brdmaker/stmbl/docs/README.md

# stmbl docs

The user manual (AsciiDoc) is in `src/`: getting started, wiring and
pinout, supply, motor and feedback setup, tuning, commands, servoterm.
`linuxcnc/` holds the LinuxCNC side: the example configuration (`config/`),
`sserialterm` and `stmblcan` ([linuxcnc/README.md](../linuxcnc/README.md)).

Smart-serial features (branches `sserial_console`, `sserial_bootloader`):

| doc | what |
|---|---|
| [sserial_console.md](sserial_console.md) | the drive's console over smart-serial: setup with `sserialterm`, the frame and link protocol, limits, troubleshooting |
| [capture_scope.md](capture_scope.md) | `scope0`: capture in the drive, download over any console; pins, triggers, modes, dump format |
| [sserial_bootloader.md](sserial_bootloader.md) | firmware updates: in-band over the console (`fwup`, `servoterm-cli --update`) and recovery with `setsserial flash`; flash layout, the single-bank stall |

Setup (branch `setup-wizard`):

| doc | what |
|---|---|
| [setup_wizard.md](setup_wizard.md) | `servoterm-cli --wizard`: sets up a drive and its motor step by step from the nameplate, measures the rest, wiring help, version check; the library for a GUI; tested on 35 simulated motors; FANUC serial absolute (multi-turn) included |

brdstepper (branch `brdstepper`):

| doc | what |
|---|---|
| brdstepper_hw.md | moved to `brdmaker/brdmot` (`docs/`), with the board designs (`hardware/`); the firmware target stays here (`brdstepper/`) |

CAN (branch `can-support`):

| doc | what |
|---|---|
| [can_support.md](can_support.md) | what CAN support would mean for stmbl and brdstepper: hardware, bus timing (`tools/canbus_budget.py`), LinuxCNC's side, protocol options, work plan |

Absolute encoders:

| doc | what |
|---|---|
| [absolute_encoders.md](absolute_encoders.md) | the position from boot with a multi-turn absolute encoder: `mturn` loads the encoder's turn count into `linrev`, checks it; states, config, LinuxCNC settings, tests; the GUI plan |

Supply:

| doc | what |
|---|---|
| [psu.md](psu.md) | moved to `brdmaker/brdmot` (`psu/`): the pack power supply for single-phase 230 V |

FANUC motors on hand:

| doc | what |
|---|---|
| [fanuci.md](fanuci.md) | `fanuci`: experimental probe for FANUC 1-pair (αi / βi) serial pulsecoders on FB0, how to find the protocol on the bench and turn it into a driver |
| [fanuc_tw.md](fanuc_tw.md) | `fanuc_tw`: the feedback driver for FANUC 2-wire pulsecoders (βiA128): wiring, the frame, pins, debugging the unknown bits |
| [yaskawa_abs.md](yaskawa_abs.md) | `yaskawa_abs`: the feedback driver for Yaskawa Σ-II serial absolute encoders (SGMAH-xxA1): wiring, the frame, pins, bench numbers |
| [fanuc/](fanuc/README.md) | moved to the private repository `brdmaker/brdmot`: the FANUC motors on hand, their encoders, the `encf` bench test, FANUC manuals as text |

Tools: `servoterm-cli/README.md`, `linuxcnc/sserialterm/README.md`.
Simulator and tests: `host/README.md` (`make -C host check`).
Findings and open issues: `DEBUGNOTES.md`.

Moved to the private repository `brdmaker/brdmot` (with their history):
the web GUI (`webui/`, millweb), the hardware designs (`hardware/`: stman,
vibsensor, brdstepper, teststand, kigen), the application LinuxCNC parts
(`linuxcnc/` arm6hmi, armcollide, armgrip, armguard, armkins, armtool, vis3d,
lathe, dynwiz, powerquota, pcomp), their simulated machine configs
(`hwtest/arcmate-sim`, `hwtest/portal-sim`) and docs (ctxtwin, hmi, hsm400u,
stman.md, vibsensor.md, brdstepper_hw.md). brdmot uses this repository as a
submodule (`stmbl/`). What stays here: the drive (firmware, its components,
the host simulator, servoterm-cli and the setup wizard, the LinuxCNC drive
link: stmblcan, sserialterm, stmbl_sim).
