brdmaker/stmbl/docs/fanuc/README.md

# FANUC motors (moved)

The notes on the FANUC servo motors on hand (βiS 12/2000, βiS 4/4000,
α2/3000), their αA64 / βiA128 encoders, the bench test plan for `encf`, and
the FANUC manuals transcribed to text are in the private repository
`brdmaker/brdmot`.
