brdmaker/stmbl/docs/psu.md

# stmbl pack power supply

Moved to the private repository `brdmaker/brdmot`, under `psu/`: the design
state (decided vs open), the power-path and relay-chain diagrams, and the
pwmdc SPICE runs.
