brdmaker/stmbl/hardware/stman/doc/stman-placement-bottom.png

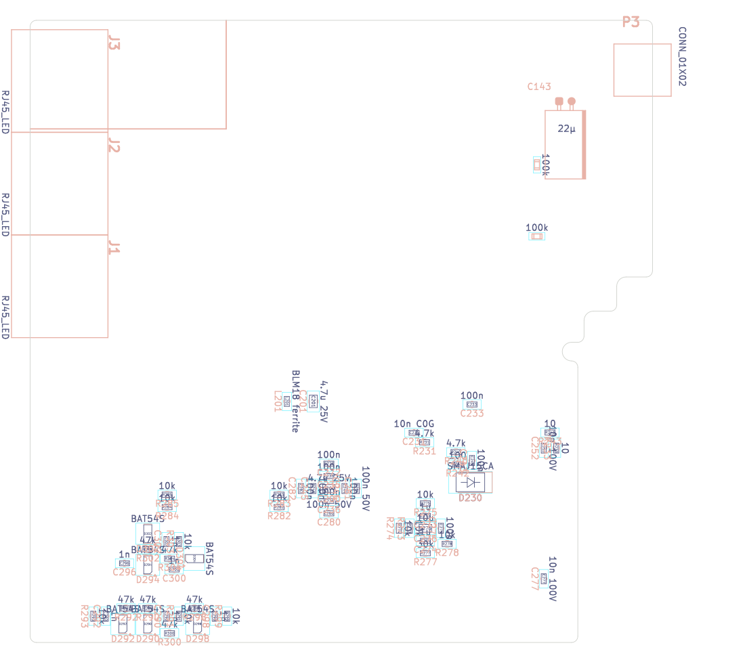
hardware/stman/doc/stman-placement-bottom.png
