brdmaker/stmbl/hardware/vibsensor/enclosure/render/bottom.png

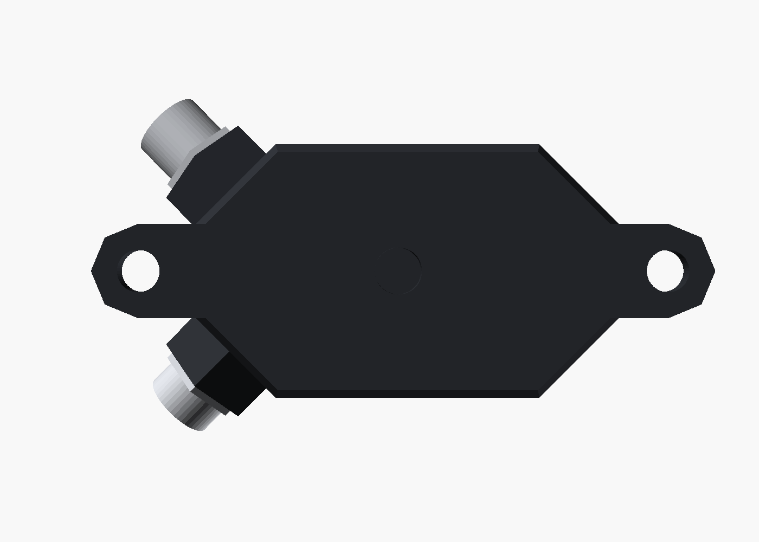
hardware/vibsensor/enclosure/render/bottom.png
