brdmaker/stmbl/hardware/vibsensor/enclosure/render/front.png

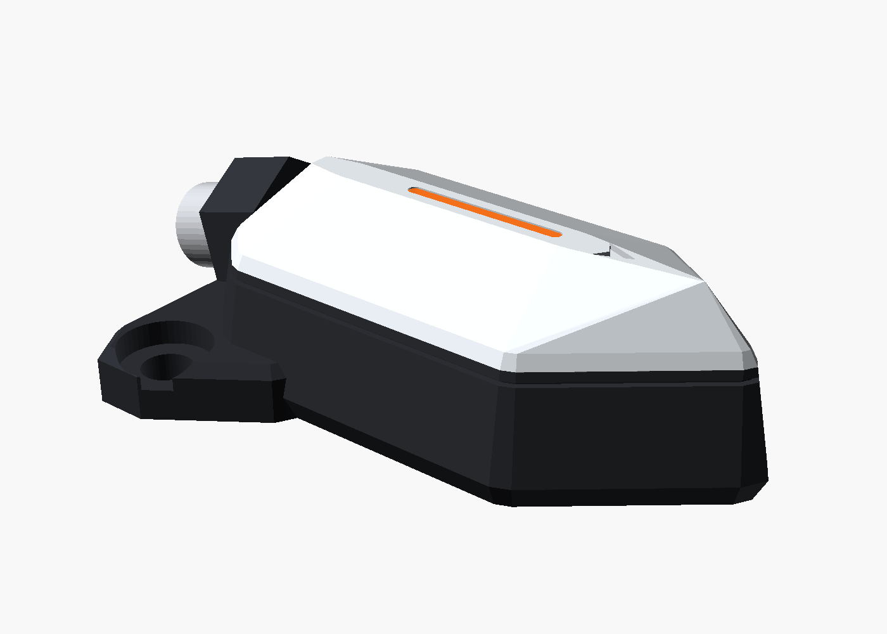
hardware/vibsensor/enclosure/render/front.png
