brdmaker/stmbl/hardware/vibsensor/enclosure/render/rear.png

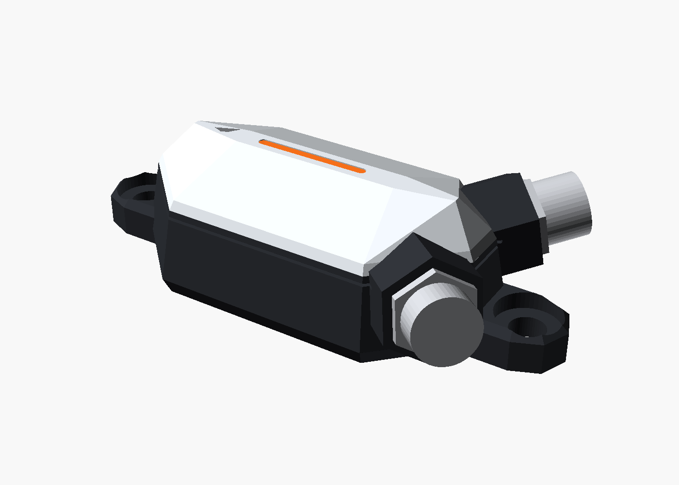
hardware/vibsensor/enclosure/render/rear.png
