brdmaker/stmbl/hardware/vibsensor/enclosure/render/terminated.png

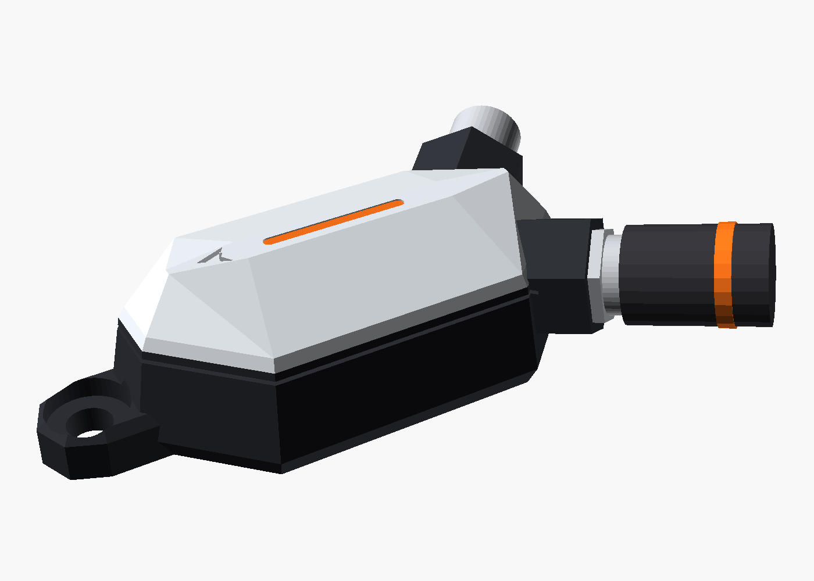
hardware/vibsensor/enclosure/render/terminated.png
