brdmaker/stmbl/hardware/vibsensor/enclosure/render/top.png

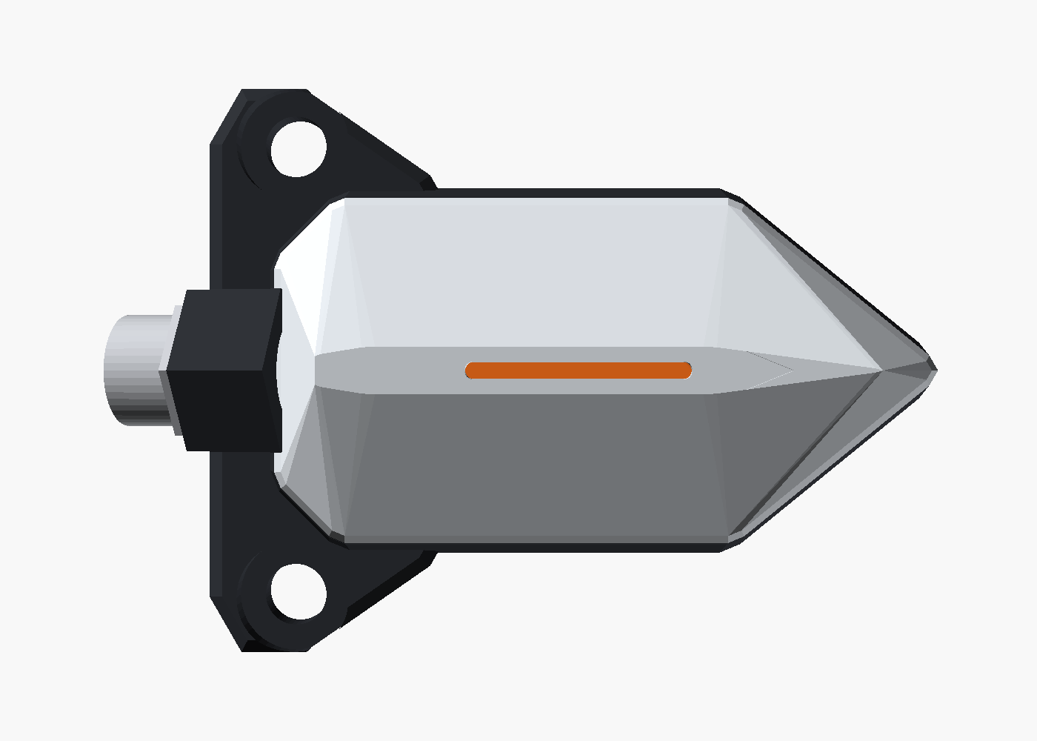
hardware/vibsensor/enclosure/render/top.png
