brdmaker/stmbl/linuxcnc/vis3d/shots/arm6_changer.png

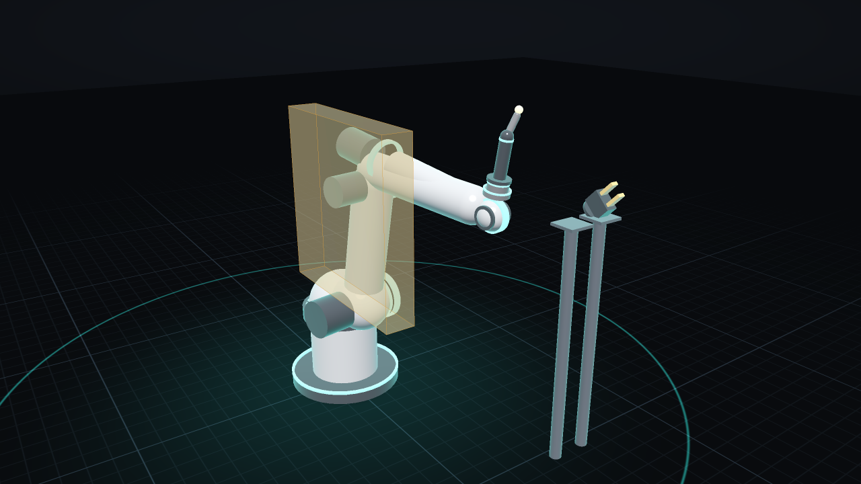
linuxcnc/vis3d/shots/arm6_changer.png
