brdmaker/stmbl/hardware/teststand/stl/pinion.stl

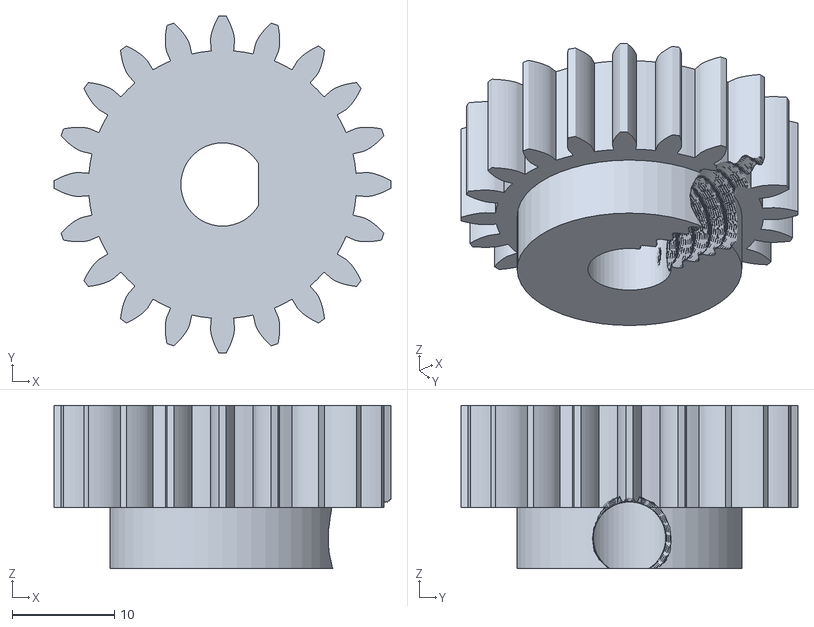
[picture p21: CAD file, 2026-11-06]
hardware/teststand/stl/pinion.stl
33.0 x 33.0 x 16.0
