brdmaker/stmbl/hardware/vibsensor/enclosure/stl/shard-cover.stl

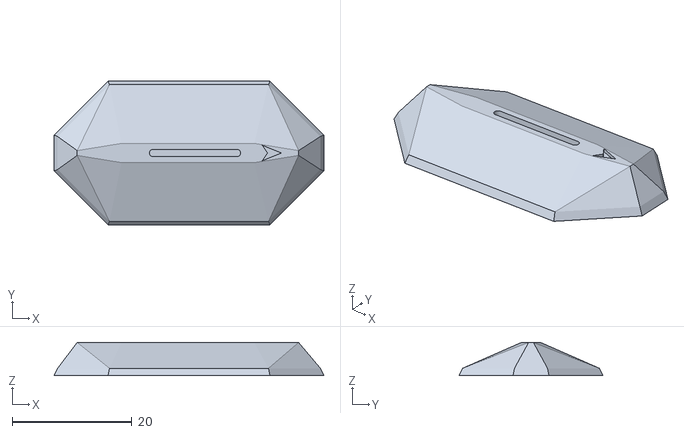
[picture p22: CAD file, 2026-10-26]
hardware/vibsensor/enclosure/stl/shard-cover.stl
45.0 x 24.0 x 5.51
