brdmaker/stmbl/hardware/teststand/stl/gib_z.stl

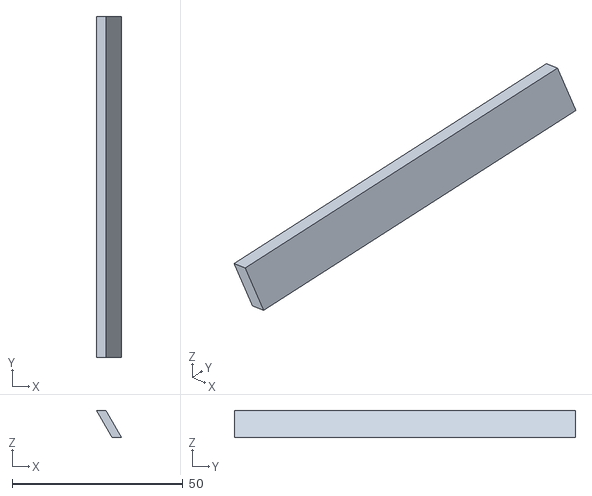
[picture p23: CAD file, 2026-11-06]
hardware/teststand/stl/gib_z.stl
7.42 x 100.0 x 8.00
