brdmaker/stmbl/hardware/vibsensor/enclosure/stl/shard-base.stl

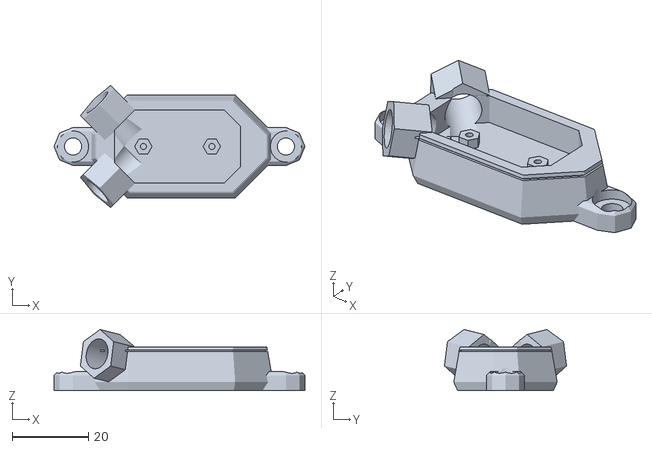
[picture p24: CAD file, 2026-10-26]
hardware/vibsensor/enclosure/stl/shard-base.stl
66.0 x 32.1 x 16.0
