brdmaker/stmbl/hardware/teststand/stl/paper_clip.stl

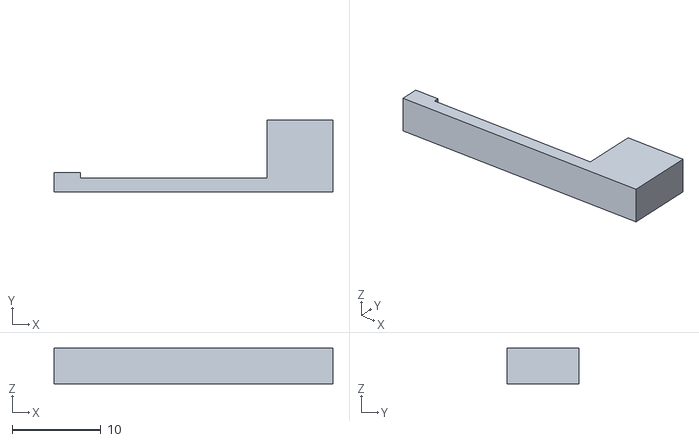
[picture p25: CAD file, 2026-11-06]
hardware/teststand/stl/paper_clip.stl
31.4 x 8.10 x 4.00
