brdmaker/stmbl/hardware/teststand/stl/z_slide.stl

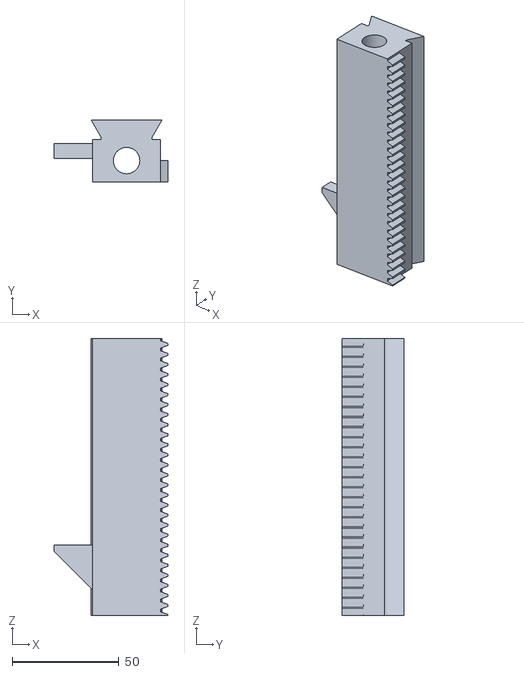
[picture p26: CAD file, 2026-11-06]
hardware/teststand/stl/z_slide.stl
53.4 x 29.0 x 130.0
