brdmaker/stmbl/hardware/teststand/stl/gib_y.stl

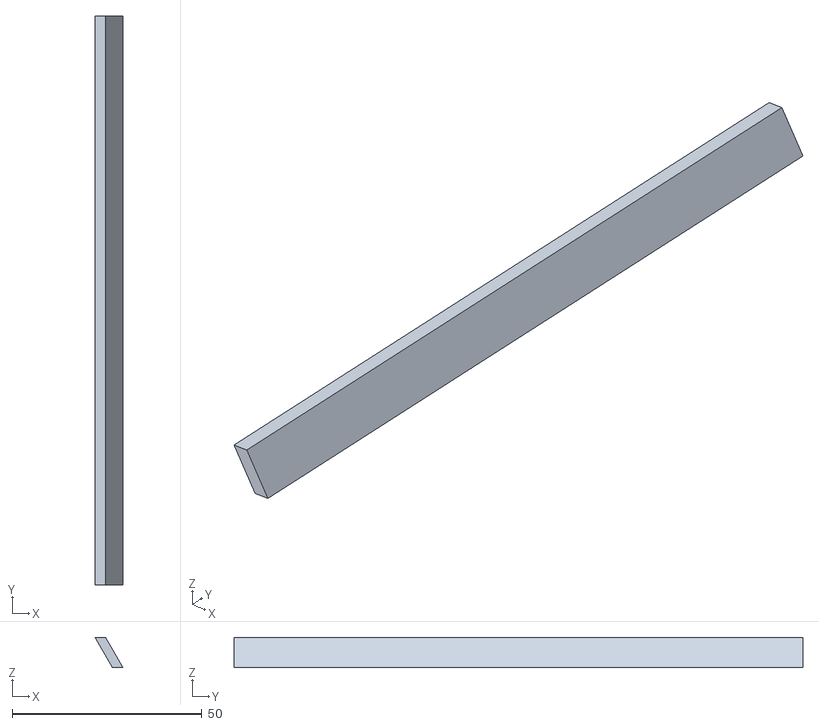
[picture p27: CAD file, 2026-11-06]
hardware/teststand/stl/gib_y.stl
7.42 x 150.0 x 8.00
