brdmaker/stmbl/hardware/teststand/stl/beam.stl

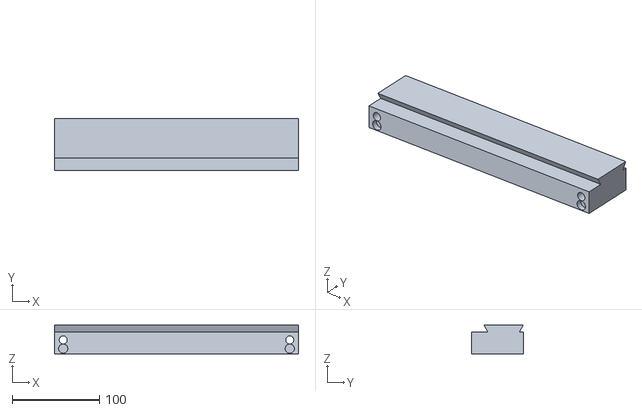
[picture p28: CAD file, 2026-11-06]
hardware/teststand/stl/beam.stl
280.0 x 60.0 x 33.0
