brdmaker/stmbl/hardware/teststand/stl/z_motor_bracket.stl

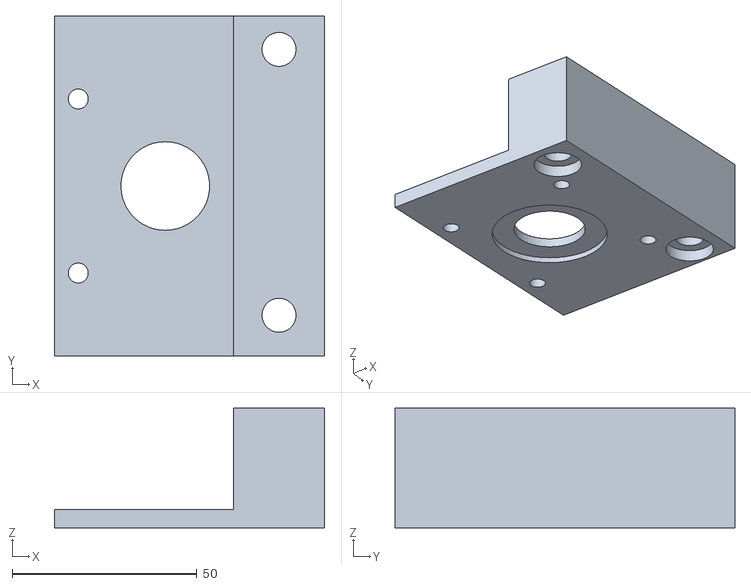
[picture p29: CAD file, 2026-11-06]
hardware/teststand/stl/z_motor_bracket.stl
73.1 x 92.0 x 32.5
