brdmaker/stmbl/hardware/teststand/stl/table.stl

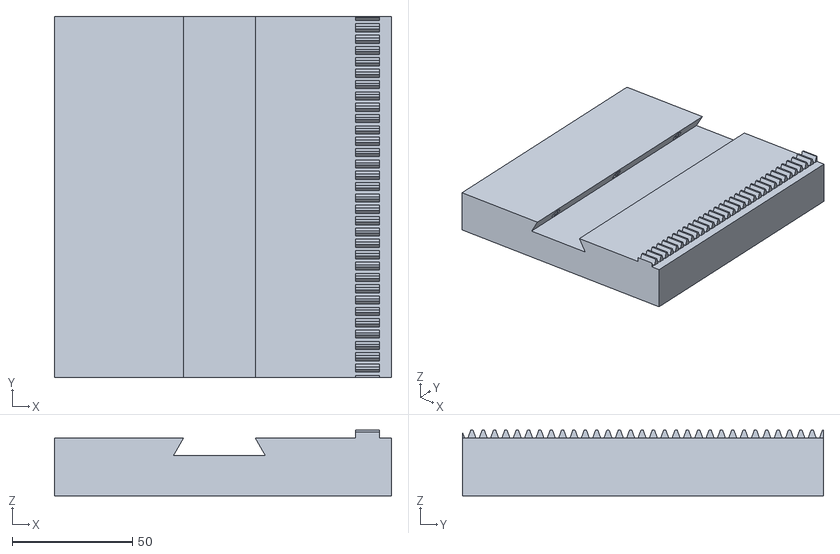
[picture p30: CAD file, 2026-11-06]
hardware/teststand/stl/table.stl
140.0 x 150.0 x 27.4
