brdmaker/stmbl/hardware/teststand/stl/switch_holder.stl

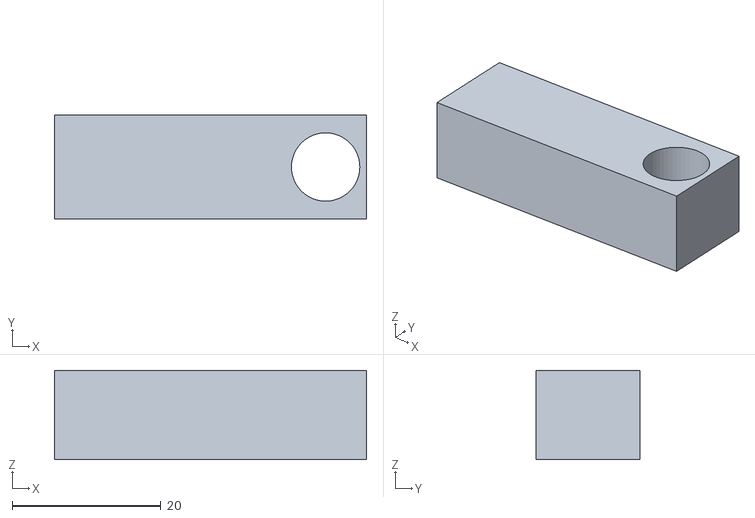
[picture p31: CAD file, 2026-11-06]
hardware/teststand/stl/switch_holder.stl
42.0 x 14.0 x 12.0
