brdmaker/stmbl/hardware/teststand/stl/snap_pin.stl

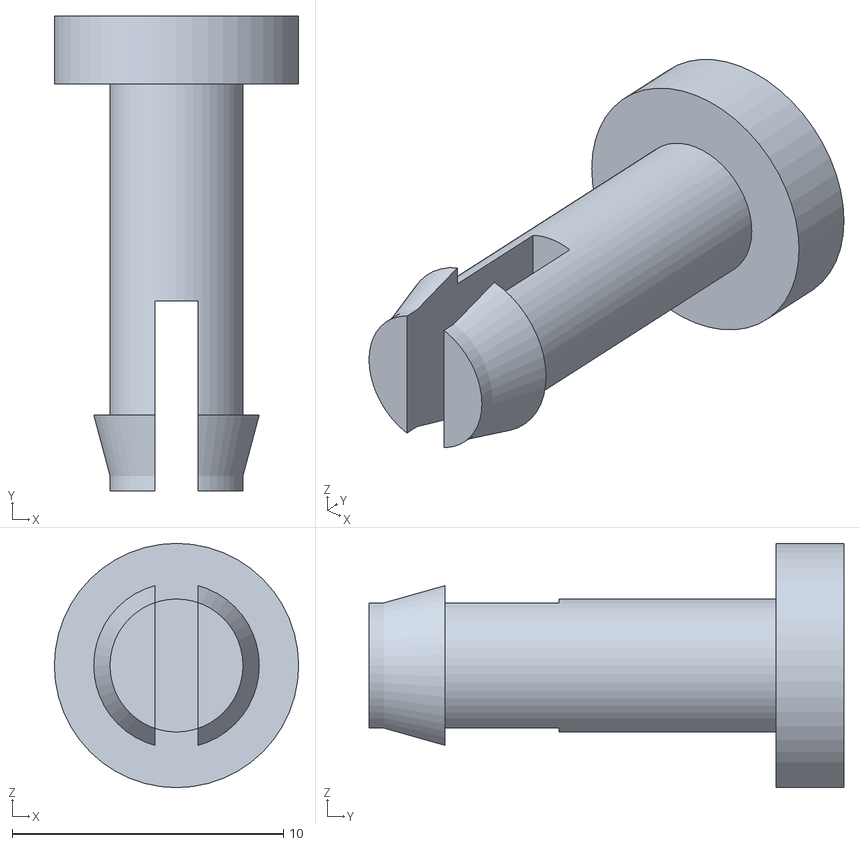
[picture p32: CAD file, 2026-11-06]
hardware/teststand/stl/snap_pin.stl
9.00 x 17.5 x 9.00
