brdmaker/stmbl/hardware/teststand/stl/x_motor_bracket.stl

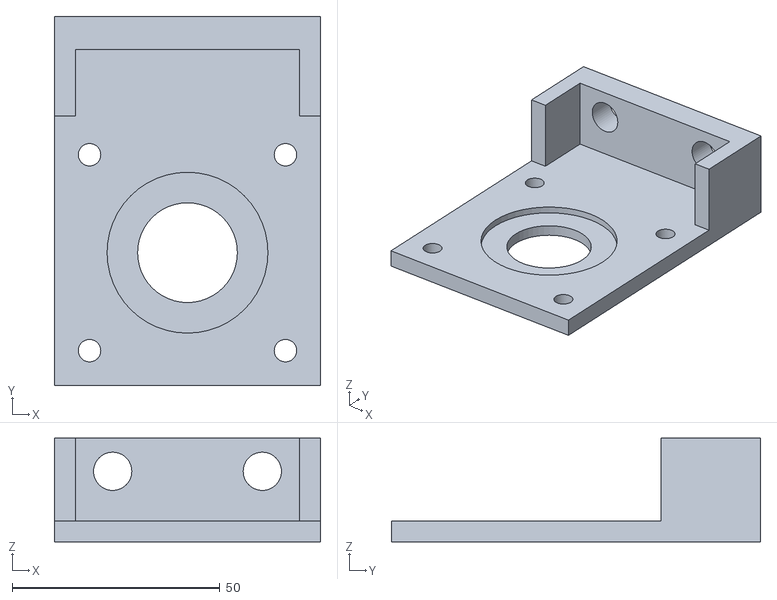
[picture p33: CAD file, 2026-11-06]
hardware/teststand/stl/x_motor_bracket.stl
64.0 x 88.9 x 25.0
