brdmaker/stmbl/hardware/teststand/stl/gib_x.stl

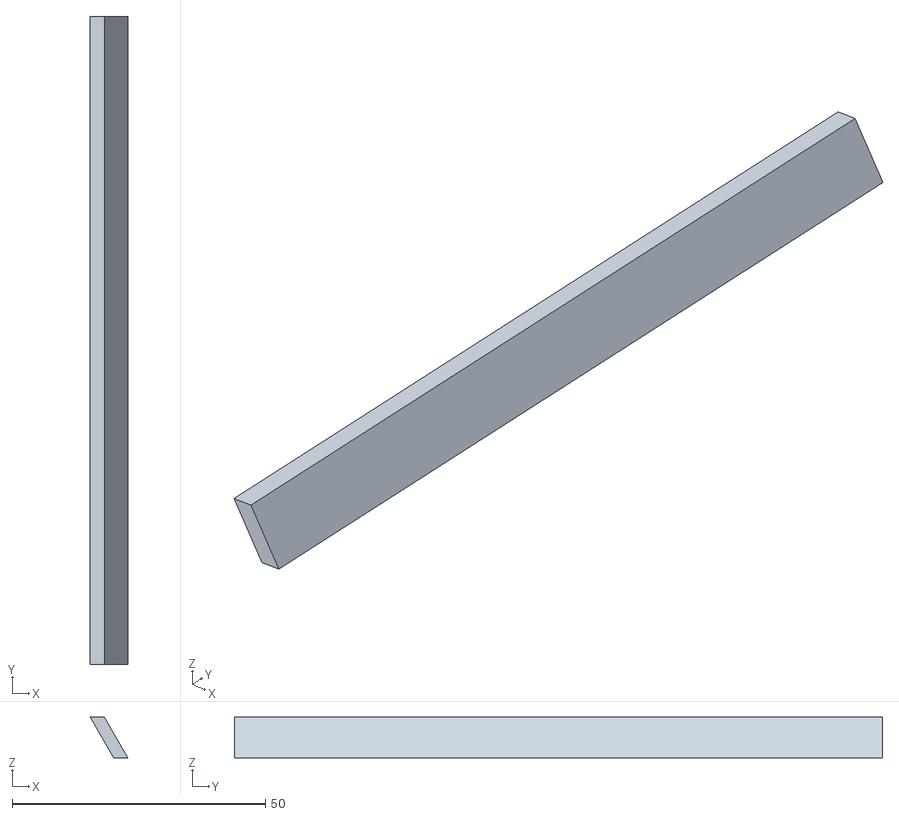
[picture p34: CAD file, 2026-11-06]
hardware/teststand/stl/gib_x.stl
7.42 x 128.0 x 8.00
