brdmaker/stmbl/hardware/teststand/stl/x_carriage.stl

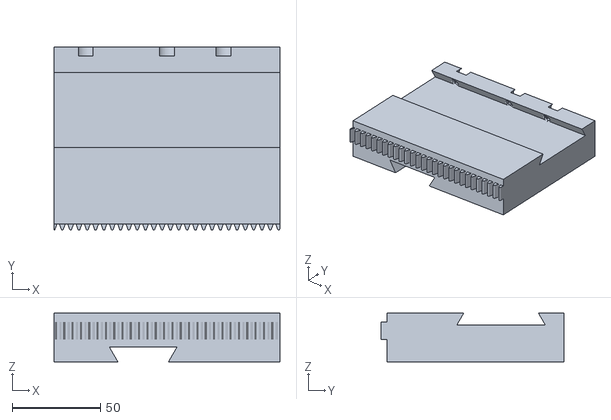
[picture p35: CAD file, 2026-11-06]
hardware/teststand/stl/x_carriage.stl
128.0 x 103.4 x 27.5
