brdmaker/stmbl/hardware/teststand/stl/base.stl

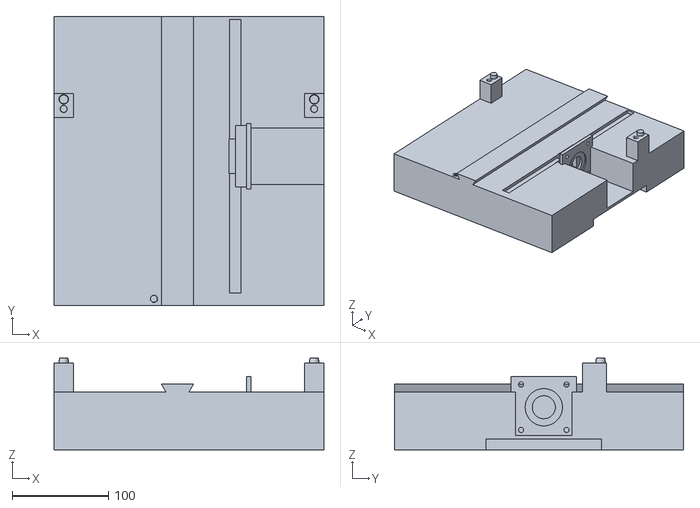
[picture p36: CAD file, 2026-11-06]
hardware/teststand/stl/base.stl
280.0 x 300.0 x 95.0
