brdmaker/stmbl/hardware/teststand/stl/set_screw.stl

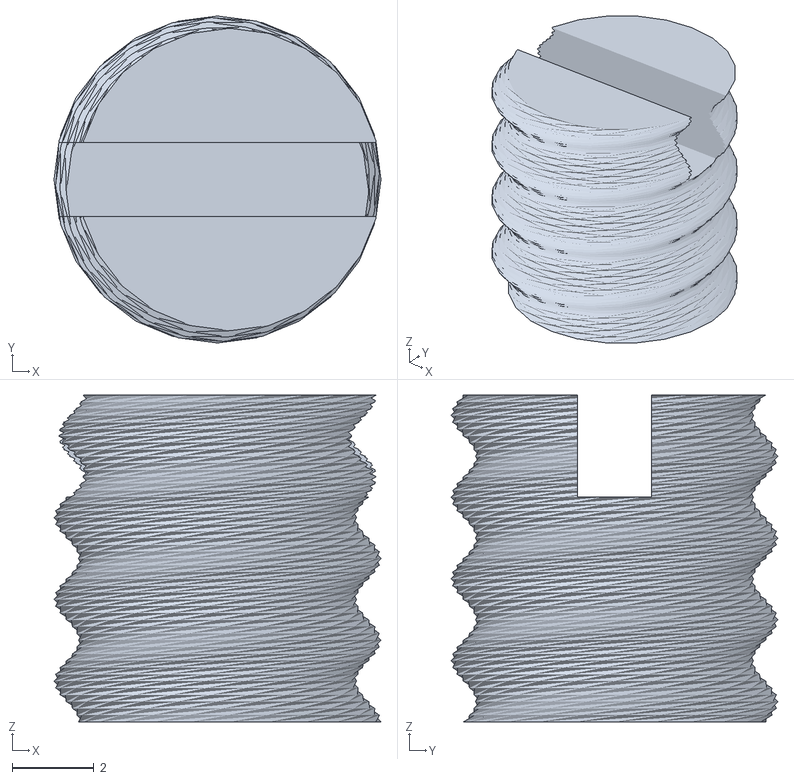
[picture p37: CAD file, 2026-11-06]
hardware/teststand/stl/set_screw.stl
8.00 x 8.00 x 8.00
