brdmaker/stmbl/hardware/teststand/stl/thumb_screw.stl

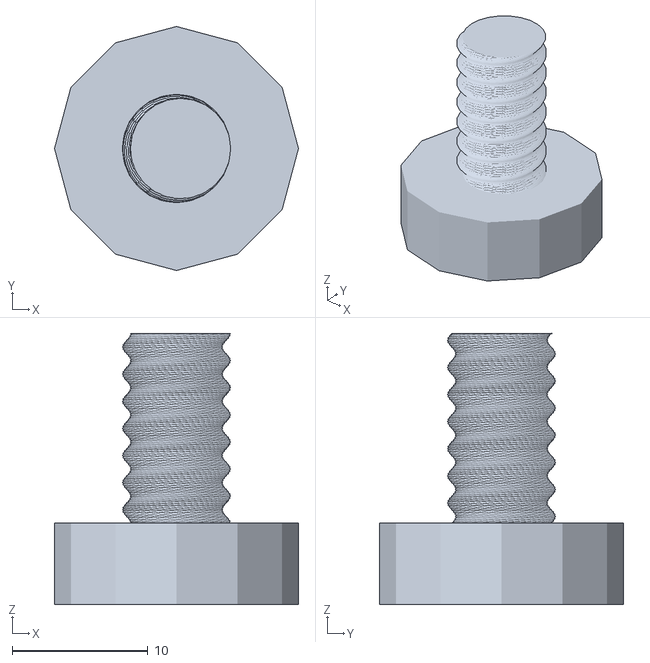
[picture p38: CAD file, 2026-11-06]
hardware/teststand/stl/thumb_screw.stl
18.0 x 18.0 x 20.0
