brdmaker/stmbl/(list of files, cad)

Other CAD files:
hardware/teststand/stl/bolt_25.stl
hardware/teststand/stl/bolt_45.stl
hardware/teststand/stl/gib_screw_14.stl
hardware/teststand/stl/gib_screw_25.stl
hardware/teststand/stl/gib_screw_50.stl
