brdmaker/stmbl/docs/ctxtwin/operating/05_operation.md

# Gildemeister CTX twin operating manual, 5. Operating the machine and the control (Bedienung von Maschine und Steuerung), pages 5-1 to 5-40

Source: `20a2fd3d-5_Bedienung_von_Maschine_und_Steuerung.pdf`, 40 pages (scanned), manual pages 5-1 to 5-40. "Betriebsanleitung CTX twin, Dok.-Nr.: daaab1d1, Februar 1995" (operating manual CTX twin, doc. no. daaab1d1, February 1995). Page 5-9 additionally carries the revision note "REV: dab9501 (05.05.1995) zu daaab1d1 Februar 1995".
Original language: German.

Running page header on every page: "5. Bedienung von Maschine und Steuerung". Footer: "Betriebsanleitung CTX twin", "Dok.-Nr.: daaab1d1 Februar 1995", "Seite 5-xx".

---

## Contents (page 5-1)

| Section | German title | English | Page |
|---|---|---|---|
| 5.1 | Allgemeine Hinweise | General notes | 5-4 |
| 5.1.1 | Aggregategruppen | Unit groups | 5-4 |
| 5.1.2 | Betriebsartensplitting | Operating mode splitting | 5-4 |
| 5.2 | Bedienelemente und Tastatur | Operating elements and keyboard | 5-5 |
| 5.2.1 | Bedienelemente an der rechten Seite | Operating elements on the right-hand side | 5-5 |
| 5.2.2 | Bedienfeld | Control panel | 5-6 |
| 5.2.3 | Weitere Bedienelemente | Further operating elements | 5-20 |
| 5.3 | Menütechnik und Softkeytasten | Menu technique and softkeys | 5-21 |
| 5.3.1 | Bildschirm | Screen | 5-22 |
| 5.3.2 | Allgemeines | General | 5-22 |
| 5.3.3 | Fenster - Aufteilung des Bildschirms | Windows - division of the screen | 5-24 |
| 5.3.4 | Anzeigenbereich | Display area | 5-26 |
| 5.4 | Befehlseingaben | Command entries | 5-28 |
| 5.4.1 | Pull-down-Menüs | Pull-down menus | 5-28 |
| 5.4.2 | Dialogboxen | Dialog boxes | 5-29 |
| 5.5 | INFO-System | INFO system | 5-32 |
| 5.5.1 | Allgemeines | General | 5-32 |
| 5.5.2 | Funktionen und Tastaturbelegung im INFO-System | Functions and key assignment in the INFO system | 5-33 |
| 5.5.3 | Fehler - INFO-System | Errors - INFO system | 5-33 |
| 5.6 | Grafische Bediener-Unterstützung | Graphical operator support | 5-34 |
| 5.7 | Ein- und Ausschalten der Maschine | Switching the machine on and off | 5-35 |
| 5.7.1 | Maschine einschalten | Switching the machine on | 5-35 |
| 5.7.2 | Referenzpunkt anfahren | Approaching the reference point | 5-36 |
| 5.7.3 | Fehleranzeigen und Meldungen quittieren | Acknowledging error displays and messages | 5-37 |
| 5.7.4 | Arbeitsraum-Positionsschalter freifahren | Moving off the work-area position switches | 5-38 |
| 5.7.5 | Maschine ausschalten | Switching the machine off | 5-39 |
| 5.7.6 | Not-Aus-Abschaltung | Emergency-stop shutdown | 5-39 |

Page 5-2: (blank page) (header and footer only).

## Introduction (page 5-3)

If you are not yet very familiar with the machine, this chapter is especially important for you.

The operation of the machine and the control is explained here. This includes:

- work that must be carried out before switching on
- switching the machine on and off
- acknowledging errors and messages (How do I delete the error message from the screen?)
- the control panel and the keyboard (Which key do I find where?)
- the menu technique (How can I select programs and commands?)
- the softkeys (The number keys have different meanings depending on the choices on the screen.)
- the graphical operator support (How can I look at the contour I have entered?)

## 5.1 General notes (Allgemeine Hinweise) (page 5-4)

### 5.1.1 Unit groups (Aggregategruppen)

In accordance with the machine concept, the control contains 2 unit groups (`Aggregategruppen`), called **AG** below.

- each AG is autonomous on the operating and programming interface
- an AG can contain several spindles and also several slides
- each AG handles its own work area
- in one AG only one operating mode exists at a time
- different operating modes can exist at the same time in the two AGs, i.e. operating mode splitting (`Betriebsarten-Splitting`)
- when operating mode splitting is used fully, separation of the work areas by a partition wall (`Trennwand`) is required for safety reasons.

### 5.1.2 Operating mode splitting (Betriebsartensplitting)

Operating mode splitting can be switched on and off by a parameter switch:

- in the mode operating mode splitting ON (`EIN`) the effect of the keys cycle start / stop (`Zyklus-Start / -Stop`) and feed stop (`Vorschub-Stop`) depends on the position of the selector switch **AG**.
- in the mode operating mode splitting OFF (`AUS`) the keys cycle start / stop and feed stop act on both **AG** simultaneously.

## 5.2 Operating elements and keyboard (Bedienelemente und Tastatur) (page 5-5)

This section explains in short form where the individual operating elements on the machine are and what function they have (see figures on the following page).

### 5.2.1 Operating elements on the right-hand side (Bedienelemente an der rechten Seite)

Figure: right-hand end of the machine / electrical cabinet, with callouts 1-5: (5) sight glass at the top of the cabinet, (4) round gauge on the left part, (1) small counter, (2) round main switch and (3) motor protection switch on the cabinet door; ventilation grille and a sight glass lower left.

1. **`Betriebsstundenzähler`** (operating hours counter): shows how many hours in total the machine has been in operation (important for regular maintenance work).
2. **`Hauptschalter`** (main switch): switches the machine on and off.
3. **`Motor-Schutzschalter für Späneförderer`** (motor protection switch for the chip conveyor): this switch trips automatically when the chip conveyor is overloaded, e.g. by a chip jam. The cause of tripping must then be removed and the switch switched on again.
4. **`Manometer`** (pressure gauge): shows the system pressure of the hydraulic system.
5. **`Füllstand Kühlmittel`** (coolant level): this sight glass shows the fill level of the coolant tank for the spindle motors.

### 5.2.2 Control panel (Bedienfeld) (pages 5-6 to 5-19)

Figure (page 5-6, drawing no. 1008472.4 [uncertain]): Grundig control panel ("GRUNDIG" logo) in three parts: monitor housing with screen (1) and two key switches (2), (3) to its right; a middle key strip with emergency-stop button (10) at left, keys (4), (5), (6), (22), the protective-hood keys (9a)-(9d) and a single key (21) at the right; the lower keyboard with handwheel (8) (scale marked "- ←|→ +"), selector key switch (11), PLC key block (12), enabling key (7), cycle keys (13), jog direction keys (14), spindle block (15), keys (16), (17), (18), cursor block (19), number pad (20), and two mushroom pushbuttons (9e) on the left and right side faces of the keyboard.

Callouts: (1) monitor, (2) key switch bar machining, (3) key switch setup mode, (4) fault lamp, (5) machine (drives) on, (6) machine (drives) off, (7) enabling (`Zustimmen`), (8) handwheel, (9a)-(9d) protective hood keys, (9e) mushroom pushbuttons, (10) emergency stop, (11) selector switch AG, (12) PLC keys, (13) cycle stop/feed stop/cycle start, (14) jog direction keys, (15) spindle key block, (16) [not described separately in text; key group near (15)/(17), see (15a)/(15b)] [uncertain], (17) operating modes/error status/info, (18) Esc/>>/Del/Alt/Ins, (19) cursor keys, (20) number pad, (21) turret jog / option keys, (22) option keys [uncertain]. Note: the figure labels (22) twice in the middle strip.

**(1) `Monitor`** (page 5-7)

**(3) `Schlüsselschalter - Stangenbearbeitung`** (key switch - bar machining) [printed as "(3)"; per the figure this is probably key switch (2)] [uncertain]

| Symbol | Meaning |
|---|---|
| `O` | The machine works independently of the automatic bar guide / bar feed (`Stangenführung / Stangenvorschub`). |
| `I` | The machine works with the automatic bar guide / bar feed. |

**(3) `Schlüsselschalter - Einrichtebetrieb`** (key switch - setup mode)

Position **AG 1** or **AG 2** (symbol: filled dot on a base line): these switch positions are prerequisites for the functions in setup mode. Depending on operating mode splitting, they are effective for the selected unit **AG 1 or AG 2** respectively, and **only** with the protective hood (`Schutzhaube`) open.

The key operation must take place in the following sequence:

- operating mode `MASCHINE / HANDSTEUERN` (machine / manual control)
- open the protective hood
- key switch to position "`Einrichtebetrieb`" (setup mode)

Position (symbol: spiral/automatic symbol): this position is a prerequisite for:

- `MASCHINE / AUTOMATIK` (machine / automatic)
- and `MASCHINE / HANDSTEUERN` with the protective hood closed

**(4) `Störlampe`** (fault lamp): this red fault lamp signals:

- steady light for an error (`Fehler`)
- flashing light for a warning (`Warnung`)

**(5) `Maschine (Antriebe) Ein`** (machine (drives) on) (page 5-8): with this illuminated key you switch the drives on. The lamp in the key signals that the machine is switched on. Symbol: motor with `I`.

**(6) `Maschine (Antriebe) Aus`** (machine (drives) off): with this key you switch the drives off with the protective hood open. Symbol: motor with `0`.

**(7) `Zustimmen`** (enabling / consent key; symbol: circle with dot): starting hazardous movements in manual mode is only possible when the enabling key (`Zustimmtaste`) is pressed with one hand and the function key with the other hand. When one of the keys is released, the movement is stopped. With the protective hood open you can operate the following components:

- spindle rotation (15) up to max. 50 rpm (`Upm`)
- slide feed in the selected axis (14) at max. 1 m/min
- swivel (index) the tool carrier (21)
- move the chip conveyor in the selected direction (22)

Further optional functions are possible, see the description of the keys.

**The keys must be operated in the following way:**

- **1. press the enabling key and hold it**
- **2. press the desired function key**

The enabling key only functions when the machine is in setup mode in operating mode `MASCHINE/HANDSTEUERN`, the protective hood is open and the key switch is in the following position: (setup-mode symbol, filled dot on a base line).

**(8) `Handrad`** (handwheel): depending on the selected menu, the handwheel can be used for several functions:

- feed override / speed override (`Vorschubüberlagerung / Drehzahlüberlagerung` = Override),
- moving the axes in 0.1 / 0.01 or 0.001 mm steps,
- setting tool offsets (`Werkzeug-Korrekturen`).

**(9 a,c) `Schutzhaube(n) entriegeln (öffnen)`** (unlock (open) protective hood(s)) (page 5-9; symbol: two keys with arrows pointing apart)

Pressing this key / these keys unlocks the protective hood(s). Left key for work area 1, right key for work area 2.
In non-split operation it is sufficient to press one of the two keys to unlock both protective hoods.
The blue lamp(s) in the key(s) signal(s) that unlocking of the protective hood(s) is enabled, provided that all movements are stopped.

If you have the **option automatic protective hood** (`Option Automatische Schutzhaube`), the protective hood(s) open automatically when this key / these keys are pressed, unless the function was programmed with cycle end.

If you have the **option handling** (`Option Handhabung`), the respective protective hood can only be opened when the loading hatch (`Ladeluke`) of the other unit group is also closed or all movements there have been stopped. (Marked with "!" in the margin.)

Note: If you ever have to unlock the protective hood by hand (only possible with the machine switched off!), use the manual hood release, see 5.2.3, "Further operating elements" on page 5-20.

**(9 b,d) `Schutzhaube(n) schließen`** (close protective hood(s)) (symbol: two keys with arrows pointing together)

The green lamp(s) in the key(s) signal(s) that the protective hood(s) is (are) properly closed and locked.

If you have the **option automatic protective hood**, use these keys to preselect the work area to be closed. The left key closes work area 1. The right key closes work area 2.

By pressing the two mushroom pushbuttons (`Pilztaster`) (9 e) mounted on the sides of the control panel you close the desired protective hood(s) and automatically start the cycle, if this is preset by a parameter.

It is important that the mushroom pushbuttons are pressed simultaneously and held until the door(s) is (are) closed.

**(10) `Not-Aus-Taste`** (emergency-stop button) (page 5-10): with the emergency-stop button you stop the machine immediately from any operating state in case of danger.

**(11) `Wahlschalter`** (selector switch): with this selector switch **unit 1 and/or 2** (`Aggregat 1 und/oder 2`) is selected. The effectiveness of the keys depends on the parameter value "`Betriebsartensplitting`", see also 9-5:

- operating mode splitting ON
  - the key commands act only on the selected unit group
  - indicator lamps are driven per unit
- operating mode splitting OFF
  - the key commands act on both unit groups simultaneously
  - indicator lamps are driven for all units

**(12) `SPS-Tasten`** (PLC keys)

| Key (German) | English | Function |
|---|---|---|
| `Spänetransport Ein` | chip transport on | switches the chip transport on (symbol: conveyor with `I`) |
| `Spänetransport Aus` | chip transport off | switches the chip transport off (symbol: conveyor with `O`) |
| `Kühlschmiermittelpumpe Ein` | coolant pump on | switches the coolant (cooling lubricant) pump on; effectiveness depends on the position of selector switch (11) (symbol: tap with `I`) |
| `Kühlschmiermittelpumpe Aus` | coolant pump off | switches the coolant pump off; effectiveness depends on the position of selector switch (11) (symbol: tap with `O`) |
| `Funktion 1` (`F1`) | function 1 | freely assignable (`Frei belegbar`) (page 5-11) |
| `Funktion 2` (`F2`) | function 2 | freely assignable |

Page 5-11 contains only F1 and F2; the rest of the page is empty.

Note (page 5-12): The effectiveness of the key functions described below, up to and including turret jog (`Revolver tippen`) (21), depends on the set parameter "`Betriebsartensplitting`" and on the position of selector switch (11), i.e. they are assigned to unit 1 or 2 whenever a choice makes sense, see also 5.1.2, "Operating mode splitting" on page 5-4.

**(13a) `Zyklus Stop`** (cycle stop): for stopping in the operating modes

- `MASCHINE / AUTOMATIK` and
- `MASCHINE / HANDSTEUERN`

Feed and spindle movements are stopped in this order.

**(13b) `Vorschub Stop`** (feed stop): for stopping in the operating modes `MASCHINE / AUTOMATIK` and `MASCHINE / HANDSTEUERN`.
The work spindle keeps running.
Feed movements are stopped immediately except during thread cutting; M, S and T functions already started are processed to the end.
A program interrupted in this way can be continued with "`Zyklus Start`" (13c).

**(13c) `Zyklus Start`** (cycle start): for starting in the operating modes `MASCHINE / AUTOMATIK` and `MASCHINE / HANDSTEUERN`.
Prerequisite is a closed protective hood; with the **option automatic protective hood** closing and locking is initiated.

**(14) `Handrichtungstasten`** (manual direction keys) (page 5-13): these keys select the axes for manually controlled feed movements. Layout: up arrow, left arrow, rapid key (zig-zag symbol) in the centre, right arrow, down arrow, plus two blank keys.

| Key | Function |
|---|---|
| arrow up | move the slide in direction X+ |
| arrow down | move the slide in direction X- |
| arrow right | move the slide in direction Z+ |
| arrow left | move the slide in direction Z- |
| `Eilgang` (rapid traverse, zig-zag symbol) | moves the slide in rapid traverse with the protective hood closed. For the slides to move at the maximum speed set in the parameter, the key must be pressed simultaneously with one or two manual direction keys. |

**(15) `Tastenblock Spindeln`** (spindle key block): spindle CCW arrow, `O` (stop), spindle CW arrow; below these two "spindle jog" keys.

- Spindle start (arrow to the left): starts the spindle rotation in the arrow direction (per DIN = viewed from the drive side) at a speed set in the parameter. The symbol on the key shows the direction of rotation from the operator's point of view. Effective in operating mode
  - `MASCHINE/AUTOMATIK` - with the protective hood closed
  - `MASCHINE/HANDSTEUERN` - with the protective hood open in setup mode with enabling key and at max. 50 rpm
- `Spindel Stop` (spindle stop) (page 5-14): stops the spindle.
- Spindle start (arrow to the right): starts the spindle rotation in the arrow direction (per DIN = viewed from the drive side) at a speed set as a parameter. The symbol on the key shows the direction of rotation from the operator's point of view. Effective in operating mode
  - `MASCHINE/AUTOMATIK` - with the protective hood closed
  - `MASCHINE/HANDSTEUERN` - with the protective hood open in setup mode with enabling key and at max. 50 rpm
- `Spindel Tippen` (spindle jog), two keys ("bzw." = or): for selecting the spindle direction of rotation. As long as you hold these keys pressed, the spindle turns at max. 50 rpm.
  - Prerequisite: the protective hood is open, and the enabling key is pressed.

**(15a) `Schlitten Umschalten`** (switch slides): for changing between the slides on multi-slide machines.

**(15b) `Spindel Umschalten`** (switch spindles): for changing between the spindles on multi-spindle machines.

**(17a) `Betriebsarten`** (operating modes): directly selects the operating-mode menu from any menu level.

**(17b) `Fehlerstatus`** (error status): calls up the error messages, see 5.7.3, "Acknowledging error displays and messages" on page 5-37.

**(17c) `Info`** (`i` key): calls up the online help, see 5.5, "INFO system" on page 5-32.

**(18a) `Zurück`** (back) (page 5-15), key `Esc`: closes a window in the menu level.

**(18b) `Weiter`** (next), key `>>`: switches on to a follow-on menu. (An existing follow-on menu on the same level is indicated on screen by `>>`; the end of the menu level by `<<`.)

**(18c) `Löschen`** (delete), key `Del`: deletes entries that are not yet stored and error messages in the error line.

**(18d) `Ändern`** (change), key `Alt`. (No further description.)

**(18e) `Einfügen`** (insert), key `Ins`. (No further description.)

**(19) `Cursor`**: these keys control the cursor movements. Keys: page-up (arrow in box, up), `▲`, page-down (arrow in box, down), `◄`, `▼`, `►`.

**(20) `Zehnertastatur`** (numeric keypad): for entering digits. Softkey functions are selected with the keys 1 to 9 depending on the screen display, see 5.3, "Menu technique and softkeys" on page 5-21. Keys: `7 8 9 / 4 5 6 / 1 2 3 / - 0 .` and a wide blank key below.

**`Bestätigen`** (confirm; wide black key): for entering / confirming commands.

**(21) `Werkzeugträger Tippen`** (tool carrier jog) (page 5-16): with this key you can swivel (index) the tool carrier at reduced speed with the protective hood open.
**The procedure must take place in the following sequence:**

- select setup mode (key switch symbol: filled dot on a base line)
- press and hold the `ZUSTIMMTASTE` (enabling key)
- enter and confirm the new T value
- immediately afterwards press and hold the key "`WERKZEUGTRÄGER TIPPEN`"

The tool carrier swivels into the new position and locks. The two keys can be released.

**(21) `Optionen`** (options): with the following keys you operate options that are not included in the standard version of this lathe. The position of the keys within the key field can vary depending on the machine equipment.

- **`Späneförderer zurück`** (chip conveyor reverse): as long as you hold this key pressed, the conveyor belt of the chip conveyor runs backwards. This is used to free the conveyor belt in case of a chip jam.
  - Prerequisite: the protective hood is open; setup mode is selected; the enabling key is pressed.
- **`Späneförderer vor`** (chip conveyor forward): as long as you hold this key pressed, the conveyor belt of the chip conveyor runs forward.
  - Prerequisite: the protective hood is open; setup mode is selected; the enabling key is pressed.
  - (With the hood closed you can switch the chip conveyor on only with M commands.)
- **`Automatische Schutzhaube`** (automatic protective hood): see protective hood (9 a, b, c, d).
- **`Stangenvorschub Tippen`** (bar feed jog) (page 5-17): as long as you hold this key pressed, the bar is fed automatically.
  - Prerequisite: the protective hood is closed.
- **`Ölnebelabscheider EIN /AUS`** (oil mist separator ON/OFF; two keys, fan symbol with `I` / `O`): with this key you switch the oil mist separator on or off.
- **`Anzeige des zweiten Druckes`** (display of the second pressure; lamp marked `P 2`): this lamp indicates that the second clamping pressure is selected. Switching on and off is done with the M functions M 35 (on) and M 34 (off).
- **`Schnittstellenanwahl`** (interface selection; symbols `I` and `II`): pressing this key changes between interface I and II.
- **`Kühlwasserreinigungsanlage`** (coolant cleaning system): with this key you select or deselect the coolant cleaning system.
- **`Überlastkupplung`** (overload clutch): this indicator signals that the overload clutches of the linear axes X or Z have responded.
- **`Doppelspannzylinder (Zyl. I) zurück`** (double clamping cylinder (cyl. I) back; key marked `Zyl. I`): as long as you hold this key pressed, double clamping cylinder I moves back.
- **`Doppelspannzylinder (Zyl. I) vor`** (double clamping cylinder (cyl. I) forward): as long as you hold this key pressed, double clamping cylinder I moves forward.
- **`Doppelspannzylinder (Zyl. II) zurück`** (double clamping cylinder (cyl. II) back; key `Zyl. II`): as long as you hold this key pressed, double clamping cylinder II moves back.
- **`Doppelspannzylinder (Zyl. II) vor`** (double clamping cylinder (cyl. II) forward) (page 5-18): as long as you hold this key pressed, double clamping cylinder II moves forward.
- **`Fertigteiltransportband EIN`** (finished-part conveyor belt ON): switches the finished-part conveyor belt on.
- **`Fertigteiltransportband AUS`** (finished-part conveyor belt OFF): switches the finished-part conveyor belt off.
- **`Schwenkarm Abholeinrichtung einschwenken`** (swing in the swivel arm of the unloading device): as long as you hold this key pressed, the swivel arm of the unloading (pick-off) device moves forward.
  - Prerequisite: the protective hood is open; setup mode is selected; the enabling key is pressed.
- **`Schwenkarm Abholeinrichtung ausschwenken`** (swing out the swivel arm of the unloading device): as long as you hold this key pressed, the swivel arm of the unloading device moves back.
  - Prerequisite: the protective hood is open; setup mode is selected; the enabling key is pressed.
- **`Abholeinrichtung - Werkstückgreifer zu`** (unloading device - workpiece gripper closed): as long as you hold this key pressed, the workpiece gripper grips (closes).
  - Prerequisite: the protective hood is open; setup mode is selected; the enabling key is pressed.
- **`Abholeinrichtung - Werkstückgreifer auf`** (unloading device - workpiece gripper open): as long as you hold this key pressed, the workpiece gripper opens.
  - Prerequisite: the protective hood is open; setup mode is selected; the enabling key is pressed.
- **`Abholeinrichtung - Werkstückauffang schließen`** (unloading device - close workpiece catcher) (page 5-19): as long as you hold this key pressed, the cover hood of the workpiece catcher closes automatically.
  - Prerequisite: the protective hood is open; setup mode is selected; the enabling key is pressed.
- **`Abholeinrichtung - Werkstückauffang öffnen`** (unloading device - open workpiece catcher): as long as you hold this key pressed, the cover hood of the workpiece catcher opens automatically.
  - Prerequisite: the protective hood is open; setup mode is selected; the enabling key is pressed.

The rest of page 5-19 is empty.

### 5.2.3 Further operating elements (Weitere Bedienelemente) (page 5-20)

**(1) `Manuelle Schutzhaubenentriegelung`** (manual protective hood release): through this opening you can unlock the protective hood by hand with a screwdriver or similar when the machine has no power supply.

**(2) `Schnittstelle für Datenübertragung`** (interface for data transfer): external data carriers, e.g. a personal computer or printer, can be connected to this serial interface. For operating an external data memory, a socket outlet with 230 V / 150 W / 1 A is additionally fitted.

**(3) `Fußtaster für Spannfutterbetätigung`** (foot switches for chuck actuation): used for clamping (right pedal) and unclamping (left pedal) the chuck. The left foot switch is assigned to AG 1, the right one to AG 2.
The right pedal is always "`Futter spannen`" (clamp chuck), the left pedal always "`Futter lösen`" (release chuck), regardless of whether the clamping mode is external or internal clamping.

[Note: the figure shows two foot switches (3), one in front of each work area; each apparently has two pedals, right = clamp, left = release.]

**(4) `Spanndruckeinstellung`** (clamping pressure setting): the clamping pressure is set via a handwheel. The pressure-reducing valve is activated by means of a key. The left handwheel is assigned to the clamping device of AG 1, the right one to AG 2.

Figure: overall view of the machine with detail circles: (1) hole for the manual hood release at the top of the hood; (2) interface sockets and 230 V socket outlet on the control cabinet; (3) two foot switches in front of the machine base; (4) clamping-pressure handwheels at the left end and at the right of the panel area. Chip conveyor at the right end.

## 5.3 Menu technique and softkeys (Menütechnik und Softkeytasten) (page 5-21)

You are guided by the control during operation. The screen shows you menus from which you can select.

To select you use the softkeys.
The word softkey is a combination of software and key (program and key). The keys are so called because they do not have a fixed, hard function.

Their function depends on the menu on the screen.

On the Gildemeister **Eltropilot** control the number keys 1 to 9 serve as softkeys.

You enter the digit of the number keypad that stands at the desired menu position.

For example, you select the operating mode `MASCHINE` by pressing number key 7.

Where you have to press a softkey, this operating manual uses the expression ***wählen*** (select); such keys or functions are marked by capital letters, e.g.

`Betriebsart MASCHINE wählen` (select operating mode MACHINE)

or

`Menüpunkt REFERENZ AUTOMATISCH wählen` (select menu item REFERENCE AUTOMATIC).

### 5.3.1 Screen (Bildschirm) (page 5-22)

(Heading only; content follows in 5.3.2.)

### 5.3.2 General (Allgemeines)

After the control has been switched on, the initialization screen shows when the control is ready for operation. After pressing the operating mode key you reach the level of the individual operating modes and the operating processes you can work with:

Figure (screenshot, dated "23.Sep.93 8:02:02" [uncertain]): menu bar with the softkeys `Maschine`, `DINplus`, `Parameter`, `Simulation`, `Service`, `TURNplus`; empty work area; at the bottom the display area with X `-0.000`, Z `-0.000`, C, T `0`, slide `1`, spindle `H`, feed `0.0mm/min`, speed `0 U/min`, override bars `49%` [uncertain] / `100%`, and load bars X, Z and spindle at `0%`.

You can choose from the following operating modes:

- `MASCHINE` (machine) with the sub-operating modes `HANDSTEUERN` (manual control) and `AUTOMATIK` (automatic)
- `DINPLUS`
- `PARAMETER`
- `SIMULATION`
- `SERVICE`
- `TURNPLUS`

If you select the operating mode `MASCHINE` immediately after switching on the machine, the control is automatically in the operating mode `HANDSTEUERN`.
If you select the operating mode `MASCHINE` during machining, the control changes between the sub-operating modes `AUTOMATIK` or `HANDSTEUERN`.

**`Statuszeile und Menüleiste`** (status line and menu bar) (page 5-23)

Figure: top of the screen with labels: `Statuszeile` (status line), `Hauptbetriebsart` (main operating mode, e.g. `Editor`), `Nebenbetriebsart` (secondary operating mode, e.g. `Bearbeitung`), `Fehlerstatus (rot/grün)` (error status, red/green, at the right end), `Menüleiste` (menu bar) with `Softkeys` such as `G-Menü`, `M-Menü`, ..., `Anzeige` [uncertain], `Datum`, `Zeit`.

The following are always visible at the top edge of the screen:

- status line:
  - selected operating mode
  - generic term of the active operating level of the menu
  - date and time
- menu bar
  - representations of the nine-fields (`Neunerfelder`) that show the selectable menu items. You can select the respective menu item with the keys highlighted in red.

### 5.3.3 Windows - division of the screen (Fenster - Aufteilung des Bildschirms) (page 5-24)

**`Arbeitsbereich`** (work area)

Figure (screenshot "15.Sep.93 11:50:33" [uncertain]): `DINplus` screen. Labels: `Menüanwahl mittels Softkey-Tasten` (menu selection via softkeys), `Betriebsart` (operating mode), `Statusanzeige` (status display), `aktuelles Datum` (current date), `aktuelle Uhrzeit` (current time), `Bearbeitungsfenster` (editing window) showing a DIN program, and `Dialogbox` (dialog box) `Werkzeugdateneingabe [1-2]` (tool data entry) with fields `UT`, `X (xe)`, `Z (ze)`, `Q (fc)`, `H`, `V` [uncertain] and buttons `OK` / `Abbruch` (cancel). Menu bar: `Prog`, `Vorsp`, `Geo`, `Bea`, ..., `Block`, `Satz`, `Konfig`, `Grafik`. Display area X `327.239`, Z `379.000`, T `1`, feed `1000.0mm/min`, `100%`.

Program text visible in the screenshot (as legible):

```
N 11 G13 X70 Z? R27.5 I10 K-130 B0      [uncertain]
N 12 G1 Z-160
N 13 G1 X80
N 14 G1 Z-170
BEARBEITUNG
N 15 G96 G95 S180 F0.35 T2 M4 M7
N 16 G0 X85 Z2
N 17 G810 NS4 NE13 P3.5 I1 K0.1
N 18 G14 Q0
N 19 G96 G95 F0.1 S240 T6
N 20 G890 NS6 NE13 H3
N 23 G1 X-0 Z10
N 21 G14
N 22 M99
ENDE
```

Depending on the selected operating mode, a screen window is available for the work area which occupies the whole screen or part of it.

Via the softkeys you can activate the corresponding commands; those shown "grey" (`grau`) cannot be selected.

In the operating modes (page 5-25)

- `MASCHINE`,
- `DINPLUS`,
- `PARAMETER` and
- `SERVICE`

the screen is divided into different windows, as shown below:

Figure: `DINplus` screen with labels `Menüanwahl mittels Softkey-Tasten`, `Hauptbetriebsart` (main operating mode), `Unterbetriebsart` (sub-operating mode), `aktuelles Datum`, `aktuelle Uhrzeit`; `Fenster zur grafischen Darstellung des programmierten Teiles` (window for the graphical display of the programmed part); `Arbeitsbereich mit Dialogbox und Bedienbild` (work area with dialog box and operating picture). The dialog box shows cycle fields: `Anfang: Satznr` `NS` 5, `Ende: Satznr` `NE` 14, `max. Zustellung` `P` 4.5 mm, `Aufmaß X` `I` 1 mm, `Aufmaß Z` `K` 0.3 mm, `Eint.verhalten` `E` 0 [values uncertain]; help picture labelled `H=0; Q=1; V=3`.

So here the screen is divided into:

- work area, in which e.g. programming can be done,
- display area with information on the current machine status.

### 5.3.4 Display area (Anzeigenbereich) (page 5-26)

Figure: display area with labels:

| Label (German) | English |
|---|---|
| `X-Position` | X position (e.g. `327.239`) |
| `Z-Position` | Z position (e.g. `379.000`) |
| `aktives Werkzeug` | active tool (`T 1`) |
| `aktive D-Korrektur` | active D offset |
| `aktive D-Korrekturwerte` | active D offset values (`0.000` / `0.000`) |
| `Auslastungsanzeige Antrieb in X-Richtung` | load display, drive in X direction (bar, %) |
| `Auslastungsanzeige Antrieb in Z-Richtung` | load display, drive in Z direction |
| `Auslastungsanzeige Spindelantrieb` | load display, spindle drive |
| `angewählter Schlitten` | selected slide (`1`) |
| `Zyklusstatus` | cycle status |
| `Vorschubüberlagerung als Balkenanzeige` | feed override as bar display |
| `Vorschub-Istwert, Vorschubart` | actual feed value, feed type (e.g. `1000.0mm/min`) |
| `Vorschubwert in %` | feed value in % (`100%`) |
| `angewählte Spindel` | selected spindle (`H`) |
| `Spindelstatus` | spindle status |
| `Spindelüberlagerung als Balkenanzeige in %` | spindle override as bar display in % |
| `Drehzahl-Istwert` | actual speed value (`0 U/min`) |

Depending on the configuration, the following information can be displayed (page 5-27):

- X and Z actual values of the selected slide; traversing by handwheel in X or Z direction with display of the handwheel resolution
- slide and slide identifier, as well as actual feed value, override, set value
- spindle and spindle identifier
  - actual speed value
  - override
  - set value
- enables of the spindle (main spindle, spindle 1, spindle 2, C axis: white digits = not enabled by the PLC (`SPS`), black digits = enabled by the PLC),
  - feed
  - data
- tool and offset values of the selected tool
- status display
  - cycle on / off
  - spindle start / stop / direction of rotation

## 5.4 Command entries (Befehlseingaben) (page 5-28)

### 5.4.1 Pull-down menus (Pull-down-Menüs)

If there are one or more menu levels below the menu bar, the control opens a pull-down menu after the softkey is pressed.

Figure (screenshot "15.Sep.93 8:52:27" [uncertain], status line `EPL611 Hauptansicht » GP-Bearb`, title `Stechverfahren wählen` (select grooving method)): labels `Menüleiste` (menu bar) and `Pull-down-Menü`. Menu bar: `Schruppen` (roughing), `Stechen` (grooving), `Bohren` (drilling), `Schlichten` (finishing), `Gewinde` (thread), `SB` [uncertain]. Pull-down under `Stechen`: `Konturstechen radial` (contour grooving radial), `Konturstechen axial`, `Konturstechen automatisch`, `Einstechen radial` (recessing radial), `Einstechen axial`, `Einstechen automatisch`, `Abstechen` (parting off).

The corresponding functions are called up via:

- softkey

or

- the «`AUF`» (up) or «`AB`» (down) cursor and «`BESTÄTIGEN`» (confirm).

The current cursor position in the pull-down menu is highlighted "yellow" (`gelb`). The texts and the nine-block of fields that cannot be activated are shaded "grey".

When you press the softkeys:

- a dialog box (see below) is displayed,
- a further pull-down menu is opened, in which further sub-functions can be called up,
- an action is triggered directly.

### 5.4.2 Dialog boxes (Dialogboxen) (page 5-29)

Figure (screenshot "21.Sep.93 17:15:14" [uncertain], status line `WST00291 Hauptansicht » Fertigteil`, title `Eingabe in Pfeilrichtung` (entry in arrow direction)): menu bar of direction softkeys (arrows in eight directions, `>>`). Dialog box `Endpunkt der Strecke` (end point of the line) with fields `X`, `Z` (mm), `Länge/Winkel der Strecke` (length/angle of the line) `W(A)` = `180` °, `L` (mm), toggle field `nicht tangential` (not tangential). Labels: `Dialogbox`; `über «>>»-Taste aufrufbare Dialogboxen, Toggle-Funktionen, alphanumerische Tastatur` (dialog boxes, toggle functions, alphanumeric keyboard callable via the «>>» key); `aktuell aktiviertes Eingabefeld` (currently activated entry field).

The control opens single- or multi-page dialog boxes when you have to enter something.

**`Eingaben in Dialogbox`** (entries in a dialog box) (page 5-30)

Moving in the dialog box by:

- pressing the cursor «`AUF`» / «`AB`» keys,
- «`BESTÄTIGEN`»; the cursor then jumps to the next entry field,
- «`Seite AUF`» / «`Seite AB`» (page up / page down), paging up / down in the dialog box; when paging, the entries are buffered.

After the last (lowest) entry field has been filled, the cursor jumps to the field OK. You can then confirm with the «`BESTÄTIGEN`» or the «`INS`» key.

Note: Confirming several times through empty fields or fields already filled in by the control is not necessary; in this case press the `EINFÜGEN` (insert) key, which confirms all entries and returns immediately to the previously active operating mode.

Cancelling without consequences is possible at any time by:

- jumping on to the «`ABBRUCH`» (cancel) key and then acknowledging with «`BESTÄTIGEN`», or
- pressing the «`ESC`» key.

I.e. the dialog box is closed in the state in which it was called up, without any change.

Normally the control expects numerical entries via the 9-key number block. During entry the data are checked for correct format, value range and completeness. Entry fields that cannot be changed are shown "grey".

In certain cases you can also use the alphanumeric keyboard, which you can activate with the `>>` key. With it you can enter plain text, e.g. for the tool description.

**`Listbox`** (list box) (page 5-31)

Figure (screenshot "15.Dez.92 8:41:07" [uncertain]): operating mode `Parameter`, status `Werkzeug - Editor` (tool editor); menu bar `ID-Liste` (ID list), `Typ-Liste` (type list), `WKZ-Neueingabe` (new tool entry), `Revolver-Liste` (turret list), `WKZ-Diagnose` (tool diagnosis). List box `Auswahl der Werkzeuge` (selection of tools), header `Maske: *  gef. WKZ 104  gesp. WKZ 104  max. Anzahl WKZ 128` (mask; tools found 104, tools stored 104, max. number of tools 128); columns `Identnummer`, `Typ`, `WKZ-Bezeichnung`, `Lage`, `pnv` [uncertain], `rs/db/df`, `ew/bw/fw`, `SchnStf` (cutting material). Labels: `über «>>»-Taste aufrufbare Listbox` (list box callable via the «>>» key), `aktuell aufrufbare Position der Listbox` (currently callable position of the list box).

List contents as legible:

| Identnummer | Typ | WKZ-Bezeichnung | Lage | rs | ew | SchnStf |
|---|---|---|---|---|---|---|
| 111-35-080.1 | 111 | Schruppwerkzeug (roughing tool) | Außen (external) | 0.80 | 90.00 | GC 425 |
| 111-55-080.1 | 111 | Schruppwerkzeug | Außen | 0.80 | 75.00 | GC 425 |
| 111-55-080.2 | 111 | Schruppwerkzeug | Außen | 0.80 | 93.00 | GC 425 |
| 111-60-080.1 | 111 | Schruppwerkzeug | Außen | 0.80 | 93.00 | GC 425 |
| 111-80-080.1 | 111 | Schruppwerkzeug | Außen | 0.80 | 95.00 | GC 425 |
| 111-80-120.1 | 111 | Schruppwerkzeug | Außen | 1.20 | 95.00 | GC 425 |
| 111-90-080.1 | 111 | Schruppwerkzeug | Außen | 0.80 | 75.00 | GC 425 |
| 112-12-050.1 | 112 | Schruppwerkzeug | Innen (internal) | 0.50 | 92.00 | GC 415 |
| 112-16-080.1 | 112 | Schruppwerkzeug | Innen | 0.80 | 95.00 | GC 415 |
| 112-16-080.2 | 112 | Schruppwerkzeug | Innen | 0.80 | 92.00 | GC 415 |
| 112-20-080.1 | 112 | Schruppwerkzeug | Innen | 0.80 | 92.00 | GC 415 |
| 112-25-080.1 | 112 | Schruppwerkzeug | Innen | 0.80 | 95.00 | GC 425 |

(Row order and some values [uncertain]; the screenshot is small.)

The control also provides list boxes. List boxes contain elements (e.g. tools) from which you can select one or more.
A list element is selected with the cursor keys and the «`Seite AUF`» / «`Seite AB`» keys.
With the «`INS`» key you can change the name of a list item.
With the «`BESTÄTIGEN`» key you can save changes to a list item under the same name.

## 5.5 INFO system (INFO-System) (page 5-32)

### 5.5.1 General (Allgemeines)

The INFO system is an intelligent manual on the screen. With the INFO system the user has a powerful supporting tool which makes working with **ELTROPILOT** particularly efficient and shortens the familiarization phase considerably.

The INFO system gives the user help appropriate to the current operating situation. It can comprise both text and picture material. From one help text you can jump to further help texts to get more detailed information there.

### 5.5.2 Functions and key assignment in the INFO system (Funktionen und Tastaturbelegung im INFO-System) (page 5-33)

Press the INFO key when you need information.

The INFO system provides help pictures and help texts for the current cursor position.

The information is presented in the INFO window; the topic and the extent of the requested topic are given (e.g. `Seite 1 von 12`, page 1 of 12).

The INFO system has the following commands and functions:

| Key | Function |
|---|---|
| «`SEITE AUF`» / «`SEITE AB`» | page through the screen pages |
| (red text) | topics for which further information exists are highlighted in the text in red |
| cursor «`AB`» / «`AUF`» / «`RECHTS`» / «`LINKS`» | select a topic; the term is then shaded grey |
| «`BESTÄTIGEN`» | call up the selected topic |
| «`-`» | return to the previously called topic |
| «`ESC`» | close the INFO window and leave the INFO system |

### 5.5.3 Errors - INFO system (Fehler - INFO-System)

Via the error status key (`Fehlerstatus`, symbol: broken vertical bar) the display of the accumulated errors with the corresponding error messages can be called up. The information can comprise several screen pages. The following functions are available:

| Key | Function |
|---|---|
| «`SEITE AUF`» / «`SEITE AB`» | page up / down |
| cursor «`AUF`» / «`AB`» | select an error message |
| «`INFO`» | call up the `FEHLER-INFO-System` (error INFO system) with information on the error, the cause of the error and its elimination |
| «`LÖSCHEN`» | delete the selected error message |
| «`>>`» | view the PLC status display (`SPS-Statusanzeige`). (Pressing the key again returns to the error display.) |
| «`ESC`» | close the window and leave this function |

## 5.6 Graphical operator support (Grafische Bediener-Unterstützung) (page 5-34)

The control offers a graphical editing aid and a graphical simulation of the machining process.

- graphical editing aid (`grafische Editierhilfe`): help picture for every command, immediate display of the contour
- graphical simulation (`grafische Simulation`): the screen shows the execution of the program as a graphical simulation.

This allows you to check the program before execution. The movement simulation takes place in real time.

## 5.7 Switching the machine on and off (Ein- und Ausschalten der Maschine) (page 5-35)

Check the oil levels beforehand and top up if necessary, see 8.2, "Fill levels, check" (`Füllstände, Kontrolle`) on page 8-3.

### 5.7.1 Switching the machine on (Maschine einschalten)

The following steps are needed to switch on the machine (√ = result):

- If necessary unlock the emergency-stop button by turning it clockwise (to the right).
- Set the main switch on the control cabinet to position 1.
- √ The operating hours counter now runs and the machine lighting is switched on.
- Press the key «`Maschine (Antriebe) Ein`» (machine (drives) on) on the control panel.
- √ After approx. 1 minute the message "`Betriebsartentaste drücken`" (press operating mode key) appears.
- Open the protective hood.
- Close the protective hood.
- √ This tests the protective hood function and only now are all functions enabled.
- Press the key (operating modes key, 17a).
- √ The current date at the top right of the screen is shaded red. This means that there is an error that must be eliminated.
- Press the «`FEHLERSTATUS`» (error status) key.
- √ The following error message usually appears: "`Fehleranzeige: Werkzeugträger nicht in Position verriegelt.`" (error display: tool carrier not locked in position.)
- Press the «`ESC`» key to close the error window.
- Select the operating mode `MASCHINE`.
- Select the menu item `T`.
- Select the menu item `T-DIREKT` (T direct).
- Select one of the tools from 1-12 and confirm.
- Press the «`DEL`» key to delete the error message.
- √ The tool carrier is locked. You are in the operating mode `MASCHINE`.

### 5.7.2 Approaching the reference point (Referenzpunkt anfahren) (page 5-36)

After every switch-on of the machine you must approach the reference point. This activates the measuring system of the machine.

For reference-point travel all auxiliary units must be in their home position or working position, e.g. the chuck must be fully open or clamped and the tool turret (`Werkzeugrevolver`) locked. The protective hood and all electrically monitored auxiliary doors (`Nebentüren`) must be closed.

The control can approach the reference point in both directions.

Therefore you must first move the slide to a suitable starting position. Proceed as follows:

- Press the key (operating modes key, 17a).
- √ The screen shows the operating modes.
- Select the operating mode `MASCHINE`.
- √ The screen shows the menu `MASCHINE`.
- Select the menu item `REFERENZ AUTOMATISCH` (reference automatic).
- √ You see a dialog box `STATUS REFERENZPUNKTFAHREN` (status of reference-point travel).
- Confirm.
- √ The screen shows the dialog box `AUTOMATISCHES REFERENZPUNKTFAHREN` (automatic reference-point travel). You can select for which slides you want to approach the reference points (if several slides are present).
- Press the key «`Zyklus Start`» (cycle start).
- √ The slide approaches the reference point. On the screen you see in the X and Z display the respective distance between the tool tip and the machine zero point.
- Move the slides with the manual control keys to the start point of your automatic program, or to a position in which you can set up the machine without obstruction.

### 5.7.3 Acknowledging error displays and messages (Fehleranzeigen und Meldungen quittieren) (page 5-37)

If the screen shows errors or messages, you may have to acknowledge them before you can continue working (red shading of the date).

- Press the «`FEHLERSTATUS`» key.
- √ The errors are displayed.
- Eliminate the cause of the error if necessary. A list of common errors can be found in the chapter error messages (`Fehlermeldungen`).
- Press the error key again.
- Delete the error message with the key `Del`.
- Close the error window with the «`Esc`» key.

Note: If the cause of an error cannot be eliminated, you cannot delete the entry in the error list. Instead you get a dialog box "`Fehler darf nicht gelöscht werden`" (error must not be deleted), which you can close again by pressing the «confirm» key (wide black key). Try again to eliminate the cause of the error.

### 5.7.4 Moving off the work-area position switches (Arbeitsraum-Positionsschalter freifahren) (page 5-38)

The work-area position switches are an electrical safety device. They prevent the slides from running into the mechanical end positions of the machine.

They come into action when the software monitoring is erroneously not active (e.g. if the operator has not approached the reference point or the parameter "`Arbeitsraum`" (work area) was changed improperly).

If the slide runs onto one of these position switches, the machine is switched off automatically. Slides and spindle stop.

The screen shows an error message such as:

"`Hardware-Positionsschalter +X betätigt - NC: nicht betriebsbereit`" (hardware position switch +X actuated - NC: not ready for operation)

- Delete the error message with the key `Del`.
- Press the key (operating modes key, 17a).
- Select the operating mode `MASCHINE/HANDSTEUERN`.
- √ The message "`Freifahrschlüssel betätigen - X-Achse in Plus (Minus) Richtung freifahren`" (operate the release key - move X axis clear in plus (minus) direction) appears.
- Open the protective hood and turn the key switch to position setup mode (`Einrichtebetrieb`, symbol: filled dot on a base line).
- Press the key (enabling key `Zustimmen`, 7) and a «`HANDRICHTUNGS`» (manual direction) key.
- √ The slide moves clear.
- Switch setup mode off again and close the protective hood.
- √ The machine is ready for operation again.

### 5.7.5 Switching the machine off (Maschine ausschalten) (page 5-39)

Warning (warning symbol): Only switch off the machine when the spindles and axes are stationary. Otherwise machine damage can result.

Warning (warning symbol): Secure the workpiece before switching off the clamping energy. After the clamping energy is switched off, the hydraulics have no pressure. There is then a danger that the workpiece comes loose from the clamping devices (chuck, tailstock, steady rests (`Futter, Reitstock, Lünetten`)).

When you switch off the machine, proceed as follows:

- Set the main switch on the control cabinet to position 0.
- √ The operating hours counter stops. The screen is dark.

### 5.7.6 Emergency-stop shutdown (Not-Aus-Abschaltung)

Warning (warning symbol): Only use the emergency-stop button when there is imminent danger or for safety during maintenance and repair work on and in the machine.

You can stop the machine immediately from any operating state. To do this, press the red emergency-stop button.

This immediately brakes and stops the feed or rapid traverse and the spindle. All movable units are electrically disconnected from the mains. No moving machine function is possible any more.

To put the machine back into operation, you must unlock the emergency-stop button by turning it clockwise. Then proceed as described under switching the machine on, see 5.7.1, "Switching the machine on" on page 5-35.

The main switch does not have to be operated, and no reference travel of the axes is necessary.

Page 5-40: (blank page) (header and footer only).

## For the retrofit

- Control: Gildemeister **Eltropilot** CNC (Grundig-built panel, "GRUNDIG" logo on the monitor housing) with operating modes `MASCHINE` (`HANDSTEUERN`/`AUTOMATIK`), `DINPLUS`, `PARAMETER`, `SIMULATION`, `SERVICE`, `TURNPLUS`; DIN programs with G/M/S/T words (e.g. G96/G95, G810/G890 cycles, M99) (pp. 5-6, 5-21, 5-22, 5-24). One shared panel for both sides.
- Two independent unit groups AG 1 / AG 2, each with its own work area, spindles and slides, one operating mode per AG; "operating mode splitting" parameter decides whether cycle start/stop and feed stop act on the AG chosen by selector switch (11) or on both. Full splitting requires a partition wall between the work areas (pp. 5-4, 5-10, 5-12). For LinuxCNC: two controllers plus a shared panel-routing layer implementing this selector/splitting logic.
- Axes per side: X and Z slide (X+ = up arrow, Z+ = right arrow), C axis displayed; enables for main spindle, spindle 1, spindle 2, C axis shown from PLC (pp. 5-13, 5-22, 5-27). Handwheel: override or jog in 0.1/0.01/0.001 mm steps, tool offset setting (p. 5-8). Rapid key needs to be pressed with a direction key, hood closed (p. 5-13).
- Setup mode (key switch + hood open + `MASCHINE/HANDSTEUERN`) with two-hand enabling key: spindle max. 50 rpm, slide feed max. 1 m/min, turret indexing at reduced speed, chip conveyor jog; release of either key stops motion (pp. 5-7, 5-8, 5-13, 5-14, 5-16).
- Spindle keys: CW/CCW/stop at parameter speed, spindle jog max. 50 rpm with hood open + enabling key; direction per DIN viewed from the drive side (pp. 5-13, 5-14).
- Feed stop: feed stops immediately except during thread cutting, started M/S/T functions complete; cycle stop stops feed then spindle; cycle start needs hood closed (auto hood option closes/locks it) (p. 5-12).
- Turret: tool carrier must be locked after power-on (error "`Werkzeugträger nicht in Position verriegelt`"), cleared by `T-DIREKT` with a tool 1-12 (so 12 positions per turret) (p. 5-35). Turret jog in setup mode: enabling key + enter T + hold jog key (p. 5-16).
- Protective hoods: one per work area, unlock keys (blue lamp = unlock enabled, all motion stopped), close keys (green lamp = closed and locked); options automatic hood and two-hand mushroom buttons (9e) that close and optionally auto-start cycle; with handling option a hood opens only if the other AG's loading hatch is closed or its motion stopped (interlock between sides); manual hood release when unpowered (pp. 5-9, 5-20). Hood open/close test after power-on is required before functions are enabled (p. 5-35).
- Chucks: one foot switch per AG (left foot switch AG 1, right AG 2), each with right pedal = clamp, left pedal = release regardless of OD/ID clamping (p. 5-20). Clamping pressure via handwheel and pressure-reducing valve per AG; second clamping pressure M35 on / M34 off with lamp `P 2` (pp. 5-17, 5-20). Double clamping cylinders I/II jog keys (pp. 5-17, 5-18).
- Reference: needed after every power-on, chuck fully open or clamped, turret locked, hood and monitored side doors closed; can home in both directions (p. 5-36). Hardware work-area limit switches (e.g. +X) cut power; recover with release key in setup mode (p. 5-38). E-stop brakes feed and spindle and disconnects all movable units; no re-homing needed after E-stop reset (p. 5-39).
- Switch-off: hydraulics lose pressure with clamping energy off; workpiece can drop out of chuck/tailstock/steady (p. 5-39). Hydraulic system pressure gauge, coolant tank for spindle motors, chip conveyor motor protection switch on the cabinet (p. 5-5).
- Option I/O per side: chip conveyor fwd/rev/on/off, coolant pump on/off (per selector), oil mist separator, coolant cleaning system, bar feed jog and bar machining key switch, overload clutch indicator for X/Z, finished-part conveyor, unloading device (swivel arm in/out, gripper open/close, workpiece catcher open/close), F1/F2 freely assignable, interface I/II selection (pp. 5-10, 5-11, 5-16 to 5-19). Part transfer between sides is not described in this chapter beyond the unloading device keys.
- Serial data interface plus 230 V / 150 W / 1 A socket (p. 5-20).
