brdmaker/stmbl/docs/ctxtwin/operating_en/02_technical_data.md

# Gildemeister CTX twin operating instructions (English edition), 2. Technical data, pages 2-1 to 2-8

Source: `64fa9d89-CTX_twin_Operating_instructions_2.pdf`, 8 pages (scanned), manual pages 2-1 to 2-8. "Operating instructions, CTX twin, Dok. No.: daaab1g1, February 1995".
Original language: English.

Running page header: "2. Technical data". Page 2-2 is blank (header/footer only).

---

## Page 2-1: Chapter contents

**2. Technical data**

| No. | Title | Page |
|---|---|---|
| 2.1 | Technical data | 2-3 |
| 2.2 | Performance diagram, main drive 202 Nm | 2-4 |
| 2.3 | Performance diagram driven tools | 2-5 |
| 2.4 | Working space page 1 | 2-6 |
| 2.5 | Working space page 2 | 2-7 |
| 2.6 | Feed drives | 2-8 |

## Page 2-2

(blank page)

## 2.1 Technical data

(Page 2-3)

| Item | Unit | Value |
|---|---|---|
| **Operating range** | | |
| Circulating diameter above cover | mm | 305 |
| Max. turning dia. | mm | 230 |
| Chuck dia. | mm | 200 |
| Chuck part length | mm | 200 |
| Max. spacing between spindles | mm | 1361 |
| Slide cross path (X1/X2) | mm | 232 |
| Slide longitudinal path (Z1) | mm | 380 |
| Spindle motor longitudinal stroke (Z2) | mm | 1165 |
| **Turning spindle 1 (left) and 2 (right)** | | |
| Spindle nose dia. (flat flange) | mm | 170 h5 |
| Spindle hole dia. | mm | 65 |
| Bar dia. | mm | 51 |
| Spindle dia. in front bearing | mm | 110 |
| **Integrated AC spindle motor 1 (left) and 2 (right)** | | |
| Drive performance 100% duty cycle | kW | 18 |
| Max. torque 100% duty cycle | Nm | 202 |
| Speed range | rpm | 25-4000 |
| Kink rotational speed | rpm | 850 |
| C axis | | Option |
| C axis rotational speed | rpm | 100 |
| C axis torque | Nm | 202 |
| **Feed drive AC** | | |
| X feed force 100% duty cycle | N | 4000 |
| Z feed force 100% duty cycle | N | 8000 |
| X high speed | m/mn | 16 |
| Z high speed | m/mn | 24 |
| **Tool holder** | | |
| Universal tool holder, autom. indexing with directional logics | | |
| Number of tool stations | | 2 x 12 |
| Tool mounting cylinder shaft (DIN 69880) | mm | 40 |
| Tool holder switching time per station (30° indexing) | sec. | 0.2 |
| Maximum indexing cycles | h | 720 |
| **Tool holder with driven tools, optional** | | |
| Number of tool stations | | 2 x 12 |
| of which max. driven tools | | 2 x 12 |
| max. chucking dia. tool | mm | 16 |
| Drive capacity 36% duty cycle | kW | 5.3 |
| Max. torque 36% duty cycle | r.p.m (as printed; Nm meant) | 24 |
| Max. driven tool rotational speed | r.p.m. | 3000 |
| **Machine dimensions** | | |
| Dimensions (LxWxH) with chip conveyor | mm | 5200x2700x1900 |
| Weight without chip conveyor | kg | 9500 |
| **Noise emission values (constant sound pressure level)** | | |
| Workplace based constant noise level: (DIN 45635 part 1-04.84 (ISO 3740-1980), measured as a cutting procedure as per DIN 45635 part 1601-07.78 | dB(A) | 77 |

Notes on the printed values: "Maximum indexing cycles ... h ... 720" is printed with unit "h" (presumably 720 indexing cycles per hour). The feed force unit is "N" here but "daN" in table 2.6 for the same numbers (4000 / 8000).

## 2.2 Performance diagram main drive 202 Nm

(Page 2-4)

Motor data (S1):
- P<sub>N</sub> = 18.0 kW
- M<sub>N</sub> = 202 Nm
- n<sub>N</sub> = 850 rpm

n = 25 - 4000 rpm (next to a small sketch of the motor with shaft at both ends).

Figure: log-log diagram, power P [kW] (left axis, 0.112 ... 28.0, marked "18,0") and torque Md [Nm] (right axis, 3.55 ... 900, marked "202") over speed n [min⁻¹] (16 ... 5000, with "850 - 800" [uncertain] marked at the corner). Legend: P = solid black line, Md = double (hollow) line. Power rises linearly from about 25 min⁻¹ to 18.0 kW at 850 min⁻¹ and stays constant to 4000; torque is constant at 202 Nm from 25 to 850 min⁻¹ and then falls (constant power) to about 45 Nm at 4000 min⁻¹.

## 2.3 Performance diagram Driven tools

(Page 2-5)

Figure: torque Md [Nm] (left axis 0-35) and power P [kW] (right axis 0-7) over n (1/min) 0-3000. Two operating curves:
- `S6 - 36% ED`: torque starts at 24 Nm and falls linearly to about 17 Nm at 3000 1/min; power rises to 5.3 kW at 3000 1/min.
- `S1 - 100% ED`: torque starts at 14.5 Nm and falls to about 8 Nm at 3000 1/min; power rises to 2.5 kW at 3000 1/min.

Legend: `----- P ( S1 )`, `____ Md ( S1 )`, `----- P ( S6 )`, `____ Md ( S6 )`.

## 2.4 Working space page 1

(Page 2-6)

Figure: end view along the spindle axis of one working space; inclined (45°) cross slide carrying the 12-station disk turret with a driven tool, chuck with turning diameter, centre height measured perpendicular to the slide guideways. Labels: `SW 380` (turret width across), `FK - Ø = 720` (circle swept by the tool holder), `TK - Ø = 620` (tool circle), `D`, `F`, `U`, `h`, `HX`.

| D max. turn. dia. | F Chuck dia. | U max. Rotation dia. | h Centre height | HX Stroke in X |
|---|---|---|---|---|
| 230 | 200 | 310 | 470 | 232 |

(U max. is 310 here; 2.1 gives "circulating diameter above cover" 305.)

## 2.5 Working space page 2

(Page 2-7)

Figure: plan view of both working spaces, spindle 1 (left, machine zero point M1) and spindle 2 (right, machine zero point M2) facing each other, each with its tool holder (tool holder reference points T1, T2; tool reference points N1, N2) above the spindle axis; separation wall drawn as a vertical dash-dot line between the sides. In the right side a workpiece transferred into spindle 2 is shown dashed. Dimensions: `HZ1`, `HX1`, `A1`, `L`, `LW`, `ØD`, `B`, `F` on the left; `A2`, `HZA`, `HX2`, `L`, `LW`, `ØD` on the right; `HZ2` and `LS` across both.

Legend: `M` Machine zero point; `T` Tool holder reference point; `N` Tool reference point.

| A1 | A2 | B | D | F | HX1 Stroke X1 | HX2 Stroke X2 |
|---|---|---|---|---|---|---|
| 123.5 | 503.5 | 22 | 230 | 520 | 232 | 232 |

| HZ1 Stroke Z1 | HZ2 Headstock stroke | HZA Stroke Z2 | L | LS max. spacing | LW |
|---|---|---|---|---|---|
| 380 | 1165 | 380 | 200 | 1361 | 130 |

(F on this page is the distance from the spindle axis to the tool holder, 520, not the chuck diameter of page 2-6.)

## 2.6 Feed drives

(Page 2-8)

Figure: sketch of motor (`Md, n`), coupling, ball screw and slide (`s, Fv, Ve, m`).

| | Symbol | Unit | X axis | Z axis |
|---|---|---|---|---|
| Motor manufacturer / Motor type | | | Indramat MAC 93 A | Indramat MAC 93 B |
| Max. motor speed | n | rpm | 2000 | 3000 |
| Torque 100 % duty cycle | Md | Nm | 9.2 | 14.5 |
| Torque ... % duty cycle | Md | Nm | 26 | 38.3 |
| Rapid traversing speed | V<sub>e</sub> | m/min | 16 | 24 |
| Feed speed | V<sub>V</sub> | m/min | ... | ... |
| Feed force | F<sub>V</sub> | daN | 4000 | 8000 |
| Slide position | | | 45° | |
| Gear transmission | i | | 1 : 1 | 1 : 1 |
| Recirculating ball screw | dxh | mm | 32 x 10 | 40 x 10 |

("..." printed as such: duty cycle percentage and feed speed not filled in.)

---

## For the retrofit

- Axes per side: X1/X2 (cross slide, 45° inclined, stroke 232 mm), Z1 (tool slide longitudinal, 380 mm) on the left side; on the right side the spindle motor/headstock moves (Z2 "spindle motor longitudinal stroke" 1165 mm, "headstock stroke" HZ2 1165) and the table also gives HZA "Stroke Z2" 380 (p. 2-3, 2-7). The moving right headstock is what makes part transfer between the spindles possible; max. spindle spacing 1361 mm.
- Machine zero points M1, M2 at the spindle noses; A1 = 123.5, A2 = 503.5, F = 520 (spindle axis to tool holder), B = 22, LW = 130 (p. 2-7).
- Feed motors: Indramat MAC 93 A (X, 2000 rpm, 9.2 Nm S1, 26 Nm peak) and MAC 93 B (Z, 3000 rpm, 14.5 Nm S1, 38.3 Nm peak); direct 1:1 to ball screws 32 x 10 (X) and 40 x 10 (Z); rapid 16 m/min X, 24 m/min Z; feed force 4000 / 8000 (N or daN, inconsistent) (p. 2-3, 2-8). 10 mm pitch at 1:1 means rapid = motor max speed x 10 mm (X 2000 rpm = 20 m/min ceiling, Z 3000 rpm = 30 m/min).
- Spindles: two integrated AC spindle motors, 18 kW / 202 Nm S1, 25-4000 rpm, base (kink) speed 850 rpm; spindle nose 170 h5 flat flange, bore 65 mm, bar 51 mm (p. 2-3, 2-4).
- C axis (option): 100 rpm, 202 Nm, done by the main spindle motor (p. 2-3).
- Turret: 12 stations per side (2 x 12), VDI 40 (DIN 69880) shanks, 30° per station, 0.2 s per station, "autom. indexing with directional logics" (shortest path); optional driven tools on all 12 stations, max. 3000 rpm, 5.3 kW / 24 Nm at S6 36 %, 2.5 kW / 14.5 Nm at S1, collet max. 16 mm (p. 2-3, 2-5). Tool circle 620 mm, swing circle 720 mm (p. 2-6).
- Chuck 200 mm, max. turning dia. 230 mm, chuck part length 200 mm (p. 2-3).
- Machine 5200 x 2700 x 1900 mm, 9500 kg; noise 77 dB(A) (p. 2-3).
