brdmaker/stmbl/docs/ctxtwin/operating_en/10_index.md

# Gildemeister CTX twin operating instructions (English edition), Index, pages X-1 to X-3

Source: `afc6ac3b-CTX_twin_Operating_instructions_10_index.pdf`, 4 pages (scanned), manual pages X-1 to X-3 plus one blank back page. "Operating instructions, CTX twin, Dok. No.: daaab1g1, February 1995".
Original language: English.

Running page header: "Index". Entries transcribed as printed (two columns per page, read column by column). Indented sub-entries are shown as "Main entry, sub-entry". Page numbers as printed (some refer to front-matter pages iii-x not included in this scan set).

---

## Page X-1

### A

| Entry | Pages |
|---|---|
| Acknowledging fault messages | 5-33, 5-35, 5-37, 5-38 |
| Agreement key | 3-10, 5-8 |
| Automatic | |
| Automatic, Protection hood | 3-7, 5-9 |
| Automatic, Working space separation wall | 3-6, 3-11 |
| Axis feed | 5-13 |

### B

| Entry | Pages |
|---|---|
| Bar feeder oil level | 8-4 |
| Bar feeding | 3-6, 5-16, 6-45, 8-4 |
| Bar guidance | 3-6 |
| Bar loading magazine | 6-47 |
| Bar machining | 6-39, 5-7 |
| Bar machining, with bar loading magazine | 6-46 |
| Bar machining, with bar feeding | 6-46 |
| Bar machining, only with lathe | 6-39 |

### C

| Entry | Pages |
|---|---|
| C axis | 3-6, 6-28 |
| C axis, Zero point displacement | 6-31 |
| C axis, Tool calculation | 6-30 |
| Ceramic | 3-9 |
| Changing entries | 5-15 |
| Changing workpiece | 4-4, 7-9 |
| Checking chucking pressure | 6-19 |
| Chip conveyor | 3-5, 3-6, 3-13 |
| Chip conveyor, Motor protection switch | 5-5 |
| Chip conveyor, Forward/backward | 5-16 |
| Chip transport | 5-10 |
| Chuck | 6-9 |
| Chuck actuation | 5-20 |
| Chuck type | 6-17 |
| Chucking cylinder | 6-9, 6-17 |
| Chucking device | 3-5, 6-9 |
| Chucking means | |
| Chucking means, Removal | 6-12 |
| Chucking means, Fitting | 6-13 |
| Chucking mode | 6-17 |
| Chucking pressure | 6-11 |
| Chucking pressure setting | 5-20 |
| Chucking stroke | 6-11 |
| Chucking stroke, Setting | 6-14 |
| Collection bath | 3-7 |
| Compound slide | 3-5 |
| Conformity declaration | x |
| Confirmation key | 5-15 |
| Control lamps | 3-7, 6-48 |
| Coolant | |
| Coolant, Container | 3-7 |
| Coolant, Through the turning spindle | 3-7 |
| Coolant, Spindle motor | 3-17, 8-4 |
| Coolant, Spray gun | 3-7 |
| Coolant lubricant | 3-15, 3-17, 8-3 |
| Cooling unit | 3-5 |
| Current rotational speed | 5-27 |
| Cycle start | 5-12 |
| Cycle stop | 5-12 |

### D

| Entry | Pages |
|---|---|
| Data storage unit, external | 3-6 |
| Data transmission | 5-20 |
| Drive off | 5-8 |
| Drive on | 5-8 |
| Driven tools starting | 6-29 |

### E

| Entry | Pages |
|---|---|
| Emergency stop | vi, 3-10, 5-9, 5-39 |
| Emission | 3-13 |
| Equipment | 3-7 |
| Erase, fault message | 5-33, 5-35, 5-37, 5-38 |
| Erasing entries | 5-15 |
| Expert program | |
| Expert program, Types | 7-13 |
| External data carrier | 5-20 |
| External data storage unit | 3-6 |
| External event | 9-159 |

### F

| Entry | Pages |
|---|---|
| F1, F2 | 5-10 |
| Fault messages | 9-32 |
| Fault status report | 5-17 |
| Fault window | 5-35, 5-37 |
| Feed actual value | 5-27 |
| Feed drive | 2-8 |
| Feed motor X axis | 3-5 |
| Feed motor Z axis | 3-5 |
| Feed override | 5-27 |
| Foot switch | 3-5, 5-20 |
| Fresh oil lubrication | 8-3 |
| Further key | 5-15 |

### G

| Entry | Pages |
|---|---|
| Graphic operator support | 5-34 |
| Graphic simulation | 5-34 |
| Guarantee | x |

### H

| Entry | Pages |
|---|---|
| Handwheel | 5-8 |
| Hollow clamping unit | 3-7 |
| Hydraulic | 3-12 |
| Hydraulic, Unit | 3-5 |
| Hydraulic, Oil | 3-15, 8-3 |

### I

| Entry | Pages |
|---|---|
| Individual block | 7-6 |
| Intended use of the machine | iii, 3-8 |
| Interface | 5-20 |

## Page X-2

### K

| Entry | Pages |
|---|---|
| Key switch | 3-10 |
| Key switch, Bar machining | 5-7 |
| Key switch, Setting operation | 5-36 |
| Key switch - setting operation | 5-37 |
| Keyboard | 5-15 |

### L

| Entry | Pages |
|---|---|
| Levelling the machine | 3-8, 3-9 |
| Limit values | 3-9 |
| Lubricant | 3-16 |
| Lubricating oil | 3-15 |
| Lubrication unit | 3-5 |

### M

| Entry | Pages |
|---|---|
| M commands | 9-21 |
| Machine | |
| Machine, Stopping | 4-4 |
| Machine, Starting | 4-3 |
| Machine, Switching off | 5-35, 5-39 |
| Machine, Switching on | 5-35 |
| Machine bed | 3-5 |
| Main switch | iv, 5-5 |
| Maintenance | ix |
| Maintenance, Working space | 8-3 |
| Maintenance, Levels | 8-3 |
| Maintenance plan | 8-5, 8-6 |
| Malfunctions | |
| Malfunctions, Malfunction button | 5-17 |
| Malfunctions, Malfunction lamp | 5-7 |
| Material | 3-8 |
| Measuring device | 6-37 |
| Menu bar | 5-23 |
| Menu plane | 5-14, 5-15, 5-22, 5-23, 5-28 |
| Menu selection | 5-22 |
| Misuse | 3-9 |
| Monitor | 5-7 |
| Move to reference point | 5-30 |
| Moving free, position switch | 5-38 |

### N

| Entry | Pages |
|---|---|
| Noise protection | 3-13 |
| Number keys | 5-17 |

### O

| Entry | Pages |
|---|---|
| Oil level | |
| Oil level, Bar feed | 8-4 |
| Oil level, Bar guidance | 8-4 |
| Oil, lubricant and coolants | 3-15 |
| Oil, lubricant and coolants | v |
| Oil mist separator | 3-6 |
| Operating element | 3-5, 5-5 |
| Operating mode | |
| Operating mode, Splitting | 5-4 |
| Operating modes | 5-22 |
| Operating malfunctions | 5-7 |
| Operating surface | 5-20 |
| Operation | vi |
| Options | |
| Options, Pick-off device | 5-18, 6-32 |
| Options, Setting | 6-39 |
| Options, Workpiece ejection | 6-34 |
| Overload clutch | 3-6, 6-49 |
| Override | 5-8 |

### P

| Entry | Pages |
|---|---|
| Parallel machining | 6-27 |
| Parameter | |
| Parameter, Range | 9-6 |
| Parameter, Setting | 9-3 |
| Parameter, List | 9-6 |
| Parameter, Protection class / protection criteria | 9-6 |
| Performance diagrams | |
| Performance diagrams, Driven tools | 3-5 |
| Performance diagrams, Main drive 202 Nm | 2-4 |
| Pick-off device | 5-8, 6-32 |
| Pick-off device, Setting | 6-33 |
| PLC keys | 5-10 |
| Pressure gauge | 5-5 |
| Pressure vessel regulations | iv |
| Program example | |
| Program example, Bar loading magazine | 6-4 |
| Program example, Reading in | 7-10 |
| Program example, Selection | 7-3 |
| Program example, Transmission/back-up on external data carriers | 7-11 |
| Protection hood | |
| Protection hood, Automatic | 3-7 |
| Protection hood, Releasing | 5-9 |
| Protection hood, Manual releasing | 5-20 |
| Protection hood, Locking | 5-9 |

### R

| Entry | Pages |
|---|---|
| Rapid traverse | 5-13 |
| Release | 5-27 |
| Repairs | ix |
| Rotational speed control | 3-12 |
| Rotational speed limit | v |
| Rotational speed limit setting | 6-18 |
| Rotational speed override | 5-27 |

### S

| Entry | Pages |
|---|---|
| Safety devices | 3-10 |
| Safety regulations and precautionary measures | iii |
| Safety window | iv |
| Screen display | 5-22, 5-23, 5-24, 5-26 |
| Screen divisions | 5,22, 5-23, 5-24, 5-26 (as printed) |
| Selector switch AG | 5-10 |
| Setting | 6-7 |
| Setting protection zone | 6-25 |
| Slides | |
| Slides, Moving | 5-13 |
| Slides, Switch over | 5-14 |

## Page X-3

| Entry | Pages |
|---|---|
| Spindle | |
| Spindle, Display | 5-27 |
| Spindle, Inching | 5-14 |
| Spindle, Reduction tube | 3-5 |
| Spindle, Stop | 5-12, 5-13 |
| Spindle, Switch over | 5-14 |
| Spindle, Turning | 5-13, 5-14 |
| Spindle motor | 3-5 |
| Spindle motor, Coolant | 8-4 |
| Spindle reducing tube | 3-6 |
| Splitting | 3-11 |
| Start up, reference point | 5-36 |
| Status line | 5-23 |
| Stop feed | 5-12 |
| Supply cabinet | 3-5 |
| Switch cabinet | 3-5 |
| Switching on the machine | 5-35 |
| Switching off the machine | 5-35, 5-39 |
| Switching the machine off | vi |
| Switching the machine on | 5-32 |
| Symbol and information explanation | iv |

### T

| Entry | Pages |
|---|---|
| Tool compensation value | 5-27 |
| Tool holder | 3-5, 5-16 |
| Tool holder, Equipping | 6-20 |
| Tool measuring device | 3-7, 6-37 |
| Tool measuring device, Setting parameters | 6-37 |
| Tool starting, driven | 6-29 |
| Two pressure | |
| Two pressure, Coolant device | 3-7 |
| Two pressure, Chucking device | 3-7 |
| Two pressure chucking device | 6-36 |

### U

| Entry | Pages |
|---|---|
| Unit 1 + 2 | 5-10 |

### W

| Entry | Pages |
|---|---|
| Working space | 2-6, 2-7 |
| Working safety instructions | iv |
| Working space dividing wall, automatic | 3-6, 3-11 |
| Workpiece | |
| Workpiece, Automatic machining | 7-8 |
| Workpiece, Machining in individual blocks | 7-6 |
| Workpiece clamping | 3-12 |
| Workpiece ejector | 6-34 |

### Z

| Entry | Pages |
|---|---|
| Zero point displacement | 6-21 |

## PDF page 4

(blank page)

---

## For the retrofit

The index gives only page pointers; it shows where the I/O-relevant functions are described (pages not in this PDF set unless noted):

- Panel/PLC signals to reproduce: `Agreement key` (3-10, 5-8), `Drive on` / `Drive off` (5-8), `Handwheel` (5-8), `Override` (5-8), `F1, F2` and `PLC keys` (5-10), `Selector switch AG` and `Unit 1 + 2` (5-10), `Cycle start` / `Cycle stop` / `Stop feed` (5-12), spindle stop/turning/inching/switch over (5-12 to 5-14), slides switch over (5-14), chip conveyor forward/backward (5-16), malfunction lamp / button (5-7, 5-17), `Key switch` for setting operation and bar machining (3-10, 5-7, 5-36, 5-37), main switch (iv, 5-5), emergency stop (3-10, 5-9, 5-39).
- Doors: protection hood locking/releasing (5-9), manual releasing (5-20), automatic hood (3-7); automatic working space dividing/separation wall (3-6, 3-11), "Splitting" (3-11), "Operating mode, Splitting" (5-4).
- Chuck: foot switch (3-5, 5-20), chuck actuation and chucking pressure setting (5-20), chucking stroke/pressure/mode/chuck type (6-11 to 6-17), two-pressure chucking device (6-36), hollow clamping unit (3-7).
- Process/machine items: C axis (3-6, 6-28), driven tools starting (6-29), pick-off device (5-8, 6-32), workpiece ejector (6-34), tool measuring device (6-37), overload clutch (3-6, 6-49), bar feeding/bar loading magazine (6-39 to 6-47), coolant through the turning spindle and two-pressure coolant (3-7), spindle motor coolant (3-17, 8-4), oil mist separator (3-6), "Moving free, position switch" (5-38).
- PLC data: M commands (9-21), fault messages (9-32), external event (9-159), parameter list (9-6).
