brdmaker/stmbl/docs/ctxtwin/manual/04a_assembly_p01-20.md

# Gildemeister CTX twin, 4. Assembly groups, PDF pages 1-20 (manual pages 4-1 to 4-28)

Source: `4_Assembly_groups_with_assembly_group_description_20201028_0001.pdf` (62 scanned pages; this file covers PDF pages 1-20), "Mechanical technical documentation, CTX twin, Doc. No.: daaam0g1, February 1995", chapter 4 "Assembly groups with assembly group description".
Original language: English.

Note on page coverage: the scan jumps from manual page 4-8 (PDF page 8) to 4-17 (PDF page 9). Manual pages 4-9 to 4-16 (section 4.3 "Headstock with integrated spindle motor") are **not in PDF pages 1-20**; they may be missing from the scan or appear later in the PDF [uncertain]. PDF-page to manual-page map:

| PDF page | Manual page | Content |
|---|---|---|
| 1 | 4-1 | Contents of chapter 4 |
| 2 | 4-2 | (blank page) |
| 3 | 4-3 | Note |
| 4 | 4-4 | 4.1 Assembly groups of the CTX twin (drawing) |
| 5 | 4-5 | Assembly groups (legend) |
| 6 | 4-6 | 4.2 Machine bed (drawing 0957974) |
| 7 | 4-7 | Parts list: Bed with roller guides, pos. 1-20 |
| 8 | 4-8 | Parts list: Bed with roller guides, pos. 21 |
| 9 | 4-17 | 4.4 Compound slide with tool holder (drawing 0957879 pg. 1) |
| 10 | 4-18 | (blank page) |
| 11 | 4-19 | Compound slide with turret (drawing 0957879 pg. 2) |
| 12 | 4-20 | (blank page) |
| 13-16 | 4-21 to 4-24 | Parts list: LH Compound slide rest with roller guides |
| 17 | 4-25 | 4.5 Longitudinal feed drive 1 (drawing 0959011) |
| 18 | 4-26 | (blank page) |
| 19-20 | 4-27 to 4-28 | Parts list: Feed drive 1, longitudinal |

All page headers read "4. Assembly groups with assembly group description"; all footers read "Mechanical technical documentation / CTX twin / Doc. No.: daaam0g1 / February 1995 / Page 4-n".

---

## Page 4-1: 4. Assembly groups with assembly group description

| Section | Title | Page |
|---|---|---|
| 4.1 | CTX twin module groups | 4-4 |
| 4.2 | Machine bed | 4-6 |
| 4.3 | Headstock with integrated spindle motor | 4-9 |
| 4.4 | Compound slide rest with tool holder | 4-17 |
| 4.5 | Feed drive 1 longitudinal | 4-25 |
| 4.6 | Feed drive 2 longitudinal | 4-29 |
| 4.7 | Radial facing slide 2 | 4-35 |
| 4.8 | Hydraulic plan pressure supply | 4-43 |
| 4.9 | Pressure supply unit list | 4-45 |
| 4.10 | Tool holder hydraulic plan with driven tools | 4-47 |
| 4.11 | Tool holder 1 + 2 equipment list with driven tools | 4-49 |
| 4.12 | Lubrication plan | 4-51 |
| 4.13 | Lubrication plan with individual parts list | 4-53 |
| 4.14 | Lubrication point review | 4-54 |
| 4.15 | Open centre chucking unit | 4-55 |
| 4.15.1 | Chucking device hydraulic plan | 4-59 |
| 4.15.2 | Left and right hand chucking device | 4-61 |
| 4.15.3 | Integrated spindle motor cooling | 4-63 |

## Page 4-2

(blank page)

## Page 4-3: Note

**Note:**

The machine is represented in the following chapters 4 to 6 in the form of drawings and part lists. This is intended to support repairs and maintenance work. The parts lists assist in determining defective parts with the help of the position number.

Prior to undertaking repair work observe the instructions contained in chapter 2 and, if necessary, involve the Gildemeister service.

## 4.1 Assembly groups of the CTX twin (page 4-4)

Figure (two isometric views):

- Upper view: the bare machine without guarding. A long slant-type machine bed (1) carries two headstocks / integrated spindle motors (2), one at the left end and one at the right end, spindles facing each other toward the middle. Each spindle nose carries a chucking device (9). Two compound slides sit on the rear slant between the spindles, each with a disc turret / tool holder (10) facing the work area. Left side: X1 feed motor (3) on top of compound slide X1/Z1 (7), Z1 feed motor (5) at the side. Right side: X2 feed motor (4) on slide X2 (8). The Z2 axis feed motor and slide (6) are at the far right end of the bed, behind/under the right headstock (the right headstock itself appears to travel in Z2 [uncertain from drawing; see legend item 6 and item 10 of the 4-7 parts list "roller guide, longitudinal for spindle motor base"]).
- Lower view: the complete guarded machine with sliding front doors, operating panel and monitor (13) on the front right, supply cabinet (12) behind/right, chip conveyor (14) leaving the right end, and two foot switches (11) on the floor in front.

Callouts printed: 1, 2 (x2), 3, 4, 5, 6, 7, 8, 9 (x2), 10 (x2), 11 (x2), 12, 13, 14.

## Assembly groups (page 4-5)

The machine bed comprises of the following assembly groups (refer to drawing on previous page):

1. **Machine bed**
2. **Integrated spindle motor, left and right**
3. **X1 axis feed motor**
4. **X2 axis feed motor**
5. **Z1 axis feed motor**
6. **Z2 axis feed motor and slide**
7. **Compound slide X1/Z1**
8. **Slide X2**
9. **Left and right hand chucking device**
   The chucking device comprises of:
   - hydraulically actuated chucking cylinder
   - Connection / tension tube
   - Chuck / collets
10. **Tool holder:**
    The tool holder serves to accept tools.
    In the machine version with driven tools the tool is driven via a servo motor mounted on the tool holder.
11. **Foot switch for left and right clamping**
12. **Supply cabinet containing the following components:**
    - Switch cabinet
    - Hydraulic unit
    - Lubrication unit
    - Cooling unit for integrated spindle motors
13. **Operating elements and monitor**
14. **Chip conveyor (optional)**

## 4.2 Machine bed (page 4-6)

Drawing ident. Nr. 0957974 (also printed vertically at lower left: "0957974").

Figure (drawing printed rotated 90°): cross-section through the machine bed showing the slant-bed casting (1) with the longitudinal roller guides for the compound slide rest (6) on the slant, the longitudinal roller guide for the spindle motor base (10), the clamping V-ledges (8) held by flat-head screws (9) and screws (7) (detail circle), screws (5) and (3)/(4) (Z stop and buffer stop) on the slant, the plate (11) with square-headed pressure screw (2) at the top/rear, and the foundation details: heavy-duty anchor (12) with spherical disc (13) and conical socket (14) set into the concrete floor (detail circle), levelling via hex cap screw M24 (15) with washer (16), headless set screw (19) and nut (20) (detail circle), screw (17) with washer (18) (detail circle), and tapered pin (21) at a mounting block.

Callouts printed: 1, 2, 3, 4, 5, 6, 7, 8, 9, 10, 11, 12, 13, 14, 15, 16, 17, 18, 19, 20, 21. Two handwritten marks on the drawing near pos. 5/10 and 3/4 read approximately "BZ" and "Z" [uncertain].

### Bed with roller guides, 117--01.02/001, Ident No. 0957439 (pages 4-7, 4-8)

| Pos. | Designation | Part No. / DIN No. | Ident No. |
|---|---|---|---|
| 1 | Bed | 117--01.01/001 | 0957440 |
| 2 | Square-headed pressure screw M24/1.5X60 | WN 9-01-03 | 0004535 |
| 3 | Stopp Z | 117--13-0005/000 | 0953062 |
| 4 | Buffer stop | 156--07-0011/000 | 0920620 |
| 5 | Hexagon socket screw M12X50 | DIN 912 | 0118487 |
| 6 | Roller guide, longitudinal for compound slide rest | 117--21-0010/000 | 0948982 |
| 7 | Hexagon socket screw M12X45 - 12.9 | DIN 912 | 0326877 |
| 8 | V-ledge for roller guide | 117--21-0021/001 | 0953044 |
| 9 | Hexagon socket screw with flat head M6X20 | DIN 7984 | 0002198 |
| 10 | Roller guide, longitudinal for spindle motor base (row marked with a handwritten "X" in the margin) | 117--11-0030/000 | 0948983 |
| 11 | Plate | 127--33-0001/000 | 0933618 |
| 12 | Heavy duty anchor type: AB 25/65, Messrs. LIEBIG | | 0933646 |
| 13 | Spherical disk C17 | DIN 6319 | 0001717 |
| 14 | Conical socket D19 | DIN 6319 | 0001721 |
| 15 | Hexagon cap screw M24X70 | DIN 933 | 0001319 |
| 16 | Washer 25 | DIN 125 | 0000413 |
| 17 | Hexagon cap screw M16X40 | DIN 933 | 0001293 |
| 18 | Washer 17 | DIN 125 | 0000419 |
| 19 | Headless set screw M10X60 | DIN 913 | 0001112 |
| 20 | Hexagonal nut M10 | DIN 934 | 0001345 |
| 21 | Tapered pin with internal screw thread 10X30 | DIN 7978 | 0002114 |

(The parts lists in this chapter have no quantity column.)

## 4.3 Headstock with integrated spindle motor (pages 4-9 to 4-16)

Not contained in PDF pages 1-20 (see coverage note above).

## 4.4 Compound slide with tool holder (page 4-17)

Drawing ident. Nr. 0957879 Pg. 1

Figure: top view of the left compound slide rest (X1/Z1). The X-axis servo motor sits on top (upper centre), mounted via flange/bearing block (65) to the cross ball screw (50); the slide body with the roller-guide carriages is below it, the turret mounting at the left and the longitudinal rails / cable chain at the right. Callouts: 5/6/8, 10/9/7, 15, 60, 51, 67/70, 65, 66/68, 17/19, 18, 50, 53, 1, 3, 2, 44/43.

## Page 4-18

(blank page)

## Compound slide with turret (page 4-19)

Drawing ident. Nr. 0957879 Pg. 2 (printed vertically at lower left: "0957879.2")

Figure: section through the compound slide along the cross (X) axis, inclined, showing the AC servomotor (71) at the top end, coupling (58), flange (76), bush (75), bearing block, the cross ball screw running down through the radial facing slide (35) to the disc turret (90) with turret disc (95) at the lower end; the cable chain (48) loops above the slide. A detail (upper right) shows the ball screw bearing end: shaft seal ring (54), shaft nut (55), parallel roller bearing (56), seal ring (57), screw (52). Symbols printed near callout 36: a turret/tool symbol and "DM" [uncertain: probably "driven tools"/Drehmoment marking].

Callouts printed: 71, 48, 75, 58, 76, 69, 26, 45, 48, 46/47, 55, 57, 52, 54, 56, 78/77, 16, 21/20, 38/37, 106, 108/107, 105, 91, 95, 90, 92, 100, 36, 35, 41, 28/29, 27, 25, 40.

## Page 4-20

(blank page)

### LH Compound slide rest with roller guides, 117--21.01/000, Ident No. 0953107 (pages 4-21 to 4-24)

(Page 4-24 header is misprinted "LH Compount slide rest with roller guides".)

| Pos. | Designation | Part No. / DIN No. | Ident No. |
|---|---|---|---|
| 1 | Buffer stop | 156--07-0011/000 | 0920620 |
| 2 | X stop | 117--13-0060/000 | 0953209 |
| 3 | Hexagon socket screw M12X40 12.9 | DIN 912 | 0926715 |
| 5 | Bracket for proximity detectors X interrogation | 117--13-0015/000 | 0953207 |
| 6 | Washer 6.4 | DIN 125 | 0000405 |
| 7 | Hexagon socket screw M4X40 | DIN 912 | 0000927 |
| 8 | Hexagon socket screw M6X16 | DIN 912 | 0000942 |
| 9 | Clip order no. 039.999989, BES 12.0-BS-1, Messrs. BALLUFF | | 0251661 |
| 10 | Proximity detector BES516-325-S4-Y with plug connection | | 0251370 |
| 15 | Switch plate | 117--13-0018/000 | 0953208 |
| 16 | Hexagon socket screw M6X16 | DIN 912 | 0000942 |
| 17 | Hexagon socket screw M8X30 12.9 | DIN 912 | 0215502 |
| 18 | Dowel pin 4X18 | DIN 1481 | 0001587 |
| 19 | Washer 25-8.5 | WN 9-21-01 | 0121670 |
| 20 | C-rail, CF.92.42. 2000, length: 2000 mm, Messrs. IGUS | | 0954268 |
| 21 | Fillister head screw with hexagon socket M5X8 | | 0917695 |
| 25 | Carriage | 117--21-0001/000 | 0947164 |
| 26 | Hexagon socket screw M6X16 | DIN 912 | 0000942 |
| 27 | Hexagon socket screw M12X40 12.9 | DIN 912 | 0926715 |
| 28 | Headless set screw M 8X6 | DIN 913 | 0230729 |
| 29 | Headless set screw M8X8 | DIN 913 | 0001089 |
| 35 | Radial facing slide | 117--21-0002/000 | 0947160 |
| 36 | Hexagon socket screw dog point M10X45 | DIN 912 | 0280505 |
| 37 | Headless set screw M 8X6 | DIN 913 | 0230729 |
| 38 | Headless set screw M8X8 | DIN 913 | 0001089 |
| 40 | Roller guide, cross | 117--21-0011/000 | 0948981 |
| 41 | Hexagon socket screw M8X40 12.9 | DIN 912 | 0926496 |
| 43 | V-ledge for roller guide | 117--21-0021/001 | 0953044 |
| 44 | Hexagon socket screw M6X20 | DIN 912 | 0000943 |
| 45 | Holder for cable chain, longitudinal | 117--21-0035/000 | 0953070 |
| 46 | Hexagon socket screw M6X16 | DIN 912 | 0000942 |
| 47 | Hexagonal nut M6 | DIN 934 | 0001340 |
| 48 | Cable chain type 0650K; LS=845; BK=120; KR = 115, Messrs. KABELSCHLEPP | | 0953252 |
| 50 | Threaded ball spindle, cross 32X10, right | 117-07-0001/001 | 0953262 |
| 51 | Swivel screw connection 504 161 | | 1398101 |
| 52 | Hexagon socket screw M6X16 | DIN 912 | 0936490 |
| 53 | Hexagon socket screw M8X30 12.9 | DIN 912 | 0215502 |
| 54 | Radial shaft seal ring A 42X55X8 | DIN 3760 | 0903847 |
| 55 | Shaft nut KMT4 M20X1 Messrs. SKF | | 0953442 |
| 56 | Parallel roller bearing 2068 TN | | 0900288 |
| 57 | Seal ring 2068 Messrs. INA | | 0909657 |
| 58 | Coupling ROTEX - GS 24/28 98 SHA - GS 6.0 - DM 18X30 6.0 - DM 4 X 30, Messrs. KTR | | 0957621 |
| 60 | Buffer stop | 156--07-0011/000 | 0920620 |
| 65 | Bearing block | 117--07-0022/001 | 0953258 |
| 66 | Washer 13 | DIN 125 | 0000408 |
| 67 | Hexagon socket screw M10X35 | DIN 912 | 0000982 |
| 68 | Hexagon socket screw M12X100 | DIN 912 | 0001010 |
| 69 | Tapered pin with internal screw thread 10X50 | DIN 7978 | 0002119 |
| 70 | Washer 25-10.5 | WN 9-21-01 | 0119508 |
| 71 | AC servomotor MDD 093 A-N-020-N2L-110PA1, Messrs. INDRAMAT | | 0949449 |
| 75 | Bush | 117--07-0031/000 | 0953263 |
| 76 | Flange | 117--07-0035/000 | 0957624 |
| 77 | Hexagon socket screw M8X25 12.9 | DIN 912 | 0117697 |
| 78 | Straight pin 10M6X30 | DIN 7 | 0000109 |
| 90 | Turret for 12 fixed tools, assembly group 05..481.520, Messrs. SAUTER | 117--25-0002/006 | 0957423 |
| 90 | LH turret for 12 driven tools, assembly group 05.450.020 ID-NO. 081812, Messrs. SAUTER | | 0959093 |
| 91 | Hexagon socket screw M12X60 12.9 | DIN 912 | 0933348 |
| 92 | Hexagon cap screw M12X60 12.9 | DIN 931 | 0948688 |
| 95 | LH turret disk for 12 fixed tools, ID NO. 081272, Messrs. SAUTER | | 0957456 |
| 95 | LH turret disk for 12 driven tools, ID NO. 078763, Messrs. SAUTER | | 0947533 |
| 100 | Intermediate plate for SAUTER disk turret assembly group 020 fixed and driven tools | 117--25-0008/000 | 0948689 |
| 105 | Alignment plate | 117--25-0040/000 | 0948690 |
| 106 | Hexagon socket screw M8X25 | DIN 912 | 0000960 |
| 107 | Hexagon socket screw M8X30 | DIN 912 | 0000961 |
| 108 | Washer 8.4 | DIN 125 | 0000418 |

## 4.5 Longitudinal feed drive 1 (page 4-25)

Drawing ident. Nr. 0959011 (printed vertically at lower left: "0959011")

Figure: two views of the Z1 feed drive.
- Upper view: end view of the servo motor flange on the slant bed, showing pin (14), screws/washer (27/28) and a detail circle of the proximity detector mounting: bracket (25), proximity detector (26), clip (32), screw (33).
- Lower view: longitudinal section. From top: pillow block bearing (19) with screws (18) on intermediate plate (16)/(17) at the far end of the ball screw (1); ball screw nut flange area with screw (3) and detail circle (34, 30, 31: straight pin, flat-head screw, washer for the switch plate); buffer stop (9); Z1 axis bearing housing (10) with parallel roller bearing (5), seal set (6), shaft seal (4), screws (2), shaft nut (7), washer (23)/(13); coupling (8) inside flange (20) with bush (24), screws (21), straight pin (22), washer/screws (11/12); AC servomotor (15) at the bottom. Switch plate (29) runs alongside.

Callouts printed: 28/27, 14, 26, 32, 33, 25, 18, 19, 17, 16, 1, 3, 34, 30, 31, 9, 10, 22, 20, 12/11, 29, 6, 2, 5, 4, 23/13, 7, 8, 15, 24, 21.

## Page 4-26

(blank page)

### Feed drive 1, longitudinal, 117--07.02/001, Ident No. 0953444 (pages 4-27, 4-28)

| Pos. | Designation | Part No. / DIN No. | Ident No. |
|---|---|---|---|
| 1 | Ball screw spindle, longitudinal Z1 40X10 | 117-07-0010/001 | 0953261 |
| 2 | Hexagon socket screw M6X25 10.9 | DIN 912 | 0911386 |
| 3 | Hexagon socket screw M8X30 12.9 | DIN 912 | 0215502 |
| 4 | Radial shaft seal ring A 36X50X7 | DIN 3760 | 0926958 |
| 5 | Parallel roller bearing 2575 LTN, Messrs. INA | | 0926955 |
| 6 | Sealing set 2575, Messrs. INA | | 0909658 |
| 7 | Shaft nut KMT 5 M25X1.5, Messrs. SKF | | 0953443 |
| 8 | Coupling ROTEX - GS 24/28 98 SHA - GS 6.0 - DM 22X30 6.0 - DM 24X30, Messrs. KTR | | 0957622 |
| 9 | Buffer stop | 156--07-0011/000 | 0920620 |
| 10 | Z1 axis bearing | 117--07-0014/001 | 0953254 |
| 11 | Washer 10.5 | DIN 125 | 0000407 |
| 12 | Hexagon socket screw M10X30 | DIN 912 | 0000981 |
| 13 | Hexagon socket screw M12X40 | DIN 912 | 0001000 |
| 14 | Tapered pin with internal screw thread 10X50 | DIN 7978 | 0002119 |
| 15 | AC servomotor MDD 093 B-N-030-N2L-110PA0, Messrs. INDRAMAT | | 0949450 |
| 16 | Intermediate plate | 128--07-0015/000 | 0936690 |
| 17 | Hexagon socket screw M10X20 | DIN 912 | 0000979 |
| 18 | Hexagon socket screw M10X35 | DIN 912 | 0000982 |
| 19 | Pillow block bearing PSHE 30, Messrs. INA | | 0936745 |
| 20 | Flange | 117--07-0030/000 | 0957573 |
| 21 | Hexagon socket screw M8X25 12.9 | DIN 912 | 0117697 |
| 22 | Straight pin 10M6X30 | DIN 7 | 0000109 |
| 23 | Washer | 701910.1101-0600 | 0729571 |
| 24 | Bush | 117--07-0031/000 | 0953263 |
| 25 | Bracket | 117--13-0014/000 | 0957430 |
| 26 | Proximity detector BES516-325-S4-Y with plug connection | | 0251370 |
| 27 | Hexagon socket screw M6X16 | DIN 912 | 0000942 |
| 28 | Washer 6.4 | DIN 125 | 0000405 |
| 29 | Switch plate for compound slide rest Z1 | 117--13-0019/001 | 0957513 |
| 30 | Hexagon socket screw with flat head M8X35 | DIN 7984 | 0002217 |
| 31 | Washer 25-8.5 | WN 9-21-01 | 0121670 |
| 32 | Clip order no. 039.999989, BES 12.0-BS-1, Messrs. BALLUFF | | 0251661 |
| 33 | Hexagon socket screw M4X40 | DIN 912 | 0000927 |
| 34 | Straight pin 4M6X20 | DIN 7 | 0000060 |

---

## For the retrofit

Only what pages 4-1 to 4-28 (as present in PDF pages 1-20) say:

- **Axes and naming** (4-5): four linear axes, X1/Z1 on the left compound slide (item 7 "Compound slide X1/Z1"), X2 on "Slide X2" (item 8), Z2 as "Z2 axis feed motor and slide" (item 6). The figure on 4-4 puts the Z2 motor at the far right end of the bed; the bed carries a "roller guide, longitudinal for spindle motor base" (4-7 pos. 10), which suggests the right headstock moves on Z2 and the X2 slide has no Z of its own [uncertain: inferred from the drawing and legend, not stated in text]. If so, part transfer between the sides is done by moving the right spindle (Z2) toward the left spindle, so the two "independent" controllers must share Z2 position/handshake during transfer.
- **Two spindles** (4-5 item 2): "Integrated spindle motor, left and right"; each has a cooling circuit fed from the cooling unit in the supply cabinet (4-5 item 12). Motor data is in 4.3 (pages 4-9 to 4-16), which is not in PDF pages 1-20.
- **X1 (cross) drive** (4-21 to 4-23): ball screw "cross 32X10, right" (32 mm dia, 10 mm pitch, right-hand) (pos. 50); motor INDRAMAT AC servomotor MDD 093 A-N-020-N2L-110PA1 (pos. 71), via KTR ROTEX GS 24/28 98 SHA coupling, bores 18 x 30 / 4 x 30 [uncertain bore reading] (pos. 58). Roller guides for cross and longitudinal motion.
- **Z1 (longitudinal) drive** (4-27): ball screw "longitudinal Z1 40X10" (40 mm dia, 10 mm pitch) (pos. 1); motor INDRAMAT MDD 093 B-N-030-N2L-110PA0 (pos. 15), KTR ROTEX GS 24/28 coupling 22 x 30 / 24 x 30 (pos. 8); fixed bearing INA 2575 LTN at motor end, INA PSHE 30 pillow block at the far end.
- **Motors/encoders**: both are Indramat MDD 093 AC servomotors (ordinarily resolver-feedback motors for Indramat DDS/DKS drives; the pages do not describe the feedback, so check the motor plate before choosing stmbl feedback). The "A-N-020" vs "B-N-030" codes differ (rated speed 2000 vs 3000 min^-1 by Indramat convention [uncertain, not in manual]). No separate linear scales appear in these lists.
- **Limit/reference switches**: Balluff BES516-325-S4-Y inductive proximity switches with plug, on "bracket for proximity detectors X interrogation" (4-21 pos. 5, 10) reading a switch plate (pos. 15), and for Z1 (4-28 pos. 25, 26) reading "switch plate for compound slide rest Z1" (pos. 29). Mechanical stops: X stop (4-21 pos. 2), Stopp Z (4-7 pos. 3), buffer stops (4-7 pos. 4, 4-21 pos. 1, 60, 4-27 pos. 9).
- **Tool holder** (4-5 item 10, 4-23/4-24 pos. 90, 95): SAUTER 12-position disc turret, either "Turret for 12 fixed tools, assembly group 05..481.520" or "LH turret for 12 driven tools, assembly group 05.450.020 ID-NO. 081812". With driven tools, the tool is driven by a servo motor mounted on the tool holder (4-5). Indexing/clamping details are not on these pages (see 4.10/4.11 hydraulic plan and equipment list, pages 4-47/4-49).
- **Chucking** (4-5 items 9, 11): hydraulically actuated chucking cylinders with draw tube and chuck/collets left and right; foot switches for left and right clamping are inputs the control must handle (valves and pressure switches are in 4.15, not in these pages).
- **Supply cabinet** (4-5 item 12): switch cabinet, hydraulic unit, lubrication unit, spindle-motor cooling unit; plus optional chip conveyor (item 14). Details in 4.8-4.15 (later pages).
- **Cable chain** for X1/Z1: Kabelschlepp 0650K, LS=845, BK=120, KR=115, on IGUS C-rail 2000 mm (4-21 pos. 20, 4-22 pos. 48): relevant if motor/encoder cables are replaced.
