brdmaker/stmbl/docs/ctxtwin/manual/04b_assembly_p21-40.md

# Gildemeister CTX twin, 4. Assembly groups, PDF pages 21-40 (manual pages 4-29 to 4-48)

Source: `4_Assembly_groups_with_assembly_group_description_20201028_0001.pdf`, PDF pages 21-40 (scanned), "Mechanical technical documentation, CTX twin, Doc. No.: daaam0g1, February 1995", chapter 4 "Assembly groups with assembly group description".
Original language: English.

These pages contain the end of 4.6 (feed drive 2 longitudinal, Z2: drawing and parts list), 4.7 radial facing slide 2 (X2 cross slide with Sauter disk turret: two drawings and parts list), 4.8 pressure supply hydraulic plan, 4.9 pressure supply equipment list and 4.10 tool holder hydraulic plan with driven tools. Blank pages: 4-30, 4-34, 4-36, 4-38, 4-44, 4-46, 4-48.

Running page header on every page: "4. Assembly groups with assembly group description". Footer: "Mechanical technical documentation, CTX twin, Doc. No.: daaam0g1, February 1995, Page 4-xx".

---

## 4.6 Longitudinal feed drive 2

(Page 4-29. The contents list calls this section "Feed drive 2 longitudinal"; the page heading reads "4.6 Longitudinal feed drive 2".)

**Drawing ident. Nr. 0957982** (number also printed vertically at lower left of the drawing: "0957982").

Figure: two views of the Z2 feed drive.
- Upper view (longitudinal section along the ball screw, drawn vertically): AC servomotor (15) at the top, flange (20) with bush (24), coupling (8) inside the flange, axis bearing housing (10) with the drive-end bearing (detail circle: parallel roller bearing (5), sealing set (6), radial shaft seal ring (4), screws (2)), shaft nut (7), ball screw spindle (1) running down through the ball nut in the moveable spindle motor base (26), bearing at the far end: pillow block bearing (19) on intermediate plate (16) with screws (17), (18). Buffer stop (9) and buffer bar (RH stop) (25) at the motor end; switch plate for Z interrogation (45) on bracket (42) with screws (43), washers (44). Tapered pin (14) not in this view. Other callouts: (3) screw at the ball nut, (11)/(12) washer + screws M10 on motor flange, (13)/(23) screw M12 + washer, (21) screws M8 (flange), (22) straight pin.
- Lower view (cross section through the bed / headstock base, inclined): ball screw/motor seen end-on (square motor flange with four screws, tapered pin (14), screws/washers (40)/(41)); proximity detector assembly in detail circle at upper left: bracket (38), proximity detector (39), clip (46), screw (47); cable chain (36) running in C-rail (37); cable chain holder detail at lower left: (31) washer, (33) screw, (35) nut; detail at lower right: (34) screw, (32) washer, (30) holder for cable chain; detail at right: (27) screw M12X40, (28)/(29) headless set screws.

Callout numbers on the drawing: 1, 2, 3, 4, 5, 6, 7, 8, 9, 10, 11, 12, 13, 14, 15, 16, 17, 18, 19, 20, 21, 22, 23, 24, 25, 26, 27, 28, 29, 30, 31, 32, 33, 34, 35, 36, 37, 38, 39, 40, 41, 42, 43, 44, 45, 46, 47. No dimensions are printed on the drawing.

Page 4-30: (blank page)

### Parts list: Feed drive, longitudinal Z2 — 117--07.04/001 — Ident 0953445

(Pages 4-31 to 4-33. Supplier names printed as "Messrs. ..." are given in the Notes column.)

| Pos. | Designation | Part No. / DIN No. | Ident No. | Notes |
|---|---|---|---|---|
| 1 | Ball screw spindle, longitudinal Z2 40X10 | 117--07-0020/001 | 0953260 | |
| 2 | Hexagon socket screw M6X25 10.9 | DIN 912 | 0911386 | |
| 3 | Hexagon socket screw M8X30 12.9 | DIN 912 | 0215502 | |
| 4 | Radial shaft seal ring A 36X50X7 | DIN 3760 | 0926958 | |
| 5 | Parallel roller bearing 2575 LTN | | 0926955 | Messrs. INA |
| 6 | Sealing set 2575 | | 0909658 | Messrs. INA |
| 7 | Shaft nut KMT 5 M25X1.5 | | 0953443 | Messrs. SKF |
| 8 | Coupling ROTEX - GS 24/28 98 SHA - GS 6.0 - DM 22X30 6.0 - DM 24X30 | | 0957622 | Messrs. KTR |
| 9 | Buffer stop | 156--07-0011/000 | 0920620 | |
| 10 | Axis bearing Z2 | 117--07-0021/001 | 0953256 | |
| 11 | Washer 10.5 | DIN 125 | 0000407 | |
| 12 | Hexagon socket screw M10X30 | DIN 912 | 0000981 | |
| 13 | Hexagon socket screw M12X40 | DIN 912 | 0001000 | |
| 14 | Tapered pin with internal screw thread 10X50 | DIN 7978 | 0002119 | |
| 15 | AC servomotor MDD 093 B-N-030-N2L-110PA0 | | 0949450 | Messrs. INDRAMAT |
| 16 | Intermediate plate | 128--07-0015/000 | 0936690 | |
| 17 | Hexagon socket screw M10X20 | DIN 912 | 0000979 | |
| 18 | Hexagon socket screw M10X40 | DIN 912 | 0000983 | |
| 19 | Pillow block bearing PSHE 30 | | 0936745 | Messrs. INA |
| 20 | Flange | 117--07-0030/000 | 0957573 | |
| 21 | Hexagon socket screw M8X25 12.9 | DIN 912 | 0117697 | |
| 22 | Straight pin 10M6X30 | DIN 7 | 0000109 | |
| 23 | Washer | 701910.1101-0600 | 0729571 | |
| 24 | Bush | 117--07-0031/000 | 0953263 | |
| 25 | Buffer bar (RH stop) | 117--13-0026/000 | 0953250 | |
| 26 | Spindle motor base, moveable | 117--11-0004/001 | 0955143 | |
| 27 | Hexagon socket screw M12X40 12.9 | DIN 912 | 0926715 | |
| 28 | Headless set screw M8X6 | DIN 913 | 0230729 | |
| 29 | Headless set screw M8X8 | DIN 913 | 0001089 | |
| 30 | Holder for cable chain | 117--11-0060/000 | 0953177 | |
| 31 | Washer 6.4 | DIN 125 | 0000405 | |
| 32 | Washer 8.4 | DIN 125 | 0000418 | |
| 33 | Hexagon socket screw M6X16 | DIN 912 | 0000942 | |
| 34 | Hexagon socket screw M8X20 | DIN 912 | 0000959 | |
| 35 | Hexagonal nut M6 | DIN 934 | 0001340 | |
| 36 | Cable chain type 0650K; LK = 2015 (2205); BK = 210; KR = 300 | | 0953175 | Messrs. KABELSCHLEPP |
| 37 | C-rail, CF.92.42. 2000, length: 2000 mm | | 0954268 | Messrs. IGUS |
| 38 | Bracket | 117--13-0015/001 | 0953509 | |
| 39 | Proximity detector BES516-325-S4-Y with plug connection | | 0251370 | |
| 40 | Hexagon socket screw M8X25 | DIN 912 | 0000960 | |
| 41 | Washer 8.4 | DIN 125 | 0000418 | |
| 42 | Bracket | 117--13-0017/000 | 0953505 | |
| 43 | Hexagon socket screw M8X20 | DIN 912 | 0000959 | |
| 44 | Washer 25-8.5 | WN 9-21-01 | 0121670 | |
| 45 | Switch plate f. Z interrogation 2 | 117--13-0018/001 | 0953511 | |
| 46 | Clip order no. 039.999989 BES 12.0-BS-1 | | 0251661 | Messrs. BALLUFF |
| 47 | Hexagon socket screw M4X40 | DIN 912 | 0000927 | |

Page 4-34: (blank page)

---

## 4.7 Radial facing slide 2

**Drawing ident. Nr. 0957961 Page 1** (page 4-35; "09579611" printed vertically at lower left).

Figure: top view of the radial facing slide (X2 cross slide) on its base, ball screw and servomotor at the bottom of the view, roller guides of the cross slide, the cable chain (with C-rail) to the left. Callouts:
- top: (3)(5)(7), (2), (4)(6), (1), (31), (30), (48)(49) — buffer stop (1), washers/screws/nut of the C-rail fixing (3, 4, 5, 6, 7), X stop (30) with screws (31), V-ledge (48) with screws (49);
- left: (8) C-rail; (50) ball screw spindle; (23) dowel pin; (22)(24) washers; (10)(11)(13), (12)(14)(15) bracket for X proximity detectors with screws, clip and proximity detector; (20) switch plate; (60) buffer stop; (51) swivel screw connection;
- right/bottom: (53) screw; (70)(67) washer/screw at motor flange; (65) bearing block; (68)(66) screws/washers of bearing block.
No dimensions are printed on the drawing.

Page 4-36: (blank page)

### Radial facing slide 2 — Drawing ident. Nr. 0957961 Pg. 2

(Page 4-37; "09579612" printed vertically at lower left.)

Figure: section through the inclined cross slide with the disk turret (shown at upper right, turret disk with tool stations and a turret drive housing) mounted on the radial facing slide; servomotor (71) and the cable chain (43) in the lower left; detail above left of the drive-end bearing of the ball screw: (56) axial parallel roller bearing, (54) radial shaft seal ring, (55) shaft nut, (57) seal ring, (52) screws. Symbol near the turret labelled "DM" (driven tools [uncertain]). Callouts: 95, 90, 92, 100, 36, 35, 37/38, 91, 105, 108/107, 106, 69, 8, 21, 78/77, 42, 46, 45, 40, 41, 43, 71, 75, 76, 58. An arrow at the right edge points out of the drawing [meaning not stated]. No dimensions are printed.

Page 4-38: (blank page)

### Parts list: Radial facing slide 2 — 117--21.10/000 — Ident 0953136

(Pages 4-39 to 4-42. Position numbers not listed are missing in the original, e.g. 2, 9, 16-19, 22, 25-29.)

| Pos. | Designation | Part No. / DIN No. | Ident No. | Notes |
|---|---|---|---|---|
| 1 | Buffer stop | 156--07-0011/000 | 0920620 | |
| 3 | Washer 6.4 | DIN 125 | 0000405 | |
| 4 | Washer 8.4 | DIN 125 | 0000406 | (ident printed 0000406; Z2 list uses 0000418 for Washer 8.4) |
| 5 | Hexagon socket screw M6X30 | DIN 912 | 0000945 | |
| 6 | Hexagon socket screw M8X20 | DIN 912 | 0000959 | |
| 7 | Hexagonal nut M6 | DIN 934 | 0001340 | |
| 8 | C-rail, CF.92.42.2000, length: 2000 mm | | 0954268 | Messrs. IGUS |
| 10 | Bracket for proximity detectors X interrogation | 117--13-0015/000 | 0953207 | |
| 11 | Washer 6.4 | DIN 125 | 0000405 | |
| 12 | Hexagon socket screw M4X40 | DIN 912 | 0000927 | |
| 13 | Hexagon socket screw M6X16 | DIN 912 | 0000942 | |
| 14 | Clip for order no. 039.999989 BES 12.0-BS-1 | | 0251661 | Messrs. BALLUFF |
| 15 | Proximity detector BES516-325-S4-Y with plug connection | | 0251370 | |
| 20 | Switch plate | 117--13-0018/000 | 0953208 | |
| 21 | Hexagon socket screw M6X16 | DIN 912 | 0000942 | |
| 23 | Dowel pin 4X18 | DIN 1481 | 0001587 | |
| 24 | Washer 25-8.5 | WN 9-21-01 | 0121670 | |
| 30 | X stop | 117--13-0060/000 | 0953209 | |
| 31 | Hexagon socket screw M12X40 12.9 | DIN 912 | 0926715 | |
| 35 | Radial facing slide | 117--21-0002/000 | 0947160 | |
| 36 | Hexagon socket screw dog point M10X45 | DIN 912 | 0280505 | |
| 37 | Headless set screw M8X6 | DIN 913 | 0230729 | |
| 38 | Headless set screw M8X8 | DIN 913 | 0001089 | |
| 40 | Base for radial facing slide 2 | 117--21-0004/000 | 0947614 | |
| 41 | Hexagon socket screw M6X16 | DIN 912 | 0000942 | |
| 42 | Hexagon socket screw M12X100 | DIN 912 | 0959458 | |
| 43 | Cable chain type 0650K; LS = 845; BK = 120; KR = 115 | | 0953252 | Messrs. KABELSCHLEPP |
| 45 | Roller guide, cross | 117--21-0011/000 | 0948981 | |
| 46 | Hexagon socket screw M8X40 12.9 | DIN 912 | 0926496 | |
| 48 | V-ledge for roller guide | 117--21-0021/001 | 0953044 | |
| 49 | Hexagon socket screw M6X20 | DIN 912 | 0000943 | |
| 50 | Ball screw spindle, cross 32X10, right | 117--07-0001/001 | 0953262 | |
| 51 | Swivel screw connection 504 161 | | 1398101 | |
| 52 | Hexagon socket screw M6X16 | DIN 912 | 0936490 | |
| 53 | Hexagon socket screw M8X30 12.9 | DIN 912 | 0215502 | |
| 54 | Radial shaft seal ring A 42X55X8 | DIN 3760 | 0903847 | |
| 55 | Shaft nut KMT4 M20X1 | | 0953442 | Messrs. SKF |
| 56 | Axial parallel roller bearing ZARF 2068 TN | | 0474058 | |
| 57 | Seal ring 2068 | | 0909657 | Messrs. INA |
| 58 | Coupling ROTEX - GS 24/28 98 SHA - GS 6.0 - DM 18X30 6.0 - DM 4 X 30 | | 0957621 | Messrs. KTR |
| 60 | Buffer stop | 156--07-0011/000 | 0920620 | |
| 65 | Bearing block | 117--07-0022/001 | 0953258 | |
| 66 | Washer 10.5 | DIN 125 | 0000407 | |
| 67 | Hexagon socket screw dog M10X35 | DIN 912 | 0000984 | |
| 68 | Hexagon socket screw M12X100 | DIN 912 | 0001010 | |
| 69 | Tapered pin with internal screw thread 10X50 | DIN 7978 | 0002119 | |
| 70 | Washer 25-10.5 | WN 9-21-01 | 0119508 | |
| 71 | AC servomotor MDD 093 A-N-020-N2L-110PA1 | | 0949449 | Messrs. INDRAMAT |
| 75 | Bush | 117--07-0031/000 | 0953263 | |
| 76 | Flange | 117--07-0035/000 | 0957624 | |
| 77 | Hexagon socket screw M8X25 12.9 | DIN 912 | 0117697 | |
| 78 | Straight pin 10M6X30 | DIN 7 | 0000109 | |
| 90 | RH turret for 12 fixed tools, assembly group 05.481.520 | 117--25-0002/005 | 0957389 | Messrs. SAUTER |
| 90 | RH turret for 12 driven tools, assembly group 05.450.020 ID-NO. 081972 | | 0959094 | Messrs. SAUTER |
| 91 | Hexagon socket screw M12X60 12.9 | DIN 912 | 0933348 | |
| 92 | Hexagon cap screw M12X60 12.9 | DIN 931 | 0948688 | |
| 95 | RH turret disk for 12 driven tools, ID NO. 078758 | | 0957455 | Messrs. SAUTER |
| 95 | RH turret disk for 12 fixed tools, ID NO. 081275 | | 0957457 | Messrs. SAUTER |
| 100 | Intermediate plate for SAUTER disk turret assembly group 020 fixed and driven tools | 117--25-0008/000 | 0948689 | |
| 105 | Alignment plate | 117--25-0040/000 | 0948690 | |
| 106 | Hexagon socket screw M8X25 | DIN 912 | 0000960 | |
| 107 | Hexagon socket screw M8X30 | DIN 912 | 0000961 | |
| 108 | Washer 8.4 | DIN 125 | 0000406 | |

(Pos. 90 and 95 each appear twice: alternative variants for fixed or driven tools.)

---

## 4.8 Pressure supply hydraulic plan

(Page 4-43.)

Title block: Function "Pressure supply"; Drawing No. 117--18-0001/000; Pg. 1; Ident. No. 0957236.

Figure: hydraulic schematic of the central pressure supply unit. Components (boxed position numbers, see 4.9):
- [1.0] tank, V = 100 l; [1.1] filling and venting filter (drawn at the tank).
- [2] pump unit: [2.0] adjustable vane pump (variable-displacement symbol) driven via coupling [2.1] by motor [2.2] (label "M 0901" [uncertain; printed like "H 0901" / "M 0901"]); [2.21] pump carrier; [2.3] pressure hose NW 13 from pump to filter.
- [3] line filter G 1/2 with [3.1] cartridge, "10 µm", "β10 ≥ 75", with clogging indicator switch labelled "F 09061" [uncertain digits]; [4] non-return valve after the filter; [8] hose NW 10 to the main pressure line.
- [5] pressure gauge (in dashed box, marked *) "only for machines without selector switch").
- [45.1] measuring hose NW 4 to [6.1] pressure switch, labelled "F 09051" [uncertain digits], setting range "p=5-60 bar".
- [60] accumulator: V0 = 2 l, p0 = 55 bar.
- [61] pressure limiting valve between the pressure line d and the return line e.
- [12] return-line filter with switch labelled "F xxxx" (as printed).
- [11] filling/breather element on the tank (drawn as filter symbol with vent) [uncertain].
- [30] leak oil hose to port L.
- Outlet ports: P1, T1, P2, T2, P3, T3 and L (leak oil); tank return lines T1, T2, L marked at the tank.

Pump data box:

| Item | Value |
|---|---|
| Q | 19 l/min **) |
| p | 70 bar |
| n | 1450 1/min |
| P | 2.2 kW S1 |
| Voltage | 230/400 V 50 Hz |

Pipe lines (letters used on the line segments of the drawing):

| Line | Size |
|---|---|
| a | 6x1 |
| b | 8x1 |
| c | 10x1 |
| d | 12x1 |
| e | 15x1.5 |
| f | 18x1.5 |

Footnotes: *) only for machines without selector switch. **) Theoretical supply rate.

Page 4-44: (blank page)

## 4.9 Pressure supply equipment list

(Page 4-45.)

| Pos. | Designation | Order number | Supplier | Ident. No. |
|---|---|---|---|---|
| 1.0 | Oil container V = 100 l | AB40-33/0100AN12ST/M | Rexroth | 0940044 |
| 1.1 | Filling and venting filter | ELF3-40-1/No.011023 | Rexroth | 0924335 |
| 1.2* | Level switch | | | |
| 2.0 | Vane pump adjustable | 1PV2V7-1X / 10RE01MC0-14A1 | Rexroth | 0953527 |
| 2.1 | Coupling comprising of: - Motor hub KB 28 - Internal sprocket 28 dia. - Pump hub KB 20 | AB33-20/KB 28-20/28 | Bowex | 0940036 |
| 2.2 | Motor | B3/B5-100L-2.2-1500 - 230/400-50 IP54 | neutral | 0925096 |
| 2.21 | Pump carrier | AB33-32/A250/0-V7/16 | Rexroth | 0953529 |
| 2.3 | High pressure hose | 3TE NW 13x750 DKOL/DKOL | Techno-Chemie | 0951214 |
| 3.0 | Line filter | LF BN/HC 110G 10C1.0/S0135 | Hydac | 0939619 |
| 3.1 | Spare cartridge | 0110 D 010 BN/HC | Hydac | 0939620 |
| 4.0 | Non-return valve | RHV 12-PLR-ED | Ermeto | 0932561 |
| 5.0 | Pressure gauge type 63/100 | AB31-10 No. 009234/6 | Rexroth | 1003969 |
| 6.1 | Pressure switch | HEG 8 0A 1X/100 K14 | Rexroth | 0959536 |
| 8.0 | High pressure hose NW10 | 3TE NW 10x350 DKOL/DKOL | Techno-Chemie | 0932726 |
| 30.0 | Leak oil hose | 30x5; PVC transparent | | 0102702 |
| 45.1 | Measuring hose | S100-CQ-CQ-0030 | Hydrotechnik | 0929503 |
| 60.0 | Accumulator | SB0 100-2.00E1/112A - 100AB | Rexroth | 0953532 |
| 61.0 | Pressure limiting valve | DBDS 6 G1X/80B | Rexroth | 0953533 |

\* Optional

(Handwritten tick marks next to 3.1 on the scan.)

Page 4-46: (blank page)

## 4.10 Tool holder hydraulic plan with driven tools

(Page 4-47.)

Title block: Function "Tool holder 1 + 2"; Drawing No. 117--18-0020/001; Pg. 1; Ident. No. 0959194.

Figure: two identical circuits, one per tool holder (turret), each with a double-acting cylinder (turret lock/release), two hoses per side and a valve stack on a common manifold [10] (supply line P, tank line T, ports A G 3/8 B per station).
- Tool holder 1 (left), "release/lock": cylinder direction arrows labelled WS 17-2 (release, left) and WS 17-1 (lock, right). Hoses [81.1] and [80.1] on one side, [81.2] and [80.1] (printed twice; second probably 80.2 [uncertain]) on the other.
- Tool holder 2 (right), "lock/release": arrows labelled WS 17-1 (lock, left) and WS 17-2 (release, right). Hoses [82.1] and [82.2].
- Each station: [13.0] pressure reducing valve set to "p= 50 bar" (P to the directional valve), [17.0] directional valve with solenoids "a" and "b" (double-solenoid, ports A, B, P, T), solenoids labelled below as WS 17-1 (left, a) and WS 17-2 (right, b).
- [10] manifold / connection plate (dash-dot outline across both stations).

Page 4-48: (blank page)

---

## For the retrofit

- **Z2 axis (longitudinal, side 2)**: ball screw 40X10 (40 mm dia., 10 mm pitch per designation "40X10") (p. 4-31, pos. 1), driven via KTR ROTEX GS 24 coupling (bores 22 / 24 mm) by an Indramat AC servomotor MDD 093 B-N-030-N2L-110PA0 (pos. 15). The Z2 axis moves the "spindle motor base, moveable" (pos. 26), i.e. on side 2 the headstock travels in Z (relevant for part transfer between the sides) (p. 4-32).
- **X2 axis (radial facing slide 2)**: ball screw "cross 32X10, right" (32 mm, 10 mm pitch, right-hand) (p. 4-40, pos. 50); Indramat MDD 093 A-N-020-N2L-110PA1 (pos. 71, p. 4-41); KTR ROTEX GS 24 coupling (pos. 58); roller guides on a V-ledge (pos. 45, 48).
- Motor/coupling ratio is direct (coupling, no belt shown) for both axes: 10 mm per motor revolution [inferred from the parts lists; no gear listed]. MDD motor type codes (feedback type is encoded by Indramat, not stated in these pages); no separate linear scales appear in either parts list.
- **Reference / limit sensing**: Balluff proximity detectors BES516-325-S4-Y with plug connection on switch plates: "Z interrogation 2" (Z2, p. 4-32/4-33, pos. 39, 45) and "X interrogation" (X2, p. 4-39, pos. 10, 15, 20). Mechanical end stops: buffer stops 156--07-0011/000 and RH buffer bar (Z2), X stop (X2).
- **Turret (tool holder 2)**: Sauter disk turret, RH, 12 stations; variants for 12 fixed tools (assembly group 05.481.520) or 12 driven tools (05.450.020, ID 081972) (p. 4-41). Turret indexing drive/sensors are not described on these pages.
- **Turret lock/release hydraulics** (p. 4-47): per tool holder one double-solenoid directional valve 17.0 with solenoids WS 17-1 (lock) and WS 17-2 (release), behind a 50 bar pressure reducing valve 13.0; both holders use the same solenoid names (one valve stack each). The control must switch lock/release around each index.
- **Hydraulic pressure supply** (p. 4-43/4-45): Rexroth 100 l unit, adjustable vane pump 1PV2V7, 2.2 kW 1450 rpm motor 230/400 V 50 Hz (motor label "M 0901" [uncertain]), 70 bar, 19 l/min theoretical; accumulator 2 l, precharge 55 bar; pressure limiting valve 61 DBDS 6 G1X/80B. Control inputs: pressure switch 6.1 Rexroth HEG 8 (range 5-60 bar, label "F 09051" [uncertain]), line filter clogging switch "F 09061" [uncertain], return filter switch "F xxxx", optional level switch 1.2. Outlets P1/T1, P2/T2, P3/T3 (likely one per consumer group, not stated).
- **Cable chains**: Z2 chain 0650K, LK = 2015 (2205), BK 210, KR 300 (p. 4-32); X2 chain 0650K, LS = 845, BK 120, KR 115 (p. 4-40) — length limits for new motor/encoder cables.
- Lubrication and part transfer are not covered on these pages (lubrication is in 4.12-4.14).
