brdmaker/stmbl/hwtest/hsm400u-sim/results.md

# hwtest/hsm400u-sim results

**hsm400u, servo 1 ms (1000 Hz)**

| program | status | geom max / p99 [um] | servo max / rms [um] | ferror [um] | rotary [arcsec] | I max [A] |
|---|---|---|---|---|---|---|
| rtcp | done | 11.7 / 4.2 | 11.7 / 2.73 | 31.8 | 26.7 | 5.80 |
| wline | done | 11.6 / 2.8 | 13.5 / 2.16 | 30.0 | 21.3 | 7.39 |
| circle | done | 12.6 / 4.9 | 15.9 / 2.09 | 21.9 | 14.6 | 5.65 |

**hsm400u, servo 0.5 ms (2000 Hz)**

| program | status | geom max / p99 [um] | servo max / rms [um] | ferror [um] | rotary [arcsec] | I max [A] |
|---|---|---|---|---|---|---|
| rtcp | done | 7.9 / 4.0 | 7.9 / 2.71 | 31.4 | 35.0 | 5.47 |
| wline | done | 7.7 / 3.0 | 9.1 / 2.14 | 27.2 | 36.1 | 7.08 |
| circle | done | 8.3 / 4.9 | 11.2 / 2.00 | 20.2 | 36.3 | 5.41 |

**hsm400u_blend, servo 1 ms (1000 Hz)**

| program | status | geom max / p99 [um] | servo max / rms [um] | ferror [um] | rotary [arcsec] | I max [A] |
|---|---|---|---|---|---|---|
| rtcp | done | 10.8 / 4.5 | 10.8 / 2.55 | 35.5 | 26.7 | 5.66 |
| wline | done | 10.6 / 2.0 | 12.6 / 1.27 | 32.6 | 21.5 | 7.38 |
| circle | done | 11.6 / 3.8 | 15.3 / 1.30 | 25.7 | 15.0 | 5.65 |

**hsm400u_blend, servo 0.5 ms (2000 Hz)**

| program | status | geom max / p99 [um] | servo max / rms [um] | ferror [um] | rotary [arcsec] | I max [A] |
|---|---|---|---|---|---|---|
| rtcp | done | 7.1 / 4.5 | 7.1 / 2.54 | 33.2 | 36.9 | 5.35 |
| wline | done | 6.5 / 2.1 | 8.1 / 1.24 | 28.5 | 36.8 | 7.02 |
| circle | done | 7.5 / 3.8 | 10.8 / 1.15 | 21.9 | 36.8 | 5.38 |
