brdmaker/stmbl/hardware/teststand/img/back.png

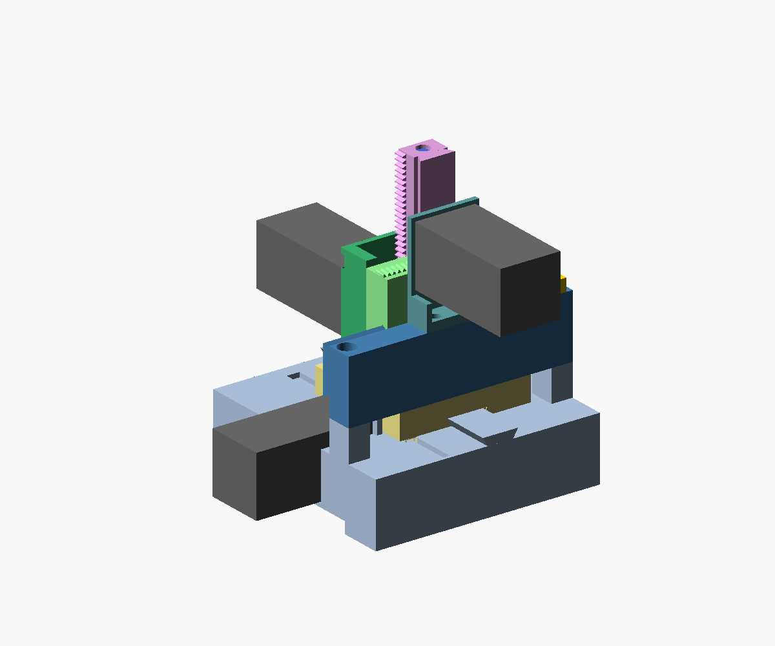
hardware/teststand/img/back.png
