brdmaker/stmbl/hardware/teststand/img/corner.png

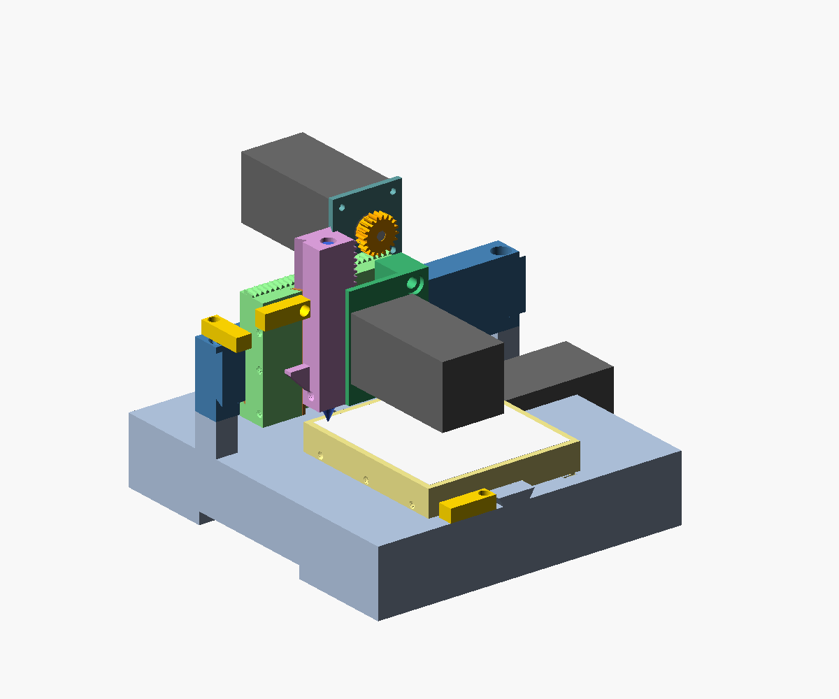
hardware/teststand/img/corner.png
