brdmaker/stmbl/hardware/teststand/img/front.png

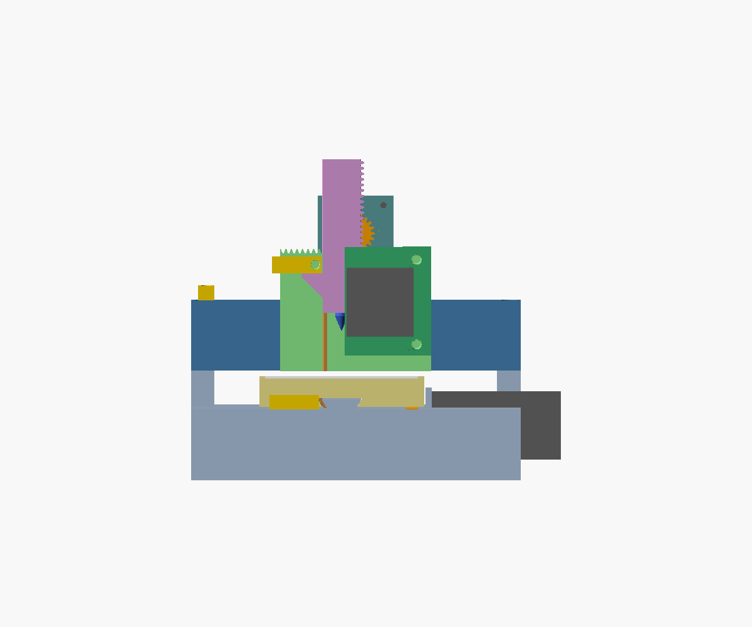
hardware/teststand/img/front.png
