brdmaker/stmbl/hardware/teststand/img/side.png

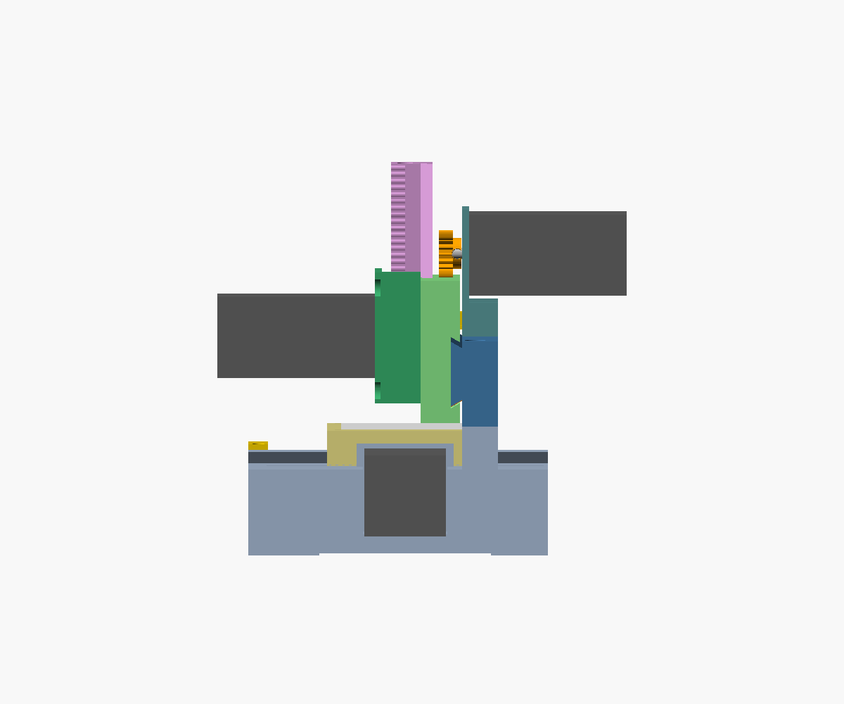
hardware/teststand/img/side.png
