brdmaker/stmbl/hardware/vibsensor/doc/vibsensor-schematic.pdf

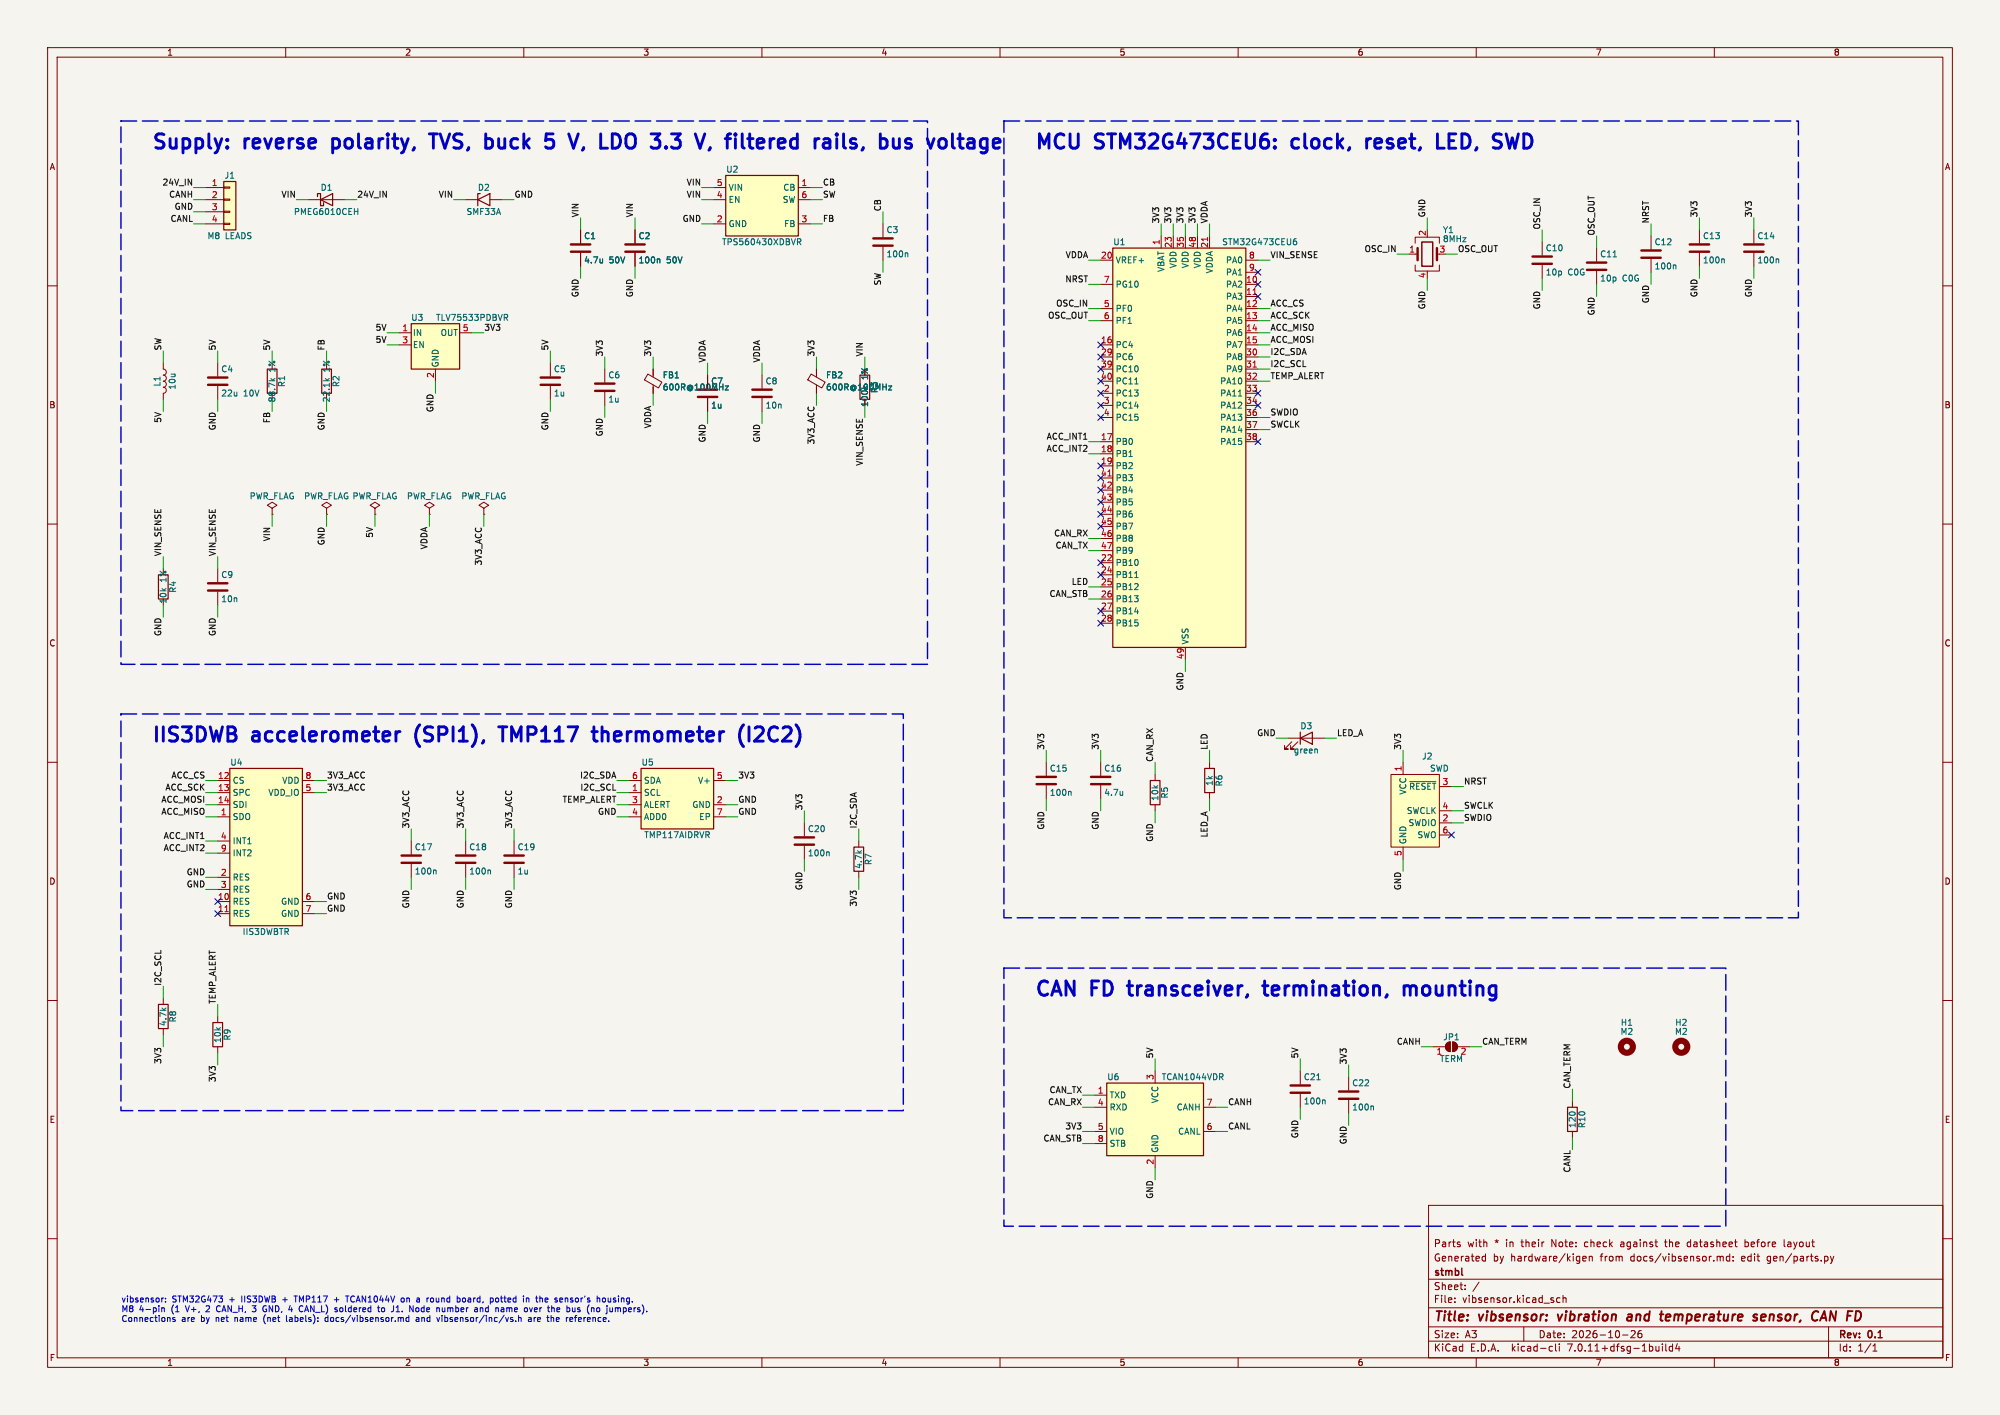
[picture p44: page 1]

Supply: reverse polarity, TVS, buck 5 V, LDO 3.3 V, filtered rails, bus voltage

1 PA2 10 PA3 11 PA4 12 PA5 13 PA6 14 PA7 15 PC4 16 PB0 17 PB1 18 PB2 19 PC13 2 VREF+ 20 VDDA 21 PB10 22 VDD 23 PB11 24 PB12 25 PB13 26 PB14 27 PB15 28 PC6 29 PC14 3 PA8 30 PA9 31 PA10 32 PA11 33 PA12 34 VDD 35 PA13 36 PA14 37 PA15 38 PC10 39 PC15 4 PC11 40 PB3 41 PB4 42 PB5 43 PB6 44 PB7 45 PB8 46 PB9 47 VDD 48 VSS 49 PF0 5 PF1 6 PG10 7 PA0 8 PA1 9 U1 STM32G473CEU6 C6

INT2 9 U4
SDO 1 RES 10 RES 11 CS 12 SPC 13 SDI 14 RES 2 RES 3

1 SWDIO 2 ~{RESET}3 SWCLK 4 GND

3 RXD 4 VIO 5 CANL 6 CANH 7 STB 8 U6 TCAN1044VDR
