brdmaker/stmbl/hardware/vibsensor/vibsensor.kicad_pcb

## KiCad design hardware/vibsensor/vibsensor.kicad_pcb (2026-10-26)

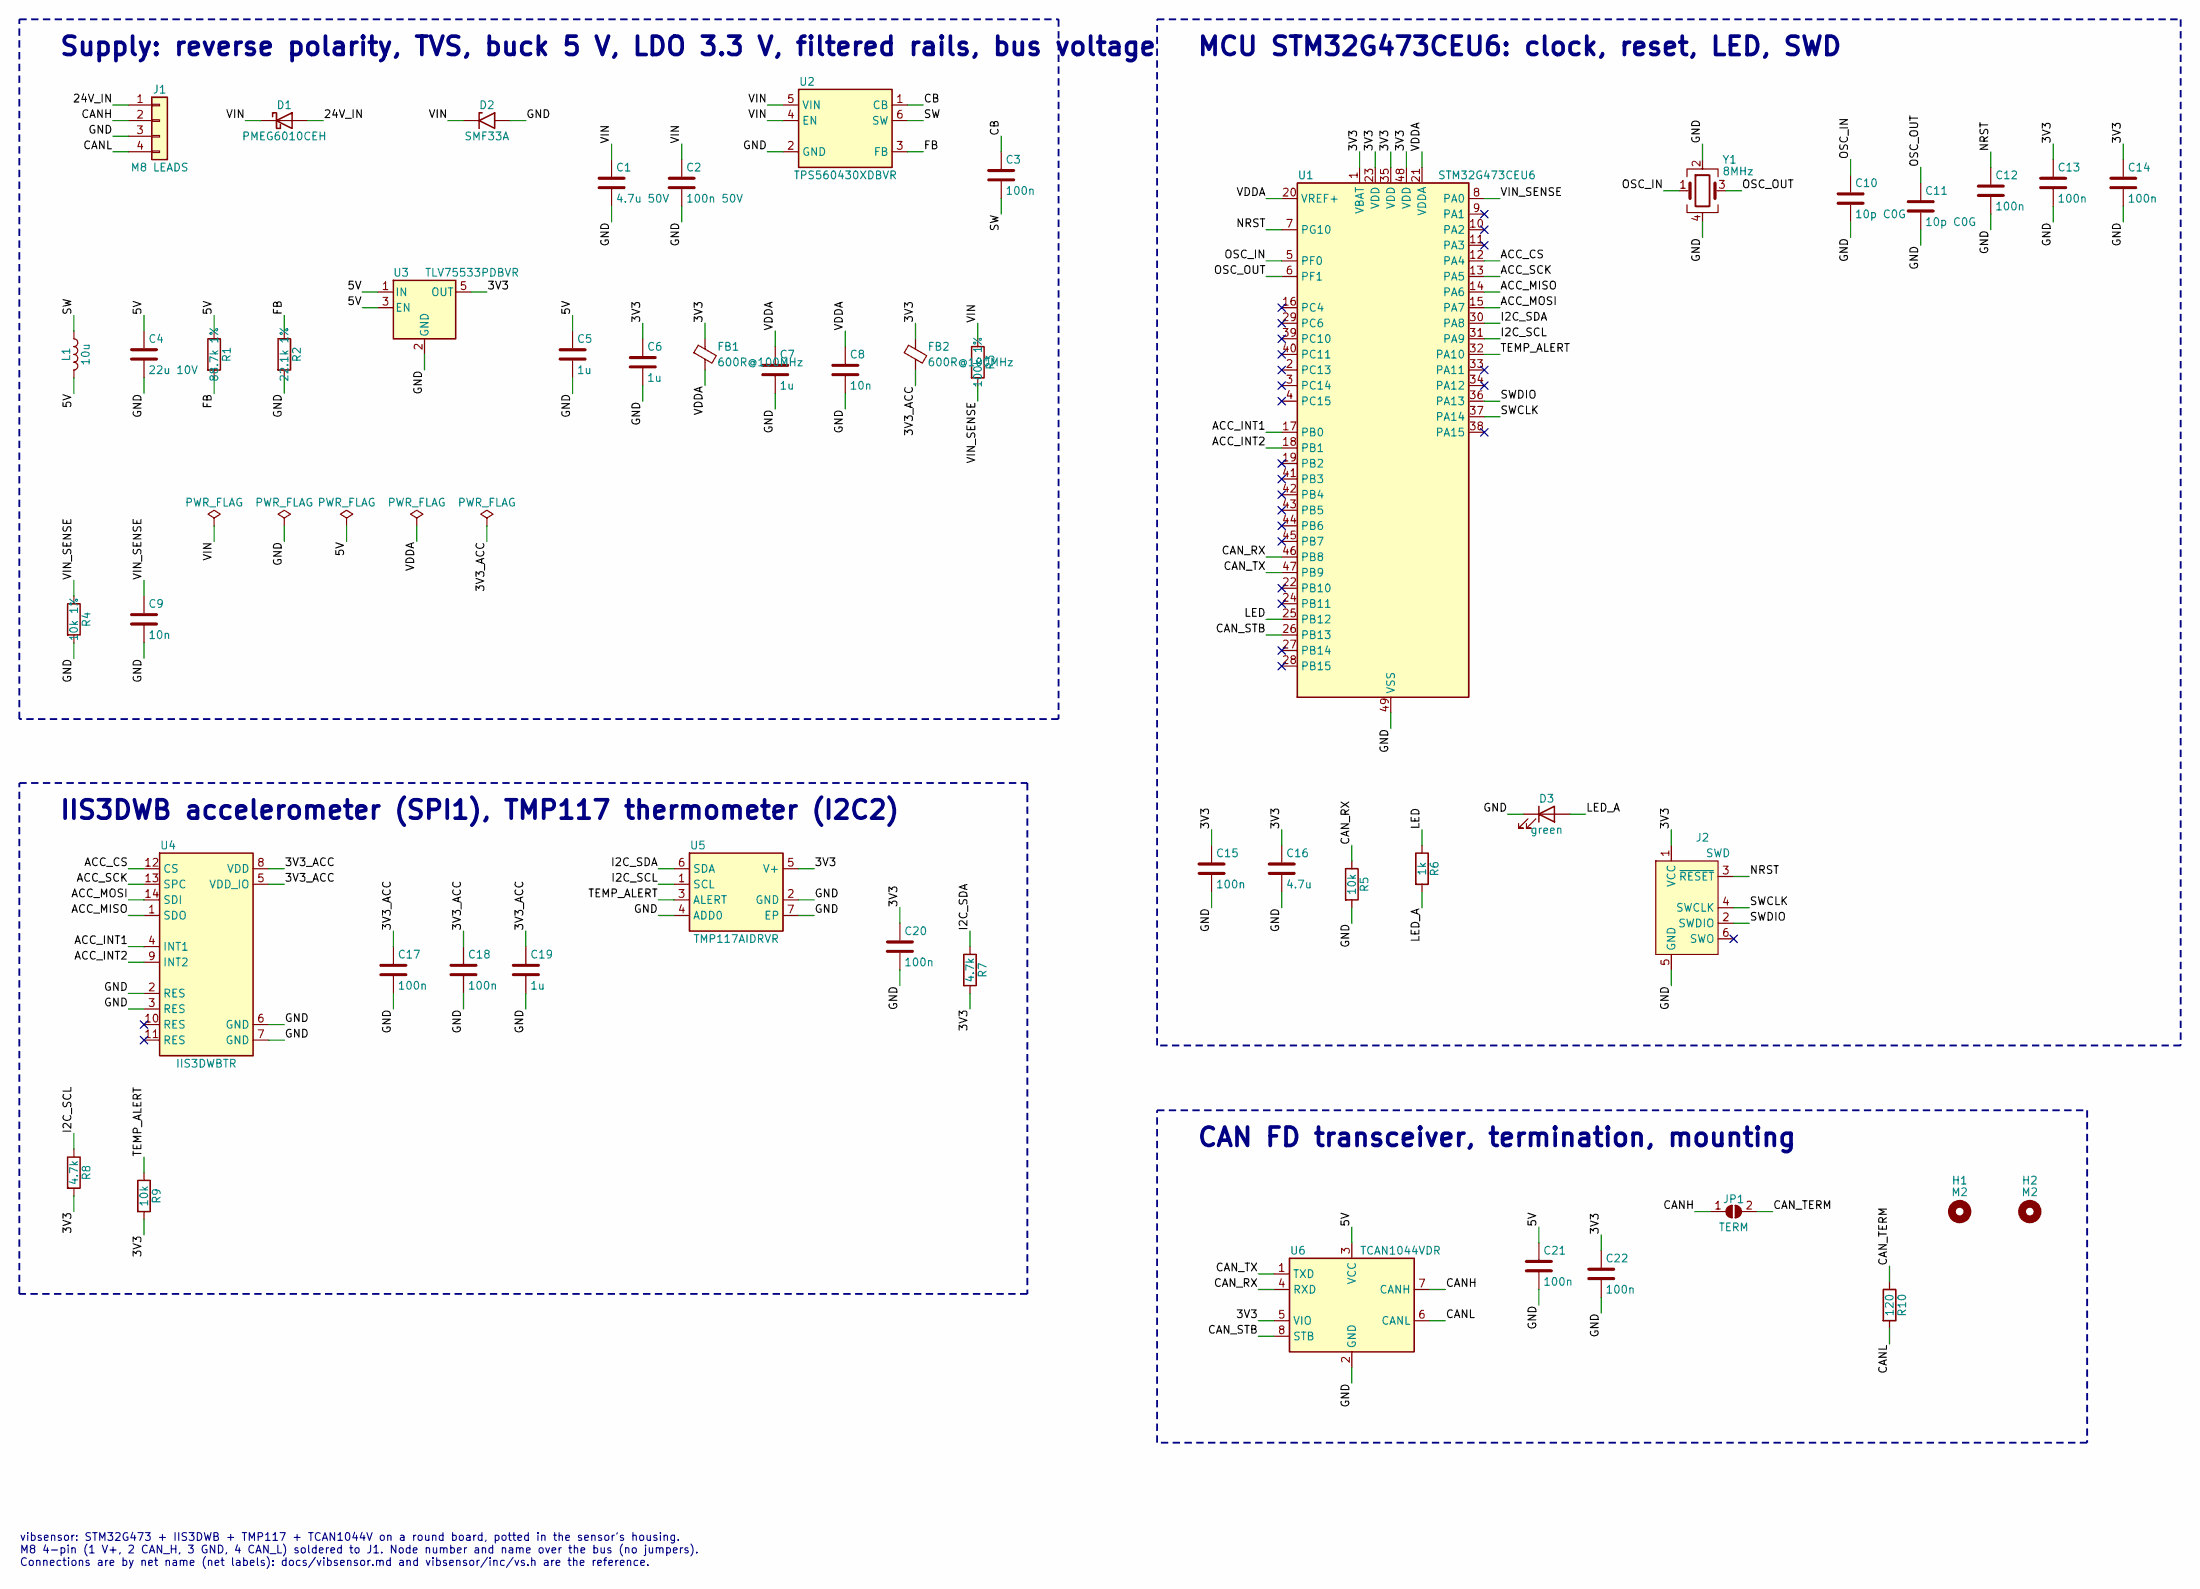
[picture p45: schematic vibsensor.kicad_sch, vibsensor: vibration and temperature sensor, CAN FD]

Parts:
C1: 4.7u 50V; C_1206_3216Metric
C2: 100n 50V; C_0402_1005Metric
C3, C12, C13, C14, C15, C17, C18, C20, C21, C22: 100n; C_0402_1005Metric
C4: 22u 10V; C_0805_2012Metric
C5, C6, C7, C19: 1u; C_0402_1005Metric
C8, C9: 10n; C_0402_1005Metric
C10, C11: 10p C0G; C_0402_1005Metric
C16: 4.7u; C_0603_1608Metric
D1: PMEG6010CEH; D_SOD-123F
D2: SMF33A; D_SMF
D3: green; LED_0603_1608Metric
FB1, FB2: 600R@100MHz; L_0402_1005Metric
H1, H2: M2; MountingHole_2.2mm_M2
J1: M8 LEADS; PinHeader_1x04_P2.00mm_Vertical
J2: SWD; Tag-Connect_TC2030-IDC-NL_2x03_P1.27mm_Vertical
JP1: TERM; SolderJumper-2_P1.3mm_Open_RoundedPad1.0x1.5mm
L1: 10u; L_Taiyo-Yuden_NR-30xx
R1: 88.7k 1%; R_0402_1005Metric
R2: 22.1k 1%; R_0402_1005Metric
R3: 100k 1%; R_0402_1005Metric
R4: 10k 1%; R_0402_1005Metric
R5, R9: 10k; R_0402_1005Metric
R6: 1k; R_0402_1005Metric
R7, R8: 4.7k; R_0402_1005Metric
R10: 120; R_0402_1005Metric
U1: STM32G473CEU6; QFN-48-1EP_7x7mm_P0.5mm_EP5.6x5.6mm
U2: TPS560430XDBVR; SOT-23-6
U3: TLV75533PDBVR; SOT-23-5
U4: IIS3DWBTR; LGA-14_3x2.5mm_P0.5mm_LayoutBorder3x4y
U5: TMP117AIDRVR; WSON-6-1EP_2x2mm_P0.65mm_EP1x1.6mm
U6: TCAN1044VDR; SOIC-8_3.9x4.9mm_P1.27mm
Y1: 8MHz; Crystal_SMD_2016-4Pin_2.0x1.6mm

Connections:
3V3: C6.1, C13.1, C14.1, C15.1, C16.1, C20.1, C22.1, FB1.1, FB2.1, J2.1 (VCC), R7.2, R8.2, R9.2, U1.1 (VBAT), U1.23 (VDD), U1.35 (VDD), U1.48 (VDD), U3.5 (OUT), U5.5 (V+), U6.5 (VIO)
3V3_ACC: C17.1, C18.1, C19.1, FB2.2, U4.5 (VDD_IO), U4.8 (VDD)
5V: C4.1, C5.1, C21.1, L1.2, R1.1, U3.1 (IN), U3.3 (EN), U6.3 (VCC)
24V_IN: D1.2 (A), J1.1; also elsewhere on the board
ACC_CS: U1.12 (PA4), U4.12 (CS)
ACC_INT1: U1.17 (PB0), U4.4 (INT1)
ACC_INT2: U1.18 (PB1), U4.9 (INT2)
ACC_MISO: U1.14 (PA6), U4.1 (SDO)
ACC_MOSI: U1.15 (PA7), U4.14 (SDI)
ACC_SCK: U1.13 (PA5), U4.13 (SPC)
CANH: J1.2, JP1.1 (A), U6.7 (CANH); also elsewhere on the board
CANL: J1.4, R10.2, U6.6 (CANL); also elsewhere on the board
CAN_RX: R5.1, U1.46 (PB8), U6.4 (RXD)
CAN_STB: U1.26 (PB13), U6.8 (STB)
CAN_TX: U1.47 (PB9), U6.1 (TXD)
CB: C3.1, U2.1 (CB)
FB: R1.2, R2.1, U2.3 (FB)
GND: C1.2, C2.2, C4.2, C5.2, C6.2, C7.2, C8.2, C9.2, C10.2, C11.2, C12.2, C13.2, C14.2, C15.2, C16.2, C17.2, C18.2, C19.2, C20.2, C21.2, C22.2, D2.2 (A2), D3.1 (K), J1.3, J2.5 (GND), R2.2, R4.2, R5.2, U1.49 (VSS), U2.2 (GND), U3.2 (GND), U4.2 (RES), U4.3 (RES), U4.6 (GND), U4.7 (GND), U5.2 (GND), U5.4 (ADD0), U5.7 (EP), U6.2 (GND), Y1.2, Y1.4; also elsewhere on the board
I2C_SCL: R8.1, U1.31 (PA9), U5.1 (SCL)
I2C_SDA: R7.1, U1.30 (PA8), U5.6 (SDA)
LED: R6.1, U1.25 (PB12)
LED_A: D3.2 (A), R6.2
NRST: C12.1, J2.3 (~RESET), U1.7 (PG10)
unnamed: JP1.2 (B), R10.1
OSC_IN: C10.1, U1.5 (PF0), Y1.1
OSC_OUT: C11.1, U1.6 (PF1), Y1.3
SW: C3.2, L1.1, U2.6 (SW)
SWCLK: J2.4 (SWCLK), U1.37 (PA14)
SWDIO: J2.2 (SWDIO), U1.36 (PA13)
TEMP_ALERT: R9.1, U1.32 (PA10), U5.3 (ALERT)
VDDA: C7.1, C8.1, FB1.2, U1.20 (VREF+), U1.21 (VDDA)
VIN: C1.1, C2.1, D1.1 (K), D2.1 (A1), R3.1, U2.4 (EN), U2.5 (VIN)
VIN_SENSE: C9.1, R3.2, R4.1, U1.8 (PA0)

Notes on the sheet:
Supply: reverse polarity, TVS, buck 5 V, LDO 3.3 V, filtered rails, bus voltage
MCU STM32G473CEU6: clock, reset, LED, SWD
IIS3DWB accelerometer (SPI1), TMP117 thermometer (I2C2)
CAN FD transceiver, termination, mounting
vibsensor: STM32G473 + IIS3DWB + TMP117 + TCAN1044V on a round board, potted in the sensor's housing. M8 4-pin (1 V+, 2 CAN_H, 3 GND, 4 CAN_L) soldered to J1. Node number and name over the bus (no jumpers). Connections are by net name (net labels): docs/vibsensor.md and vibsensor/inc/vs.h are the r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

Board: 4 copper layers, 49 parts (19 on the bottom side), 32 nets, no tracks yet.

Other parts of the board:
J3: M8 OUT; PinHeader_1x04_P2.00mm_Vertical

Their connections:
24V_IN: J3.1; also elsewhere on the board
CANH: J3.2; also elsewhere on the board
CANL: J3.4; also elsewhere on the board
GND: J3.3; also elsewhere on the board
