brdmaker/stmbl/hardware/brdstepper/brdstepper.kicad_pcb

## KiCad design hardware/brdstepper/brdstepper.kicad_pcb (2026-10-26)

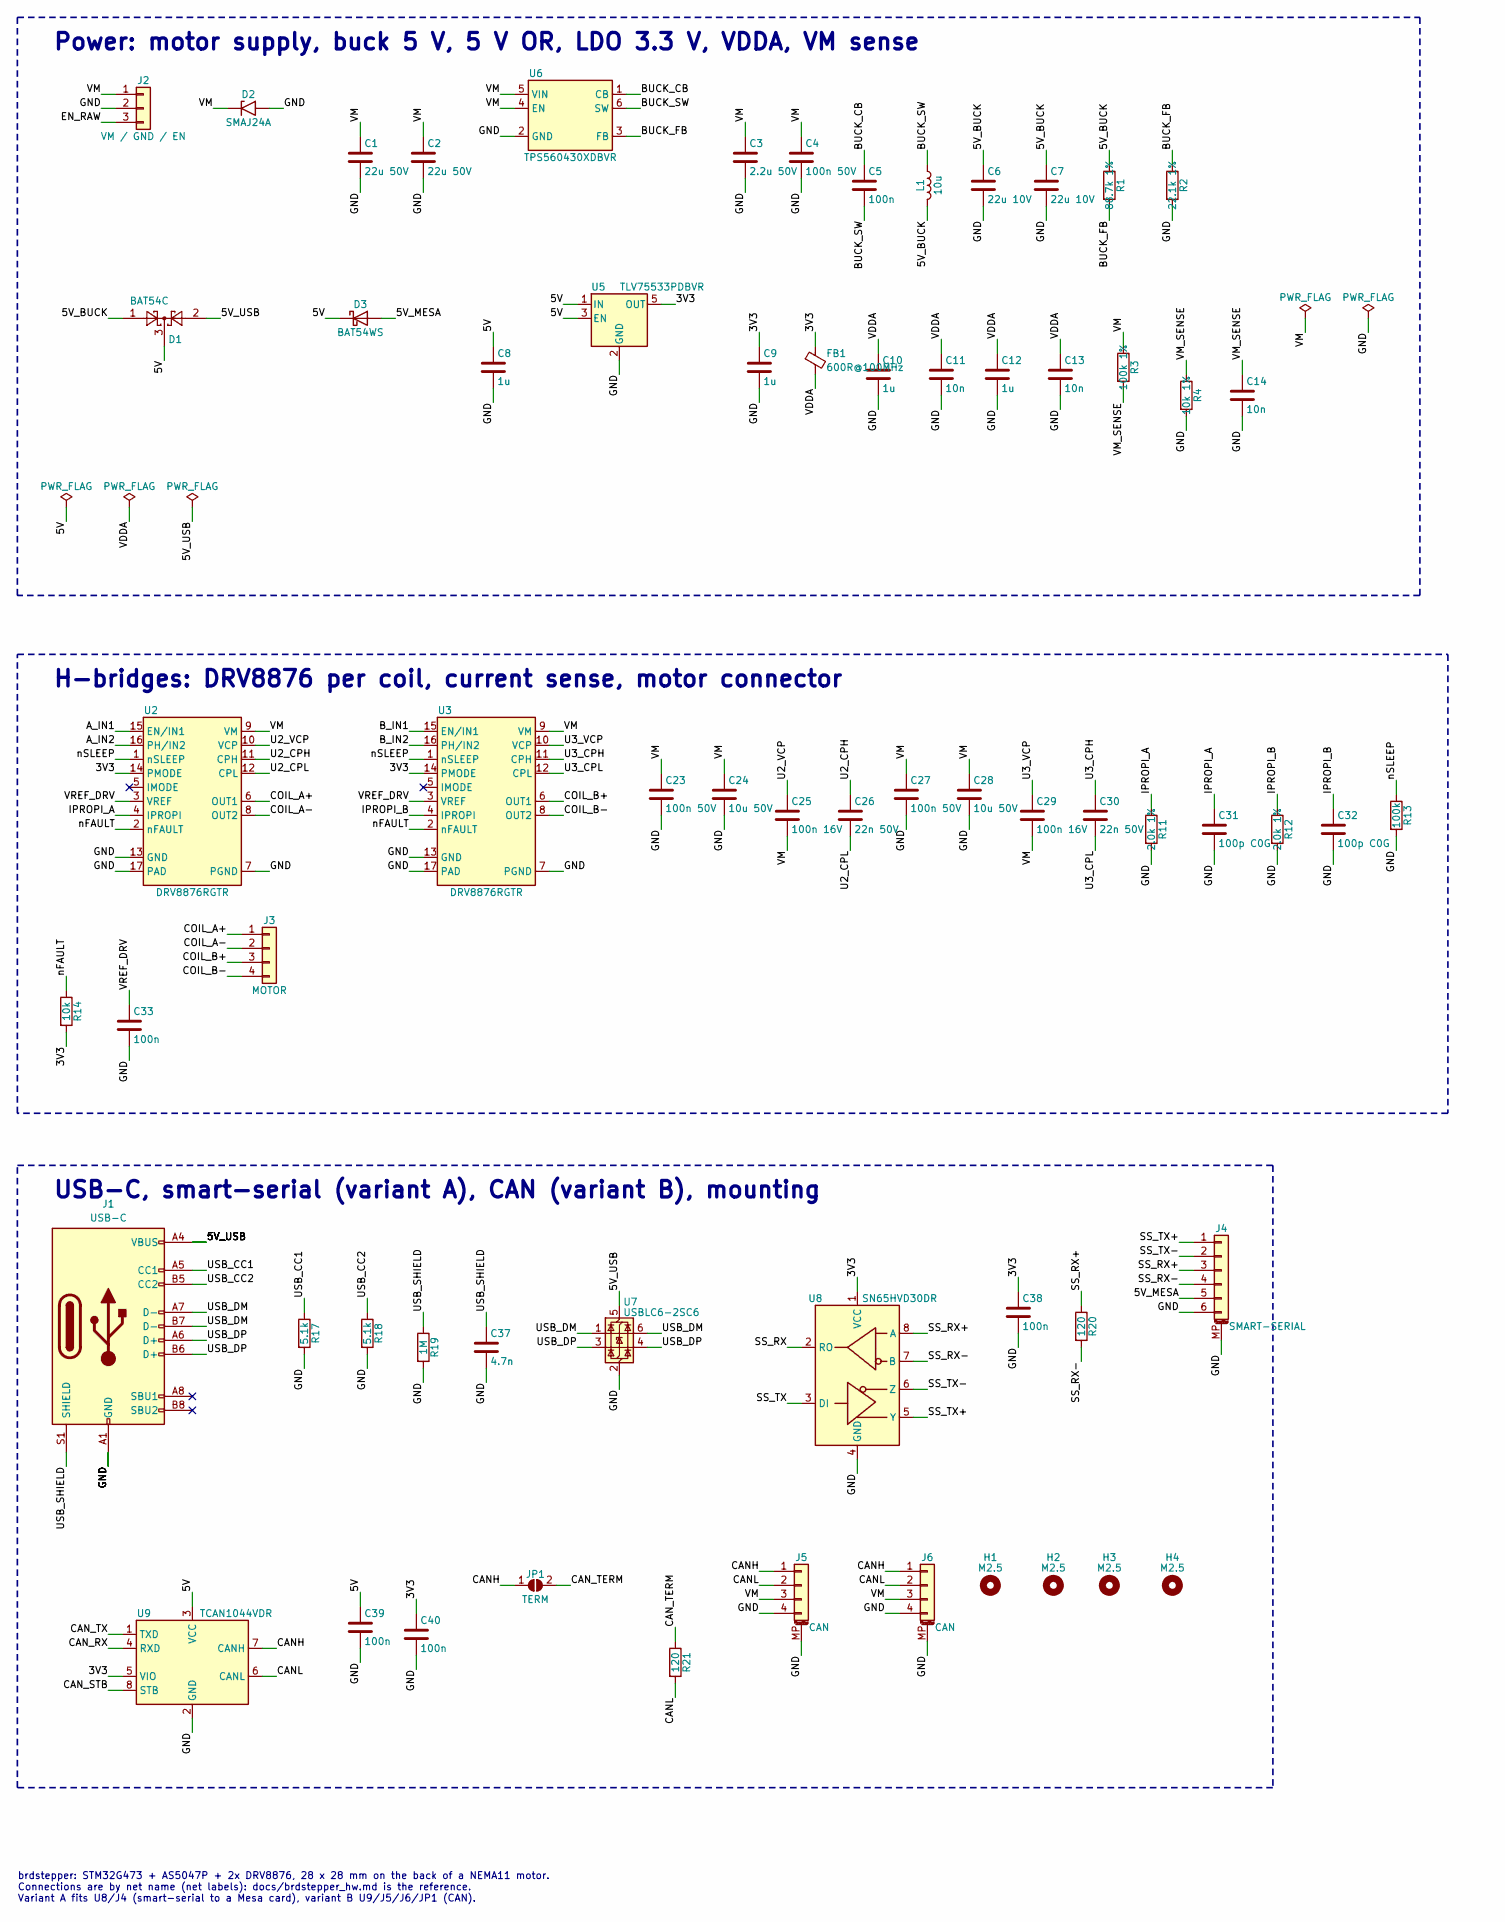
[picture p46: schematic brdstepper.kicad_sch, brdstepper: closed-loop NEMA11 stepper drive, part in row 1, column 1]

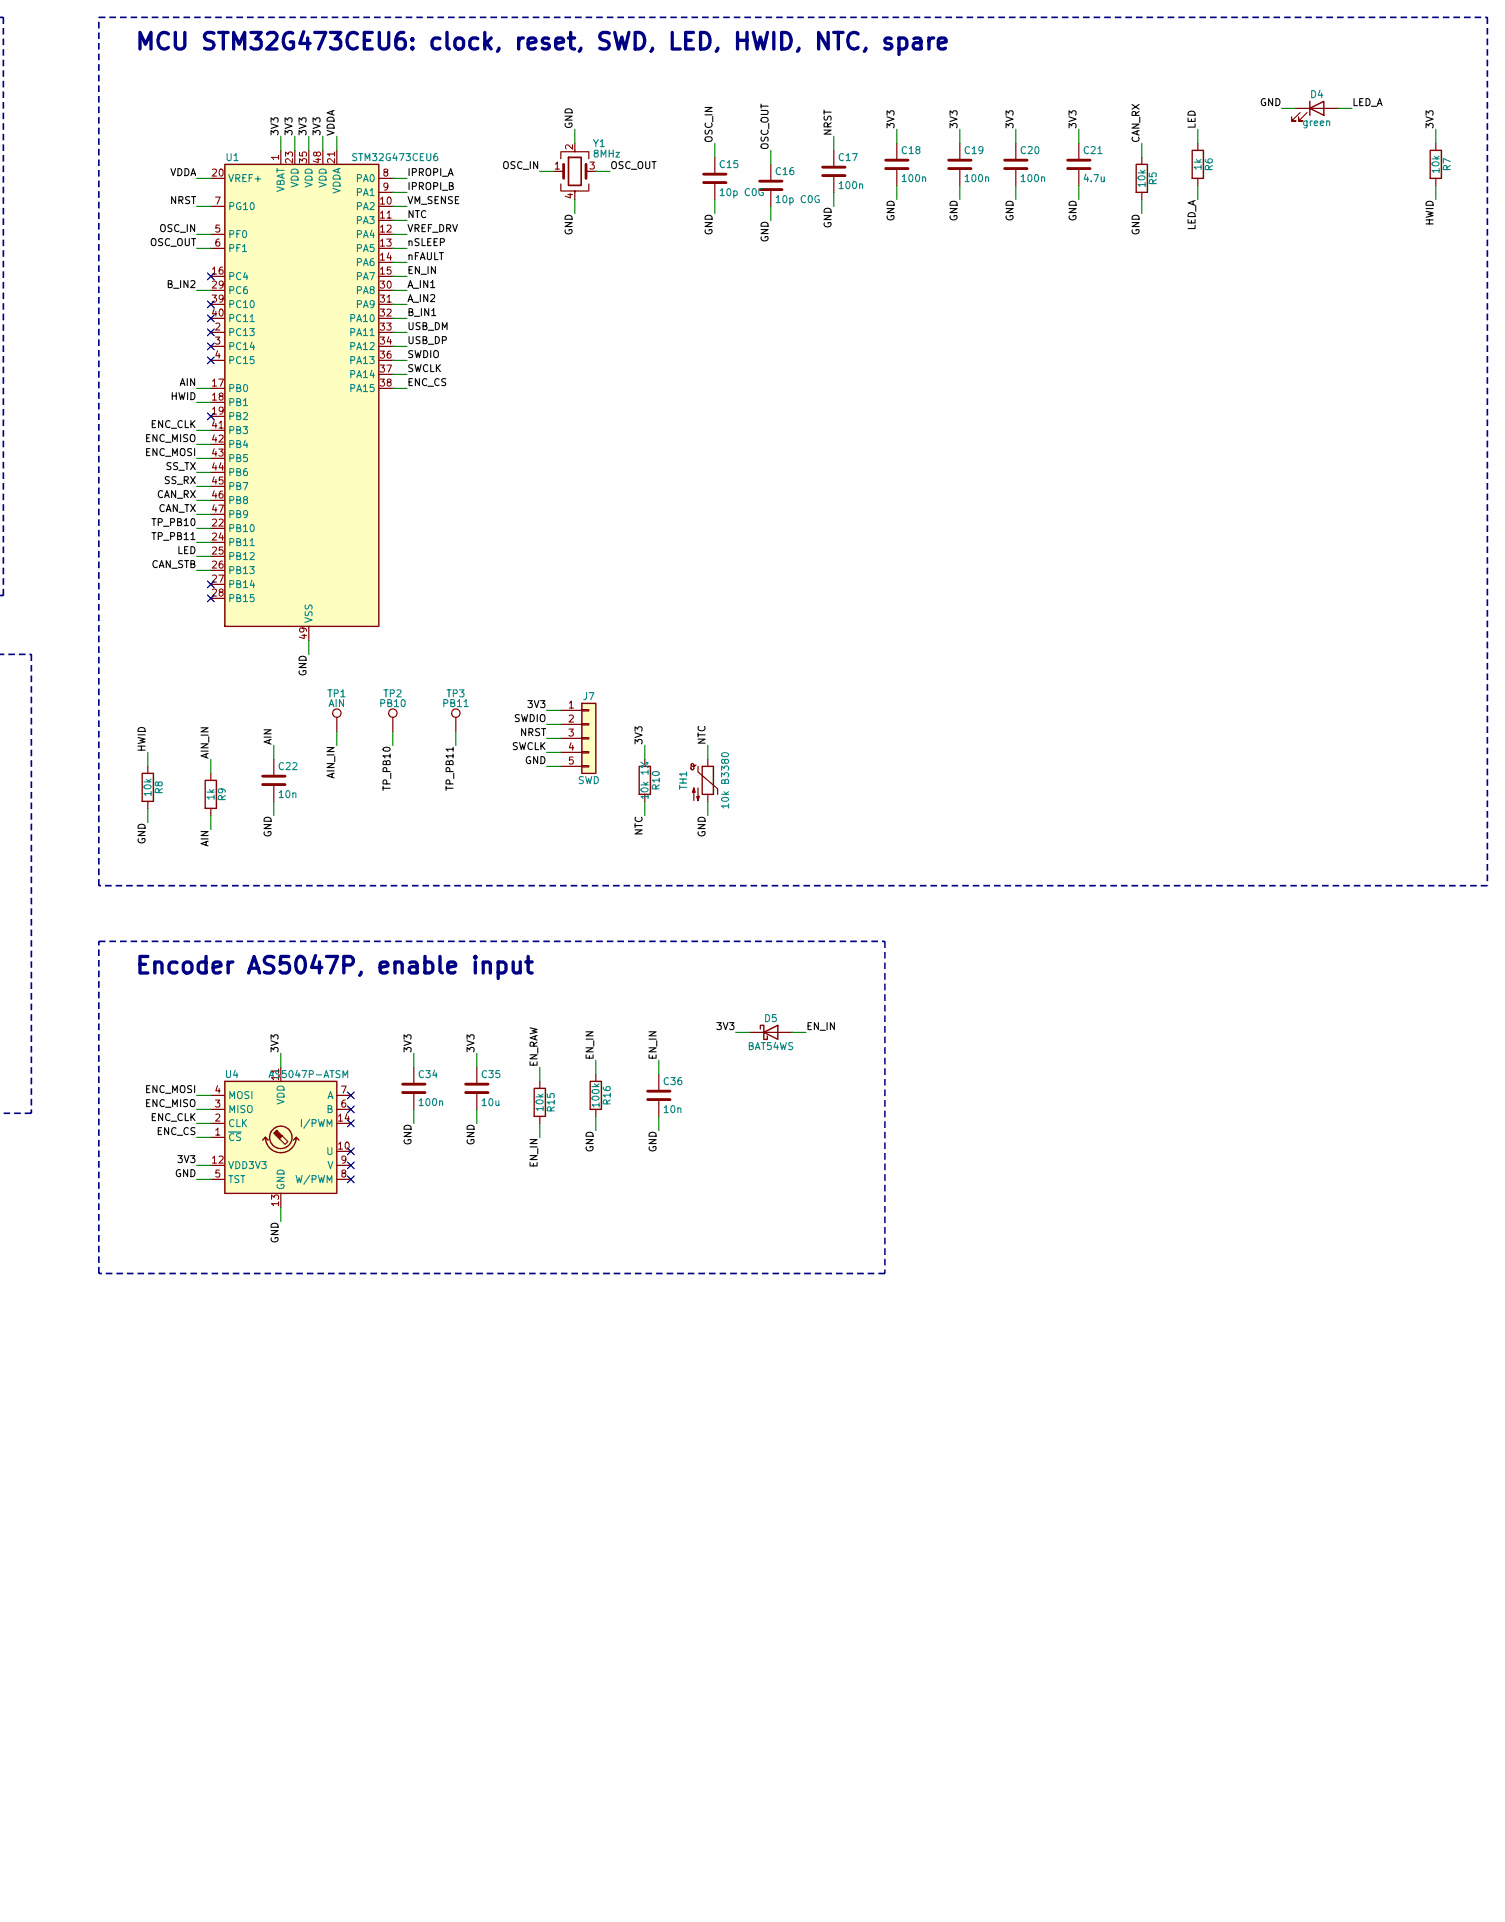
[picture p47: schematic brdstepper.kicad_sch, brdstepper: closed-loop NEMA11 stepper drive, part in row 1, column 2]

Parts:
C1, C2: 22u 50V; C_1210_3225Metric
C3: 2.2u 50V; C_1206_3216Metric
C4, C23, C27: 100n 50V; C_0402_1005Metric
C5, C17, C18, C19, C20, C33, C34, C38, C39, C40: 100n; C_0402_1005Metric
C6, C7: 22u 10V; C_0805_2012Metric
C8, C9, C10, C12: 1u; C_0402_1005Metric
C11, C13, C14, C22, C36: 10n; C_0402_1005Metric
C15, C16: 10p C0G; C_0402_1005Metric
C21: 4.7u; C_0603_1608Metric
C24, C28: 10u 50V; C_1206_3216Metric
C25, C29: 100n 16V; C_0402_1005Metric
C26, C30: 22n 50V; C_0402_1005Metric
C31, C32: 100p C0G; C_0402_1005Metric
C35: 10u; C_0603_1608Metric
C37: 4.7n; C_0402_1005Metric
D1: BAT54C; SOT-23
D2: SMAJ24A; D_SMA
D3, D5: BAT54WS; D_SOD-323
D4: green; LED_0603_1608Metric
FB1: 600R@100MHz; L_0603_1608Metric
H1, H2, H3, H4: M2.5; MountingHole_2.7mm_M2.5
J1: USB-C; USB_C_Receptacle_GCT_USB4105-xx-A_16P_TopMnt_Horizontal
J2: VM / GND / EN; JST_XH_B3B-XH-A_1x03_P2.50mm_Vertical
J3: MOTOR; PinHeader_1x04_P2.00mm_Vertical
J4: SMART-SERIAL; JST_GH_SM06B-GHS-TB_1x06-1MP_P1.25mm_Horizontal
J5, J6: CAN; JST_GH_SM04B-GHS-TB_1x04-1MP_P1.25mm_Horizontal
J7: SWD; PinHeader_1x05_P1.27mm_Vertical_SMD_Pin1Left
JP1: TERM; SolderJumper-2_P1.3mm_Open_RoundedPad1.0x1.5mm
L1: 10u; L_Taiyo-Yuden_NR-40xx
R1: 88.7k 1%; R_0402_1005Metric
R2: 22.1k 1%; R_0402_1005Metric
R3: 100k 1%; R_0402_1005Metric
R4, R10: 10k 1%; R_0402_1005Metric
R5, R7, R8, R14, R15: 10k; R_0402_1005Metric
R6, R9: 1k; R_0402_1005Metric
R11, R12: 2.0k 1%; R_0402_1005Metric
R13, R16: 100k; R_0402_1005Metric
R17, R18: 5.1k; R_0402_1005Metric
R19: 1M; R_0402_1005Metric
R20, R21: 120; R_0402_1005Metric
TH1: 10k B3380; R_0603_1608Metric
TP1: AIN; TestPoint_Pad_D1.0mm
TP2: PB10; TestPoint_Pad_D1.0mm
TP3: PB11; TestPoint_Pad_D1.0mm
U1: STM32G473CEU6; QFN-48-1EP_7x7mm_P0.5mm_EP5.6x5.6mm
U2, U3: DRV8876RGTR; VQFN-16-1EP_3x3mm_P0.5mm_EP1.68x1.68mm_ThermalVias
U4: AS5047P-ATSM; TSSOP-14_4.4x5mm_P0.65mm
U5: TLV75533PDBVR; SOT-23-5
U6: TPS560430XDBVR; SOT-23-6
U7: USBLC6-2SC6; SOT-23-6
U8: SN65HVD30DR; SOIC-8_3.9x4.9mm_P1.27mm
U9: TCAN1044VDR; SOIC-8_3.9x4.9mm_P1.27mm
Y1: 8MHz; Crystal_SMD_2016-4Pin_2.0x1.6mm

Connections:
3V3: C9.1, C18.1, C19.1, C20.1, C21.1, C34.1, C35.1, C38.1, C40.1, D5.1 (K), FB1.1, J7.1, R7.1, R10.1, R14.2, U1.1 (VBAT), U1.23 (VDD), U1.35 (VDD), U1.48 (VDD), U2.14 (PMODE), U3.14 (PMODE), U4.11 (VDD), U4.12 (VDD3V3), U5.5 (OUT), U8.1 (VCC), U9.5 (VIO)
5V: C8.1, C39.1, D1.3, D3.1 (K), U5.1 (IN), U5.3 (EN), U9.3 (VCC)
5V_BUCK: C6.1, C7.1, D1.1, L1.2, R1.1
5V_MESA: D3.2 (A), J4.5
5V_USB: D1.2, J1.A4 (VBUS), J1.A9 (VBUS), J1.B4 (VBUS), J1.B9 (VBUS), U7.5 (VBUS)
AIN: C22.1, R9.2, U1.17 (PB0)
AIN_IN: R9.1, TP1.1
A_IN1: U1.30 (PA8), U2.15 (EN/IN1)
A_IN2: U1.31 (PA9), U2.16 (PH/IN2)
BUCK_CB: C5.1, U6.1 (CB)
BUCK_FB: R1.2, R2.1, U6.3 (FB)
BUCK_SW: C5.2, L1.1, U6.6 (SW)
B_IN1: U1.32 (PA10), U3.15 (EN/IN1)
B_IN2: U1.29 (PC6), U3.16 (PH/IN2)
CANH: J5.1, J6.1, JP1.1 (A), U9.7 (CANH)
CANL: J5.2, J6.2, R21.2, U9.6 (CANL)
CAN_RX: R5.1, U1.46 (PB8), U9.4 (RXD)
CAN_STB: U1.26 (PB13), U9.8 (STB)
CAN_TERM: JP1.2 (B), R21.1
CAN_TX: U1.47 (PB9), U9.1 (TXD)
COIL_A+: J3.1, U2.6 (OUT1)
COIL_A-: J3.2, U2.8 (OUT2)
COIL_B+: J3.3, U3.6 (OUT1)
COIL_B-: J3.4, U3.8 (OUT2)
ENC_CLK: U1.41 (PB3), U4.2 (CLK)
ENC_CS: U1.38 (PA15), U4.1 (~CS)
ENC_MISO: U1.42 (PB4), U4.3 (MISO)
ENC_MOSI: U1.43 (PB5), U4.4 (MOSI)
EN_IN: C36.1, D5.2 (A), R15.2, R16.1, U1.15 (PA7)
EN_RAW: J2.3, R15.1
GND: C1.2, C2.2, C3.2, C4.2, C6.2, C7.2, C8.2, C9.2, C10.2, C11.2, C12.2, C13.2, C14.2, C15.2, C16.2, C17.2, C18.2, C19.2, C20.2, C21.2, C22.2, C23.2, C24.2, C27.2, C28.2, C31.2, C32.2, C33.2, C34.2, C35.2, C36.2, C37.2, C38.2, C39.2, C40.2, D2.2 (A2), D4.1 (K), J1.A1 (GND), J1.A12 (GND), J1.B1 (GND), J1.B12 (GND), J2.2, J4.6, J4.MP (MountPin), J5.4, J5.MP (MountPin), J6.4, J6.MP (MountPin), J7.5, R2.2, R4.2, R5.2, R8.2, R11.2, R12.2, R13.2, R16.2, R17.2, R18.2, R19.2, TH1.2, U1.49 (VSS), U2.7 (PGND), U2.13 (GND), U2.17 (PAD), U3.7 (PGND), U3.13 (GND), U3.17 (PAD), U4.5 (TST), U4.13 (GND), U5.2 (GND), U6.2 (GND), U7.2 (GND), U8.4 (GND), U9.2 (GND), Y1.2, Y1.4
HWID: R7.2, R8.1, U1.18 (PB1)
IPROPI_A: C31.1, R11.1, U1.8 (PA0), U2.4 (IPROPI)
IPROPI_B: C32.1, R12.1, U1.9 (PA1), U3.4 (IPROPI)
LED: R6.1, U1.25 (PB12)
LED_A: D4.2 (A), R6.2
NRST: C17.1, J7.3, U1.7 (PG10)
NTC: R10.2, TH1.1, U1.11 (PA3)
OSC_IN: C15.1, U1.5 (PF0), Y1.1
OSC_OUT: C16.1, U1.6 (PF1), Y1.3
SS_RX: U1.45 (PB7), U8.2 (RO)
SS_RX+: J4.3, R20.1, U8.8 (A)
SS_RX-: J4.4, R20.2, U8.7 (B)
SS_TX: U1.44 (PB6), U8.3 (DI)
SS_TX+: J4.1, U8.5 (Y)
SS_TX-: J4.2, U8.6 (Z)
SWCLK: J7.4, U1.37 (PA14)
SWDIO: J7.2, U1.36 (PA13)
TP_PB10: TP2.1, U1.22 (PB10)
TP_PB11: TP3.1, U1.24 (PB11)
U2_CPH: C26.1, U2.11 (CPH)
U2_CPL: C26.2, U2.12 (CPL)
U2_VCP: C25.1, U2.10 (VCP)
U3_CPH: C30.1, U3.11 (CPH)
U3_CPL: C30.2, U3.12 (CPL)
U3_VCP: C29.1, U3.10 (VCP)
USB_CC1: J1.A5 (CC1), R17.1
USB_CC2: J1.B5 (CC2), R18.1
USB_DM: J1.A7 (D-), J1.B7 (D-), U1.33 (PA11), U7.1 (I/O1), U7.6 (I/O1)
USB_DP: J1.A6 (D+), J1.B6 (D+), U1.34 (PA12), U7.3 (I/O2), U7.4 (I/O2)
USB_SHIELD: C37.1, J1.S1 (SHIELD), R19.1
VDDA: C10.1, C11.1, C12.1, C13.1, FB1.2, U1.20 (VREF+), U1.21 (VDDA)
VM: C1.1, C2.1, C3.1, C4.1, C23.1, C24.1, C25.2, C27.1, C28.1, C29.2, D2.1 (A1), J2.1, J5.3, J6.3, R3.1, U2.9 (VM), U3.9 (VM), U6.4 (EN), U6.5 (VIN)
VM_SENSE: C14.1, R3.2, R4.1, U1.10 (PA2)
VREF_DRV: C33.1, U1.12 (PA4), U2.3 (VREF), U3.3 (VREF)
nFAULT: R14.1, U1.14 (PA6), U2.2 (nFAULT), U3.2 (nFAULT)
nSLEEP: R13.1, U1.13 (PA5), U2.1 (nSLEEP), U3.1 (nSLEEP)

Notes on the sheet:
Power: motor supply, buck 5 V, 5 V OR, LDO 3.3 V, VDDA, VM sense
MCU STM32G473CEU6: clock, reset, SWD, LED, HWID, NTC, spare
H-bridges: DRV8876 per coil, current sense, motor connector
Encoder AS5047P, enable input
USB-C, smart-serial (variant A), CAN (variant B), mounting
brdstepper: STM32G473 + AS5047P + 2x DRV8876, 28 x 28 mm on the back of a NEMA11 motor. Connections are by net name (net labels): docs/brdstepper_hw.md is the reference. Variant A fits U8/J4 (smart-serial to a Mesa card), variant B U9/J5/J6/JP1 (CAN).

Board: 4 copper layers, 94 parts (50 on the bottom side), 67 nets, no tracks yet.
