brdmaker/stmbl/hardware/stman/stman.kicad_pcb

## KiCad design hardware/stman/stman.kicad_pcb (2026-11-02)

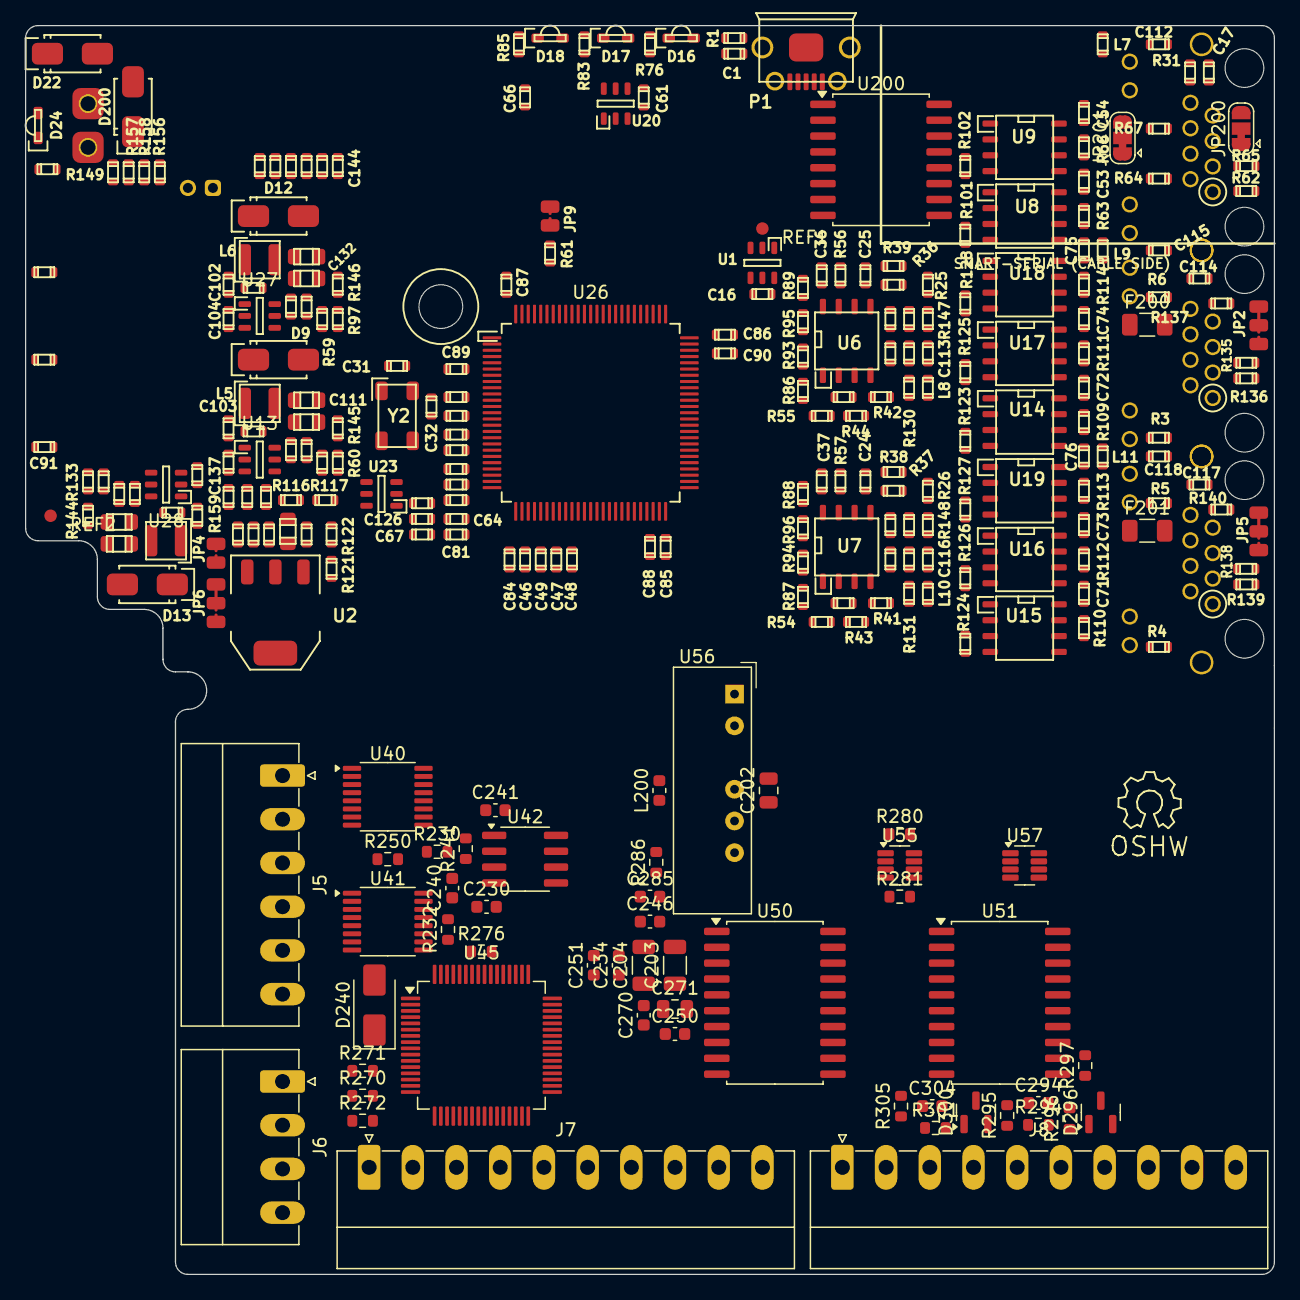
[picture p48: board stman.kicad_pcb from above]

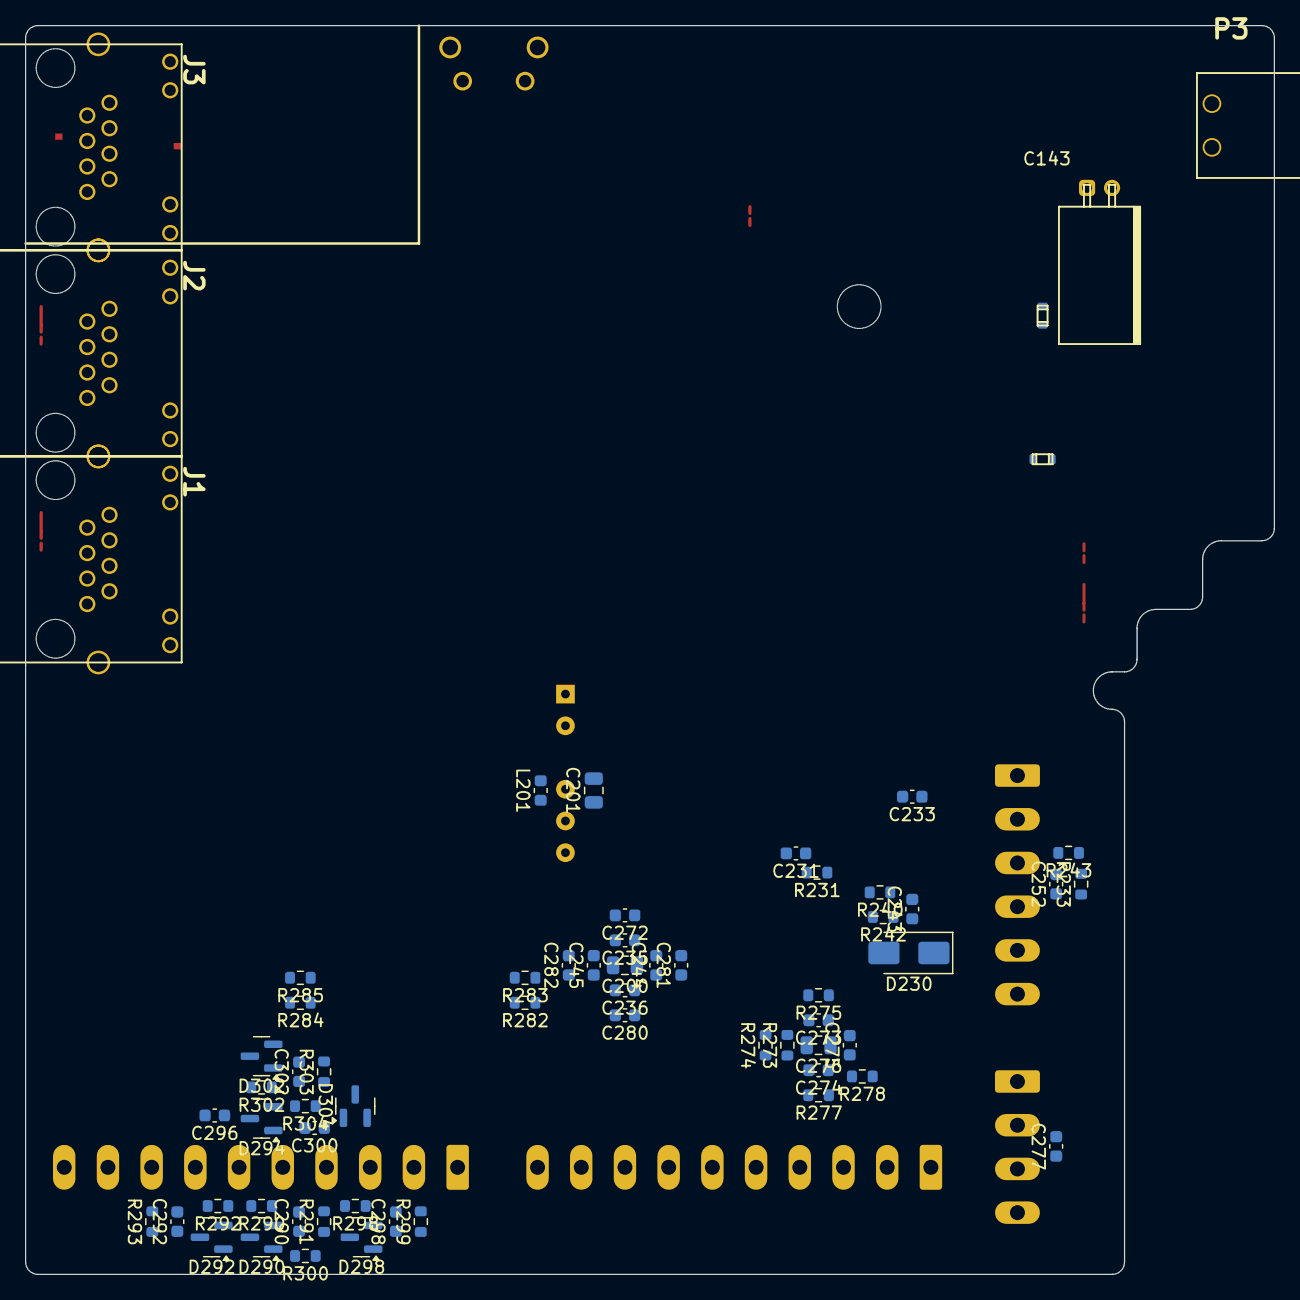
[picture p49: board stman.kicad_pcb from below]

Board: 4 copper layers, 100.0 x 100.0 mm, 341 parts (64 on the bottom side), 213 nets, no tracks yet.

Parts:
C1, C12, C13, C16, C17, C29, C36, C37, C53, C54, C61, C66, C67, C71, C72, C73, C74, C75, C76, C77, C80, C84, C85, C86, C87, C89, C91, C94, C95, C96, C99, C103, C104, C105, C106, C107, C108, C112, C113, C114, C115, C116, C117, C118, C119, C120, C121, C122, C125, C126: 100n; C_0603
C8, C18, C62, C65, C88, C90, C101, C102, C133, C134, C135, C136, C137, C139, C140, C142, C144: 2.2µ; C_0603
C24, C25, C26, C27, C31, C32: 18p; C_0603
C46, C47, C48, C49, C64, C81: 1n; C_0603
C109, C110, C111, C123, C124, C131, C132: 10µ; C_0805
C143: 22µ; C_Radial_D6.5_L11_P2.5
C200, C201, C202: 4.7u 25V; C_0805_2012Metric
C203, C204: 10u 25V; C_1206_3216Metric
C230, C240: 22n C0G; C_0603_1608Metric
C231, C241: 10n C0G; C_0603_1608Metric
C233, C234, C235, C236, C243, C244, C245, C246, C250, C251, C270, C272, C275, C282, C285: 100n; C_0603_1608Metric
C252, C277: 10n 100V; C_0603_1608Metric
C271, C276: 10u; C_0805_2012Metric
C273, C274: 1u; C_0603_1608Metric
C280, C281: 100n 50V; C_0603_1608Metric
C290, C292, C294, C296, C298, C300, C302, C304: 1n; C_0603_1608Metric
D9, D12, D13, D200: SS34A; SMA_Standard
D16: red; LED-0805-SIDE
D17: yellow; LED-0805-SIDE
D18, D24: green; LED-0805-SIDE
D22: SMAJ24A TVS 24V; SMA_Standard
D230, D240: SMAJ15CA; D_SMA
D290, D292, D294, D296, D298, D300, D302, D304: BAT54S; SOT-23
F200, F201: 0.5A hold; Fuse_1206_3216Metric
J1, J2, J3: RJ45_LED
J5: AO; PhoenixContact_MC_1,5_6-G-3.5_1x06_P3.50mm_Horizontal
J6: AI; PhoenixContact_MC_1,5_4-G-3.5_1x04_P3.50mm_Horizontal
J7: OUT; PhoenixContact_MC_1,5_10-G-3.5_1x10_P3.50mm_Horizontal
J8: IN; PhoenixContact_MC_1,5_10-G-3.5_1x10_P3.50mm_Horizontal
JP2, JP5, JP6: JUMPER3_NC; SOLDER_JUMPER_3_NC
JP4, JP9: Jumper_NO_Small; SOLDER_JUMPER
JP200: SS_P45 | SS_P78; SolderJumper-3_P1.3mm_Bridged12_RoundedPad1.0x1.5mm
JP201: SS_P78 | SS_P45; SolderJumper-3_P1.3mm_Bridged12_RoundedPad1.0x1.5mm
L3, L7, L8, L9, L10, L11: 220r 700mA; R_0603
L5, L12: 4.7µH 1.5A; SMD_INDUCTOR_32x25
L6: 10µH 1A; SMD_INDUCTOR_32x25
L200, L201: BLM18 ferrite; L_0603_1608Metric
LOGO1: OPEN_HARDWARE_1; Symbol_OSHW-Logo_SilkScreen
P1: USB_OTG; USB_Micro-B
P3: CONN_01X02; RM3.5_1x2
R1, R23, R24, R25, R26, R31, R109, R110, R111, R112, R113, R114, R130, R131: 120; R_0603
R3, R4, R5, R6, R76, R83, R85, R93, R94, R95, R96: 470; R_0603
R35: 6.98k; R_0603
R36, R37, R38, R39, R41, R42, R43, R44, R62, R64, R65, R67, R116, R135, R137, R138, R140, R155, R156, R157, R158: 10k; R_0603
R47, R48, R49, R50, R54, R55, R56, R57: 15k; R_0603
R59: 2.87k; R_0603
R60, R97, R133: 51k; R_0603
R61, R63, R66, R101, R102, R117, R121, R122, R123, R124, R125, R126, R127, R128, R136, R139, R145, R153: 1k; R_0603
R86, R87, R88, R89, R147, R148, R154, R159, R160: 22; R_0603
R132: 7.15k; R_0603
R144, R146, R149: 3.9k; R_0603
R212, R213: 100k; R_0603
R230, R231, R240, R241: 4.7k; R_0603_1608Metric
R232, R242: 100; R_0603_1608Metric
R233, R243: 10; R_0603_1608Metric
R250, R273, R274, R275, R276, R278, R280, R281, R282, R283, R284, R285, R286, R291, R293, R295, R297, R299, R301, R303, R305: 10k; R_0603_1608Metric
R270, R271, R272: 2.2k; R_0603_1608Metric
R277: 30k; R_0603_1608Metric
R290, R292, R294, R296, R298, R300, R302, R304: 47k; R_0603_1608Metric
REF1, REF2: Fiducial_1mm_Dia_2.54mm_Outer_CopperTop; Fiducial_1mm_Outer_CopperTop
U1, U20, U23: USBLC6-4SC6; SOT-23-6
U2: zldo1117; SOT-223
U6, U7: LM358; SOIC-8-N
U8, U9, U14, U15, U16, U17, U18, U19: SN65176B; SOIC-8-N
U13, U27, U28: LMR51420YDDCR; SOT-23-6
U26: STM32F405VG; LQFP-100_14x14mm_Pitch0.5mm
U32: non_plated; non_plated_3mm
U40, U41: AD5761RBRUZ; TSSOP-16_4.4x5mm_P0.65mm
U42: OPA2197IDR; SOIC-8_3.9x4.9mm_P1.27mm
U45: AD7606BSTZ; LQFP-64_10x10mm_P0.5mm
U50, U51: ITS724G; SOIC-20W_7.5x12.8mm_P1.27mm
U55: 74LVC2G08; SOT-23-8
U56: NMA1215SC; Converter_DCDC_Murata_NMAxxxxSC_THT
U57: MAX6369KA+T; SOT-23-8
U200: ISO7331FC; SOIC-16W_7.5x10.3mm_P1.27mm
Y2: 8M; Crystal_SMD_0503_4Pads

Connections:
+3V3: C16.2, C18.1, C67.1, C77.2, C80.2, C84.2, C85.2, C86.2, C87.2, C89.2, C99.1, C131.1, C236.1, C246.1, C272.1, C282.1, C285.1, D290.2, D292.2, D294.2, D296.2, D298.2, D300.2, D302.2, D304.2, JP6.3, JP9.1, L3.2, R250.1, R282.1, R283.1, R284.1, R285.1, R286.1, U1.5, U2.2, U23.5, U26.6, U26.11, U26.19, U26.28, U26.50, U26.75, U26.100, U40.7, U40.8, U41.7, U41.8, U45.6, U45.7, U45.8, U45.23, U45.34, U55.8, U57.4, U57.8, U200.1, U200.7
+5F: C115.2, C118.2, C122.1, C123.1, C124.1, C134.1, JP2.1, JP4.1, JP5.1, L9.1, L11.1, L12.2, R137.2, R140.2, R144.1
+5V: C8.1, C61.1, C66.1, C96.1, C107.1, C109.1, C111.1, C135.1, C270.1, C271.1, JP4.2, JP6.1, L5.2, R145.1, U2.3, U20.5, U45.1, U45.37, U45.38, U45.48
+5VA: C113.2, C116.2, JP6.2, L8.1, L10.1, R121.1
+12V: C108.1, C110.1, C132.1, C136.1, C200.1, JP2.3, JP5.3, L6.2, R146.1, U56.1
+15VA: C203.1, C234.1, C244.1, C250.1, L200.2, R273.1, U40.9, U41.9, U42.8
+24V: C91.1, C94.1, C95.1, C102.1, C103.1, C104.1, C120.1, C133.1, C137.1, C143.1, C280.1, C281.1, D22.1, D24.2, D200.1, J8.9, J8.10, R116.1, R154.1, R155.1, R156.1, R157.1, R158.1, R159.1, R160.1, R212.1, R213.1, R277.1, U13.3, U27.3, U28.3, U50.1, U50.10, U50.11, U50.12, U50.15, U50.16, U50.19, U50.20, U51.1, U51.10, U51.11, U51.12, U51.15, U51.16, U51.19, U51.20
-15VA: C204.1, C235.1, C245.1, C251.1, L201.2, R275.1, U40.10, U41.10, U42.4
/CMD/SS_P45: J3.4, J3.5, JP200.1, JP201.3
/CMD/SS_P78: J3.7, J3.8, JP200.3, JP201.1
/CMD/SS_RXD: U8.1, U8.4, U200.12
/CMD/SS_RXDE: R101.1, U8.2, U8.3
/CMD/SS_TXD: U9.4, U200.14
/CMD/SS_TXDE: R102.1, U9.2, U9.3, U200.13
/FB0/A12: C47.1, R86.1, R93.1, U26.31
/FB0/A35: C48.1, R89.1, R95.1, U26.32
/FB0/A78: C125.1, R135.2, R136.1, U23.1, U26.17
/FB0/D12: U14.1, U14.4, U26.59, U26.64, U26.79
/FB0/D36: U17.1, U17.4, U26.60, U26.65, U26.78
/FB0/D45: U18.1, U18.4, U26.61, U26.63, U26.80
/FB0/E12: R123.1, U14.2, U14.3, U26.58
/FB0/E36: R125.1, U17.2, U17.3, U26.57
/FB0/E45: R128.1, U18.2, U18.3, U26.62
/FB0/L1: J2.12, U26.55
/FB0/L2: J2.10, U26.56
/FB1/A12: C46.1, R87.1, R94.1, U26.29
/FB1/A35: C49.1, R88.1, R96.1, U26.30
/FB1/A78: C126.1, R138.2, R139.1, U23.6, U26.18
/FB1/D12: U15.1, U15.4, U26.40, U26.48, U26.53
/FB1/D36: U16.1, U16.4, U26.42, U26.51, U26.52
/FB1/D45: U19.1, U19.4, U26.44, U26.47, U26.54
/FB1/E12: R124.1, U15.2, U15.3, U26.41
/FB1/E36: R126.1, U16.2, U16.3, U26.43
/FB1/E45: R127.1, U19.2, U19.3, U26.45
/FB1/L1: J1.12, U26.38
/FB1/L2: J1.10, U26.39
/IO/IO_GREEN: D18.2, U26.86
/IO/IO_RED: D16.2, U26.84
/IO/IO_YELLOW: D17.2, U26.85
/ain/AI0VM: J6.3, R272.1
/ain/AI0VM_IN: R272.2, U45.53
/ain/AI1: J6.1, R270.1
/ain/AI1_IN: R270.2, U45.49
/ain/AI2: J6.2, R271.1
/ain/AI2_IN: R271.2, U45.51
/ain/MON_24: R277.2, R278.1, U45.63
/ain/MON_N15: R275.2, R276.1, U45.61
/ain/MON_P15: R273.2, R274.1, U45.59
/ain/SHLD_AI: C277.1, J6.4
/dac/+15V_RAW: C201.1, L200.1, U56.6
/dac/-15V_RAW: C202.1, L201.1, U56.4
/dac/AO1_F: C230.2, R232.1, U42.1, U42.2
/dac/AO1_N: J5.2, R233.2
/dac/AO2_F: C240.2, R242.1, U42.6, U42.7
/dac/AO2_N: J5.5, R243.2
/dac/DAC1_OUT: R230.1, U40.11
/dac/DAC1_REF: C233.1, U40.13
/dac/DAC2_OUT: R240.1, U41.11
/dac/DAC2_REF: C243.1, U41.13
/dac/LP1_A: C230.1, R230.2, R231.1
/dac/LP1_B: C231.1, R231.2, U42.3
/dac/LP2_A: C240.1, R240.2, R241.1
/dac/LP2_B: C241.1, R241.2, U42.5
/dac/SHLD_AO: C252.1, J5.3, J5.6
/drvio/IN1: J8.1, R290.1
/drvio/IN2: J8.2, R292.1
/drvio/IN3: J8.3, R294.1
/drvio/IN4: J8.4, R296.1
/drvio/IN5: J8.5, R298.1
/drvio/IN6: J8.6, R300.1
/drvio/IN7: J8.7, R302.1
/drvio/IN8: J8.8, R304.1
/drvio/OUT1: J7.1, U50.18
/drvio/OUT1_IN: U50.3, U55.7
/drvio/OUT2: J7.2, U50.17
/drvio/OUT2_IN: U50.5, U55.3
/drvio/OUT3: J7.3, U50.14
/drvio/OUT4: J7.4, U50.13
/drvio/OUT5: J7.5, U51.18
/drvio/OUT6: J7.6, U51.17
/drvio/OUT7: J7.7, U51.14
/drvio/OUT8: J7.8, U51.13
/f4/A_5V: C81.1, R121.2, R122.1, U26.24
/f4/A_24V: C64.1, R116.2, R117.1, U26.36
/f4/EN_5V: U26.7, U28.5
/f4/NRST: C29.2, U26.14
/f4/SWCLK: U20.4, U26.76
/f4/SWDIO: U20.1, U26.72
/supply/EN_U13: R212.2, U13.5
/supply/EN_U27: R213.2, U27.5
ADC_BUSY: U26.67, U45.14
ADC_CONVST: U26.95, U45.9, U45.10
ADC_CS: U26.37, U45.13
ADC_REF: C275.1, U45.42
ADC_REFCAP: C276.1, U45.44, U45.45
ADC_REGCAP1: C273.1, U45.36
ADC_REGCAP2: C274.1, U45.39
ADC_RESET: U26.68, U45.11
AO1_P: D230.1, J5.1, R232.2, U45.55
AO2_P: D240.1, J5.4, R242.2, U45.57
DAC1_SYNC: U26.92, U40.1
DAC2_SYNC: U26.96, U41.1
DAC_ALERT: R250.2, U26.77, U40.16, U41.16
DAC_RESET: U26.88, U40.6, U41.6
GND: C1.2, C8.2, C12.2, C13.2, C16.1, C18.2, C29.1, C31.2, C32.2, C36.1, C37.1, C46.2, C47.2, C48.2, C49.2, C61.2, C62.2, C64.2, C65.1, C66.2, C67.2, C71.2, C72.2, C73.2, C74.2, C75.2, C76.2, C77.1, C80.1, C81.2, C84.1, C85.1, C86.1, C87.1, C88.2, C89.1, C90.2, C91.2, C94.2, C95.2, C96.2, C99.2, C101.2, C102.2, C103.2, C104.2, C107.2, C108.2, C109.2, C110.2, C111.2, C113.1, C114.2, C115.1, C116.1, C117.2, C118.1, C119.1, C120.2, C122.2, C123.2, C124.2, C125.2, C126.2, C131.2, C132.2, C133.2, C134.2, C135.2, C136.2, C137.2, C139.2, C140.2, C142.2, C143.2, C144.2, C200.2, C201.2, C202.2, C203.2, C204.2, C231.2, C233.2, C234.2, C235.2, C236.2, C241.2, C243.2, C244.2, C245.2, C246.2, C250.2, C251.2, C252.2, C270.2, C271.2, C272.2, C273.2, C274.2, C275.2, C276.2, C277.2, C280.2, C281.2, C282.2, C285.2, C290.2, C292.2, C294.2, C296.2, C298.2, C300.2, C302.2, C304.2, D9.2, D12.2, D13.2, D22.2, D230.2, D240.2, D290.1, D292.1, D294.1, D296.1, D298.1, D300.1, D302.1, D304.1, J1.8, J2.8, J7.9, J7.10, P1.5, P3.2, R1.2, R3.2, R4.2, R5.2, R6.2, R25.2, R26.2, R35.2, R59.2, R61.1, R76.2, R83.2, R85.2, R93.2, R94.2, R95.2, R96.2, R117.2, R122.2, R123.2, R124.2, R125.2, R126.2, R127.2, R128.2, R132.2, R136.2, R139.2, R149.2, R155.2, R156.2, R157.2, R158.2, R233.1, R243.1, R274.2, R276.2, R278.2, R280.2, R281.2, R291.2, R293.2, R295.2, R297.2, R299.2, R301.2, R303.2, R305.2, U1.2, U2.1, U6.4, U7.4, U13.1, U14.5, U15.5, U16.5, U17.5, U18.5, U19.5, U20.2, U23.2, U26.10, U26.20, U26.27, U26.74, U26.99, U27.1, U28.1, U40.4, U40.12, U40.14, U41.4, U41.12, U41.14, U45.2, U45.3, U45.4, U45.5, U45.16, U45.17, U45.18, U45.19, U45.20, U45.21, U45.22, U45.26, U45.27, U45.28, U45.29, U45.30, U45.31, U45.32, U45.33, U45.35, U45.40, U45.41, U45.43, U45.46, U45.47, U45.50, U45.52, U45.54, U45.56, U45.58, U45.60, U45.62, U45.64, U50.2, U50.6, U51.2, U51.6, U55.4, U56.2, U56.5, U57.2, U57.5, U57.6, U200.2, U200.8
GNDD: J1.13, J2.13
IN1_MCU: C290.1, D290.3, R290.2, R291.1, U26.33
IN2_MCU: C292.1, D292.3, R292.2, R293.1, U26.34
IN3_MCU: C294.1, D294.3, R294.2, R295.1, U26.35
IN4_MCU: C296.1, D296.3, R296.2, R297.1, U26.46
IN5_MCU: C298.1, D298.3, R298.2, R299.1, U26.66
IN6_MCU: C300.1, D300.3, R300.2, R301.1, U26.83
IN7_MCU: C302.1, D302.3, R302.2, R303.1, U23.4, U26.15
IN8_MCU: C304.1, D304.3, R304.2, R305.1, U23.3, U26.16
unnamed: C12.1, R23.2, R48.1, R49.1, R148.1
unnamed: C13.1, R24.2, R47.1, R50.1, R147.1
unnamed: C32.1, R153.2, Y2.2
unnamed: C62.1, C101.1, R159.2
unnamed: C114.1, F200.2, JP2.2, R135.1, R137.1
unnamed: C117.1, F201.2, JP5.2, R138.1, R140.1
unnamed: C139.1, C140.1, C142.1, C144.1, R154.2, R160.2
unnamed: C105.2, D9.1, L5.1, U13.2
unnamed: C106.2, D12.1, L6.1, U27.2
unnamed: C121.2, D13.1, L12.1, U28.2
unnamed: D16.1, R76.1
unnamed: D17.1, R83.1
unnamed: D18.1, R85.1
unnamed: D24.1, R149.1
unnamed: D200.2, P3.1
unnamed: F200.1, J2.7
unnamed: F201.1, J1.7
unnamed: J1.9, R5.1
unnamed: J1.11, R4.1
unnamed: J2.9, R6.1
unnamed: J2.11, R3.1
unnamed: P1.3, U1.3, U26.71
unnamed: P1.2, U1.1, U26.70
unnamed: C1.1, P1.6, R1.1
unnamed: R54.1, R87.2, U7.1
unnamed: R55.1, R86.2, U6.1
unnamed: R56.1, R89.2, U6.7
unnamed: R57.1, R88.2, U7.7
unnamed: R24.1, R130.2
unnamed: R23.1, R131.2
unnamed: R133.1, R144.2
unnamed: R60.1, R145.2
unnamed: R97.1, R146.2
unnamed: R25.1, R147.2
unnamed: R26.1, R148.2
unnamed: C27.1, R42.1, R47.2, U6.3
unnamed: C27.2, R44.1, R55.2, U6.2
unnamed: C25.1, R36.1, R50.2, U6.5
unnamed: C25.2, R39.1, R56.2, U6.6
unnamed: C36.2, L8.2, R130.1, U6.8
unnamed: C26.1, R41.1, R48.2, U7.3
unnamed: C26.2, R43.1, R54.2, U7.2
unnamed: C24.1, R37.1, R49.2, U7.5
unnamed: C24.2, R38.1, R57.2, U7.6
unnamed: C37.2, L10.2, R131.1, U7.8
unnamed: J3.1, R62.2, R63.1, U8.6
unnamed: J3.2, R63.2, R64.1, U8.7
unnamed: C53.1, C54.1, L7.1, R62.1, R65.1, U8.8, U9.8
unnamed: J3.3, R65.2, R66.1, U9.6
unnamed: J3.6, R66.2, R67.1, U9.7
unnamed: C105.1, U13.6
unnamed: R35.1, R60.2, U13.4
unnamed: J2.1, R42.2, R109.1, U14.6
unnamed: J2.2, R44.2, R109.2, U14.7
unnamed: C72.1, C74.1, C75.1, L9.2, U14.8, U17.8, U18.8
unnamed: J1.1, R41.2, R110.1, U15.6
unnamed: J1.2, R43.2, R110.2, U15.7
unnamed: C71.1, C73.1, C76.1, L11.2, U15.8, U16.8, U19.8
unnamed: J1.3, R37.2, R112.1, U16.6
unnamed: J1.6, R38.2, R112.2, U16.7
unnamed: J2.3, R36.2, R111.1, U17.6
unnamed: J2.6, R39.2, R111.2, U17.7
unnamed: J2.5, R114.1, U18.6
unnamed: J2.4, R114.2, U18.7
unnamed: J1.5, R113.1, U19.6
unnamed: J1.4, R113.2, U19.7
unnamed: JP9.2, R61.2, U26.94
unnamed: C31.1, U26.12, Y2.1
unnamed: R153.1, U26.13
unnamed: C88.1, U26.49
unnamed: C90.1, U26.73
unnamed: C65.2, C119.2, L3.1, U26.21, U26.22
unnamed: C106.1, U27.6
unnamed: R59.1, R97.2, U27.4
unnamed: C121.1, U28.6
unnamed: R132.1, R133.2, U28.4
OUT1_MCU: R280.1, U26.2, U55.1
OUT2_MCU: R281.1, U26.3, U55.5
OUT3_MCU: U26.4, U50.7
OUT4_MCU: U26.5, U50.9
OUT5_MCU: U26.98, U51.3
OUT6_MCU: U26.97, U51.5
OUT7_MCU: U26.25, U51.7
OUT8_MCU: U26.26, U51.9
SPI_MISO: U26.90, U40.15, U41.15, U45.24
SPI_MOSI: U26.91, U40.3, U41.3
SPI_SCK: U26.89, U40.2, U41.2, U45.12
SS_5V: C112.1, JP200.2, L7.2, U200.10, U200.16
SS_GND: C17.2, C53.2, C54.2, C112.2, JP201.2, R31.2, R64.2, R67.2, R101.2, R102.2, U8.5, U9.5, U200.9, U200.15
SS_RX: U26.69, U200.5
SS_SHIELD: C17.1, J3.13, R31.1
SS_TX: U26.23, U200.3
SS_TXE: U26.93, U200.4
ST_A12: R282.2, U26.81, U50.4
ST_A34: R283.2, U26.82, U50.8
ST_B12: R284.2, U26.8, U51.4
ST_B34: R285.2, U26.9, U51.8
WD_OK: R286.2, U26.1, U40.5, U41.5, U55.2, U55.6, U57.7
WD_WDI: U26.87, U57.1
