brdmaker/stmbl/stm32f303/src/main.c

/*
* This file is part of the stmbl project.
*
* Copyright (C) 2013-2017 Rene Hopf <renehopf@mac.com>
* Copyright (C) 2013-2017 Nico Stute <crinq@crinq.de>
*
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
* You should have received a copy of the GNU General Public License
* along with this program.  If not, see <http://www.gnu.org/licenses/>.
*/

#include "main.h"
#include "stm32f3xx_hal.h"
#include "adc.h"
#include "dac.h"
#include "opamp.h"
#include "tim.h"

#include <math.h>
#include "defines.h"
#include "hal.h"
#include "angle.h"

#include "version.h"
#include "common.h"
#include "commands.h"
#include "f3hw.h"

#include "usbd_cdc_if.h"
#ifdef USB_TERM
#include "usb_device.h"
#endif

volatile uint64_t systime = 0;

void SysTick_Handler(void) {
  /* USER CODE BEGIN SysTick_IRQn 0 */
  systime++;
  /* USER CODE END SysTick_IRQn 0 */
  HAL_IncTick();
  HAL_SYSTICK_IRQHandler();
}

uint32_t systick_freq;
CRC_HandleTypeDef hcrc;

uint32_t hal_get_systick_value() {
  return (SysTick->VAL);
}

uint32_t hal_get_systick_reload() {
  return (SysTick->LOAD);
}

uint32_t hal_get_systick_freq() {
  return (systick_freq);
}

void SystemClock_Config(void);
void Error_Handler(void);

void TIM8_UP_IRQHandler() {
  GPIOA->BSRR |= GPIO_PIN_9;
  __HAL_TIM_CLEAR_IT(&htim8, TIM_IT_UPDATE);
  hal_run_rt();
  if(__HAL_TIM_GET_FLAG(&htim8, TIM_IT_UPDATE) == SET) {
    hal_stop();
    hal.hal_state = RT_TOO_LONG;
  }
  GPIOA->BSRR |= GPIO_PIN_9 << 16;
}

void about(char *ptr) {
  printf("######## software info ########\n");
  printf(
      "%s v%i.%i.%i %s\n",
      version_info.product_name,
      version_info.major,
      version_info.minor,
      version_info.patch,
      version_info.git_version);
  printf("Branch %s\n", version_info.git_branch);
  printf("Compiled %s %s ", version_info.build_date, version_info.build_time);
  printf("by %s on %s\n", version_info.build_user, version_info.build_host);
  printf("GCC        %s\n", __VERSION__);
  printf("newlib     %s\n", _NEWLIB_VERSION);
#ifdef __CM4_CMSIS_VERSION
  printf("CMSIS      %i.%i\n", __CM4_CMSIS_VERSION_MAIN, __CM4_CMSIS_VERSION_SUB);
#endif
#ifdef __STM32F4XX_STDPERIPH_VERSION
  printf("StdPeriph  %i.%i.%i\n", __STM32F4XX_STDPERIPH_VERSION_MAIN, __STM32F4XX_STDPERIPH_VERSION_SUB1, __STM32F4XX_STDPERIPH_VERSION_SUB2);
#endif
#ifdef __STM32F3xx_HAL_VERSION
  printf("HAL lib... TODO: print version\n");
#endif
}

COMMAND("about", about, "show system infos");

void bootloader(char *ptr) {
#ifdef USB_DISCONNECT_PIN
  HAL_GPIO_WritePin(USB_DISCONNECT_PORT, USB_DISCONNECT_PIN, GPIO_PIN_SET);
  HAL_Delay(100);
#endif
  RTC->BKP0R = 0xDEADBEEF;
  NVIC_SystemReset();
}

COMMAND("bootloader", bootloader, "enter bootloader");

void reset(char *ptr) {
  HAL_NVIC_SystemReset();
}
COMMAND("reset", reset, "reset STMBL");

int main(void) {
  // Relocate interrupt vectors
  extern void *g_pfnVectors;
  SCB->VTOR = (uint32_t)&g_pfnVectors;

  /* Reset of all peripherals, Initializes the Flash interface and the Systick. */
  HAL_Init();

  /* Configure the system clock */
  SystemClock_Config();
  systick_freq = HAL_RCC_GetHCLKFreq();
  /* Initialize all configured peripherals */
  __HAL_RCC_GPIOA_CLK_ENABLE();
  __HAL_RCC_GPIOB_CLK_ENABLE();
  __HAL_RCC_GPIOC_CLK_ENABLE();
  __HAL_RCC_GPIOF_CLK_ENABLE();

  GPIO_InitTypeDef GPIO_InitStruct;

#ifdef USB_DISCONNECT_PIN
  GPIO_InitStruct.Pin   = USB_DISCONNECT_PIN;
  GPIO_InitStruct.Mode  = GPIO_MODE_OUTPUT_PP;
  GPIO_InitStruct.Pull  = GPIO_NOPULL;
  GPIO_InitStruct.Speed = GPIO_SPEED_FREQ_LOW;
  HAL_GPIO_Init(USB_DISCONNECT_PORT, &GPIO_InitStruct);
  HAL_GPIO_WritePin(USB_DISCONNECT_PORT, USB_DISCONNECT_PIN, GPIO_PIN_RESET);
#endif

  MX_TIM8_Init();
  MX_ADC1_Init();
  MX_ADC2_Init();
  MX_ADC3_Init();
  MX_ADC4_Init();
  MX_DAC_Init();
  //COMP1 in+ pa1(ADC1_IN2)  in- pa4(dac1_ch1)
  COMP1->CSR = COMP_CSR_COMPxINSEL_2 | COMP1_CSR_COMP1OUTSEL_2 | COMP_CSR_COMPxEN;
  //COMP2 in+ pa7(ADC2_IN4)  in- pa4(dac1_ch1) COMP_CSR_COMPxNONINSEL
  COMP2->CSR = COMP_CSR_COMPxINSEL_2 | COMP2_CSR_COMP2OUTSEL_0 | COMP2_CSR_COMP2OUTSEL_1 | COMP_CSR_COMPxEN;
  //COMP4 in+ pb0(ADC3_IN12) in- pa4(dac1_ch1)
  COMP4->CSR = COMP_CSR_COMPxINSEL_2 | COMP4_CSR_COMP4OUTSEL_0 | COMP4_CSR_COMP4OUTSEL_1 | COMP_CSR_COMPxEN;
  MX_OPAMP1_Init();
  MX_OPAMP2_Init();
  MX_OPAMP3_Init();
  // MX_USART1_UART_Init();

#ifdef USB_TERM
  MX_USB_DEVICE_Init();
#endif

#ifdef USB_CONNECT_PIN
  GPIO_InitStruct.Pin   = USB_CONNECT_PIN;
  GPIO_InitStruct.Mode  = GPIO_MODE_OUTPUT_PP;
  GPIO_InitStruct.Pull  = GPIO_NOPULL;
  GPIO_InitStruct.Speed = GPIO_SPEED_FREQ_LOW;
  HAL_GPIO_Init(USB_CONNECT_PORT, &GPIO_InitStruct);
  HAL_GPIO_WritePin(USB_CONNECT_PORT, USB_CONNECT_PIN, GPIO_PIN_SET);
#endif

  __HAL_RCC_DMA1_CLK_ENABLE();
  __HAL_RCC_DMA2_CLK_ENABLE();
  __HAL_RCC_RTC_ENABLE();

  /* USER CODE BEGIN 2 */
  HAL_ADCEx_Calibration_Start(&hadc1, ADC_SINGLE_ENDED);
  HAL_ADCEx_Calibration_Start(&hadc2, ADC_SINGLE_ENDED);
  HAL_ADCEx_Calibration_Start(&hadc3, ADC_SINGLE_ENDED);
  HAL_ADCEx_Calibration_Start(&hadc4, ADC_SINGLE_ENDED);

  HAL_OPAMP_SelfCalibrate(&hopamp1);
  HAL_OPAMP_SelfCalibrate(&hopamp2);
  HAL_OPAMP_SelfCalibrate(&hopamp3);

  hcrc.Instance                     = CRC;
  hcrc.Init.DefaultPolynomialUse    = DEFAULT_POLYNOMIAL_ENABLE;
  hcrc.Init.DefaultInitValueUse     = DEFAULT_INIT_VALUE_ENABLE;
  hcrc.Init.InputDataInversionMode  = CRC_INPUTDATA_INVERSION_NONE;
  hcrc.Init.OutputDataInversionMode = CRC_OUTPUTDATA_INVERSION_DISABLE;
  hcrc.InputDataFormat              = CRC_INPUTDATA_FORMAT_WORDS;

  __HAL_RCC_CRC_CLK_ENABLE();

  if(HAL_CRC_Init(&hcrc) != HAL_OK) {
    Error_Handler();
  }

  //IO pins
  GPIO_InitStruct.Pin   = GPIO_PIN_9 | GPIO_PIN_10;
  GPIO_InitStruct.Mode  = GPIO_MODE_OUTPUT_PP;
  GPIO_InitStruct.Pull  = GPIO_NOPULL;
  GPIO_InitStruct.Speed = GPIO_SPEED_FREQ_LOW;
  HAL_GPIO_Init(GPIOA, &GPIO_InitStruct);

  if(HAL_OPAMP_Start(&hopamp1) != HAL_OK) {
    Error_Handler();
  }
  if(HAL_OPAMP_Start(&hopamp2) != HAL_OK) {
    Error_Handler();
  }
  if(HAL_OPAMP_Start(&hopamp3) != HAL_OK) {
    Error_Handler();
  }

  htim8.Instance->CCR1 = 0;
  htim8.Instance->CCR2 = 0;
  htim8.Instance->CCR3 = 0;

  HAL_ADC_Start(&hadc1);
  HAL_ADC_Start(&hadc2);
  HAL_ADC_Start(&hadc3);
  HAL_ADC_Start(&hadc4);
  HAL_DAC_Start(&hdac, DAC_CHANNEL_1);
  HAL_DAC_SetValue(&hdac, DAC_CHANNEL_1, DAC_ALIGN_12B_R, 0);
  if(HAL_TIM_Base_Start_IT(&htim8) != HAL_OK) {
    Error_Handler();
  }
#ifndef PWM_INVERT
  TIM8->RCR = 1;  //uptate event foo
#endif
  if(HAL_TIM_PWM_Start(&htim8, TIM_CHANNEL_1) != HAL_OK) {
    Error_Handler();
  }
  if(HAL_TIM_PWM_Start(&htim8, TIM_CHANNEL_2) != HAL_OK) {
    Error_Handler();
  }
  if(HAL_TIM_PWM_Start(&htim8, TIM_CHANNEL_3) != HAL_OK) {
    Error_Handler();
  }
  if(HAL_TIMEx_PWMN_Start(&htim8, TIM_CHANNEL_1) != HAL_OK) {
    Error_Handler();
  }
  if(HAL_TIMEx_PWMN_Start(&htim8, TIM_CHANNEL_2) != HAL_OK) {
    Error_Handler();
  }
  if(HAL_TIMEx_PWMN_Start(&htim8, TIM_CHANNEL_3) != HAL_OK) {
    Error_Handler();
  }

  hal_init(1.0 / 15000.0, 0.0);
  // hal load comps
  hal_parse("debug_level 1");
  hal_parse("load term");
  // load_comp(comp_by_name("sim"));
  hal_parse("load io");
  hal_parse("load ls");
  hal_parse("load dq");
  hal_parse("load idq");
  hal_parse("load svm");
  hal_parse("load hv");
  hal_parse("load curpid");

  hal_parse("ls0.rt_prio = 0.6");
  hal_parse("io0.rt_prio = 1.0");
  hal_parse("dq0.rt_prio = 2.0");
  hal_parse("curpid0.rt_prio = 3.0");
  hal_parse("idq0.rt_prio = 4.0");
  hal_parse("svm0.rt_prio = 5.0");
  hal_parse("hv0.rt_prio = 6.0");

  hal_parse("term0.send_step = 0.0");

  //link LS
  hal_parse("ls0.mot_temp = io0.mot_temp");
  hal_parse("ls0.dc_volt = io0.udc");
  hal_parse("ls0.hv_temp = io0.hv_temp");
  hal_parse("ls0.fault_in = io0.fault");
  hal_parse("io0.led = ls0.fault");
  hal_parse("curpid0.id_cmd = ls0.d_cmd");
  hal_parse("curpid0.iq_cmd = ls0.q_cmd");
  hal_parse("idq0.pos = ls0.pos");
  hal_parse("idq0.mode = ls0.phase_mode");
  hal_parse("dq0.pos = ls0.pos");
  hal_parse("dq0.mode = ls0.phase_mode");
  hal_parse("io0.hv_en = ls0.en");
  hal_parse("io0.dac = ls0.dac");

  //ADC TEST
  hal_parse("hv0.udc = io0.udc");
  hal_parse("dq0.u = io0.iu");
  hal_parse("dq0.v = io0.iv");
  hal_parse("dq0.w = io0.iw");

  hal_parse("svm0.u = idq0.u");
  hal_parse("svm0.v = idq0.v");
  hal_parse("svm0.w = idq0.w");
  hal_parse("hv0.u = svm0.su");
  hal_parse("hv0.v = svm0.sv");
  hal_parse("hv0.w = svm0.sw");
  hal_parse("svm0.udc = io0.udc");
  hal_parse("curpid0.id_fb = dq0.d");
  hal_parse("curpid0.iq_fb = dq0.q");
  hal_parse("ls0.id_fb = dq0.d");
  hal_parse("ls0.iq_fb = dq0.q");
  hal_parse("ls0.ud_fb = curpid0.ud");
  hal_parse("ls0.uq_fb = curpid0.uq");
  hal_parse("ls0.y = dq0.y");
  hal_parse("ls0.u_fb = io0.u");
  hal_parse("ls0.v_fb = io0.v");
  hal_parse("ls0.w_fb = io0.w");
  hal_parse("idq0.d = curpid0.ud");
  hal_parse("idq0.q = curpid0.uq");
  hal_parse("curpid0.r = ls0.r");
  hal_parse("curpid0.ld = ls0.l");
  hal_parse("curpid0.lq = ls0.l");
  hal_parse("curpid0.psi = ls0.psi");
  hal_parse("curpid0.cur_bw = ls0.cur_bw");
  hal_parse("curpid0.ff = ls0.cur_ff");
  hal_parse("curpid0.kind = ls0.cur_ind");
  hal_parse("curpid0.max_cur = ls0.max_cur");
  hal_parse("curpid0.pwm_volt = ls0.pwm_volt");
  hal_parse("curpid0.vel = ls0.vel");
  hal_parse("curpid0.en = ls0.en");
  hal_parse("curpid0.cmd_mode = ls0.cmd_mode");
  hal_parse("curpid0.brake = ls0.vbrake");
  hal_parse("hv0.arr = ls0.arr");
  hal_parse("io0.ignore_fault_pin = ls0.ignore_fault_pin");
  // hal_parse("load sensorless");
  // hal_parse("sensorless0.rt_prio = 7");
  // hal_parse("sensorless0.r = ls0.r");
  // hal_parse("sensorless0.l = ls0.l");
  // hal_parse("sensorless0.id = dq0.d");
  // hal_parse("sensorless0.iq = dq0.q");
  // hal_parse("sensorless0.ud = curpid0.ud");
  // hal_parse("sensorless0.uq = curpid0.uq");
  hal_parse("hv0.iu = io0.iu");
  hal_parse("hv0.iv = io0.iv");
  hal_parse("hv0.iw = io0.iw");
  
  hal_parse("debug_level 0");

  // hal parse config
  // hal_init_nrt();
  // error foo
  hal_start();

  while(1) {
    hal_run_nrt();
    cdc_poll();
    HAL_Delay(1);
  }
}

/** System Clock Configuration
*/
void SystemClock_Config(void) {
  RCC_OscInitTypeDef RCC_OscInitStruct;
  RCC_ClkInitTypeDef RCC_ClkInitStruct;
  RCC_PeriphCLKInitTypeDef PeriphClkInit;

  /**Initializes the CPU, AHB and APB busses clocks 
    */
  RCC_OscInitStruct.OscillatorType = RCC_OSCILLATORTYPE_HSE;
  RCC_OscInitStruct.HSEState       = RCC_HSE_ON;
  RCC_OscInitStruct.HSEPredivValue = RCC_HSE_PREDIV_DIV1;
  RCC_OscInitStruct.HSIState       = RCC_HSI_ON;
  RCC_OscInitStruct.LSIState       = RCC_LSI_ON;
  RCC_OscInitStruct.PLL.PLLState   = RCC_PLL_ON;
  RCC_OscInitStruct.PLL.PLLSource  = RCC_PLLSOURCE_HSE;
  RCC_OscInitStruct.PLL.PLLMUL     = RCC_PLL_MUL9;
  if(HAL_RCC_OscConfig(&RCC_OscInitStruct) != HAL_OK) {
    Error_Handler();
  }

  /**Initializes the CPU, AHB and APB busses clocks 
    */
  RCC_ClkInitStruct.ClockType      = RCC_CLOCKTYPE_HCLK | RCC_CLOCKTYPE_SYSCLK | RCC_CLOCKTYPE_PCLK1 | RCC_CLOCKTYPE_PCLK2;
  RCC_ClkInitStruct.SYSCLKSource   = RCC_SYSCLKSOURCE_PLLCLK;
  RCC_ClkInitStruct.AHBCLKDivider  = RCC_SYSCLK_DIV1;
  RCC_ClkInitStruct.APB1CLKDivider = RCC_HCLK_DIV2;
  RCC_ClkInitStruct.APB2CLKDivider = RCC_HCLK_DIV1;

  if(HAL_RCC_ClockConfig(&RCC_ClkInitStruct, FLASH_LATENCY_2) != HAL_OK) {
    Error_Handler();
  }

  //TODO: usb optional
  PeriphClkInit.PeriphClockSelection = RCC_PERIPHCLK_USB | RCC_PERIPHCLK_USART1 | RCC_PERIPHCLK_USART3 | RCC_PERIPHCLK_TIM8 | RCC_PERIPHCLK_ADC12 | RCC_PERIPHCLK_ADC34 | RCC_PERIPHCLK_RTC;
  PeriphClkInit.Usart1ClockSelection = RCC_USART1CLKSOURCE_PCLK2;
  PeriphClkInit.Usart3ClockSelection = RCC_USART3CLKSOURCE_SYSCLK;
  PeriphClkInit.Adc12ClockSelection  = RCC_ADC12PLLCLK_DIV1;
  PeriphClkInit.Adc34ClockSelection  = RCC_ADC34PLLCLK_DIV1;
  PeriphClkInit.USBClockSelection    = RCC_USBCLKSOURCE_PLL_DIV1_5;
  PeriphClkInit.Tim8ClockSelection   = RCC_TIM8CLK_PLLCLK;
  PeriphClkInit.RTCClockSelection    = RCC_RTCCLKSOURCE_LSI;
  if(HAL_RCCEx_PeriphCLKConfig(&PeriphClkInit) != HAL_OK) {
    Error_Handler();
  }

  /**Configure the Systick interrupt time 
    */
  HAL_SYSTICK_Config(HAL_RCC_GetHCLKFreq() / 1000);

  /**Configure the Systick 
    */
  HAL_SYSTICK_CLKSourceConfig(SYSTICK_CLKSOURCE_HCLK);

  /* SysTick_IRQn interrupt configuration */
  HAL_NVIC_SetPriority(SysTick_IRQn, 0, 0);
}

/**
  * @brief  This function is executed in case of error occurrence.
  * @param  None
  * @retval None
  */
void Error_Handler(void) {
  /* User can add his own implementation to report the HAL error return state */
  while(1) {
    HAL_GPIO_WritePin(GPIOA, GPIO_PIN_8, GPIO_PIN_SET);
  }
}

#ifdef USE_FULL_ASSERT

/**
   * @brief Reports the name of the source file and the source line number
   * where the assert_param error has occurred.
   * @param file: pointer to the source file name
   * @param line: assert_param error line source number
   * @retval None
   */
void assert_failed(uint8_t *file, uint32_t line) {
  /* USER CODE BEGIN 6 */
  /* User can add his own implementation to report the file name and line number,
    ex: printf("Wrong parameters value: file %s on line %d\r\n", file, line) */
  /* USER CODE END 6 */
}

#endif
