brdmaker/stmbl/webui/mill/server/millweb.py

"""millweb: the browser console's backend, between LinuxCNC and any number
of browsers (README.md, "The backend").

    millweb -ini machine.ini          as LinuxCNC's display program ([DISPLAY] DISPLAY = millweb)
    millweb --ini machine.ini         beside a LinuxCNC that is already running

Serves webui/mill (the console) over HTTP(S) and talks JSON over a
WebSocket on /ws:

  server -> browser   {"t": "hello" | "st" | "slow" | "ev" | "program" | "tools" | "offsets" |
                        "files" | "control" | "reply" | "file", ...}
  browser -> server   {"op": ..., "id": n, ...}   answered by {"t": "reply", "id": n, "ok": bool, "err": text}

One browser has control (a lease: "control" {take}); the others watch. Any
browser may press E-STOP. Continuous jogs need a "jog" message at least
every 300 ms or they stop.
"""
import argparse
import asyncio
import base64
import binascii
import concurrent.futures
import datetime
import json
import re
import os
import signal
import ssl
import sys
import time

HERE = os.path.dirname(os.path.abspath(__file__))
sys.path.insert(0, HERE)
import driveconf  # noqa: E402
import drives as drives_mod  # noqa: E402
import vibmon_link  # noqa: E402
import supervisor as supervisor_mod  # noqa: E402
import machine as machine_mod  # noqa: E402
import preview  # noqa: E402
import wsserver  # noqa: E402

WEBROOT = os.path.dirname(HERE)
JOG_DEADMAN = 0.3
NO_REPLY = object()  # a handler that sent its reply itself
VERSION = "0.1"


def now():
    return datetime.datetime.now().strftime("%H:%M:%S")


class Client:
    n = 0

    def __init__(self, ws):
        Client.n += 1
        self.id = "c%d" % Client.n
        self.ws = ws
        self.last = {}
        self.name = "%s:%s" % (ws.peer[0], ws.peer[1]) if ws.peer else self.id


class Hub:
    def __init__(self, mach, cfg, quit_event=None):
        self.m = mach
        self.cfg = cfg
        self.clients = {}
        self.control = None          # client id
        self.events = []             # (time, lvl, text)
        self.pool = concurrent.futures.ThreadPoolExecutor(max_workers=1, thread_name_prefix="millweb-cmd")
        self.ppool = concurrent.futures.ThreadPoolExecutor(max_workers=1, thread_name_prefix="millweb-preview")
        self.upool = concurrent.futures.ThreadPoolExecutor(max_workers=1, thread_name_prefix="millweb-urgent")
        self.state = {}
        self.slow_state = {}
        self.program = None          # the last preview sent (its JSON text)
        self.pv_cache = {}           # key -> (text, head): the last few previews
        self.pv_running = {}         # key -> future: one child process per preview
        self.pv_sem = asyncio.Semaphore(2)
        self.pv_segs = int(cfg.num("MILLWEB", "PREVIEW_SEGS", 100000))
        self.pv_timeout = cfg.num("MILLWEB", "PREVIEW_TIMEOUT", 120.0)
        self.pv_full_segs = int(cfg.num("MILLWEB", "PREVIEW_FULL_SEGS", 2000000))  # the full simulation's moves
        self.pv_full_timeout = cfg.num("MILLWEB", "PREVIEW_FULL_TIMEOUT", 600.0)
        self.resyncing = False
        self.hal_watch = {}          # client id -> HAL names it watches
        self.scopes = {}             # client id -> its sampler process
        self.sampler_cmd = [sys.executable, os.path.join(os.path.dirname(os.path.abspath(__file__)), "sampler.py")]
        self.line_index = {}         # path -> (mtime, size, byte offset of every 1000th line, lines)
        self.program_file = None
        self.jog_seen = {}           # axis -> time of the last continuous-jog message
        self.token = cfg.get("MILLWEB", "TOKEN")
        self.on_loss = (cfg.get("MILLWEB", "ON_CONTROL_LOSS", "continue") or "continue").lower()
        self.poll_hz = cfg.num("MILLWEB", "POLL_HZ", 30.0)
        self.quit = quit_event
        self.files_sig = None
        self.tools_sig = None
        # stmbl drives' consoles (drives.py): [MILLWEB] DRIVE_LINK
        self.drive_write = (cfg.get("MILLWEB", "DRIVE_WRITE", "no") or "no").lower() in ("yes", "1", "true")
        poll_ms = cfg.num("MILLWEB", "DRIVE_POLL_MS", 250)
        self.links = {n: drives_mod.DriveLink(n, path, pd, out=self.drive_out, event=self.event, poll_ms=poll_ms)
                      for n, path, pd in drives_mod.links_from(cfg.all("MILLWEB", "DRIVE_LINK"))}
        self.drive_watch = {}        # client id -> the drive whose console it shows
        # the drives' firmware (driveconf.py): what this console expects, whether a mismatch keeps the machine off
        self.fw_want = driveconf.expected_fw(cfg)
        self.fw_block = (cfg.get("MILLWEB", "DRIVE_FW_BLOCK", "yes") or "yes").lower() not in ("no", "0", "false")
        self.fw_said = {}            # drive -> the problems told in the event log
        self.drive_jobs = {}         # drive -> what its config job does
        # run by millweb-supervisor (supervisor.py): machine.json, restarts
        # the vibration sensors, through vibmon (vibmon_link.py): [MILLWEB] VIBMON
        vpath = cfg.get("MILLWEB", "VIBMON")
        self.vib = vibmon_link.VibLink(vpath, self.vib_msg, self.vib_state) if vpath else None
        self.vib_said = {}           # (node, kind) -> the level last told in the event log
        self.vib_state_on = (cfg.get("MILLWEB", "VIBMON_STATE", "yes") or "yes").lower() not in ("no", "0", "false")
        self.vib_last_machine, self.vib_last_sent = None, 0.0
        self.vib_teeth = (None, None)  # (tool, its teeth)
        mdir = cfg.get("MILLWEB", "MACHINE_DIR")
        self.conf = supervisor_mod.ConfigOps(mdir) if mdir else None
        self.drive_sig = None

    # ------------------------------------------------------------ events
    def event(self, lvl, text):
        e = (now(), lvl, text)
        self.events.append(e)
        del self.events[:-300]
        self.broadcast({"t": "ev", "time": e[0], "lvl": lvl, "text": text})

    def broadcast(self, msg, only=None):
        data = json.dumps(msg, separators=(",", ":"))
        for c in list(self.clients.values()):
            if only is None or c.id in only:
                asyncio.ensure_future(c.ws.send(data))

    # ------------------------------------------------------------ connection
    async def handle(self, ws, query):
        c = Client(ws)
        self.clients[c.id] = c
        info = self.m.info()
        info["version"] = VERSION
        info["token_required"] = bool(self.token)
        info["drive_links"] = list(self.links)
        info["drive_write"] = self.drive_write
        info["supervised"] = bool(self.conf)
        info["vibmon"] = bool(self.vib)
        if self.conf:
            info["supervisor"] = self.conf.status()
        await ws.send_json({"t": "hello", "you": c.id, "machine": info, "control": self.control,
                            "events": [{"time": t, "lvl": l, "text": x} for t, l, x in self.events[-80:]]})
        await ws.send_json({"t": "st", **self.state})
        if self.slow_state:
            await ws.send_json({"t": "slow", **self.slow_state})
        await ws.send_json(self.tools_msg())
        await ws.send_json(self.offsets_msg())
        await ws.send_json(self.files_msg())
        await ws.send_json(self.setup_msg())
        await ws.send_json({"t": "views", "views": self.m.views()})
        if self.links:
            await ws.send_json({"t": "drv", "drives": self.drive_status()})
        if self.vib:
            await ws.send_json({"t": "vib", "up": self.vib.up, "status": self.vib.status})
        if self.program:
            await ws.send(self.program)
        self.event("info", "Browser connected: %s" % c.name)
        try:
            while True:
                text = await ws.recv()
                if text is None:
                    break
                try:
                    msg = json.loads(text)
                except ValueError:
                    continue
                if isinstance(msg, dict):
                    asyncio.ensure_future(self.on_message(c, msg))
        finally:
            del self.clients[c.id]
            self.hal_watch.pop(c.id, None)
            self.drive_watch.pop(c.id, None)
            await self.scope_stop(c.id)
            if self.control == c.id:
                await self.lose_control(c)
            self.event("info", "Browser left: %s" % c.name)

    async def lose_control(self, c, released=False):
        self.control = None
        await self.urgent(self.m.cmd_jog_stop)
        self.jog_seen.clear()
        if released:
            self.event("info", "%s released control" % c.name)
        elif self.on_loss == "hold" and self.state.get("run") == "run":
            await self.run(self.m.cmd_cycle, "pause")
            self.event("warn", "The controlling browser went away: feed hold")
        else:
            self.event("warn", "The controlling browser went away; the machine carries on")
        self.broadcast({"t": "control", "holder": None})

    async def run(self, fn, *a, **kw):
        loop = asyncio.get_event_loop()
        return await loop.run_in_executor(self.pool, lambda: fn(*a, **kw))

    async def urgent(self, fn, *a, **kw):
        """E-STOP, stop, jog stop: not behind a command that is waiting."""
        loop = asyncio.get_event_loop()
        return await loop.run_in_executor(self.upool, lambda: fn(*a, **kw))

    # ------------------------------------------------------------ messages
    async def on_message(self, c, msg):
        op, mid = msg.get("op"), msg.get("id")

        async def reply(err=None, **extra):
            out = {"t": "reply", "id": mid, "op": op, "ok": err is None}
            if err is not None:
                out["err"] = err
            out.update(extra)
            await c.ws.send_json(out)

        try:
            if op == "control":
                return await reply(await self.op_control(c, msg))
            if op == "estop":                      # anyone may stop the machine
                err = await self.urgent(self.m.cmd_estop, bool(msg.get("on", True)))
                if msg.get("on", True):
                    self.event("bad", "E-STOP from %s" % c.name)
                return await reply(err)
            if op == "jog" and msg.get("inc", 0) == 0 and self.control == c.id:
                # the deadman: keep-alive of a running continuous jog
                a = str(msg.get("axis", "x")).lower()
                if a in self.jog_seen:
                    self.jog_seen[a] = time.time()
                    return await reply()
            if op in ("files", "program_get", "program_lines", "model_get", "hal_list", "hal_watch", "hal_values",
                      "scope_start", "scope_stop", "views_save", "ping", "events", "drive_watch", "drive_cmd",
                      "sup_status", "log_get", "config_get", "config_check", "config_version", "mmodel_get",
                      "vib_spectrum", "vib_trend", "vib_console_read", "arm_model", "teach", "program_mark"):  # reading, and the Debug page's own (drive_cmd checks its own)
                pass  # reading needs no control
            elif self.control != c.id:
                return await reply("this browser doesn't have control (take it first)")
            elif self.slow_state.get("remote") is False:
                return await reply("remote control is switched off at the machine")
            handler = getattr(self, "op_" + str(op), None)
            if handler is None:
                return await reply("unknown op %r" % op)
            self.m.done_flag = False
            res = await handler(c, msg)
            if res is NO_REPLY:
                return
            if isinstance(res, dict):
                return await reply(None, **res)
            return await reply(res)
        except (ValueError, KeyError, TypeError, IndexError, OSError) as e:
            return await reply(str(e) or type(e).__name__)
        except Exception as e:  # a bug: say so, keep serving
            self.event("bad", "millweb: %s failed: %r" % (op, e))
            return await reply("internal error: %r" % e)

    async def op_control(self, c, msg):
        if msg.get("take", True):
            if self.token and msg.get("token") != self.token:
                return "wrong or missing token"
            if self.slow_state.get("remote") is False:
                return "remote control is switched off at the machine"
            if self.control not in (None, c.id) and not msg.get("force"):
                return "another browser has control"
            if self.control and self.control != c.id:
                self.event("warn", "Control taken over by %s" % c.name)
            self.control = c.id
            self.event("info", "%s has control" % c.name)
        elif self.control == c.id:
            await self.lose_control(c, released=True)
            return None
        self.broadcast({"t": "control", "holder": self.control})
        return None

    async def op_ping(self, c, m):
        return {"time": time.time()}

    async def op_events(self, c, m):
        return {"events": [{"time": t, "lvl": l, "text": x} for t, l, x in self.events[-max(1, int(m.get("n", 300))):]]}

    async def op_power(self, c, m):
        if m.get("on", True):
            blocked = self.drive_blockers()
            if blocked:
                return "not with this drive firmware: %s ([MILLWEB] DRIVE_FW_BLOCK = no to allow it)" % "; ".join(blocked)
        err = await self.run(self.m.cmd_power, bool(m.get("on", True)))
        if not err:
            self.event("ok", "Machine %s" % ("on" if m.get("on", True) else "off"))
        return err

    async def op_home(self, c, m):
        return await self.run(self.m.cmd_home, m.get("axis", "all"))

    async def op_unhome(self, c, m):
        return await self.run(self.m.cmd_unhome, m.get("axis", "all"))

    async def op_jog(self, c, m):
        a = str(m.get("axis", "x")).lower()
        inc = float(m.get("inc", 0))
        err = await self.run(self.m.cmd_jog, a, int(m.get("dir", 1)), inc, float(m.get("rate", 1000)))
        if not err and inc == 0:
            self.jog_seen[a] = time.time()
        return err

    async def op_jog_stop(self, c, m):
        a = m.get("axis")
        self.jog_seen.pop(str(a).lower(), None) if a else self.jog_seen.clear()
        return await self.urgent(self.m.cmd_jog_stop, a)

    async def op_mdi(self, c, m):
        text = str(m.get("cmd", "")).strip()
        if not text or len(text) > 256:
            return "an MDI line: 1 to 256 characters"
        self.event("info", "MDI: %s" % text)
        return await self.run(self.m.mdi, text, bool(m.get("wait")))  # wait: reply when done

    async def op_cycle(self, c, m):
        act = m.get("action", "start")
        if act == "stop":
            err = await self.urgent(self.m.cmd_stop)
        else:
            err = await self.run(self.m.cmd_cycle, act, int(m.get("line", 0) or 0))
        if not err:
            self.event("ok" if act in ("start", "resume") else "info",
                       {"start": "Cycle start" + (" from line %s" % m.get("line") if m.get("line") else ""), "pause": "Feed hold",
                        "resume": "Resumed", "step": "Single block", "stop": "Stopped"}.get(act, act))
        return err

    async def op_override(self, c, m):
        return await self.run(self.m.cmd_override, m["k"], m["v"])

    async def op_spindle(self, c, m):
        return await self.run(self.m.cmd_spindle, int(m.get("dir", 0)), m.get("speed"))

    async def op_coolant(self, c, m):
        return await self.run(self.m.cmd_coolant, m["k"], bool(m.get("on")))

    async def op_opt(self, c, m):
        return await self.run(self.m.cmd_opt, m.get("m1"), m.get("bd"))

    async def op_zero(self, c, m):
        err = await self.run(self.m.cmd_zero, m["axis"], float(m.get("value", 0)))
        if not err:
            self.event("ok", "G10 L20: %s = %.3f in %s" % (m["axis"].upper(), float(m.get("value", 0)), self.m.WCS[self.state.get("wcs", 0)]))
            self.broadcast(self.offsets_msg())
        return err

    async def op_wcs(self, c, m):
        err = await self.run(self.m.cmd_wcs, int(m["index"]))
        self.broadcast(self.offsets_msg())
        return err

    async def op_offset(self, c, m):
        err = await self.run(self.m.cmd_offset, int(m["index"]), m.get("x"), m.get("y"), m.get("z"))
        self.broadcast(self.offsets_msg())
        return err

    async def op_g92_clear(self, c, m):
        err = await self.run(self.m.cmd_g92_clear)
        self.broadcast(self.offsets_msg())
        return err

    async def op_tool_load(self, c, m):
        err = await self.run(self.m.cmd_tool_load, int(m["t"]))
        if not err:
            self.event("ok", "T%d M6" % int(m["t"]))
        return err

    async def op_tools_save(self, c, m):
        err = await self.run(self.m.cmd_tools_save, m["tools"])
        if not err:
            self.event("ok", "Tool table saved")
            self.broadcast(self.tools_msg())
        return err

    async def op_tool_measure(self, c, m):
        res = await self.run(self.m.cmd_tool_measure)
        if isinstance(res, dict):
            self.event("ok", "T%d length %.4f mm (tool setter)" % (res["tool"], res["length"]))
            self.broadcast(self.tools_msg())
        return res

    async def op_probe(self, c, m):
        res = await self.run(self.m.cmd_probe, m.get("kind", "z"), float(m.get("travel", 20)), float(m.get("feed", 300)),
                             float(m.get("plate", 0)), float(m.get("clearance", 5)))
        if isinstance(res, dict):
            self.event("ok", "Probe: machine Z %.4f" % res["mach"][2])
            self.broadcast(self.offsets_msg())
        return res

    async def op_files(self, c, m):
        files, dirs = self.m.programs()
        return {"files": files, "dirs": dirs}

    async def op_program_get(self, c, m):
        """A program's preview: {name, full}. full: every move (PREVIEW_FULL_SEGS of them at most), none merged,
        for the File page's full simulation; else as drawn (PREVIEW_SEGS)."""
        path = self.m._safe(m["name"])
        text, head = await self.preview(path, full=bool(m.get("full")))
        # the preview's text goes in as it is: no second encoding of a big message
        await c.ws.send('{"t":"reply","id":%s,"op":"program_get","ok":true,"program":%s}' % (json.dumps(m.get("id")), text))
        return NO_REPLY

    async def op_program_mark(self, c, m):
        """A program checked or simulated in full in a browser: {name, kind: check | sim, level, sig, summary, full}.
        Every browser's File page shows it (no control needed: it changes nothing on the machine)."""
        await self.run(self.m.cmd_program_mark, m["name"], m.get("kind"), m.get("level"), m.get("sig", ""),
                       m.get("summary", ""), bool(m.get("full")), c.name)
        self.broadcast(self.files_msg())
        return None

    async def op_program_lines(self, c, m):
        """Lines start ... start+count-1 (from 1) of a program: the listing of a
        long one comes in windows."""
        path = self.m._safe(m["name"])
        start, count = max(1, int(m.get("start", 1))), max(1, min(5000, int(m.get("count", 2000))))
        loop = asyncio.get_event_loop()
        lines, n = await loop.run_in_executor(self.ppool, self.read_lines, path, start, count)
        return {"start": start, "lines": lines, "nlines": n}

    async def op_program_save(self, c, m):
        text = str(m.get("text", ""))
        if len(text) > 6 * 1024 * 1024:
            return "too large"
        err = await self.run(self.m.cmd_program_save, m["name"], text, bool(m.get("overwrite", True)))
        if not err:
            self.event("ok", "Saved %s" % m["name"])
            self.broadcast(self.files_msg())
        return err

    async def op_program_delete(self, c, m):
        err = await self.run(self.m.cmd_program_delete, m["name"])
        if not err:
            self.event("info", "Deleted %s" % m["name"])
            self.broadcast(self.files_msg())
        return err

    async def op_program_rename(self, c, m):
        """A program or a folder renamed or moved: {name, to}."""
        err = await self.run(self.m.cmd_rename, m["name"], m["to"])
        if not err:
            self.event("info", "Renamed %s to %s" % (m["name"], m["to"]))
            self.broadcast(self.files_msg())
        return err

    async def op_model_save(self, c, m):
        """A 3D model (STL or OBJ) uploaded: {name, data (base64), overwrite}."""
        try:
            data = base64.b64decode(str(m.get("data", "")), validate=True)
        except (ValueError, binascii.Error):
            return "the model's data isn't base64"
        err = await self.run(self.m.cmd_model_save, m["name"], data, bool(m.get("overwrite", True)))
        if not err:
            self.event("ok", "Saved %s (%.1f MB)" % (m["name"], len(data) / 1e6))
            self.broadcast(self.files_msg())
        return err

    async def op_scene_import(self, c, m):
        """A CAM scene (zip, base64) into the program folder and the 3D setup: {name, data, keep_fixtures, overwrite}."""
        try:
            data = base64.b64decode(str(m.get("data", "")), validate=True)
        except (ValueError, binascii.Error):
            return "the scene's data isn't base64"
        res = await self.run(self.m.cmd_scene_import, m.get("name"), data, bool(m.get("keep_fixtures")), bool(m.get("overwrite")))
        if isinstance(res, dict):
            self.event("ok", "Imported %s: %s" % (res["folder"], res["summary"]))
            self.broadcast(self.files_msg())
            self.broadcast(self.setup_msg())
        return res

    async def op_arm_model(self, c, m):
        """An arm's 3D model files (machine.arm_model): the browser draws the arm from them."""
        loop = asyncio.get_event_loop()
        try:
            return await loop.run_in_executor(self.ppool, self.m.arm_model)
        except (OSError, ValueError) as e:
            return str(e)

    async def op_teach_record(self, c, m):
        """Record point: the arm's pose as a G1 line in the teach file."""
        res = await self.run(self.m.cmd_teach_record, m.get("rate"))
        if isinstance(res, dict):
            self.event("ok", "Recorded %s (%d points in %s)" % (res["line"], res["points"], res["file"]))
            self.broadcast(self.files_msg())
        return res

    async def op_teach(self, c, m):
        """the teach points: list (anyone may read them), delete / up / down an index, clear"""
        act = str(m.get("action", "list"))
        if act != "list" and self.control != c.id:
            return "this browser doesn't have control (take it first)"
        try:
            res = await self.run(self.m.cmd_teach, act, m.get("index"))
        except ValueError as e:
            return str(e)
        if act != "list":
            self.broadcast(self.files_msg())
        return res

    async def op_arm_home(self, c, m):
        err = await self.run(self.m.cmd_arm_home, m.get("rate"))
        if not err:
            self.event("info", "Go home: every joint to its home pose")
        return err

    async def op_model_get(self, c, m):
        loop = asyncio.get_event_loop()
        data, mtime = await loop.run_in_executor(self.ppool, self.m.model_read, m["name"])
        return {"name": m["name"], "mtime": mtime, "data": base64.b64encode(data).decode()}

    async def op_hal_list(self, c, m):
        loop = asyncio.get_event_loop()
        return await loop.run_in_executor(self.ppool, self.m.hal_list)

    async def op_hal_watch(self, c, m):
        """This browser's watch list: its values come as "hal" messages at HAL_HZ."""
        names = [str(n) for n in (m.get("names") or [])][:128]
        if names:
            self.hal_watch[c.id] = names
        else:
            self.hal_watch.pop(c.id, None)
        return {"values": self.m.hal_values(names)} if names and self.m.hal else None

    async def op_hal_values(self, c, m):
        """Once: the values of these (the HAL page's rows on screen)."""
        return {"values": self.m.hal_values([str(n) for n in (m.get("names") or [])][:1000]) if self.m.hal else {}}

    async def op_hal_set(self, c, m):
        err = await self.run(self.m.cmd_hal_set, m["name"], m["value"], m.get("kind", "pin"))
        if not err:
            self.event("warn", "HAL: %s %s = %s (by %s)" % ("sets" if m.get("kind") == "sig" else "setp", m["name"], m["value"], c.name))
        return err

    async def hal_loop(self):
        """The watched HAL values, to each browser that watches some."""
        period = 1.0 / max(1.0, self.cfg.num("MILLWEB", "HAL_HZ", 10.0))
        while not (self.quit and self.quit.is_set()):
            if self.hal_watch and self.m.hal:
                for cid, names in list(self.hal_watch.items()):
                    c = self.clients.get(cid)
                    if c is None:
                        self.hal_watch.pop(cid, None)
                        continue
                    asyncio.ensure_future(c.ws.send(json.dumps({"t": "hal", "v": self.m.hal_values(names)}, separators=(",", ":"))))
            await asyncio.sleep(period)

    # the scope: a sampler process per browser that scopes (two at most)
    async def op_scope_start(self, c, m):
        names = [str(n) for n in (m.get("names") or [])][:8]
        if not names:
            return "the scope needs a channel"
        await self.scope_stop(c.id)
        if len(self.scopes) >= 2:
            return "two scopes run already (another browser's)"
        rate = max(10.0, min(2000.0, float(m.get("rate", 1000))))
        proc = await asyncio.create_subprocess_exec(*self.sampler_cmd, stdin=asyncio.subprocess.PIPE,
                                                    stdout=asyncio.subprocess.PIPE, stderr=asyncio.subprocess.DEVNULL)
        proc.stdin.write((json.dumps({"names": names, "rate": rate}) + "\n").encode())
        await proc.stdin.drain()
        self.scopes[c.id] = proc
        asyncio.ensure_future(self.scope_relay(c, proc, names))
        return {"names": names, "rate": rate}

    async def scope_relay(self, c, proc, names):
        """The sampler's frames to its browser, as {"t": "scope", n, rate, missed, t0, d (base64 float32)}."""
        import struct
        try:
            while True:
                head = await proc.stdout.readexactly(4)
                body = await proc.stdout.readexactly(struct.unpack("<I", head)[0])
                line, _, data = body.partition(b"\n")
                h = json.loads(line)
                msg = dict(h, t="scope", names=names, d=base64.b64encode(data).decode())
                await c.ws.send(json.dumps(msg, separators=(",", ":")))
                if h.get("error"):
                    break
        except (asyncio.IncompleteReadError, ConnectionError, ValueError):
            pass
        finally:
            if self.scopes.get(c.id) is proc:
                await self.scope_stop(c.id)

    async def scope_stop(self, cid):
        """SIGTERM, not SIGKILL: a sampler killed inside hal.get_value leaves HAL's
        mutex locked and every HAL user hung (see sampler.py)."""
        proc = self.scopes.pop(cid, None)
        if proc and proc.returncode is None:
            proc.terminate()
            try:
                await asyncio.wait_for(proc.wait(), 3)
            except asyncio.TimeoutError:
                self.event("warn", "Scope: the sampler didn't stop, killed")
                proc.kill()
                await proc.wait()

    async def op_scope_stop(self, c, m):
        await self.scope_stop(c.id)

    # ------------------------------------------------------------ stmbl drives
    def drive_out(self, link, text):
        """What a drive printed: to the browsers that show its console."""
        who = {cid for cid, n in self.drive_watch.items() if n == link.name}
        if who:
            self.broadcast({"t": "dout", "n": link.name, "text": text}, only=who)

    def drive_status(self):
        pin = self.m._pin if self.m.hal else None
        out = []
        for l in self.links.values():
            st = l.status(pin)
            st["fw_want"] = self.fw_want
            st["problems"] = driveconf.problems(st.get("ver"), self.fw_want)
            st["job"] = self.drive_jobs.get(l.name)
            said = tuple(p["text"] for p in st["problems"])
            if said != self.fw_said.get(l.name, ()):  # new problems: into the event log, once
                for p in st["problems"]:
                    if p["text"] not in self.fw_said.get(l.name, ()):
                        self.event(p["level"], "Drive %s: %s" % (l.name, p["text"]))
                self.fw_said[l.name] = said
            out.append(st)
        return out

    def drive_blockers(self):
        """The drives' problems that keep the machine off ([MILLWEB] DRIVE_FW_BLOCK)."""
        if not self.fw_block:
            return []
        return ["drive %s: %s" % (st["n"], p["text"]) for st in self.drive_status() for p in st["problems"] if p["block"]]

    async def drive_loop(self):
        """The drives' consoles: open, ask, and the cards twice a second."""
        loop = asyncio.get_event_loop()
        for l in self.links.values():
            l.loop = loop
            l.open()
        n = 0
        while not (self.quit and self.quit.is_set()):
            try:
                for l in self.links.values():
                    l.tick()
                n += 1
                if n % 10 == 0 and self.links:
                    msg = {"t": "drv", "drives": self.drive_status()}
                    sig = json.dumps(msg)
                    if sig != self.drive_sig:
                        self.drive_sig = sig
                        self.broadcast(msg)
            except Exception as e:
                self.event("bad", "millweb: drives: %r" % e)
            await asyncio.sleep(0.05)
        for l in self.links.values():
            l.close()

    def link_of(self, m):
        l = self.links.get(str(m.get("name")))
        if l is None:
            raise ValueError("no drive %r ([MILLWEB] DRIVE_LINK)" % m.get("name"))
        return l

    async def op_drive_watch(self, c, m):
        """Show a drive's console in this browser (name), or none (name null): what it has said so far."""
        if m.get("name") is None:
            self.drive_watch.pop(c.id, None)
            return None
        l = self.link_of(m)
        self.drive_watch[c.id] = l.name
        return {"scroll": l.scroll, "drive": l.status(self.m._pin if self.m.hal else None)}

    async def op_drive_cmd(self, c, m):
        """A line for a drive's console. Reading for everyone; anything else with
        control and DRIVE_WRITE, and what moves, restarts or rewrites the drive
        only with sure: true."""
        l = self.link_of(m)
        cmd = str(m.get("cmd", "")).strip()
        kind, why = drives_mod.classify(cmd)
        if kind is None:
            return why
        if kind != "read":
            if not self.drive_write:
                return "only reading: writing to drives is off ([MILLWEB] DRIVE_WRITE = yes turns it on)"
            if self.control != c.id:
                return "this browser doesn't have control (take it first)"
            if kind == "danger" and not m.get("sure"):
                return "confirm: %r can move the motor, restart the drive or rewrite its flash" % cmd.split()[0]
        if time.time() - getattr(c, "drive_last", 0) < 0.2:
            return "one line at a time (the link is slow)"
        c.drive_last = time.time()
        self.drive_watch.setdefault(c.id, l.name)
        err = l.user(cmd)
        if not err and kind != "read":
            self.event("warn", "Drive %s: %s (by %s)" % (l.name, cmd, c.name))
        return err

    async def op_drive_conf(self, c, m):
        """A drive's flash config (driveconf.py): backups (list), backup (read and keep), plan (the patch to this
        console's firmware, nothing written), patch, restore {backup}: the last two with DRIVE_WRITE, sure, the
        machine off; each keeps what was there first."""
        l = self.link_of(m)
        act = str(m.get("action", ""))
        base = self.conf.mdir if self.conf else self.cfg.dir
        if act == "backups":
            return {"backups": driveconf.list_backups(base, l.name)}
        if act not in ("backup", "plan", "patch", "restore", "reset"):
            return "action: backups, backup, plan, patch, restore or reset"
        if act in ("patch", "restore", "reset"):
            if not self.drive_write:
                return "writing to drives is off ([MILLWEB] DRIVE_WRITE = yes turns it on)"
            if self.state.get("on"):
                return "switch the machine off first (the drive must be disabled)"
            if not m.get("sure"):
                return "confirm: %s rewrites the drive's flash config" % act if act != "reset" else "confirm: the drive restarts"
        if l.name in self.drive_jobs:
            return "drive %s is busy: %s" % (l.name, self.drive_jobs[l.name])
        if l.fd is None:
            return "drive %s: its console isn't open (%s)" % (l.name, l.state)
        self.drive_jobs[l.name] = act
        l.busy = True
        self.drive_sig = None
        try:
            if act == "reset":
                l.user("reset")
                l.ver = None
                l.ver_due = time.time() + 3
                self.event("warn", "Drive %s: reset (by %s)" % (l.name, c.name))
                return None
            text = await driveconf.read_conf(l)
            if not text.strip():
                return "drive %s answered no config (showconf)" % l.name
            if act == "backup":
                fn = driveconf.save_backup(base, l.name, text, l.ver, "backup")
                self.event("ok", "Drive %s: config backed up as %s" % (l.name, fn))
                return {"backup": fn, "backups": driveconf.list_backups(base, l.name), "text": text}
            if act == "plan" or act == "patch":
                if not driveconf.stmblconf:
                    return "tools/stmblconf.py isn't here: the console's checkout has no firmware tree"
                to = int(m.get("to") or (l.ver or {}).get("fw") or self.fw_want or 0)
                try:
                    new, steps = driveconf.stmblconf.migrate(text, to)
                except driveconf.stmblconf.Conflict as e:
                    return "can't patch: %s" % e
                plan = {"from": driveconf.stmblconf.version_of(text), "to": to, "steps": steps, "current": text, "new": driveconf.clean(new)}
                if act == "plan":
                    return plan
                fn = driveconf.save_backup(base, l.name, text, l.ver, "before patch")
                await driveconf.write_conf(l, new, lambda s: self.drive_progress(l, s))
                self.event("warn", "Drive %s: config patched v%d → v%d by %s (the one before: %s); it runs from the drive's next start" % (l.name, plan["from"], to, c.name, fn))
                return dict(plan, backup=fn, backups=driveconf.list_backups(base, l.name))
            # restore
            old = driveconf.read_backup(base, l.name, m.get("backup"))
            fn = driveconf.save_backup(base, l.name, text, l.ver, "before restore")
            await driveconf.write_conf(l, old, lambda s: self.drive_progress(l, s))
            self.event("warn", "Drive %s: config %s restored by %s (the one before: %s); it runs from the drive's next start" % (l.name, m.get("backup"), c.name, fn))
            return {"backup": fn, "backups": driveconf.list_backups(base, l.name)}
        except RuntimeError as e:
            self.event("bad", "Drive %s: %s failed: %s" % (l.name, act, e))
            return "%s failed: %s" % (act, e)
        finally:
            l.busy = False
            self.drive_jobs.pop(l.name, None)
            l.ver_due = min(l.ver_due, time.time() + 1)  # its versions again
            self.drive_sig = None

    def drive_progress(self, l, text):
        self.drive_jobs[l.name] = "writing: %s" % text
        self.drive_sig = None

    async def op_drive_detach(self, c, m):
        """Let another program have a drive's console (on: true, for at most `seconds`), or take it back."""
        l = self.link_of(m)
        if m.get("on", True):
            secs = max(10, min(3600, int(m.get("seconds", 600))))
            l.detach(c.name, secs)
            self.event("warn", "Drive %s: console left to other programs for %d min (by %s): %s" % (l.name, secs // 60, c.name, l.path))
        else:
            if not l.attach():
                return "can't open %s: %s" % (l.path, l.err)
            self.event("info", "Drive %s: console back with millweb (by %s)" % (l.name, c.name))
        self.drive_sig = None
        return None

    # ------------------------------------------------------------ the machine's configuration (millweb-supervisor)
    def need_conf(self):
        if not self.conf:
            raise ValueError("this LinuxCNC isn't run by millweb-supervisor: configure it through its INI")
        return self.conf

    # ------------------------------------------------------------ vibration sensors (vibmon)
    def vib_state(self, up):
        self.event("info" if up else "warn", "Vibration sensors: vibmon %s" % ("connected" if up else "not reachable"))
        self.broadcast({"t": "vib", "up": up, "status": None})

    def vib_msg(self, m):
        """What vibmon says: the status to every browser; alarms into the event
        log; spectra, trends and console text to the browsers too."""
        t = m.get("type")
        if t == "status":
            self.broadcast({"t": "vib", "up": True, "status": m})
        elif t == "event":
            e = m["event"]
            k, key = e.get("type"), e.get("key", "?")
            if k == "event:crash":
                self.event("bad", "Vibration: CRASH at the %s sensor (%.1f g)" % (key, e.get("x", 0)))
            elif k in ("event:level", "event:temp"):
                what = "vibration" if k == "event:level" else "temperature"
                v = e.get("value", 0)
                if self.vib_said.get((key, k)) != v:
                    self.vib_said[(key, k)] = v
                    self.event(("info", "warn", "bad")[min(v, 2)], "Vibration: %s at the %s sensor %s (%.1f %s)" % (
                        what, key, ("back to normal", "WARN", "ALARM")[min(v, 2)], e.get("x", 0), "mm/s" if k == "event:level" else "°C"))
            elif k == "lost":
                self.event("warn", "Vibration: the %s sensor is silent" % key)
            elif k == "back":
                self.event("info", "Vibration: the %s sensor is back" % key)
            elif k == "numbering":
                self.event("info", "Vibration: sensor %s %s" % (e.get("uid", "")[-6:], e.get("what", "")))
            elif k == "spectrum" and self.vib:
                self.vib.send({"cmd": "get_spectrum", "node": e.get("node")})
            self.broadcast({"t": "vibev", "event": e})
        elif t in ("spectrum", "trend", "console"):
            self.broadcast(dict(m, t="vib" + t))
        elif t == "error":
            self.event("warn", "vibmon: %s: %s" % (m.get("cmd"), m.get("error")))

    def vib_machine(self, st):
        """The machine state to vibmon, for the sensors' order tracking: spindle
        speed, feed, tool and its teeth (a "3-flute" in the tool's comment),
        five times a second. Off with [MILLWEB] VIBMON_STATE = no (vibmon --hal
        reads it from HAL instead)."""
        if not (self.vib and self.vib.up and self.vib_state_on):
            return
        sp = st.get("spin") or {}
        m = {"rpm": float(sp.get("s") or 0), "spindle": bool(sp.get("enabled")), "feed": float(st.get("vel") or 0),
             "tool": int(st.get("tool") or 0), "running": st.get("run") == "run"}
        teeth = self.tool_teeth(m["tool"])
        if teeth:
            m["teeth"] = teeth
        t = time.time()
        if m != self.vib_last_machine or t - self.vib_last_sent > 0.2:
            self.vib_last_machine, self.vib_last_sent = m, t
            self.vib.send(dict(m, cmd="machine"))

    def tool_teeth(self, tool):
        if self.vib_teeth[0] != tool:  # the tool table is read when the tool changes
            self.vib_teeth = (tool, self.find_teeth(tool))
        return self.vib_teeth[1]

    def find_teeth(self, tool):
        for t in (self.tools_msg().get("tools") or []):
            if t.get("t") == tool:
                mt = re.search(r"(\d+)[- ]?(?:flute|fl\b|teeth|tooth|z\b)", str(t.get("comment", "")), re.I)
                return int(mt.group(1)) if mt else None
        return None

    def vib_send(self, cmd):
        if not self.vib:
            return "no vibration sensors here ([MILLWEB] VIBMON)"
        return self.vib.send(cmd)

    async def op_vib_spectrum(self, c, m):
        """Ask a sensor for its spectrum: it comes as a "vibspectrum" message."""
        return self.vib_send({"cmd": "spectrum", "node": int(m["node"])})

    async def op_vib_trend(self, c, m):
        return self.vib_send({"cmd": "trend", "node": int(m["node"])})

    async def op_vib_console_read(self, c, m):
        return self.vib_send({"cmd": "console_read", "node": int(m["node"])})

    async def op_vib_console(self, c, m):
        """A console line to a sensor (its parameters): with control."""
        line = str(m.get("line", "")).strip()
        if not line or len(line) > 120:
            return "a console line of 1..120 characters"
        self.event("info", "%s to vibration sensor %s: %s" % (c.name, m.get("node"), line))
        return self.vib_send({"cmd": "console", "node": int(m["node"]), "line": line})

    async def op_vib_reset(self, c, m):
        self.event("info", "%s reset the vibration crash alarm" % c.name)
        return self.vib_send({"cmd": "reset", "node": m.get("node")})

    async def op_vib_identify(self, c, m):
        return self.vib_send({"cmd": "identify", "on": bool(m.get("on", True))})

    async def op_vib_assign(self, c, m):
        return self.vib_send({"cmd": "assign", "uid": str(m["uid"]), "name": m.get("name"), "position": m.get("position")})

    async def op_vib_replace(self, c, m):
        return self.vib_send({"cmd": "replace", "old": str(m["old"]), "new": str(m["new"])})

    async def op_vib_rescan(self, c, m):
        return self.vib_send({"cmd": "rescan"})

    async def op_sup_status(self, c, m):
        return {"status": self.need_conf().status()}

    async def op_log_get(self, c, m):
        return self.need_conf().log(int(m.get("which", 0)), int(m.get("n", 400)))

    async def op_config_get(self, c, m):
        return await self.run_bg(self.need_conf().get)

    async def op_config_check(self, c, m):
        return await self.run_bg(self.need_conf().check, str(m.get("text", "")), str(m.get("custom", "")))

    async def op_config_version(self, c, m):
        return self.need_conf().version(m.get("version"))

    async def op_config_save(self, c, m):
        """machine.json and custom.hal saved; with restart: true, LinuxCNC restarts with them."""
        conf = self.need_conf()
        if m.get("restart"):
            err = self.restart_refused()
            if err:
                return err
        err, hid = await self.run_bg(conf.save, str(m.get("text", "")), str(m.get("custom", "")), c.name, str(m.get("note", ""))[:200])
        if err:
            return err
        self.event("ok", "machine.json saved by %s" % c.name)
        if m.get("restart"):
            self.lcnc_end("restart", c)
        return {"version": hid}

    async def op_bitstream_save(self, c, m):
        conf = self.need_conf()
        err = await self.run_bg(conf.bitstream_save, m.get("name"), m.get("data", ""))
        return err or {"bitstreams": conf.bitstreams()}

    async def op_bitstream_delete(self, c, m):
        conf = self.need_conf()
        return conf.bitstream_delete(m.get("name")) or {"bitstreams": conf.bitstreams()}

    async def op_mmodel_get(self, c, m):
        return await self.run_bg(self.need_conf().model_get, m.get("name"))

    async def op_mmodel_save(self, c, m):
        conf = self.need_conf()
        err = await self.run_bg(conf.model_save, m.get("name"), m.get("data", ""))
        return err or {"models": conf.models()}

    async def op_mmodel_delete(self, c, m):
        conf = self.need_conf()
        return conf.model_delete(m.get("name")) or {"models": conf.models()}

    def restart_refused(self):
        if self.state.get("run") in ("run", "hold", "step"):
            return "a program is running: stop it first"
        return None

    def lcnc_end(self, why, c):
        """LinuxCNC ends (millweb quits, it follows); the supervisor starts it again (restart) or waits (stop)."""
        self.conf.request(why)
        self.event("warn", "LinuxCNC %s by %s" % ("restarts" if why == "restart" else "stops", c.name))
        self.broadcast({"t": "sup", "status": dict(self.conf.status(), state="restarting" if why == "restart" else "stopping")})
        asyncio.get_event_loop().call_later(0.5, self.quit.set)

    async def op_lcnc_restart(self, c, m):
        self.need_conf()
        err = self.restart_refused()
        if err:
            return err
        self.lcnc_end("restart", c)

    async def op_lcnc_stop(self, c, m):
        self.need_conf()
        err = self.restart_refused()
        if err:
            return err
        self.lcnc_end("stop", c)

    async def run_bg(self, fn, *a):
        return await asyncio.get_event_loop().run_in_executor(self.ppool, lambda: fn(*a))

    async def shutdown(self):
        """Before millweb exits (LinuxCNC follows): the scopes' samplers out of HAL, the drives' consoles closed."""
        for cid in list(self.scopes):
            await self.scope_stop(cid)
        for l in self.links.values():
            l.close()

    async def op_views_save(self, c, m):
        """The Debug page's views: saved for every browser (no control needed: they don't touch the machine)."""
        err = await self.run(self.m.cmd_views_save, m["views"])
        if not err:
            self.broadcast({"t": "views", "views": self.m.views()})
        return err

    async def op_setup_save(self, c, m):
        """The objects on the table for the 3D view: every browser gets them."""
        err = await self.run(self.m.cmd_setup_save, m["objects"], m.get("tools"), m.get("lathe"))
        if not err:
            self.broadcast(self.setup_msg())
        return err

    async def op_folder_create(self, c, m):
        err = await self.run(self.m.cmd_folder_create, m["name"])
        if not err:
            self.event("info", "New folder %s" % m["name"])
            self.broadcast(self.files_msg())
        return err

    async def op_folder_delete(self, c, m):
        err = await self.run(self.m.cmd_folder_delete, m["name"])
        if not err:
            self.event("info", "Deleted folder %s" % m["name"])
            self.broadcast(self.files_msg())
        return err

    async def op_program_load(self, c, m):
        err = await self.run(self.m.cmd_program_load, m["name"])
        if not err:
            self.event("ok", "Loaded %s" % m["name"])
            # its preview, also when it is the same file again (edited on disk since?)
            self.program_file = self.m._safe(m["name"])
            asyncio.ensure_future(self.send_preview(self.program_file))
        return err

    async def op_pcomp(self, c, m):
        return await self.run(self.m.cmd_pcomp, m["k"], m["v"])

    # ------------------------------------------------------------ data
    def setup_msg(self):
        return {"t": "setup", "objects": self.m.setup(), "tools": self.m.setup_tools(), "lathe": self.m.setup_lathe()}

    def files_msg(self):
        files, dirs = self.m.programs()
        return {"t": "files", "files": files, "dirs": dirs}

    def tools_msg(self):
        return {"t": "tools", "tools": self.m.tools()}

    def offsets_msg(self):
        return {"t": "offsets", "offsets": self.m.offsets, "g92": self.m.g92, "wcs": self.state.get("wcs", 0)}

    def read_lines(self, path, start, count):
        """(lines start ... start+count-1, how many lines), through an index of
        every 1000th line's offset, so line 900 000 of a 30 MB file is quick."""
        st = os.stat(path)
        ix = self.line_index.get(path)
        if not ix or ix[0] != st.st_mtime or ix[1] != st.st_size:
            offs, n, pos = [0], 0, 0
            with open(path, "rb") as f:
                for line in f:
                    n += 1
                    pos += len(line)
                    if n % 1000 == 0:
                        offs.append(pos)
            ix = (st.st_mtime, st.st_size, offs, n)
            self.line_index = {path: ix}  # the last file only
        offs, n = ix[2], ix[3]
        k = min((start - 1) // 1000, len(offs) - 1)
        out = []
        with open(path, "rb") as f:
            f.seek(offs[k])
            ln = k * 1000
            for line in f:
                ln += 1
                if ln >= start:
                    out.append(line.decode("utf-8", "replace").rstrip("\r\n"))
                    if len(out) >= count:
                        break
        return out, n

    async def preview(self, path, full=False):
        """(the program message as JSON text, its header): from LinuxCNC's
        interpreter in a child process (preview.py); cached; one at a time per file.
        full: every move, none merged (the full simulation's; not kept in the cache: it can be tens of MB)."""
        s = self.state
        active = [round(s.get("g5x", [0, 0, 0])[i] + s.get("g92", [0, 0, 0])[i], 4) for i in range(3)]
        tl = self.m.tools()
        try:
            st = os.stat(path)
            key = (path, st.st_mtime, st.st_size, tuple(active), json.dumps(tl), s.get("wcs", 0), full)
        except OSError:
            key = (path, None, full)
        if key in self.pv_cache:
            return self.pv_cache[key]
        if key in self.pv_running:
            return await asyncio.shield(self.pv_running[key])
        fut = asyncio.get_event_loop().create_future()
        self.pv_running[key] = fut
        try:
            async with self.pv_sem:
                res = await self._preview_child(path, active, tl, full)
            if not full:
                self.pv_cache[key] = res
            while len(self.pv_cache) > 3:
                self.pv_cache.pop(next(iter(self.pv_cache)))
            fut.set_result(res)
            return res
        except BaseException as e:
            fut.set_exception(e)
            raise
        finally:
            del self.pv_running[key]
            if fut.done() and not fut.cancelled():
                fut.exception()  # retrieved: no "never retrieved" warning

    async def _preview_child(self, path, active, tl, full=False):
        # the INI's startup code first (a lathe: G18 G7, X words as diameters); a lathe tool's X offset, angles, orientation
        req = {"path": path, "var": self.m.var_file, "unitcode": "G21", "active": active,
               "initcode": self.cfg.get("RS274NGC", "RS274NGC_STARTUP_CODE", "") or "",
               "tools": {t["t"]: (t["t"], t.get("x", 0.0) / 25.4, 0.0, t["z"] / 25.4, 0, 0, 0, 0, 0, 0, t["d"] / 25.4,
                                  t.get("i", 0.0), t.get("j", 0.0), t.get("q", 0)) for t in tl},
               "pockets": [t["t"] for t in tl], "max_segs": self.pv_full_segs if full else self.pv_segs,
               "timeout": self.pv_full_timeout if full else self.pv_timeout,
               "rapid": self.m.maxv * 60, "acc": self.cfg.num("TRAJ", "MAX_LINEAR_ACCELERATION", 1000.0),
               "spindle_max": self.cfg.num("SPINDLE_0", "MAX_FORWARD_VELOCITY", 24000.0)}
        head, ptext = {"error": None, "truncated": None, "stats": None, "lines": 0, "start": [0, 0, 0]}, "[]"
        nice = int(self.cfg.num("MILLWEB", "PREVIEW_NICE", 10))
        proc = await asyncio.create_subprocess_exec(sys.executable, preview.__file__, stdin=asyncio.subprocess.PIPE,
                                                    stdout=asyncio.subprocess.PIPE, stderr=asyncio.subprocess.PIPE,
                                                    preexec_fn=(lambda: os.nice(nice)) if nice > 0 else None)
        try:
            out, err = await asyncio.wait_for(proc.communicate(json.dumps(req).encode()), req["timeout"] + 30)
        except asyncio.TimeoutError:
            proc.kill()
            await proc.wait()
            out, err = b"", b"no answer in time"
        first, _, rest = out.partition(b"\n")
        try:
            head.update(json.loads(first))
            ptext = rest.decode().strip() or "[]"
        except ValueError:
            tail = err.decode(errors="replace").strip().splitlines()[-1:] or ["exit %s" % proc.returncode]
            head["error"] = "the preview failed: %s" % tail[0]
        loop = asyncio.get_event_loop()
        try:
            lines, n = await loop.run_in_executor(self.ppool, self.read_lines, path, 1, 2000)
        except OSError:
            lines, n = [], 0
        msg = {"t": "program", "name": self.m.relpath(path), "path": path, "lines": lines, "line0": 1, "nlines": n,
               "error": head["error"], "truncated": head["truncated"], "stats": head["stats"], "start": head["start"],
               "wcs": self.state.get("wcs", 0), "seconds": head.get("seconds"), "full": full}
        return json.dumps(msg, separators=(",", ":"))[:-1] + ',"path":' + ptext + "}", msg

    # ------------------------------------------------------------ loops
    async def resync(self):
        self.resyncing = True
        try:
            note = await self.run(self.m.resync_offsets)
            if note:
                self.event("warn", note)
                self.broadcast(self.offsets_msg())
        finally:
            await asyncio.sleep(2.0)  # not again at once if it didn't help
            self.resyncing = False

    async def send_preview(self, path):
        """The loaded program's preview to every browser (in the background:
        a long program doesn't hold up the status)."""
        try:
            text, head = await self.preview(path)
        except Exception as e:
            self.event("bad", "Preview: %s" % e)
            return
        if path != self.program_file:
            return  # another program was loaded meanwhile
        self.program = text
        self.broadcast_raw(text)
        if head["error"]:
            self.event("warn", "Preview: %s" % head["error"])
        if head["truncated"]:
            self.event("warn", "Preview: %s" % head["truncated"])

    def broadcast_raw(self, text):
        for c in list(self.clients.values()):
            asyncio.ensure_future(c.ws.send(text))

    async def poll_loop(self):
        loop = asyncio.get_event_loop()
        period = 1.0 / max(self.poll_hz, 1.0)
        prev = {}
        while not (self.quit and self.quit.is_set()):
            t0 = time.time()
            try:
                st = self.m.status()
            except Exception as e:  # LinuxCNC gone
                self.event("bad", "LinuxCNC status: %s" % e)
                await asyncio.sleep(1.0)
                continue
            self.state = st
            diff = {k: v for k, v in st.items() if prev.get(k) != v}
            if diff:
                self.broadcast({"t": "st", **diff})
            # transitions worth an event
            if prev:
                if st["estop"] != prev.get("estop"):
                    self.event("bad" if st["estop"] else "ok", "E-STOP" if st["estop"] else "E-STOP released")
                if st["run"] == "done" and prev.get("run") in ("run", "hold"):
                    self.event("ok", "Program finished: %s" % os.path.basename(st["file"] or ""))
                if st["homed"] != prev.get("homed") and all(st["homed"]):
                    self.event("ok", "All axes homed")
            prev = st
            self.vib_machine(st)
            # a new program: its preview, once
            if st.get("file") and st["file"] != self.program_file:
                self.program_file = st["file"]
                asyncio.ensure_future(self.send_preview(st["file"]))
            # the status without a work offset (DEBUGNOTES): fix it when the machine allows
            if self.m.wcs_unknown and st["run"] == "idle" and all(st["homed"]) and not self.resyncing:
                asyncio.ensure_future(self.resync())
            # the enabling switch let go: every jog stops (LinuxCNC's jog-stop stops its own; a tool-frame jog is an MDI move)
            if self.jog_seen and self.m.enable_released():
                self.jog_seen.clear()
                await self.urgent(self.m.cmd_jog_stop)
                self.event("warn", "Jog stopped: the enabling switch was released")
            # the jog deadman
            for a, seen in list(self.jog_seen.items()):
                if time.time() - seen > JOG_DEADMAN:
                    self.jog_seen.pop(a, None)
                    await self.urgent(self.m.cmd_jog_stop, a)
                    self.event("warn", "Jog %s stopped: no keep-alive from the browser" % a.upper())
            await asyncio.sleep(max(0.0, period - (time.time() - t0)))

    async def slow_loop(self):
        while not (self.quit and self.quit.is_set()):
            try:
                for lvl, text in self.m.events():
                    self.event(lvl, text)
                sl = self.m.slow()
                diff = {k: v for k, v in sl.items() if self.slow_state.get(k) != v}
                self.slow_state = sl
                if diff:
                    self.broadcast({"t": "slow", **diff})
                if sl.get("remote") is False and self.control:
                    c = self.clients.get(self.control)
                    self.control = None
                    self.broadcast({"t": "control", "holder": None})
                    self.event("warn", "Remote control switched off at the machine")
                if self.conf:  # the supervisor's state (run/status.json) to every browser when it changes
                    try:
                        mt = os.path.getmtime(os.path.join(self.conf.mdir, "run", "status.json"))
                    except OSError:
                        mt = None
                    if mt != getattr(self, "sup_mtime", None):
                        self.sup_mtime = mt
                        self.broadcast({"t": "sup", "status": self.conf.status()})
                fm = self.files_msg()
                fs = json.dumps(fm)
                if fs != self.files_sig:
                    self.files_sig = fs
                    self.broadcast(fm)
                try:
                    ts = os.path.getmtime(self.m.tool_file)
                except OSError:
                    ts = None
                if ts != self.tools_sig:
                    self.tools_sig = ts
                    self.broadcast(self.tools_msg())
            except Exception as e:
                self.event("bad", "millweb: %s" % e)
            await asyncio.sleep(0.5)


def make_ssl(cfg):
    cert, key = cfg.file("MILLWEB", "CERT"), cfg.file("MILLWEB", "KEY")
    if not cert:
        return None
    ctx = ssl.create_default_context(ssl.Purpose.CLIENT_AUTH)
    ctx.load_cert_chain(cert, key)
    return ctx


async def amain(args):
    import linuxcnc
    try:
        import hal
        h = hal.component("millweb")
        h.ready()
    except Exception:
        hal = None
    cfg = machine_mod.Config(args.ini)
    m = machine_mod.Machine(cfg, linuxcnc, hal)
    quit_event = asyncio.Event()
    hub = Hub(m, cfg, quit_event)
    host = args.host or cfg.get("MILLWEB", "HOST", "0.0.0.0")
    port = args.port or int(cfg.num("MILLWEB", "PORT", 8080))
    srv = wsserver.Server(WEBROOT, hub.handle, ssl=make_ssl(cfg))
    server = await srv.serve(host, port)
    print("millweb: http%s://%s:%d/ (%s)" % ("s" if srv.ssl else "", host, port, cfg.path), flush=True)
    hub.event("info", "millweb %s up on port %d" % (VERSION, port))
    if getattr(args, "pinned", None):
        hub.event("info", args.pinned)
    loop = asyncio.get_event_loop()
    for sig in (signal.SIGINT, signal.SIGTERM):
        try:
            loop.add_signal_handler(sig, quit_event.set)
        except NotImplementedError:
            pass
    tasks = [asyncio.ensure_future(hub.poll_loop()), asyncio.ensure_future(hub.slow_loop()), asyncio.ensure_future(hub.hal_loop()),
             asyncio.ensure_future(hub.drive_loop())]
    if hub.vib:
        tasks.append(asyncio.ensure_future(hub.vib.run(hub.quit)))
    await quit_event.wait()
    await hub.shutdown()
    for t in tasks:
        t.cancel()
    server.close()


def cpu_list(text):
    """"0", "0,2", "0-1" -> {0}, {0, 2}, {0, 1}."""
    out = set()
    for part in str(text).replace(" ", "").split(","):
        if part:
            a, _, b = part.partition("-")
            out.update(range(int(a), int(b or a) + 1))
    return out


def pin(cfg):
    """[MILLWEB] CPUS: millweb, its threads and its preview processes on these
    cores only, off LinuxCNC's real-time one. Before any thread starts."""
    cpus = cfg.get("MILLWEB", "CPUS")
    if not cpus:
        return None
    try:
        os.sched_setaffinity(0, cpu_list(cpus))
        return "millweb on CPU %s" % ",".join(map(str, sorted(os.sched_getaffinity(0))))
    except (ValueError, OSError) as e:
        return "[MILLWEB] CPUS = %s: %s" % (cpus, e)


def main():
    ap = argparse.ArgumentParser(prog="millweb", description="Browser console backend for LinuxCNC")
    ap.add_argument("-ini", "--ini", dest="ini", default=os.environ.get("INI_FILE_NAME"))
    ap.add_argument("--host")
    ap.add_argument("--port", type=int)
    args, _ = ap.parse_known_args()
    if not args.ini:
        ap.error("the machine's INI file: -ini FILE (or INI_FILE_NAME)")
    args.pinned = pin(machine_mod.Config(args.ini))
    asyncio.run(amain(args))


if __name__ == "__main__":
    main()
