brdmaker/stmbl/servoterm-cli/setup/su_steps.c

#include "su_steps.h"
#include "su_conf.h"
#include "su_feedback.h"
#include "su_motor.h"
#include "su_version.h"
#include "su_wiring.h"

#include <math.h>
#include <stdarg.h>
#include <stdio.h>
#include <stdlib.h>
#include <string.h>
#include <sys/time.h>
#include <time.h>

// fault0.state (shared/common.h state_t)
#define ST_DISABLED 0
#define ST_ENABLED 1
#define ST_SOFT_FAULT 3

// ---- helpers ---------------------------------------------------------------

static void say(su_wizard_t *w, su_msg_t kind, const char *fmt, ...) {
  char buf[4096];
  va_list ap;
  va_start(ap, fmt);
  vsnprintf(buf, sizeof(buf), fmt, ap);
  va_end(ap);
  w->ui->say(w->ui->user, kind, buf);
}

static double now(void) {
  struct timeval tv;
  gettimeofday(&tv, NULL);
  return tv.tv_sec + tv.tv_usec / 1e6;
}

// wait for drive time t (wall time t / time_scale), reading the drive
static void drive_sleep(su_wizard_t *w, double t) {
  su_link_pump(w->link, t / (w->time_scale > 1.0 ? w->time_scale : 1.0));
}

static const char *out_path(su_wizard_t *w, const char *name, char *buf, size_t len) {
  snprintf(buf, len, "%s/%s", w->out_dir ? w->out_dir : ".", name);
  return buf;
}

static void stamp(char *buf, size_t len, const char *fmt) {
  time_t t = time(NULL);
  strftime(buf, len, fmt, localtime(&t));
}

// a number: the session's value is the suggestion (resume); returns
// 0, SU_UNKNOWN (key unset) or SU_ABORT
static int ask_num(su_wizard_t *w, const char *key, const char *q, const char *unit, double def, double min,
                   double max, int unknown_ok, double *out) {
  double d = su_get_num(w->st, key, def);
  int r    = w->ui->number(w->ui->user, key, q, unit, d, min, max, unknown_ok, out);
  if(r == 0) {
    su_set_num(w->st, key, *out);
  } else if(r == SU_UNKNOWN) {
    su_set(w->st, key, "unknown");
  }
  return r;
}

// one of ids[], shown as names[]; stores the id
static int ask_choice(su_wizard_t *w, const char *key, const char *q, const char *const *ids,
                      const char *const *names, int n, int def, int *out) {
  const char *cur = su_get(w->st, key);
  for(int i = 0; cur && i < n; i++) {
    if(strcmp(ids[i], cur) == 0) {
      def = i;
    }
  }
  int r = w->ui->choose(w->ui->user, key, q, ids, names, n, def, out);
  if(r == 0) {
    su_set(w->st, key, ids[*out]);
  }
  return r;
}

static int ask_yes(su_wizard_t *w, const char *key, const char *q, int *yes) {
  int r = w->ui->confirm(w->ui->user, key, q, yes);
  if(r == 0) {
    su_set_num(w->st, key, *yes);
  }
  return r;
}

static int get(su_wizard_t *w, const char *pin, double *v) {
  if(su_link_get(w->link, pin, v) < 0) {
    say(w, SU_MSG_ERROR, "no answer from the drive for %s", pin);
    return -1;
  }
  return 0;
}

static int set(su_wizard_t *w, const char *pin, const char *value) {
  if(su_link_set(w->link, pin, value) < 0) {
    say(w, SU_MSG_ERROR, "the drive refused \"%s = %s\"", pin, value);
    return -1;
  }
  return 0;
}

static int set_num(su_wizard_t *w, const char *pin, double v) {
  char val[32];
  snprintf(val, sizeof(val), "%.6g", v);
  return set(w, pin, val);
}

// a console command whose answer doesn't matter (link, relink, start)
static int cmd(su_wizard_t *w, const char *line) {
  if(!su_link_query(w->link, line, 0.3, NULL, 5.0)) {
    say(w, SU_MSG_ERROR, "the drive stopped answering (%s)", line);
    return -1;
  }
  return 0;
}

static int disable(su_wizard_t *w) {
  return set(w, "fault0.en", "0");
}

// the drive's fault, if it has one: 0 none
static int drive_fault(su_wizard_t *w, double *code) {
  double s = 0.0;
  *code    = 0.0;
  if(su_link_get(w->link, "fault0.state", &s) < 0) {
    return -1;
  }
  if((int)(s + 0.5) == ST_SOFT_FAULT) {
    su_link_get(w->link, "fault0.fault", code);
    return 1;
  }
  return 0;
}

// poll pin until it reaches done (an identification's last state); the
// motor moves meanwhile. 0 done, -1 timeout / no answer, -2 drive fault
static int wait_state(su_wizard_t *w, const char *pin, double done, double timeout, const char *what) {
  double end = now() + timeout / (w->time_scale > 1.0 ? w->time_scale : 1.0), last = -1.0;
  while(now() < end) {
    double s, f;
    if(su_link_get(w->link, pin, &s) < 0) {
      say(w, SU_MSG_ERROR, "no answer from the drive for %s during %s", pin, what);
      return -1;
    }
    if(s != last) {
      w->ui->progress(w->ui->user, what, -1.0);
      last = s;
    }
    if(s >= done - 0.05) {
      return 0;
    }
    int fl = drive_fault(w, &f);
    if(fl > 0) {
      say(w, SU_MSG_ERROR, "the drive faulted (fault %.0f) during %s", f, what);
      return -2;
    }
    su_link_pump(w->link, 0.25);
  }
  say(w, SU_MSG_ERROR, "%s did not finish in time", what);
  return -1;
}

// write the config for the current state, reset the drive, quiet its scope
static int apply_config(su_wizard_t *w, int final) {
  char *conf = su_build_config(w->st, final);
  char err[256];
  int r = su_conf_write(w->link, conf, err, sizeof(err));
  free(conf);
  if(r < 0) {
    say(w, SU_MSG_ERROR, "writing the config failed: %s", err);
    return -1;
  }
  if(su_link_reset(w->link, 20.0) < 0) {
    say(w, SU_MSG_ERROR, "the drive did not come back after the reset");
    return -1;
  }
  // the scope stream would fill the buffers while the wizard waits for the user
  set(w, "term0.send_step", "0");
  return 0;
}

// load an identification template on the running drive
static int load_template(su_wizard_t *w, const char *name) {
  char line[64];
  snprintf(line, sizeof(line), "link %s", name);
  if(cmd(w, line) < 0 || cmd(w, "relink") < 0 || cmd(w, "start") < 0) {
    return -1;
  }
  set(w, "term0.send_step", "0");
  return 0;
}

static int enable(su_wizard_t *w) {
  if(set(w, "fault0.en", "0") < 0) {
    return -1;
  }
  drive_sleep(w, 0.2);
  return set(w, "fault0.en", "1");
}

static void motor_from_state(const su_state_t *st, su_motor_t *m) {
  memset(m, 0, sizeof(*m));
  m->rated_cur    = su_get_num(st, "motor.rated_cur", 0.0);
  m->peak_cur     = su_get_num(st, "motor.peak_cur", 0.0);
  m->rated_torque = su_get_num(st, "motor.rated_torque", 0.0);
  m->max_rpm      = su_get_num(st, "motor.max_rpm", 0.0);
  m->r            = su_get_num(st, "id.r", 0.0);
  m->l            = su_get_num(st, "id.l", 0.0);
  m->psi          = su_get_num(st, "id.psi", 0.0);
  m->pp           = (int)su_get_num(st, "id.pp", 0.0);
  m->j            = su_get_num(st, "mech.j", 0.0);
  m->d            = su_get_num(st, "mech.d", 0.0);
  m->f            = su_get_num(st, "mech.f", 0.0);
  m->o            = su_get_num(st, "mech.o", 0.0);
}

static double bus_of(const su_state_t *st) {
  return su_get_num(st, "supply.bus", 325.0);
}

// ---- the config --------------------------------------------------------------

// the outputs hold the axis this long after the brake is told to grip: the
// measured value (brake step), else the datasheet's engage time + 50 %
// + 20 ms, else 0.15 s
static double brake_time_of(const su_state_t *st) {
  if(su_has(st, "brake.time")) {
    return su_get_num(st, "brake.time", 0.15);
  }
  double ms = su_get_num(st, "brake.engage_ms", -1.0);
  return ms > 0.0 ? ms * 1.5e-3 + 0.02 : 0.15;
}

static char *put(char *c, const su_state_t *st, const char *key, const char *pin, const char *tag) {
  const char *v = su_get(st, key);
  if(v && strcmp(v, "unknown") != 0) {
    c = su_conf_set(c, pin, v, tag);
  }
  return c;
}

char *su_build_config(const su_state_t *st, int final) {
  char *c = strdup("");
  c       = su_conf_link(c, "pid");
  c       = su_conf_link(c, "pmsm");
  const su_fb_type_t *fb = su_fb_find(su_get(st, "feedback.type"));
  if(fb) {
    c = su_conf_link(c, fb->link);
  }
  if(final) {
    // the encoder monitor from commissioning on: a wrong commutation offset
    // (another motor's config, a swapped drive) trips it at the first enable
    // (FB_MON_ERROR; bench, FANUC betaiS: 30..180 deg el. caught, 0 deg quiet)
    c = su_conf_link(c, "encmon");
    if(fb && strcmp(fb->id, "fanuc_tw") == 0) {
      // its position is a cycle (0.2 ms) older than a resolver's: encmon's
      // angle correction must allow for it (bench sweep 2026-11-09)
      c = su_conf_set(c, "encmon0.delay", "0.00032", "fanuc_tw: +0.2 ms");
    } else if(fb && strcmp(fb->id, "yaskawa_abs") == 0) {
      // the same: read in one rt cycle, used in the next (guess: as
      // fanuc_tw, not swept on this encoder yet)
      c = su_conf_set(c, "encmon0.delay", "0.00032", "yaskawa_abs: +0.2 ms");
    }
    // encmon checks above min_bemf only: near it a fixed few volts of
    // voltage error (dead time, offsets) is a large part of the back-EMF
    // (betaiS, small moves: 0.37 of the 0.30 trip at 5 V, 0.22 at 10 V,
    // a wrong offset still caught): 15 % of the back-EMF at top speed,
    // 5 V at least
    double psi = su_get_num(st, "id.psi", 0.0), pp = su_get_num(st, "id.pp", 0.0);
    su_motor_t mm;
    su_limits_t ll;
    motor_from_state(st, &mm);
    su_motor_limits(&mm, bus_of(st), &ll);
    double vel = su_get_num(st, "limits.max_vel", ll.max_vel);
    if(psi > 0.0 && pp > 0.0 && vel > 0.0) {
      c = su_conf_set_num(c, "encmon0.min_bemf", fmax(5.0, 0.15 * psi * pp * vel), "15 % of top speed");
    }
  }
  const char *lk = su_get(st, "link.kind");
  if(final && lk && strcmp(lk, "none") != 0) {
    c = su_conf_link(c, lk);
  }
  if(final && fb && fb->mt_link && lk && strcmp(lk, "sserial") == 0) {  // multi-turn: needs linrev (sserial)
    c = su_conf_link(c, "mturn");
    c = su_conf_link(c, fb->mt_link);
  }
  // The wizard on the smart-serial console (sserialterm's pty): every
  // step's config keeps sserial loaded, its console only, or the reset
  // after a config write would take the console away. The final `link
  // sserial` loads it itself. USB's console failed under motion on the SEW
  // bench (DEBUGNOTES 2026-10-29).
  if(su_get_num(st, "console.sserial", 0.0) > 0.0 && !(final && lk && strcmp(lk, "sserial") == 0)) {
    c = su_conf_load(c, "sserial");
    c = su_conf_set(c, "sserial0.rt_prio", "2", "console");
    c = su_conf_set(c, "sserial0.frt_prio", "2", "console");
  }
  if(fb && fb->extra) {
    c = su_conf_set(c, "fb_switch0.mot_pos", strchr(fb->extra, '=') + 2, NULL);
  }
  if(su_get_num(st, "motor.brake", 0.0) > 0.0) {
    char out[16];
    snprintf(out, sizeof(out), "io0.out%d", (int)su_get_num(st, "brake.output", 0.0));
    c = su_conf_set(c, out, "fault0.mot_brake", "holding brake");
    c = su_conf_set_num(c, "fault0.brake_time", brake_time_of(st), "brake engage");
  }

  int ts = su_temp_type(su_get(st, "motor.temp_sensor"));
  const char *tin = su_get(st, "temp.input");
  if(ts && tin && (strcmp(tin, "fb0") == 0 || strcmp(tin, "fb1") == 0)) {
    c = su_conf_link(c, strcmp(tin, "fb0") == 0 ? "mtemp_fb0" : "mtemp_fb1");  // docs/motor_temp_lv.md
  }
  if(ts) {
    c = su_conf_set_num(c, "conf0.mot_temp_type", ts, su_temp_ids[ts]);
    if(ts == 4) {
      c = put(c, st, "temp.ntc_r25", "conf0.mot_temp_ntc_r25", "setup");
      c = put(c, st, "temp.ntc_b", "conf0.mot_temp_ntc_b", "setup");
    }
    c = put(c, st, "temp.warn", "conf0.high_mot_temp", "setup");
    c = put(c, st, "temp.trip", "conf0.max_mot_temp", "setup");
  }

  // supply
  if(su_get_num(st, "supply.chopper", 0.0) > 0.0) {
    double on = su_get_num(st, "supply.chopper_on", 375.0);
    c         = su_conf_set_num(c, "conf0.high_dc_volt", on + 5.0, "chopper + 5 V");
    c         = su_conf_set_num(c, "conf0.max_dc_volt", fmin(on + 20.0, 395.0), "chopper + 20 V");
  }
  c = put(c, st, "supply.max_hv_power", "conf0.max_hv_power", "setup");

  // feedback
  c = put(c, st, "feedback.counts", "conf0.mot_fb_res", "setup: measured");
  c = put(c, st, "feedback.rev", "conf0.mot_fb_rev", "setup: hand turn");
  c = put(c, st, "feedback.poles", "conf0.mot_fb_polecount", "setup");

  // identified
  c = put(c, st, "id.r", "conf0.r", "id_pmsm");
  c = put(c, st, "id.l", "conf0.l", "id_pmsm");
  c = put(c, st, "id.pp", "conf0.polecount", "id_pmsm");
  c = put(c, st, "id.offset", "conf0.mot_fb_offset", "id_pmsm");
  c = put(c, st, "id.out_rev", "conf0.out_rev", "id_pmsm");
  c = put(c, st, "id.psi", "conf0.psi", "id_pmsm");
  c = put(c, st, "mech.j", "conf0.j", "id_mot");
  c = put(c, st, "mech.d", "conf0.d", "id_mot");
  c = put(c, st, "mech.f", "conf0.f", "id_mot");
  c = put(c, st, "mech.o", "conf0.o", "id_mot");
  c = put(c, st, "tune.pos_bw", "conf0.pos_bw", "id_pid");
  c = put(c, st, "tune.vel_bw", "conf0.vel_bw", "id_pid");
  c = put(c, st, "tune.vel_d", "conf0.vel_d", "id_pid");

  // limits: from what is known so far (the limits step may lower them)
  su_motor_t m;
  su_limits_t lim;
  motor_from_state(st, &m);
  su_motor_limits(&m, bus_of(st), &lim);
  c = su_conf_set_num(c, "conf0.max_ac_cur", su_get_num(st, "limits.max_ac_cur", lim.max_ac_cur), "setup");
  c = su_conf_set_num(c, "iit0.cur_boost", lim.cur_boost, "setup");
  if(lim.max_force > 0.0) {
    c = su_conf_set_num(c, "conf0.max_force", su_get_num(st, "limits.max_force", lim.max_force), "setup");
  }
  if(lim.max_vel > 0.0) {
    c = su_conf_set_num(c, "conf0.max_vel", su_get_num(st, "limits.max_vel", lim.max_vel), "setup");
  }

  // the command link
  if(final && lk && strcmp(lk, "sserial") == 0) {
    c = put(c, st, "link.scale", "linrev0.scale", "units / rev");
  }
  return c;
}

// ---- steps -------------------------------------------------------------------

static su_result_t step_version(su_wizard_t *w) {
  const char *t = su_link_query(w->link, "about", 0.3, NULL, 3.0);
  if(!t) {
    say(w, SU_MSG_ERROR, "no answer to \"about\": is this an stmbl drive's console?");
    return SU_FAIL;
  }
  su_fw_t fw;
  su_fw_parse(t, &fw);
  su_fw_check_t r = su_fw_check(&fw, w->api, w->git);
  char buf[512];
  su_fw_explain(r, &fw, w->api, w->git, buf, sizeof(buf));
  if(r == SU_FW_NO_API || r == SU_FW_API_DIFFERS) {
    say(w, SU_MSG_ERROR, "%s", buf);
    return SU_FAIL;
  }
  say(w, r == SU_FW_OK ? SU_MSG_INFO : SU_MSG_WARN, "%s", buf);
  su_set(w->st, "drive.firmware", fw.have_version ? fw.git : "unknown");
  return SU_OK;
}

static su_result_t step_backup(su_wizard_t *w) {
  char *conf = su_conf_read(w->link);
  if(!conf) {
    say(w, SU_MSG_ERROR, "could not read the drive's config");
    return SU_FAIL;
  }
  char name[64], path[512];
  stamp(name, sizeof(name), "stmbl-backup-%Y%m%d-%H%M%S.txt");
  FILE *f = fopen(out_path(w, name, path, sizeof(path)), "w");
  if(!f) {
    say(w, SU_MSG_ERROR, "cannot write %s", path);
    free(conf);
    return SU_FAIL;
  }
  fputs(conf, f);
  fclose(f);
  say(w, SU_MSG_INFO,
      "The drive's config (%zu bytes) is saved in %s. To go back to it: servoterm-cli --load %s, then reset.",
      strlen(conf), path, path);
  su_set(w->st, "backup.file", path);
  free(conf);
  return SU_OK;
}

static su_result_t step_safety(su_wizard_t *w) {
  say(w, SU_MSG_INFO,
      "This wizard sets up one stmbl drive with a three-phase servo motor (PMSM / brushless AC):\n"
      "it asks for the nameplate values, helps with the wiring, then measures the motor on the\n"
      "drive and tunes it. During the measurements the motor turns on its own, several turns,\n"
      "with up to a few amps.\n"
      "  - Have an emergency stop that cuts the HV supply within reach.\n"
      "  - The motor must be fastened, nothing loose on the shaft (a key!).\n"
      "  - The wizard writes the drive's config; the old one is backed up.\n"
      "You can stop at any question; run the wizard again with the same session file to go on.");
  int yes = 0;
  if(ask_yes(w, "safety.ok", "Emergency stop within reach and the motor fastened?", &yes) == SU_ABORT) {
    return SU_ABORTED;
  }
  if(!yes) {
    say(w, SU_MSG_WARN, "Then not yet: run the wizard again when it is.");
    return SU_ABORTED;
  }
  return SU_OK;
}

static su_result_t step_supply(su_wizard_t *w) {
  static const char *const ids[]   = {"230", "120", "dc"};
  static const char *const names[] = {"230 V mains, rectified (bus ~325 V)", "120 V mains, rectified (bus ~170 V)",
                                      "a DC supply"};
  int k;
  if(ask_choice(w, "supply.kind", "What feeds the HV side (the motor power)?", ids, names, 3, 0, &k) == SU_ABORT) {
    return SU_ABORTED;
  }
  double bus = k == 0 ? 230.0 * M_SQRT2 : k == 1 ? 120.0 * M_SQRT2 : 0.0;
  if(k == 2) {
    if(ask_num(w, "supply.dc", "DC supply voltage", "V", 300.0, 24.0, SU_DRIVE_MAX_BUS, 0, &bus) == SU_ABORT) {
      return SU_ABORTED;
    }
  }
  su_set_num(w->st, "supply.bus", round(bus));
  int chop = 0;
  if(ask_yes(w, "supply.chopper", "Does the supply have a brake chopper (brake resistor)?", &chop) == SU_ABORT) {
    return SU_ABORTED;
  }
  if(chop) {
    double on, lo = bus * 1.1 + 5.0;  // above the highest mains (+10 %)
    if(ask_num(w, "supply.chopper_on", "The chopper switches on at", "V", fmax(375.0, lo), lo, 375.0, 0, &on) ==
       SU_ABORT) {
      return SU_ABORTED;
    }
  } else {
    say(w, SU_MSG_WARN,
        "Without a brake chopper the energy of every stop goes into the drive's own capacitors\n"
        "(540 uF: ~20 J). Heavy or fast axes will trip over-voltage when they brake hard\n"
        "(docs/emergency_stop.md).");
  }
  double p;
  if(ask_num(w, "supply.max_hv_power", "Braking power the drive may feed back into the bus", "W", 1000.0, 100.0,
             2000.0, 0, &p) == SU_ABORT) {
    return SU_ABORTED;
  }
  return SU_OK;
}

// the holding brake's data (nameplate: "brake 24 V DC 0.5 A" or "... 12 W")
static int ask_brake(su_wizard_t *w) {
  static const char *const vids[]   = {"24", "other"};
  static const char *const vnames[] = {"24 V DC", "another voltage, or AC"};
  static const char *const oids[]   = {"0", "1", "2"};
  static const char *const onames[] = {"DIO0 (usual)", "DIO1", "DIO2"};
  int k, o;
  double cur, ms;
  if(ask_choice(w, "brake.voltage", "The brake's voltage", vids, vnames, 2, 0, &k) == SU_ABORT ||
     ask_num(w, "brake.current", "The brake's current (or its power / 24 V)", "A", NAN, 0.01, 10.0, 1, &cur) ==
         SU_ABORT ||
     ask_choice(w, "brake.output", "Which drive output switches it?", oids, onames, 3, 0, &o) == SU_ABORT ||
     ask_num(w, "brake.engage_ms", "The brake's engage time (datasheet: response / engage time)", "ms", NAN, 1.0,
             1000.0, 1, &ms) == SU_ABORT) {
    return SU_ABORT;
  }
  return 0;
}

// the motor's temperature sensor: its type, the NTC's data, warning and trip
// temperatures (conf0.high_mot_temp derates the current, max_mot_temp stops)
static int ask_temp(su_wizard_t *w) {
  int k;
  double v;
  if(ask_choice(w, "motor.temp_sensor",
                "The motor's temperature sensor (type plate / datasheet: \"KTY\", \"PTC\", \"TF\" = PTC,\n"
                "\"TH\" = thermal switch; SEW CMP ../KTY/..: KTY84-130)",
                su_temp_ids, su_temp_names, SU_TEMP_N, 0, &k) == SU_ABORT) {
    return SU_ABORT;
  }
  if(k == 0) {
    return 0;
  }
  if(k == 4 && (ask_num(w, "temp.ntc_r25", "The NTC's resistance at 25 degC", "ohm", 10000.0, 100.0, 1e6, 0, &v) ==
                    SU_ABORT ||
                ask_num(w, "temp.ntc_b", "The NTC's B value", "K", 3950.0, 1000.0, 10000.0, 0, &v) == SU_ABORT)) {
    return SU_ABORT;
  }
  if(k == 3 || k == 5) {  // these only trip: at their own temperature
    return 0;
  }
  if(ask_num(w, "temp.warn", "Warning temperature: the drive lowers the current above it", "degC", 110.0, 40.0,
             180.0, 0, &v) == SU_ABORT ||
     ask_num(w, "temp.trip", "Trip temperature: the drive stops (class F winding: 130..155)", "degC", 130.0, v + 5.0,
             200.0, 0, &v) == SU_ABORT) {
    return SU_ABORT;
  }
  return 0;
}

static su_result_t step_motor(su_wizard_t *w) {
  say(w, SU_MSG_INFO,
      "From the motor's nameplate (or datasheet). Currents are rms, as nameplates give them.\n"
      "Unknown values are fine: answer \"?\"; the wizard measures what it can and stays careful.");
  double v;
  int r = ask_num(w, "motor.rated_cur", "Rated (continuous) current", "A rms", NAN, 0.1, 40.0, 1, &v);
  if(r == SU_ABORT) {
    return SU_ABORTED;
  }
  if(ask_num(w, "motor.peak_cur", "Peak (maximum) current", "A rms", NAN, 0.1, 60.0, 1, &v) == SU_ABORT ||
     ask_num(w, "motor.rated_torque", "Rated torque", "Nm", NAN, 0.01, 200.0, 1, &v) == SU_ABORT ||
     ask_num(w, "motor.max_rpm", "Maximum speed", "rpm", NAN, 10.0, 20000.0, 1, &v) == SU_ABORT) {
    return SU_ABORTED;
  }
  int brake;
  if(ask_yes(w, "motor.brake", "Does the motor have a holding brake?", &brake) == SU_ABORT) {
    return SU_ABORTED;
  }
  if(brake && ask_brake(w) == SU_ABORT) {
    return SU_ABORTED;
  }
  int vertical;
  if(ask_yes(w, "axis.vertical", "Does gravity pull on the axis (vertical, or a hanging load)?", &vertical) ==
     SU_ABORT) {
    return SU_ABORTED;
  }
  if(ask_temp(w) == SU_ABORT) {
    return SU_ABORTED;
  }
  if(vertical && !brake) {
    say(w, SU_MSG_WARN,
        "A vertical axis without a holding brake falls whenever the drive is off (e-stop, power\n"
        "loss, a fault): add a brake or a counterweight.");
  }
  su_motor_t m;
  su_limits_t lim;
  motor_from_state(w->st, &m);
  su_motor_limits(&m, bus_of(w->st), &lim);
  if(m.rated_cur <= 0.0 && m.peak_cur <= 0.0) {
    say(w, SU_MSG_WARN, "No current known: the drive is limited to %.1f A until you set conf0.max_ac_cur.",
        lim.max_ac_cur);
  }
  if(lim.max_ac_cur >= SU_DRIVE_MAX_AC_CUR - 1e-6) {
    say(w, SU_MSG_WARN, "The motor takes more than the drive's %.0f A peak: the drive limits it there.",
        SU_DRIVE_MAX_AC_CUR);
  }
  say(w, SU_MSG_INFO, "Current limit %.2f A peak, identification current %.2f A.", lim.max_ac_cur,
      lim.test_cur);
  return SU_OK;
}

static su_result_t step_feedback(su_wizard_t *w) {
  const char *ids[16], *names[16];
  for(int i = 0; i < su_fb_ntypes; i++) {
    ids[i]   = su_fb_types[i].id;
    names[i] = su_fb_types[i].name;
  }
  int k;
  if(ask_choice(w, "feedback.type", "Which feedback does the motor have?", ids, names, su_fb_ntypes, 0, &k) ==
     SU_ABORT) {
    return SU_ABORTED;
  }
  const su_fb_type_t *fb = &su_fb_types[k];
  if(fb->res == SU_FB_RES_POLES) {
    double poles;
    if(ask_num(w, "feedback.poles_n", "Resolver poles (the nameplate's \"2 pole\", \"6X\" = 6...)", "", 2.0, 2.0,
               32.0, 0, &poles) == SU_ABORT) {
      return SU_ABORTED;
    }
    su_set_num(w->st, "feedback.poles", fmax(1.0, round(poles / 2.0)));
  }
  if(!fb->simulated) {
    say(w, SU_MSG_WARN, "%s: supported by the firmware, but this wizard's steps for it are untested.",
        fb->name);
  }
  return SU_OK;
}

static su_result_t step_wiring(su_wizard_t *w) {
  const su_fb_type_t *fb = su_fb_find(su_get(w->st, "feedback.type"));
  int brake              = su_get_num(w->st, "motor.brake", 0.0) > 0.0;
  char *t                = su_wiring_power(brake, bus_of(w->st));
  say(w, SU_MSG_WIRING, "%s", t);
  free(t);
  if(brake) {
    const char *v = su_get(w->st, "brake.voltage");
    t = su_wiring_brake((int)su_get_num(w->st, "brake.output", 0.0), v && strcmp(v, "24") == 0,
                        su_get_num(w->st, "brake.current", 0.0));
    say(w, SU_MSG_WIRING, "%s", t);
    free(t);
  }
  int ts = su_temp_type(su_get(w->st, "motor.temp_sensor"));
  if(ts) {
    // where it's measured: the HV board's input, or a feedback port's pin 7
    // (docs/motor_temp_lv.md; FB0 only with a resolver: encoders need its
    // +5 V). On the HV side the sensor's wires carry the inverter's
    // switching: next to the resolver's they spoiled its signal (SEW).
    int res = fb && strcmp(fb->id, "resolver") == 0;
    const char *ids[3]   = {"hv", "fb1", "fb0"};
    const char *names[3] = {"the HV board's motor temperature input",
                            "the second feedback port FB1, pin 7 (a solder jumper to open)",
                            "the feedback port FB0, pin 7, with the resolver (a solder jumper to open)"};
    int k;
    if(ask_choice(w, "temp.input", "Where is the temperature sensor connected?", ids, names, res ? 3 : 2, 0, &k) ==
       SU_ABORT) {
      return SU_ABORTED;
    }
    t = k == 0 ? su_wiring_temp(ts) : su_wiring_temp_fb(ts, k == 1 ? 1 : 0);
    say(w, SU_MSG_WIRING, "%s", t);
    free(t);
  }
  if(fb && (t = su_wiring_feedback(fb->wiring_col))) {
    say(w, SU_MSG_WIRING, "%s", t);
    free(t);
  }
  say(w, SU_MSG_INFO,
      "Use a shielded cable for the feedback; the shield to the connector shell at the drive.\n"
      "Leave the command connector (LinuxCNC) for later: the wizard doesn't need it.");
  if(w->ui->action(w->ui->user, "wiring.done", "Wire the drive as above, switch on the HV supply, then go on.",
                   w->link) == SU_ABORT) {
    return SU_ABORTED;
  }
  return SU_OK;
}

// the temperature sensor with the motor cold: it reads, and about the room's
// temperature (a PTC / switch: not tripped)
static su_result_t check_temp(su_wizard_t *w) {
  int ts = su_temp_type(su_get(w->st, "motor.temp_sensor"));
  if(!ts) {
    return SU_OK;
  }
  drive_sleep(w, 0.5);  // the sensor's filter settles
  double ohm, degc, err, tripped;
  const char *in = su_get(w->st, "temp.input");
  int on_fb       = in && strncmp(in, "fb", 2) == 0;
  if(get(w, on_fb ? "rpull0.r" : "hv0.mot_temp", &ohm) < 0 || get(w, "mtemp0.sensor", &degc) < 0 ||
     get(w, "mtemp0.err", &err) < 0 ||
     get(w, "mtemp0.tripped", &tripped) < 0) {
    return SU_FAIL;
  }
  su_set_num(w->st, "temp.cold_ohm", ohm);
  char msg[512];
  if(su_temp_check(ts, ohm, degc, err, tripped, msg, sizeof(msg))) {
    say(w, SU_MSG_ERROR, "%s\nCheck its wiring, or redo the motor step with the right type.%s", msg,
        on_fb && ohm < 0.0 ? "\nOn a feedback port: is its jumper open (cut)? Closed, pin 7 sits at +5 V and\n"
                             "reads open (docs/motor_temp_lv.md)."
                           : "");
    return SU_FAIL;
  }
  if(ts == 3 || ts == 5) {
    say(w, SU_MSG_INFO, "Temperature sensor: %.0f ohm, not tripped.", ohm);
  } else {
    su_set_num(w->st, "temp.cold", round(degc * 10.0) / 10.0);
    say(w, SU_MSG_INFO, "Temperature sensor: %.0f ohm, %.1f degC.", ohm, degc);
  }
  return SU_OK;
}

static su_result_t step_base(su_wizard_t *w) {
  if(apply_config(w, 0) < 0) {
    return SU_FAIL;
  }
  double v, f;
  if(get(w, "hv0.dc_volt", &v) < 0) {
    return SU_FAIL;
  }
  double bus = bus_of(w->st);
  if(v < 0.7 * bus || v > 1.2 * bus) {
    say(w, SU_MSG_ERROR, "The HV bus reads %.0f V, expected about %.0f V: check the HV supply and its wiring.", v,
        bus);
    return SU_FAIL;
  }
  // a broken or wrong temperature sensor faults the drive (MOT_TEMP_ERROR):
  // say why first
  su_result_t t = check_temp(w);
  if(t != SU_OK) {
    return t;
  }
  if(drive_fault(w, &f) > 0) {
    say(w, SU_MSG_ERROR, "The drive reports fault %.0f with the first config.", f);
    return SU_FAIL;
  }
  say(w, SU_MSG_INFO, "First config written, the drive restarted; HV bus %.0f V.", v);
  return SU_OK;
}

static su_result_t fbcheck(su_wizard_t *w, const su_fb_type_t *fb);

// the hand turn: index counts (incremental), or the position's direction
static su_result_t step_fbcheck(su_wizard_t *w) {
  const su_fb_type_t *fb = su_fb_find(su_get(w->st, "feedback.type"));
  if(!fb) {
    return SU_FAIL;
  }
  disable(w);
  if(su_get_num(w->st, "motor.brake", 0.0) > 0.0) {  // released for the hand
    if(su_get_num(w->st, "axis.vertical", 0.0) > 0.0) {
      int yes = 0;
      say(w, SU_MSG_WARN, "The wizard releases the holding brake now: a vertical axis would fall.");
      if(ask_yes(w, "fbcheck.secured", "Is the load off the motor, or the axis supported?", &yes) == SU_ABORT ||
         !yes) {
        return SU_ABORTED;
      }
    }
    set(w, "fault0.brake_release", "1");
  }
  su_result_t r = fbcheck(w, fb);
  set(w, "fault0.brake_release", "0");
  return r;
}

static su_result_t fbcheck(su_wizard_t *w, const su_fb_type_t *fb) {
  if(fb->res == SU_FB_RES_MEASURED) {
    set_num(w, "enc_fb0.res", SU_FB_MEASURE_WRAP);
    set(w, "enc_fb0.indexprint", "1");
    su_link_clear(w->link);
    if(w->ui->action(w->ui->user, "fbcheck.turn",
                     "Turn the motor shaft by hand, slowly, at least 3 full turns in the direction\n"
                     "you want to call forward (positive). Then go on.",
                     w->link) == SU_ABORT) {
      return SU_ABORTED;
    }
    su_link_pump(w->link, 0.3);
    long cnt[64], counts = 0;
    int dir = 0;
    int n   = su_fb_parse_index(su_link_text(w->link), cnt, 64);
    int r   = su_fb_counts(cnt, n, SU_FB_MEASURE_WRAP, &counts, &dir);
    set(w, "enc_fb0.indexprint", "0");
    set(w, "enc_fb0.res", "conf0.mot_fb_res");
    if(r == -2) {
      say(w, SU_MSG_ERROR,
          "The index pulses came at different counts: the shaft turned back, or the index (Z) is noisy.\n"
          "Run this step again and turn in one direction only.");
      return SU_FAIL;
    }
    if(r == 0) {
      say(w, SU_MSG_INFO, "Measured %ld counts per revolution (%ld lines), counting %s when turned forward.", counts,
          su_fb_lines(counts), dir > 0 ? "up" : "down");
      if(!su_fb_lines(counts)) {
        say(w, SU_MSG_WARN, "%ld is not a multiple of 4: check the A/B signals.", counts);
      }
      su_set_num(w->st, "feedback.counts", counts);
      su_set_num(w->st, "feedback.rev", dir > 0 ? 0 : 1);
      return SU_OK;
    }
    say(w, SU_MSG_WARN, "No index pulses seen: the encoder has no index (Z), or it isn't wired.");
    double lines;
    if(ask_num(w, "feedback.lines", "Encoder lines per revolution (the label's PPR)", "", 2500, 16, 1048576, 0,
               &lines) == SU_ABORT) {
      return SU_ABORTED;
    }
    su_set_num(w->st, "feedback.counts", 4.0 * lines);
    set_num(w, "conf0.mot_fb_res", 4.0 * lines);
  }

  // direction from the position (no index): a quarter turn forward
  double p0, p1;
  set(w, "conf0.mot_fb_rev", "0");
  if(get(w, fb->pos_pin, &p0) < 0) {
    return SU_FAIL;
  }
  if(w->ui->action(w->ui->user, "fbcheck.quarter",
                   "Turn the shaft by hand about a quarter turn forward (the direction you want to\n"
                   "call positive), then go on.",
                   w->link) == SU_ABORT) {
    return SU_ABORTED;
  }
  if(get(w, fb->pos_pin, &p1) < 0) {
    return SU_FAIL;
  }
  double d = remainder(p1 - p0, 2.0 * M_PI);
  if(fabs(d) < 0.3) {
    say(w, SU_MSG_ERROR, "The feedback moved only %.2f rad: check its wiring and turn further.", d);
    return SU_FAIL;
  }
  su_set_num(w->st, "feedback.rev", d > 0.0 ? 0 : 1);
  say(w, SU_MSG_INFO, "Feedback direction: %s.", d > 0.0 ? "as wired" : "reversed (conf0.mot_fb_rev = 1)");
  return SU_OK;
}

static su_result_t step_gate(su_wizard_t *w) {
  say(w, SU_MSG_INFO,
      "Next the drive measures the motor. It turns on its own:\n"
      "  - electrical (id_pmsm): a few turns at low speed;\n"
      "  - mechanical (id_mot): back and forth, faster;\n"
      "  - tuning (id_pid): short fast moves.\n"
      "Best with the motor uncoupled from the machine. Coupled, the axis must be free to move\n"
      "the travel below, away from its ends, and the identified inertia is the whole axis's.");
  if(su_get_num(w->st, "axis.vertical", 0.0) > 0.0) {
    say(w, SU_MSG_WARN,
        "A vertical axis: measure the motor without its load (uncoupled, or the load taken off or\n"
        "supported). Gravity would read as friction and offset, and the motor turns several turns.\n"
        "The brake step puts the load back on and checks that the brake holds it.");
  }
  int yes = 0;
  if(ask_yes(w, "gate.free", "Is the motor free to turn (uncoupled, or the axis clear)?", &yes) == SU_ABORT) {
    return SU_ABORTED;
  }
  if(!yes) {
    say(w, SU_MSG_WARN, "Then make it free first, and run the wizard again.");
    return SU_ABORTED;
  }
  double turns;
  if(ask_num(w, "gate.turns", "How far may it turn each way from where it stands?", "turns", 2.0, 0.5, 1000.0, 0,
             &turns) == SU_ABORT) {
    return SU_ABORTED;
  }
  return SU_OK;
}

static su_result_t step_electrical(su_wizard_t *w) {
  su_motor_t m;
  su_limits_t lim;
  motor_from_state(w->st, &m);
  su_motor_limits(&m, bus_of(w->st), &lim);
  if(apply_config(w, 0) < 0 || load_template(w, "id_pmsm") < 0) {
    return SU_FAIL;
  }
  set_num(w, "idpmsm0.test_cur", lim.test_cur);
  set(w, "fault0.pos_error", "0");
  say(w, SU_MSG_INFO, "Measuring resistance, inductance, pole pairs, commutation and flux (%.2f A)...",
      lim.test_cur);
  if(enable(w) < 0) {
    return SU_FAIL;
  }
  // the results are read before disabling: idpmsm resets them at state 0
  int r = wait_state(w, "idpmsm0.state", 3.4, 180.0, "id_pmsm");
  double rr, l, pp, off, rev, psi, fbrev = su_get_num(w->st, "feedback.rev", 0.0);
  if(r == 0 && (get(w, "idpmsm0.r", &rr) || get(w, "idpmsm0.l", &l) || get(w, "idpmsm0.pp", &pp) ||
                get(w, "idpmsm0.com_offset", &off) || get(w, "idpmsm0.out_rev", &rev) ||
                get(w, "idpmsm0.psi", &psi))) {
    r = -1;
  }
  disable(w);
  if(r < 0) {
    return SU_FAIL;
  }
  // as idpmsm prints it: fb_switch reverses the offset with the feedback
  off = fbrev > 0.0 ? -off : off;
  su_set_num(w->st, "id.r", rr);
  su_set_num(w->st, "id.l", l);
  su_set_num(w->st, "id.pp", round(pp));
  su_set_num(w->st, "id.offset", off);
  su_set_num(w->st, "id.out_rev", rev > 0.0 ? 1 : 0);
  su_set_num(w->st, "id.psi", psi);
  motor_from_state(w->st, &m);
  char msg[1024];
  int warn = 0, err = su_motor_check(&m, bus_of(w->st), msg, sizeof(msg), &warn);
  say(w, SU_MSG_INFO,
      "r = %.4g ohm, l = %.4g H, %d pole pairs, phase order %s, commutation offset %.4f rad,\n"
      "psi = %.4g Wb: torque constant %.3g Nm/A rms.",
      rr, l, m.pp, rev > 0.0 ? "reversed" : "as wired", off, psi, su_kt_identified(&m));
  if(err || warn) {
    say(w, err ? SU_MSG_ERROR : SU_MSG_WARN, "%s", msg);
  }
  if(err) {
    su_unset_prefix(w->st, "id.");
    return SU_FAIL;
  }
  return SU_OK;
}

// one idm run at max_acc / max_vel; the fit's results. 0 ok
static int run_idm(su_wizard_t *w, double acc, double vel, double *j, double *d, double *f, double *o) {
  set_num(w, "idm0.max_acc", acc);
  set_num(w, "idm0.max_vel", vel);
  if(enable(w) < 0) {
    return -1;
  }
  int r = wait_state(w, "idm0.state", 1.5, 600.0, "id_mot");
  if(r == 0 &&
     (get(w, "idm0.ls_j", j) || get(w, "idm0.ls_d", d) || get(w, "idm0.ls_f", f) || get(w, "idm0.ls_o", o))) {
    r = -1;
  }
  disable(w);
  if(r == 0 && !(*j > 0.0)) {
    say(w, SU_MSG_ERROR, "The inertia fit failed (j = %g): the motion was disturbed.", *j);
    r = -1;
  }
  return r;
}

// Two runs. idm's defaults (250 rad/s^2, 25 rad/s) are safe for any rotor
// but give a high inertia on light motors with much friction: the inertia's
// torque is small against the friction's, and at low speed the friction's
// sign changes often; the fit puts the misfit into j (4x on a 1e-5 kg m^2
// motor). The second run accelerates with 30 % of the peak torque for that
// (high) estimate, so it can't saturate, and runs faster: within ~20 %.
static su_result_t step_mechanical(su_wizard_t *w) {
  if(apply_config(w, 0) < 0 || load_template(w, "id_mot") < 0) {
    return SU_FAIL;
  }
  su_motor_t m;
  su_limits_t lim;
  motor_from_state(w->st, &m);
  su_motor_limits(&m, bus_of(w->st), &lim);
  double travel = su_get_num(w->st, "gate.turns", 2.0) * 2.0 * M_PI;
  travel        = fmin(travel, 10.0);  // idm's default range
  set_num(w, "idm0.min_pos", -travel);
  set_num(w, "idm0.max_pos", travel);
  // idm's adaptive inertia sets the loop gains: start low, it rises (2e-4,
  // its default, made a 4e-7 motor's gains 500x too high: saturation)
  set_num(w, "idm0.inertia", fmin(2e-4, 5e-6 * fmax(lim.max_force, 0.01)));
  say(w, SU_MSG_INFO, "Measuring inertia, friction and damping (moves +-%.1f turns, twice)...", travel / 2.0 / M_PI);
  double j, d, f, o;
  if(run_idm(w, 250.0, 25.0, &j, &d, &f, &o) < 0) {
    return SU_FAIL;
  }
  double acc = fmin(fmax(0.3 * lim.max_force / j, 250.0), 10000.0);
  double vel = fmin(fmax(0.3 * lim.max_vel, 25.0), 200.0);
  vel        = fmin(vel, sqrt(acc * travel));  // reached within the travel
  double j1 = j;
  if(run_idm(w, acc, vel, &j, &d, &f, &o) < 0) {
    return SU_FAIL;
  }
  su_set_num(w->st, "mech.j", j);
  su_set_num(w->st, "mech.d", fmax(d, 0.0));
  su_set_num(w->st, "mech.f", fmax(f, 0.0));
  su_set_num(w->st, "mech.o", o);
  say(w, SU_MSG_INFO,
      "j = %.4g kg m^2 (first run %.4g), friction %.4g Nm, damping %.4g Nm s/rad, offset %.4g Nm\n"
      "(second run at %.0f rad/s^2, %.0f rad/s).",
      j, j1, f, d, o, acc, vel);
  if(j < 1e-5) {
    say(w, SU_MSG_WARN, "The console prints 6 decimals: an inertia of %.2g is known to about %.0f %%.", j,
        0.5e-6 / j * 100.0);
  }
  return SU_OK;
}
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
