brdmaker/stmbl/(commit log)

2026-05-24 Add native host simulator and web build environment
    Build the portable HAL core and control components (shared/comps) with the
    host compiler so the real control logic runs natively for automated testing,
    with the STM32 low-level layer (timer ISRs, ADC, USB) replaced by a software
    tick loop and a stdin command console (host/).
    Add a SessionStart hook that installs the arm-none-eabi toolchain and builds
    the host simulator so the environment is reproducible in web sessions.
    https://claude.ai/code/session_01QDufD7ArWKZ3M6RRxSmUFV
    [pid.hal, signal.hal]
2026-05-24 Drop ARM toolchain install from session hook
    Work targets the x86 host simulator only, so skip installing the
    arm-none-eabi cross toolchain to speed up sandbox creation. The host build
    needs only gcc/make/python3 from the base image.
    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
2026-05-24 Add CLI servoterm and faithful scope protocol to host sim
    Port the 'term' component into the host build via a CDC shim that maps the
    device's USB-serial byte stream onto the process stdin/stdout. A new --serve
    mode speaks the exact wire protocol (text responses interleaved with 0xFF
    scope frames) and drains scope continuously during a run, staying
    deterministic since time advances only via run/step.
    Add servoterm (host/servoterm.c): a headless QtServoterm-style client that
    spawns the simulator, forwards commands, and demuxes the reply stream into
    text plus a decoded scope CSV, for building automated test assets.
    Widen three scanf locals in hal.c from int32_t to long: the firmware assumes
    a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
2026-05-24 Add DEBUGNOTES log, agent rule, and host README
    Add CLAUDE.md rule: record debug findings and open issues in DEBUGNOTES.md as
    part of the work. Seed DEBUGNOTES.md with this session's findings (ARM build
    hang in add_version_info.py, the ILP32 sscanf fix, M_SQRT3 shim, format
    mismatches, missing motor example, lossy scope).
    Document the host simulator structure and usage (build, script vs serve mode,
    console command language, servoterm, scope protocol, writing test assets) in
    host/README.md.
    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
2026-05-24 trial: adapt host build to sys_id (id->idm/idpmsm/ids/iddc, bw pid example)
    [pid.hal]
2026-10-13 Add servoterm-cli: command-line client for a real drive over USB
    Based on host/servoterm, but opens the drive's USB CDC port (default
    /dev/ttyACM0) instead of spawning the simulator. Splits the drive's output
    into text and scope frames (optional CSV), and takes commands from -c,
    a script, or interactive input.
    --dump saves the flash config to a file. --load checks the file against
    the firmware's line limits, backs up the current config, sends it with
    deleteconf/appendconf/flashsaveconf, and reads it back to verify.
    Also adds DEBUGNOTES entries for the connect delay and the 64-byte
    command line limit, and gitignores .claude/settings.local.json.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
2026-10-13 servoterm-cli: send each command in one write, check config acks exactly
    The drive's USB receive ring buffer is written from the interrupt and read
    from the main loop without locking. When a command and its newline arrive
    in separate USB packets, the main loop can rewind a partial line (rb_undo)
    while the interrupt adds the rest, and the newline is lost; the next command
    then gets glued onto it. Seen during --load.
    Each command line is now sent in a single write of at most 64 bytes. A lone
    newline at connect ends any stale half-line, and --load compares each
    "adding <line>" ack exactly. Load, verify and restore pass on the drive.
2026-10-13 id_mot: feed the learned offset back (pid0.o = idm0.offset)
    id_mot.txt linked pid0.l = idm0.load, but neither pin exists, so the link
    failed with "not found" and the offset estimate integrated pid's feedback
    torque open-loop. With a constant load it grew without bound, and the
    printed conf0.o only reflected run time; inertia was biased too.
    In the host sim (motsim, -0.3 Nm load, true o = 0.3): before, offset 0.657
    and still rising, j 0.000341 (true 0.0002); after, offset 0.267 and
    settling, j 0.000215. Without load the results are the same as before.
    Adds host/examples/idm_load.hal as a regression asset and DEBUGNOTES
    entries for this, the USB receive race, and other autotune findings.
    Co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
2026-10-13 idm: report a least-squares fit against measured motion
    The adaptive estimates could not separate damping from friction: most of
    the run is at one speed, where d*v + f*sign(v) is a single number. With
    high damping they also fed each other's errors through pid's feedforward
    until tracking broke down (f +600..1700%, j at its clamp).
    idm now:
    - steps the stroke speed in state 1.3 through 1/5 .. 5/5 of max_vel
    (vel_steps, default 5)
    - fits torque = j*acc + d*vel + f*sign(vel) + o by least squares over states
    1.2 and 1.3, against measured motion (ls_fb, vel_fb/acc_fb, default on).
    Torque, acc, vel and sign(vel) get the same 20 Hz low-pass (ls_lp) before
    fitting; without it, the different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
2026-10-13 id_mot: shorten comment lines; fail the build on template lines > 63 chars
    findline() in shared/hal.c looks at most 64 chars ahead for '\n'. A longer
    line ends hal_parse() silently, so "link id_mot" dropped everything after
    the 72-char comment added in 58573a07: the idm0.vel_fb/acc_fb links,
    vel1.torque = 0 and conf0.max_pos_error = 0. Found on the drive.
    create_config.py now rejects any template line over 63 chars.
2026-10-13 ids: start the tuning cost at 0, so vel_bw actually gets tuned
    State 0 set cost = min_cost, so the first cycle's cost was min_cost plus
    the real cost. When the real cost exceeded 0.2 * min_cost, the first check
    "cost > min_cost * kt" fired at once, so vel_bw was cut by kd (100 -> 70)
    and never tuned. Seen on the bench motor. Host-sim id_pid gives the same
    result as before (the bug does not trigger there).
    Also adds DEBUGNOTES entries for this, the bench motor's encoder
    resolution misconfiguration (16384 vs 10000) found with the scope logs, and
    the idm hardware results.
2026-10-13 servoterm-cli: scope channel setup and long-running logging mode
    -C pin:gain,... links term0.wave0..7 and sets their gains, and the CSV
    gets the pin names and values in the pin's own units ((byte - 128) / gain).
    --step N sets term0.send_step and adds a time column. --log SEC records
    until a timeout or a signal, flushing the CSV every second and
    timestamping drive text. Used to log LinuxCNC runs over the free USB
    console while LinuxCNC drives over smart-serial.
2026-10-13 hwtest/burnin: LinuxCNC burn-in config and ECMA-C30604FS drive config
    - LinuxCNC config for the bench (Pi 4 + 7c81 via hm2_rpspi, STMBL on
    smart-serial), copied from docs/linuxcnc, with joint 0 at 500 mm/s
    (3000 rpm) and 1000 mm/s^2.
    - README with the realtime setup (PREEMPT_RT, isolcpus=2,3, 1 ms servo
    thread, ~69 us idle latency).
    - ECMA-C30604FS/stmbl.conf as dumped from the drive: 2500-line encoder
    (mot_fb_res 10000), 5 pole pairs, parameters from id_pmsm, id_mot and
    id_pid, and a README with the motor data, where each value came from,
    and the measured performance.
2026-10-14 host: simulated drive, and stmbl_sim LinuxCNC realtime module
    stmbl_host --drive CONF boots a whole simulated drive as src/main.c does
    (flashloadconf, loadconf, relink, start), with the real conf/template
    templates, so the drive's own config runs unchanged. Stand-ins in host/hw/
    keep the hardware comps' names and pins: hv (F3 curpid at 20 kHz plus a
    PMSM at 80 kHz), enc_fb (quadrature encoder with index), sserial (process
    data with timeout), adc and io. sim_board.txt links the simulated motor to
    conf0. The console can run on a pty (--pty), with reset and a flash file.
    host/lcnc builds stmbl_sim.so, the same drive as a uspace realtime
    component that runs in the servo thread in lockstep with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
2026-10-14 hwtest/burnin-sim: LinuxCNC burn-in config on the simulated drive
    ../burnin with hm2/7c81 replaced by stmbl_sim. sim.conf is the simulated
    drive's flash, started from the tuned ECMA-C30604FS config; sim.txt holds
    sim-only motor and supply settings. The README is a usage guide: setup,
    AXIS, the console on /tmp/stmbl-sim, config handling, simulated motor pins,
    autotune in the sim, going back to the real drive, troubleshooting.
2026-10-14 Fix build warnings in our own code; refresh DEBUGNOTES statuses
    Firmware 32 -> 7 warnings (the 7 left are in lib/), host 5 -> 0, the
    LinuxCNC module 2 -> 0:
    - stmbl_talk CRC: start at (uint32_t *)&packet + 1 instead of
    &header.slave_addr (same address; GCC 12 flagged word reads from a
    1-byte field) in hv.c, F3 ls.c and f3_boot
    - comp_by_name(const char *), calc_crc8(const ...)
    - encs: (void) read of CCR3 instead of an unused volatile
    - modi(): v % m, which is what SIGN(v) * (|v| % m) computed via float
    - hal.c list: pointer casts via uintptr_t (LP64 hosts)
    Machine code is unchanged except modi() and an unused stack slot in encs.
    DEBUGNOTES: close the closed-loop example entry (drive_jog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
2026-10-14 vel_int: reset to pos_in when vel_in changes too
    A move that stops sends the same position again with vel = 0. vel_int only
    reset its extrapolation when pos_in changed, so the overshoot extrapolated
    from the packet before stayed as a standstill offset (0.024 mm after a
    19.7 rad/s jog on the simulated drive; now 0.001 mm, one encoder count).
    The last command is kept in the ctx instead of EDGE()'s function-level
    static, which all vel_int instances shared. The watchdog check uses the raw
    vel_in, so a timeout does not look like a new command.
2026-10-14 idm: fit the inertia against measured torque, not the command
    The real torque lags pid0.torque_cmd (current loop, one rt cycle to the F3),
    so the least-squares fit read the inertia high by a roughly constant
    0.000045 kg*m^2 on the simulated drive at cur_bw 1000.
    pmsm_ttc gets cur_fb (hv0.iq_fb, linked in pmsm.txt) and outputs the torque
    it makes, torque_fb. id_mot.txt links idm0.torque_fb to it, and idm uses it
    for the fit when the pin is linked. Simulated motor, true -> fitted j:
    0.00003 -> 0.000033, 0.0001 -> 0.000104, 0.0003 -> 0.000303; d, f and o
    as before.
    New regression test host/examples/drive_id_mot.txt: id_mot on the simulated
    drive with a motor that differs from the config.
    Co-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
2026-10-14 ringbuf: rb_getline drops a too-long line instead of jamming on it
    A command line longer than term's 64-byte buffer stayed at the head of the
    USB ring buffer forever: rb_getline read it, found no newline, rewound with
    rb_undo and returned 0, so every later line was ignored too. The loop also
    consumed one byte more than it rewound.
    rb_getline now looks for the newline without consuming anything. A line
    that cannot fit is dropped up to and including its newline (new skip flag
    in struct ringbuf) and rb_getline returns -1; term then prints
    "error: line too long, max 63 chars, dropped". Not rewinding also shrinks
    the window for the USB race (next commit).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
2026-10-14 cdc_getline: keep the ring buffer's writer out while reading a line
    The USB rx ring buffer is filled from an interrupt and read in the main
    loop with no locking; both sides update pos/len, so a byte arriving during
    the read could be lost or land in the wrong place (seen as a lost newline
    during servoterm-cli --load).
    F4: mask OTG_FS_IRQn around rb_getline. F3: its rx_buf is filled from the
    rt interrupt (ls), so disable interrupts for the short copy and restore
    PRIMASK.
2026-10-14 idpmsm: print mot_fb_offset in fb_switch's sign with mot_fb_rev = 1
    idpmsm measures the offset against the already reversed feedback and
    commutes with (pos_fb + offset), but fb_switch reverses mot_fb_offset along
    with the position, (pos_fb - offset). With mot_fb_rev = 1 the printed offset
    therefore had the wrong sign. On the simulated drive the resulting
    commutation error ranged from 0.05 to 2.4 rad electrical depending on where
    the encoder index sits; the bench motor's offset (-0.6308, about -pi/5) is
    one of the positions where the sign does not matter.
    idpmsm gets fb_rev (conf0.mot_fb_rev, linked in id_pmsm.txt) and prints
    the offset negated when it is set: 0.021 rad at every index positi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
2026-10-14 idpmsm: reset all four L-step averages before the L step
    tmp2/tmp3 were not reset, so a second id_pmsm in the same boot started the
    high-voltage averages from the previous run's values.
2026-10-14 idpmsm: average the locked rotor angle as a vector
    A plain low-pass of -pos_fb mixes +pi and -pi when the rotor locks near
    the wrap and the reading flickers by a count, giving an offset about half
    a turn off. Averaging sin and cos and taking atan2 has no wrap. Results
    away from the wrap are unchanged on the simulated drive.
2026-10-14 idpmsm: switch the output off after the offset step
    State 2.3 wrote en, an input linked to fault0.en_out that is overwritten
    every cycle, so it had no effect. Write en_out, as the other steps do.
2026-10-14 host/hw/hv: simulate the F3's voltage mode
    idpmsm's L step drives the F3 in voltage mode (cmd_mode 0), which the
    stand-in treated as a current command. Now, as curpid: d/q_cmd are
    voltages, clamped to the output limit, with the integrators reset.
    With it, id_pmsm on the simulated drive reads L 0.091 for a true 0.023,
    the same ~4x as on the bench (DEBUGNOTES: idpmsm L reads about 4x high).
2026-10-14 host/hw/hv: optional current noise and feedback delay
    sim_cur_noise adds uniform noise to the measured currents (xorshift32, the
    same on every run); sim_fb_delay delays id/iq/ud/uq_fb by 0..4 rt cycles,
    like the packet from the F3. Both default to 0, so existing results are
    unchanged. Used to check the new idpmsm L measurement.
2026-10-14 idpmsm: measure L from the current's slope, not the ripple's peaks
    The L step toggled ud every rt cycle and took L = dU / dI * period from the
    mean currents of the two halves. That only works if the current is sampled
    exactly at the ripple peaks, and even then gives 2L (dI is the
    peak-to-peak ripple). On the simulated drive it read 0.091 for a true
    0.023; the bench motor read 3.4x its datasheet value.
    Now a square wave with l_half (8) rt cycles per half. For each pair of
    samples at the same voltage, l * di = period * (u - r * i_mean), so
    l = (u_hi - u_lo - r * (i_hi - i_lo)) / (slope_hi - slope_lo), with each
    sample's voltage from ud_fb and pairs next to a switch skipped. Slopes do
    not depe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
2026-10-14 DEBUGNOTES: bench results for v0.9.18-243
    - idpmsm L on the bench motor: 0.00489 (old method 0.0230, 4.7x)
    - idm: inertia barely observable at the default max_acc 250 on the
    bench motor; converges toward the datasheet with harder accelerations
    - USB text and scope frames mix when the TX buffer overflows
    - RT_TOO_LONG stops while the HV supply misbehaved (open)
2026-10-14 DEBUGNOTES: old bench drive's HV board reads the DC bus low
    Meter at the connector 200 V steady, hv0.dc_volt 137.5..139.2 V with
    three firmwares; DC divider R77/R78/R79. A second drive on the same
    supply reads 200.65 V. The RT_TOO_LONG stops happened in the same window.
2026-10-14 stmbl_sim: return the answer to this period's packet, not the previous one
    The real drive answers a smart-serial packet as soon as it has it, and hm2
    reads that answer at the start of the next servo period. The module
    returned the previous exchange's feedback instead, one period staler, which
    added 0.5 mm of following error at 500 mm/s (LinuxCNC's 1 mm limit tripped
    in a soak run). Now: exchange, run the rt cycle in which sserial0 replies,
    return that. Sim following error on the soak cycle 0.84 -> 0.040 mm (real
    drive 0.045 mm).
2026-10-14 burnin-sim: simulate the bench motor as measured; fix sim.txt line length
    sim.txt had a 64-character comment line, so hal_parse stopped there and
    none of its settings applied (the bus stayed at 300 V instead of 297 V).
    Lines are now at most 58 characters. It also sets the bench motor's
    measured values where the tuned config differs: l 0.0049 (conf0.l 0.023 is
    from the old L method), r 2.3, j 0.00003. With the config's l, the
    simulated current loop ran at the configured 1000 rad/s, ~4.7x slower than
    on the real motor.
2026-10-14 hwtest/soak: long-term reliability runs on the simulated and the real drive
    run_soak.sh sim|hw|console starts LinuxCNC headless from a copy of the
    burn-in config (burnin-sim with stmbl_sim, or burnin with hm2), with
    soak.py as the display program. It runs soak.ngc in AUTO mode over and
    over (36 s: rapids, 2..500 mm/s feeds, reversals, 0.05 mm steps, blends)
    and between cycles checks the drive over its console: HAL state and rt
    max, uptime (reboots), faults, DC bus against its first reading, HV and
    motor temperature, following error during and after the cycle, config
    read-back against the baseline, and optionally the long-line handling.
    Any failure switches the machine off and ends the run (o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
2026-10-14 servoterm-cli: add --autotune command
    Runs the rlpsij motor parameter identification state machine from the CLI
    and optionally writes the results to flash config.
    Usage:
    servoterm-cli -d /dev/ttyACM0 --autotune
    servoterm-cli -d /dev/ttyACM0 --autotune --autotune-comp rlpsij0 \
    --autotune-timeout 120
    Flow:
    1. Send <comp>.en = 1 to start identification
    2. Poll <comp>.state every ~0.5 s, printing each state transition
    (1=R, 2=transition, 3=polecount, 4=psi/friction/damping, 5=J, 6=done)
    3. On state 6 read: r, psi, polecount, j, friction, damping
    4. Print results with units
    5. Interactive prompt: [w]rite to flash / [s]kip / [q]uit
    (non-interactive stdin: skip with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
2026-10-14 servoterm-cli: fix autotune config patching, skip implausible results
    Tested --autotune against the simulated drive (stmbl_host --drive --pty).
    The bench config lists conf0.j and conf0.polecount twice; conf_patch only
    replaced the first line, so the later (effective) duplicate kept the old
    value. It now replaces the last line for the key and drops earlier
    duplicates, tagging the line "# autotune <date>".
    Results that are physically impossible (r/psi/j <= 0, f/d < 0,
    polecount < 1) are flagged IMPLAUSIBLE and never written. Also fixes a
    leaked buffer (conf_read output was normalized a second time).
    DEBUGNOTES: record rlpsij psi/J errors and state-5 overspeed on the drive
    sim, and its missin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
2026-10-14 rlpsij: bound state 5 speed, abort runaways, fix J estimate
    State 5 (inertia) applied +-test_cur for 2 s each with no speed check; on
    the simulated ECMA drive a light rotor reached 535 rad/s (max_vel 320).
    - State 5 reverses torque at +-max_vel (new pin, default 10 * test_vel)
    using the raw velocity, since the 0.99 filter lags ~20 ms. A heavy rotor
    that never gets there reverses after vel_time / 2 as before.
    - At the end it brakes to standstill instead of coasting.
    - J per segment between reversals = net torque integral / velocity change.
    The old acc = (raw - filtered vel) / period read ~90x high; motsim now
    gives 0.000997 for 0.001 and 4.9e-5 for 5e-5.
    - Runaway guard in states 4 a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
2026-10-14 host: add self-checking test suite (make check)
    host/tests/*.test are stmbl_host scripts with @ directives; run_tests.py
    expands them, runs stmbl_host and prints TAP, exiting non-zero on any
    failed check:
    @args / @include / @timeout / @reject
    @sample PIN DT T query PIN every DT for T seconds
    @expect PIN[k] OP V | PIN ~ V TOL | max|PIN| OP V | min PIN OP V
    Tests (47 checks, ~4 s):
    - drive_id_pmsm, drive_id_mot, drive_jog: @include the examples and check
    the values their comments documented (r/l/psi, idm ls_j/d/f/o, jog
    speed both ways, commutation 4 -> 1, no fault).
    - rlpsij_drive_light/heavy/revfb: state 5 speed bound, time-based
    reversal on a heavy rotor, runaway abor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
2026-10-14 rlpsij: identify 20 real motors correctly; add motor test suite
    host/tests/motor_*.test run the autotune on 20 motors from conf/*.txt
    (r 0.4-25.5 ohm, j 1.5e-6-3.5e-4, polecount 1-5) on the simulated drive,
    generated by tests/gen_motor_tests.py. The old rlpsij got r/polecount but
    psi wrong on all 20 and j on 19, r = 0 at 25.5 ohm, aborts on light rotors.
    Now all 20 pass: r and psi within 1%, j within 7.4%, friction within 9%,
    l within 7% where l/r >= 0.9 ms, peak speed <= 66 rad/s.
    rlpsij:
    - state 1: integral gain scales with the voltage reached, so the current
    settles in ~50 ms for any r (was ~2.5 s at 25 ohm, past rl_time)
    - state 2 (was empty): l from a voltage square wave at standstil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
2026-10-14 host: 35-motor autotune set, soak suite; fix vel2 feedforward in pid template
    Autotune set: tests/motors.py (shared table) now has 35 motors: 30 from
    conf/*.txt and 5 synthetic corners (2 kW servo, 14 pole-pair torque motor,
    spindle, micro servo, l/r 200 ms). All pass. Synthetic damping now scales
    with peak torque like the bench motor's (a fixed 1e-4 was more than the whole
    drive torque of the micro servo).
    rlpsij state 1: r from a least-squares fit ud = r*id + l*did/dt (was ud/id
    averaged once settled): with l/r = 200 ms the current is still rising and
    r read +37%.
    Soak suite (make soak, SOAK_CYCLES=N): tests/gen_soak_tests.py tunes each
    motor with the drive's id_pid, then runs it in clos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
2026-10-14 ids (id_pid): warm-up cycle, test move within motor limits
    Investigated the 4 motors whose id_pid gains failed the soak.
    - The first cycle starts from rest and costs far more or less than later
    ones, and was compared with a fixed min_cost of 400: the spindle's first
    cycle (577) cut vel_bw to 70 before any comparison; on sgmph_01a1 and
    the torque motor a low first cycle made the first step look 20% worse.
    The first cycle is now a warm-up (ids0.rep cycles, default 1) and the
    first scored cycle sets min_cost.
    - The test move was fixed at 100 rad/s, 1000 rad/s^2: the spindle needs
    20 Nm for that (peak 14.4) and the torque motor tops out at ~33 rad/s, so
    the loop saturated and the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
2026-10-14 encmon: encoder monitor prototype (back-EMF residual), sim fault injection
    shared/comps/encmon.c checks the motor feedback against the dq voltage
    equation: with the encoder's electrical angle and speed, the measured
    voltages must equal r*i + l*di/dt + cross-coupling + back-EMF. A wrong speed
    (lost/extra counts, slipping coupling) leaves a q residual, a wrong angle a
    d residual. The filtered residual relative to psi*w above thres (0.3) for
    trip_time (20 ms) latches a new fault, 17 FB_MON_ERROR ("encoder
    monitor", fault0.fb_mon_error). Active only above min_bemf (5 V) and below
    90% of the available voltage. Enable with `link encmon`.
    Two things the first version got wrong, found in the sim: v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
2026-10-14 sim: induction motor model (hv0.sim_type = 1)
    host/hw/hv.c can now simulate an induction motor instead of the PMSM: T
    equivalent circuit in the stationary frame, states stator current and rotor
    flux, parameters sim_r (rs), sim_rr, sim_lm and sim_l (total leakage, split
    evenly). sim_id/sim_iq are the stator current in the rotor flux frame;
    sim_flux and sim_slip are new. Matches the steady-state equivalent circuit
    within 0.5% (torque, current, rotor flux) with and without load. PMSM path
    unchanged (make check passes).
    host/examples/conveyor_100w.conf: a 100 W 230 V 4-pole conveyor motor on the
    existing V/f path (link uf, link sserial_uf), with its --sim file.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
2026-10-14 acvf: sensorless V/f for induction motors (conveyors), sserial feedback
    New component shared/comps/acvf.c (templates acvf, sserial_acvf), next to
    the existing uf: torque from active power minus copper loss, slip
    compensation (motor model rr/lm/ll, or nameplate slip_n/torque_n),
    flux-holding voltage with the resistive drop, current limit with thermal
    derating on the limit (not the voltage), stall flag (sserial in2), and an
    estimated rotor speed/position fed back to LinuxCNC through linrev
    (pos_fb/vel_fb) instead of the command echo of sserial_uf.
    On the simulated 100 W motor (host/examples/conveyor_100w.conf), 25-45 Hz,
    0-100% load: speed within +-0.2% with the motor model (+9.5% worst with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
2026-10-14 idacim: induction motor autotune at standstill; acvf damping; acim tests
    idacim (template id_acim) identifies rs, rr, lm and the leakage without
    turning the motor, so a conveyor belt can stay on: dc for rs, a fast
    voltage square wave for sigma*ls, a current step for the rotor fitted with
    the measured current (e = ud - rs*id - sigma*ls*did/dt; e*tau_r = a*id -
    phi, a = lm^2/lr). On 4 simulated motors (100 W 4p to 750 W 2p): rs 0.5%,
    rr/lm/tau_r ~3%, leakage ~6%.
    acvf: active damping (torque high-pass on the frequency, damp 1) - the
    370 W and 750 W motors hunted at light load with the ir compensation
    (17 / 79 rad/s peak to peak); stall pins renamed (blocked, block_time).
    Tests: tests/acim_<m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
2026-10-14 host: linear axis simulation (end stops, reference marks)
    hv: unwrapped position sim_abs_pos and hard end stops sim_min_pos /
    sim_max_pos, counted in sim_stop_hits. enc_fb: reference marks on the
    unwrapped position, single (sim_ref_mode 1) or periodic (2).
    drive.c: parse the --sim file line by line; a comment line used to
    swallow the rest of the file.
    examples/linear_axis.conf: ironless motor, 60 mm electrical period,
    5 um scale, 1 m stroke, one reference mark. Tests: commutation switches
    to absolute on the mark without a following-error step; periodic 20 mm
    marks re-latch at wrong angles and trip POS_ERROR (documented hazard).
    Claude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
2026-10-14 rlpsij: max_travel for limited strokes; linear axis soak and autotune
    rlpsij0.max_travel (rad, 0 = off) keeps the identification within reach
    of its start: state 4 drive segments head back past half of it and a
    coast heading away brakes, state 5 runs towards the start, and beyond it
    the run aborts. On the simulated linear axis (60 mm period) a 100 mm
    limit uses -39..+59 mm (unlimited: 0..+208 mm) with the same results.
    host: sim_pos is derived from the double position each step; as a
    separate float sum it drifted 0.06 mm per metre from sim_abs_pos and the
    reference marks. tests/gen_linear_soak.py (part of make soak): reference
    run, then 1 m/s / 10 m/s^2 moves within +-450 mm, gains from id_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
2026-10-15 hwtest/arcmate: measurement plan and record sheet for the ARC Mate arm
    FANUC ARC Mate A05B-1203-B255 (1993), no documentation: phases from
    inventory and per-motor identification through gear ratios, wrist
    coupling, kinematic calibration, backlash/stiffness, friction, gravity
    and balancer, full dynamic identification, and collision detector
    baselines. RECORD.md is the fill-in sheet.
    Claude-Session: https://claude.ai/code/session_015Arx3mBYT6sxmWehm9yoEa
2026-10-15 shared/robot: serial-arm dynamics library with tests
    Craig-DH (as LinuxCNC genserkins) recursive Newton-Euler in the form
    linear in the inertial parameters, with external forces; mass matrix,
    forward dynamics (Cholesky), energy, regressor for identification,
    armature through a coupled transmission, smooth friction, and the
    generalised momentum observer for collision detection (second-order
    step: integral of Mdot qd from the change of M).
    host/tests/robot/test_robot.c (in make check, 18 checks): against
    Robotics Toolbox for Python on a 6-joint arm with full inertias,
    consistency (M SPD, split of rnea, Mdot - 2C skew, regressor), energy
    conservation and work, a two-link arm by hand, J^T f, co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
2026-10-15 host/arm: six simulated drives on a simulated arm
    arm_sim loads the simulated drive once per joint (libstmbl_drive.so,
    dlmopen into separate namespaces, so the firmware's global HAL needs no
    change) and couples the drives to an arm plant: rigid links from
    shared/robot, per joint a gear spring/damper with backlash between motor
    (transmission matrix: ratios, wrist coupling) and link, gearbox friction
    (Coulomb, Stribeck, viscous), rotor bearing friction and motor brakes
    (applied so they stop motion but never reverse it), hard stops, and an
    external force on any link. The LinuxCNC side jogs or makes smooth joint
    moves over each drive's simulated smart-serial link, in joint degrees.
    hv: sim_ext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
2026-10-15 LinuxCNC as the arm's master: stmbl_arm module, arcmate-sim config
    host/arm/armcore.c: the arm and its drives as a library (from arm_sim),
    shared by arm_sim and host/arm/lcnc/stmbl_arm.c, a LinuxCNC (2.9,
    uspace) realtime component that runs the six simulated drives and the
    arm in the servo thread; per joint the drive's smart-serial pins (joint
    degrees in genserkins' DH theta) plus truth pins (link angle, J^T f of an
    applied force, gear torque, stop hits) and a force input.
    hwtest/arcmate-sim: genserkins config (DH from arcmate.arm), absolute
    homing, and lcnc_test.py, a headless display: machine on, home, MDI lines
    in Cartesian space with a wrist reorientation, a rapid back, machine off;
    15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
2026-10-15 armcollide: model-based collision detection, tested in sim and LinuxCNC
    shared/robot/collide.c: momentum observer on the joint torques measured
    through the motor currents (gear ratios, wrist coupling, kt), minus a
    smooth friction model; per-joint thresholds with a stiction band near
    standstill (stiction holds an unknown part of the load there); hold-off
    after enable; latched until disabled.
    linuxcnc/armcollide: the LinuxCNC realtime module around it.
    hwtest/arcmate-sim wires it into the estop chain; lcnc_test.py: no
    detection during the normal moves, a 150 N push mid-move is found on J3
    (~13 ms), LinuxCNC goes to estop, the arm stops within 0.5 deg, and
    comes back on after reset (23/23).
    h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
2026-10-15 Arm kinematics (FK/IK, as genserkins), arm_sim motion engine, detector fixes
    shared/robot/kin.c: flange pose, genserkins' A B C (R = Rz Ry Rx),
    rotation vectors, geometric Jacobian, inverse kinematics (damped least
    squares from the current joints). Tests: round trips, Jacobian vs finite
    differences, IK convergence, and against LinuxCNC's genserkins
    (genserkins_ref.txt recorded from hwtest/arcmate-sim: 8 poses agree to
    1e-5 mm / deg).
    arm_sim: segments as LinuxCNC's planner sends them: smooth and
    trapezoidal joint moves, LinuxCNC's free-planner jog, Cartesian lines
    with reorientation, arcs and welding weaves (IK every 1 ms); LinuxCNC's
    reactions (amp fault -> machine off, collision -> estop,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
2026-10-15 Arm soak suite: movement patterns and error scenarios (make soak)
    host/arm/tests/gen_arm_soak.py generates 24 scenarios into gen/arm_soak,
    run by make soak (SOAK_CYCLES repeats the motion):
    - movement, no reaction may fire: smooth joint suite, LinuxCNC jogs and
    trapezoids, random joint moves, Cartesian lines (cube edges), tool
    reorientation, circles in three planes, welding weaves, a repeated
    pick-and-place (end pose repeats to 0.05 mm), a declared 5 kg payload,
    0.3 A current noise; checks faults, stop hits, speed vs limits, path
    error, following error, IK / limit aborts;
    - errors, the expected reaction must fire: pushes on links 3/4/6 mid-move
    and at rest (estop within 50 ms), a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
2026-10-15 LinuxCNC soak of the arm (G-code, error scenarios); collision latch
    hwtest/arcmate-sim: soak.ngc (cube lines, reorientation, circles in XY
    and XZ, a welding weave, rapids; Cartesian through genserkins) runs
    SOAK_CYCLES times under lcnc_soak.py (make soak), then error scenarios:
    declared payload (clean), undeclared payload (estop), push mid-program
    (estop), drive link loss (amplifier fault, machine off), operator estop
    in the weave (brakes hold), jog past a soft limit (stops there). 25/25
    with 2 cycles; the end pose repeats within 0.01 mm.
    stmbl_arm: per-joint link-lost input (fault after 3 missed replies, as
    hm2's sserial error wired into amp-fault), payload pins. armcollide:
    payload pins;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
2026-10-15 Collision reaction: stop, 20 mm backoff, estop (armguard); arm geometry
    shared/robot/geom.c: capsules/spheres on the arm's links, sphere,
    capsule, box and plane obstacles; exact signed distances (segment-box by
    convex search on the box SDF), closest points and normals; clearance
    including self pairs. Tests against brute force.
    shared/robot/guard.c: the reaction: synchronised stop from the commanded
    speed, then a 20 mm straight retract of the flange (IK), back along the
    path when moving, else along the contact force estimated from the
    collision residuals; hold, then estop. linuxcnc/armguard wraps it between
    motion and the drives (motion is fed its own command while the guard
    drives; the esto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
2026-10-15 3D collision prevention: protective stop before contact (armguard)
    shared/robot/guard.c rb_guard_watch: every servo period, before the
    command goes out, check whether the arm could still stop (the guard's own
    synchronised stop, decelerations astop) without coming within the margin
    of the cell's obstacles or of itself (geom.c bodies, 4 points along the
    stop path); if not and it is approaching, stop now, hold, estop (no
    backoff). Moving away is always allowed.
    armguard: prevention (cell: prevent MM), pins prevent-enable, clearance,
    clearance-stop, reason. hwtest/arcmate-sim: prevent 10 in cell.txt;
    lcnc_test: the move that hits the fixture with prevention off stops
    9.5 mm before it with preve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
2026-10-15 tools/step2cell.py: STEP (Fusion 360) to collider boxes for the cell
    Every solid in a STEP file becomes one oriented box (the smallest of the
    CAD axes, the principal axes and frames from the largest flat faces,
    refined by small turns), placed in the robot's base frame (--base) and
    written as geom.h obstacle lines; --margin, --min-size, --skip/--only;
    a fill report (body volume / box volume) flags bodies to split in CAD.
    gmsh's OpenCascade kernel reads STEP (pip install gmsh numpy; the
    session hook installs it).
    host/tests/robot/test_step2cell.py (make check; SKIP without gmsh): a
    STEP made with gmsh (a turned box, a cylinder, an L bracket, a screw),
    imported with a turned, offset base: cent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
2026-10-15 Electric gripper: 7th stmbl drive, finger measurement, grip detection, payload check
    - shared/robot/gripper.c: finger logic (contact by lag, measured width,
    GRIPPED / WRONG / EMPTY / LOST) and the payload procedure: the model
    takes the declared part at the grip, the mass is checked on the lift
    (least squares over the moving joints; friction hides it at standstill),
    or learnt when unknown; collide.c gets a mute flag
    - host/arm: gripsim.c (screw-driven fingers, box parts held by force),
    the gripper drive in armcore (gripper.tool, gripper.conf), include lines
    in arm files (arcmate_base.arm + torch.tool / gripper.tool), arm_sim grip
    commands and LinuxCNC reactions (off 6 mismatch,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
2026-10-15 Electric gripper under LinuxCNC: armgrip module, stmbl_arm gripper pins, test-grip
    - linuxcnc/armgrip: finger logic and payload check (shared/robot/gripper.c)
    as a HAL module: M64/M65 close/open, M68 width/mass/centre of mass, M66
    waits on gripped / payload ok; feeds armcollide's payload and new mute
    pin; grip faults (6 mismatch, 7 lost, 8 wrong/empty) drop the estop chain
    - stmbl_arm: the gripper drive's sserial pins, truth (force, held), drop
    injection; part lines and include in the cell file
    - armcollide: mute pin, observer reset on a payload change
    - guard.c: include in cell files; cell.txt / cell_grip.txt share
    cell_base.txt
    - hwtest/arcmate-sim: grip.hal, lcnc_grip_test.py (m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
2026-10-15 Tool changer (host): tool table, TCP kinematics, changer monitor and simulation
    - shared/robot/tool.c: tool table (tcp, toolmass, dock with approach and
    slide-out), TCP pose / IK, rb_changer: the pneumatic changer's monitor
    (lock sensors vs valve, tool ID, lost tool, no unlock outside the dock)
    - geom: bodies tagged 'tool N' count only while tool N is mounted;
    collide: a tool payload beside the part payload
    - host/arm: changersim.c (piston, capture / release at the dock, sensors,
    slip injection), arcmate_changer.arm + tools.txt (torch, gripper as tool
    2), arm_sim lock / toolexpect / ktool / toolslip, Cartesian moves on the
    TCP; off_reason 9 (changer), 10 (kinematics on another to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
2026-10-15 Tool changer under LinuxCNC: armkins (TCP via switchable kinematics), armtool, M6 remap
    - linuxcnc/armkins: genserkins-convention kinematics on shared/robot
    kin.c with the tool's 6D TCP; switchkins type = tool ID (M68 E3 +
    M66 E0 L0); a drop-in for genserkins with tool 0
    - linuxcnc/armtool: the changer monitor (rb_changer) as a HAL module:
    valve, sensors, mounted tool -> armcollide tool payload and armguard
    tool bodies, dock data for the M6 routine, faults into the estop chain
    - stmbl_arm changer pins, armcollide tool-* pins, armguard tool pin
    - hwtest/arcmate-sim: changer.hal, cell_changer.txt, toolchange.ngc +
    dockread.ngc (M6 remap), lcnc_tool_test.py (make test-tool, 13
    check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
2026-10-15 Drive input power over smart-serial: pe0.p_in, sserial power field
    - shared/comps/pe.c: fixed (3/2 (ud id + uq iq), copper losses 3/2 R i^2,
    was ud*id twice and 3/2 = 1), fed the hv's dq voltages; p_in: the
    drive's input power over the inverter efficiency (times it when
    regenerating) plus the idle draw, low-passed; loaded in pid / mpid
    - sserial: a 16 bit signed 'power' input process value (W, +-16384, after
    current: byte aligned), 96 input bits; table regenerated with
    tools/gentable.c (scale_address moves to 324); sserial0.power =
    pe0.p_in in the sserial template
    - host: stand-in and LinuxCNC stmbl_sim carry it (stmbl-sim.0.power,
    quantised as on the link); tests drive_power (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
2026-10-15 powerquota: power quotas (fuses) for the drives, slowing the motion before one blows
    - linuxcnc/powerquota: quota.c (fuse models: thermal trip curve with
    log-log interpolation, magnetic trip, cooling; damage d' = 1/t(I/In);
    built-in B C D breakers and gG fuses, own profiles in the config; any
    number of quotas, each drive's share per quota: 1 per phase, 1/3 for a
    three-phase drive; regeneration credit; feed scale from damage and the
    magnetic margin; alarm before the fuse) and the HAL module (power-N in,
    feed-scale -> motion.adaptive-feed, per-quota power / current / load /
    damage, alarm + estop chain)
    - host: test_quota (model unit tests, in make check); host/lcnc Makefile
    fin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
2026-10-15 Power quotas on the arm: per-joint drive power, two drives per phase
    - stmbl_arm: stmbl-arm.0.J.power and .grip.power (the drives' input power
    over smart-serial); arm_sim: print power
    - hwtest/arcmate-sim: powerquota.hal (six drives into powerquota, the
    feed scale into adaptive feed, into the estop chain after the
    collision guard), quota.txt (three phases C 16 A, J1 J2 / J3 J4 / J5 J6),
    make test-quota (lcnc_quota_test.py: L1 sized below the sweeps: slowed
    to ~0.3 with M52 P1, L2 / L3 untouched; alarm at damage 0.9 without)
    - host/arm/lcnc/Makefile: objects depend on stmbl_sim_api.h (a stale
    struct layout hung stmbl_arm's first servo call); DEBUGNOTES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
2026-10-15 powerquota: meter pins: total-power-avg, -peak, energy, meter-reset
    total-power is the drives' sum every servo period (noisy); for meters and
    debugging also total-power-avg (low-passed over avg-time, 1 s), the peak
    and the net energy [Wh] since a rising edge on meter-reset. Checked in
    make -C hwtest/burnin-sim test-quota.
    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
2026-10-15 Revert the power quota / smart-serial power field from master
    It changes the smart-serial protocol (a new process data field, the
    scale parameter's address); it lives on branch claude/power-quota until
    it is tried on hardware. Reverts 9ad2d54 and 0b2307d. To bring it back:
    revert this commit, then merge claude/power-quota.
    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
2026-10-16 Smart-serial power in 8 bits (20 W a step, noise-shaped), room for a console
    power was 16 bit; with a console field the drive's input data would not
    fit old Mesa bitfiles (96 bits). Now 8 bit signed, full scale 2560 W
    (hostmot2: raw / 128 * 2560 = 20 W a step, to +-2540 W; stmbl is 2 kW),
    rounded with error feedback (shared/sserial_q.h) so the average is
    exact. Input data 88 bits: 8 left for the console.
    - shared/sserial_q.h: ssq_encode, used by the firmware and the host stand-in
    - tests: test_ssq (mean exact, a frame within a step, saturation without
    windup), check_sserial_table (8 bit, 2560 W), burnin-sim test-quota reads
    the averaged power at rest
    - docs, DEBUGNOTES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
2026-10-16 Console over smart-serial: con_cmd / con_fb fields, sscon link layer, drive side
    - shared/sscon.c: a byte stream in a 10-bit process data field each way
    (a byte, the sender's toggle, the ack): alternating-bit both ways, so
    lost or repeated frames delay bytes, never lose or duplicate them; flow
    control; ~1 kB/s at 1 kHz. Lock-free single-producer rings.
    - smart-serial table: con_cmd (to the drive) and con_fb (from it), 10 bit
    stream (hostmot2: raw u32 pins); 80 / 96 bits, no padding (fits old Mesa
    bitfiles); scale_address 380. gentable: stream type; padding ifs braced
    (ADD_PROCESS_VAR is several statements: crashed when none was needed)
    - firmware: the console steps only on a vali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
2026-10-16 sserialterm: drive consoles over smart-serial as ptys in LinuxCNC
    - linuxcnc/sserialterm: LinuxCNC's end of the console link (sscon): one
    instance per drive, a pty each (tty=), a thread moving bytes; pins
    con-fb / con-cmd to hm2's con_fb / con_cmd, byte counters, active, client
    - host/lcnc stmbl_sim: con_cmd / con_fb pins, as hostmot2's
    - hwtest/burnin-sim: console.hal, make test-console (con_test.py:
    unmodified servoterm-cli over the pty: about, pin read / write, --dump
    identical to the drive's config, console traffic while the axis moves)
    - docs, DEBUGNOTES
    Claude-Session: https://claude.ai/code/session_015Arx3mBYT6sxmWehm9yo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
2026-10-16 Capture scope in the drive, downloaded over the (smart-serial) console
    - shared/comps/scope.c: up to 8 pins into 4096 samples of drive memory at
    the rt or frt rate (div), trigger (source, level, edge, pre-trigger),
    single / normal / auto, forced; commands scopearm, scopetrig, scopestat,
    scopedump (channel sources and ranges, 16 bit samples in base64 lines
    with a CRC-16 each). Loaded by the pid / mpid templates, idle until armed.
    - servoterm-cli --capture FILE [--no-arm] [--capture-timeout]: arm, wait,
    download, check, CSV (t from the trigger, columns named by source)
    - tests: scope_capture.test (triggered, forced, normal mode re-arming),
    scope_console.test (a dump over the consol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
2026-10-16 Smart-serial bootloader sketch: Mesa's setsserial flash protocol and in-band staged updates
    - docs/sserial_bootloader.md: two paths. Recovery via LinuxCNC's
    setsserial flash (LBP: 0xEC non-volatile flash mode, window at
    0x8000..0x8007, 0xFE erase / 0xFD write, 0xDF cookie 0x5A, block 0 the
    bootloader's, 115200 baud). Routine updates in-band over the console
    (fwbegin / fwdata / fwend / fwapply), staged, checked, copied by the
    bootloader. Memory layouts for the stmbl F4 and brdstepper G431; what is
    done and what is left for hardware.
    - shared/lbp_flash.c: the device's side of setsserial flash (behind the LBP
    parser): window, commits, block-0 and range protection, uniform blocks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
2026-10-16 Smart-serial bootloader and in-band updates: loader, fwup, --update, mkssfw
    The F4 and G4 have one flash bank: erase/program stalls every fetch,
    interrupts included (128 kB erase 1-2 s, a word 16-100 us). The design
    follows from that:
    - bootloader: a smart-serial loader at 115200 (lbp_dev byte parser +
    lbp_flash, RX by DMA) for setsserial flash. It erases the application
    area before answering, so erase commits find blank blocks
    (lbpf_erase_lazy) within hostmot2's 1 s wait. Triggers: "SSBL" RAM word
    (sserialboot), bad application (DFU after 30 s without LBP traffic);
    applies a pending staged update (fwst_boot) and keeps staging blank.
    Builds to ~7.5 kB.
    - fwup component: fwbegin/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
2026-10-16 Console and capture scope: full tests and documentation
    - docs/sserial_console.md: setup, the frame, the link protocol, drive and
    LinuxCNC sides, servoterm-cli over the pty, limits, troubleshooting,
    tests.
    - docs/capture_scope.md: every pin, capture lengths, trigger semantics,
    modes, unattended fault capture, commands, the dump format, cost.
    - host/tests/test_scope.py (20): every scope setting checked on decoded
    samples (edges, div, pre 0/1, single/normal/auto, arm pin, 8 channels,
    nch clamp, fast, quantisation, refusals).
    - host/tests/console_link.test (10): over-long line, link loss mid-reply
    and reconnect (new host commands lcncstop, conreset), traffic while
    enabled and movi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
2026-10-16 brdstepper: hardware plan (MCU, pins, variants, parts) and software plan
    docs/brdstepper_hw.md: STM32G473CEU6 recommended (same 48-pin footprint
    as G431CBU6 / G474CEU6, pin plan checked against ST's pin data for all
    three; 128 kB RAM, 512 kB dual-bank flash, so updates no longer stall the
    CPU), pin plan with USB, smart-serial and CAN variants on one layout
    (hardware ID divider), parts list, and the software plan: a new target
    directory reusing shared/ rather than a new code base.
    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
2026-10-16 brdstepper: two-coil current loop, stepper plant, stp_ttc, closed-loop tests
    - shared/bip_loop.c: the current loop for two coils on two H-bridges
    (rotor frame from the encoder's electrical angle, the F3 curpid's
    predictor / PI / feedforward, the voltage circle inside the bridges'
    square). Plain C, for the drive and the simulator alike.
    - host/hw/hv.c: sim_motor = 1 runs bip_loop at 20 kHz and a two-phase
    hybrid stepper (back-EMF, 50 pole pairs, detent 4 per electrical turn)
    at 80 kHz; the mechanics now shared by both motor types.
    - shared/comps/stp_ttc.c: torque -> current for two phases, detent
    compensation; conf/template/stepper.txt in place of pmsm.txt.
    - shared/comps/pe.c: ph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
2026-10-16 brdstepper: current sensing through the DRV8876's one-sided IPROPI
    IPROPI only mirrors the low-side MOSFETs, drain to source: a sample in the
    drive window reads the current only if it flows the way the bridge drives,
    a sample in the brake window reads its magnitude. bip_sense makes a signed
    current of the two, with the sign from the current command when the drive
    window is too short, and a noise floor in every branch (a rectified |noise|
    held the motor a full step off before).
    - host/hw/hv.c: sim_sense = 1 models IPROPI (with per-sample noise);
    sense_window, sense_thr.
    - stepper_ipropi.test: the closed-loop suite on IPROPI sensing, 5 mA noise.
    - test_bip: the reconstruction's cases (19 ch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
2026-10-16 brdstepper: firmware target for the STM32G473 (builds; not yet on a board)
    brdstepper/ is a new target next to src/, reusing shared/ (HAL, commands,
    config templates, pid / vel / fault / scope / fwup / term / stp_ttc,
    sscon, fwstage, bip_loop):
    - drivers (CMSIS registers, RM0440; AFs from ST's pin data): 170 MHz from
    8 MHz HSE; TIM1 + TIM8 centre-aligned 20 kHz PWM, PWM mode 2 so the
    drive window is centred at the counter's 0 and the brake window at its
    top; ADC1 + ADC2 injected simultaneous on TIM1 TRGO2, sampling both
    windows (for the DRV8876's one-sided IPROPI); DAC VREF; SPI1 AS5047P;
    - frt from the ADC interrupt after the brake-window sample, rt every 4th
    in a software-pended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
2026-10-16 brdstepper: DRV8876 datasheet corrections, IPROPI offset calibration
    Checked against the DRV8876 datasheet (SLVSDS7B):
    - AIPROPI is 1000 uA/A (assumed 450): RIPROPI 2.0 kOhm, 1.65 A full scale;
    the IPROPI cap at most 100 pF (the windows need it settled in ~2 us).
    - IPROPI low side only, drain to source only: confirmed (7.3.3.1). With
    tPD 0.65 us and tDELAY 1.6 us, a window must be 4.8 us: sense_window
    0.12, max_duty 0.88.
    - PMODE high (PWM mode, 00 coast / 11 brake); IMODE open: fixed off-time
    chopping, overcurrent latched off, and nFAULT only for faults (in the
    cycle-by-cycle modes it also flags chopping).
    - Disabled now coasts (both inputs low) instead of braking; nSLEEP stays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
2026-10-16 brdstepper: hardware doc (connections, parts, bring-up), gdb bring-up tools
    docs/brdstepper_hw.md rewritten as the schematic's input:
    - power tree, a netlist per IC (MCU pin numbers from ST's pin data,
    DRV8876 RGT pins and straps from SLVSDS7B), the AS5047P, RS-422, CAN
    and USB parts, connector pinouts, analog front ends;
    - the full parts list by reference, variant table, layout notes;
    - a step-by-step bring-up: power, option bytes, clocks / PWM, analog,
    encoder, IPROPI against a current probe, motion with the sine
    generator, warm-up, what to record.
    Firmware for it: make option_bytes / option_bytes_show (BOOT0 pin
    ignored, DBANK = 1), tools/brd.gdb (brd, pin, hal, enc commands over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
2026-10-16 CAN support: investigation for stmbl and brdstepper
    docs/can_support.md: hardware (stmbl v4.0 routes CAN1 PD0/PD1 to header
    P10 with no transceiver; bxCAN classic only; brdstepper's FDCAN; classic
    and FD nodes cannot share a bus), bus timing (tools/canbus_budget.py:
    2 drives per bus at 1 kHz on classic 1 Mbit/s, 4-5 on CAN FD 5-8 Mbit/s,
    9-12 at 500 Hz), LinuxCNC's side (no CAN driver; a realtime SocketCAN HAL
    component to write; host interface options), protocol options (CiA 402
    vs. a smart-serial-shaped stmbl protocol with CANopen-style IDs and a
    chunked console: updates in seconds), work plan and open decisions.
    Claude-Session: http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
2026-10-16 CAN support: toolheads (what cobots do at the tool flange)
    UR, Doosan, Schneider and Elephant cobots put power, a few I/O and one
    2-wire RS-485 bus on an M8 8-pin flange; UR's joints run their own
    RS-485 bus. For an stmbl / brdstepper toolhead, CAN needs the same 4
    wires but is multi-drop, event driven and hot-plug friendly; options to
    reach LinuxCNC: a host CAN interface, the wrist drive as a smart-serial
    to CAN gateway, or RS-485 Modbus for bought grippers.
    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
2026-10-16 soak: record late LinuxCNC servo cycles as host_rt_delay info, not a failure
2026-10-16 flashsaveconf/hardboot: stop rt around the flash erase; faults: record and reset
    A sector erase stalls all flash fetches, interrupts included, for 0.25 s
    or more, so flashsaveconf stopped the drive with RT_TOO_LONG in 4 of 5
    bench trials. It now refuses while the drive is enabled, stops rt/frt
    for the write and starts them again. hardboot stops the HAL first too.
    The fault handlers returned into the faulting instruction and faulted
    again forever (USB alive, console dead). They now save a record in CCM
    RAM (survives the reset, printed by the new 'crash' command) and reset
    the chip; after 3 crashes without 10 s of running they halt as before.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
2026-10-16 sscon_out: copy 8 bytes per interrupt-masked section, not 64
    Each 64-byte copy held off frt and rt for about 9 us (rt time does not
    count it); a scopedump did that about 180 times. 8 bytes is about 1 us.
2026-10-16 DEBUGNOTES: flashsaveconf rt stall, fault record and safe mode, rt timing breakdown
2026-10-16 Bring back the power quota / smart-serial power field (revert f45f76fc)
    Merged together with the smart-serial console, which builds on it.
2026-10-16 hwtest/suite: hardware test suite for the real and the simulated drive
    Two phases, about 5 minutes on the bench. Drive (USB, no LinuxCNC):
    identity, HAL and rt, readings, console line handling, config dumps,
    --load and flashsaveconf with the HAL kept running, USB capture, reset,
    and on hw the fault record and safe mode. LinuxCNC (hm2 + sserialterm,
    or stmbl_sim): the smart-serial console (pins, dump, long line), the
    power field, machine on and enable cycles with the motor's swing at the
    enable, a motion program with following-error and speed checks, console
    traffic and a scope capture while moving, rt load. Bench: 26/26 on
    v0.9.18-274; sim 24/24 (fault tests are hw only).
    DEBUGNOTES: an int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
2026-10-16 hwtest: commit soak.ngc (*.ngc is ignored); suite runs servoterm-cli in the run dir
    servoterm-cli --load writes its config backup to the current directory.
2026-10-16 powerquota: ignore the build's .sym file
2026-10-16 sscon: a link timeout clears 'active' and drops unsent output
    After one smart-serial console session the drive kept queueing every
    print for the link; with LinuxCNC gone (or restarted without sserialterm)
    nothing drained the 2 KB ring and each 8-byte chunk waited 100 ms, so the
    USB console crawled at ~80 bytes/s until a reset. Found by the hardware
    soak right after a hwtest/suite run. test_sscon covers it, and the suite
    now checks the USB console's speed after LinuxCNC exits (post phase).
2026-10-17 CAN support: the data budget through the wrist drive
    From hostmot2's source: 224 bits per channel with sserialb firmware (96
    on older bitfiles). stmbl uses 80 bits to the drive and 96 from it. A
    toolhead with its fast loops closed on the tool needs ~36 bits out and
    ~48 back per servo period; it fits in 224-bit firmware, and in 96-bit
    only by compacting vel_fb. Slow tool data via rotating slots, tool
    configuration and updates through a console relay over CAN.
    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
2026-10-17 CAN support: Raspberry Pi with MCP2515s in LinuxCNC's realtime thread
    The kernel mcp251x / SocketCAN path (interrupt, threaded SPI, network
    stack, 2 receive buffers) is not for the servo loop. Instead, a realtime
    component that polls the MCP2515s over SPI once per cycle (spidev with
    batched transfers first, Pi 4 and 5; direct registers only if needed,
    as hm2_rpspi on the Pi 2/3). ~74 SPI bytes per bus per cycle, ~180 us
    for three buses at 10 MHz; at most 2 frames per bus toward the Pi per
    cycle (the receive buffers), 3 out; 3 buses x 2 drives at 1 kHz; the
    boards' crystal (16 MHz for 1 Mbit/s) and 5 V transceivers to check.
    Claude-Sess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
2026-10-17 CAN support: pin inventory (discovery and devices defined in a file)
    The smart-serial descriptor records (inc/sserial.h, tools/gentable.c)
    served over CAN for self-describing devices; the same records as text
    for devices without our firmware (frames, bit offsets, scaling; close to
    DBC; SDO start-up writes for CANopen devices); one in-memory table for
    both. HAL pins exist only from load time: discovery at load, declared
    tool slots for hot-plug with a match check, file / discovery precedence,
    MCP2515 filter limits.
    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
2026-10-17 stmblcan: MCP2515s on SPI from LinuxCNC's servo thread (Raspberry Pi)
    - shared/canproto.h: classic CAN frames for stmbl: SYNC with a counter,
    8-byte command / feedback (pos f32, vel 16 bit, flags, the console's
    10-bit field), slot values (current, power, temperature, supply) in
    every 8th feedback, chosen by the SYNC counter.
    - linuxcnc/stmblcan/mcp2515.c: the MCP2515 polled over an SPI callback:
    bit timing (16 MHz, 1 Mbit/s: CNF 00 91 01), acceptance filters for the
    expected feedback IDs with rollover, read (READ STATUS + READ RX
    BUFFER) at the start of the servo thread, write (abort late frames,
    LOAD TX BUFFER x 3, RTS) at its end; error flags.
    - stmblcan_bus.c: one bus's peri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
2026-10-17 CAN: the drive's side (can component) and a simulated drive over CAN
    - shared/comps/can.c: the drive's end of shared/canproto.h, with the same
    pins as sserial: the newest command applied at SYNC, the feedback
    answering it (slots: current, power, temperature, supply), the console
    through sscon0, timeout (CMD error) and the console reset on link loss,
    acceptance filters by node ID. On shared/can_hw.h, a per-board frame API.
    - conf/template/can.txt: sserial.txt with can0 for sserial0.
    - host: can_host.c, the drive's controller as a node on a simulated bus
    and LinuxCNC's end as on the Pi (linuxcnc/stmblcan's bus code and MCP2515
    driver on a simulated MCP2515, now host/mcp2515_sim.c);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
2026-10-17 CAN pin inventory: descriptions, devices without our firmware, discovery
    - linuxcnc/stmblcan/candesc.[ch]: one text format for a device (device,
    node, profile stmbl1 + vel_scale, or frames with fields: bit / uN / sN /
    f32 at a bit position, scale, offset, every N), from a file or from
    the device; errors with line and reason; the per-field codec; several
    devices per file.
    - stmblcan_bus: devices without our firmware beside the drives (their
    frames encoded / decoded per field, staggered "every N" frames), the
    per-period budget check (3 out with SYNC, 2 in), discovery
    (0x600 / 0x580 + node, 7-byte text blocks).
    - shared: canproto.h has the stmbl description and the discovery frame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
2026-10-17 stmblcan in LinuxCNC against the simulated drive; index homing fixes
    - stmbl_sim can=1: the simulated drive on a simulated CAN bus and MCP2515;
    stmblcan spi=sim drives that chip from LinuxCNC's servo thread (finds
    stmbl_sim_can_xfer / _wait in stmbl_sim.so), discovery included.
    - hwtest/burnin-sim: can.hal and make test-can (can_test.py): discovery,
    slot values, index homing, 500 mm/s rapids, bus counters, the console
    over CAN through sserialterm. 9/9.
    - stmblcan: index-enable is an io pin, cleared when the drive answers
    the armed command with the index found (stmblcan_bus: index_found);
    vel-clipped counts commands beyond vel_scale.
    - can comp: index_out = index_enable, as sseria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
2026-10-17 bootloader command: enter the ROM DFU through a reset, not a jump
    The app jumped into ST's ROM bootloader directly. After dfu-util's
    ':leave' (a jump into flash, not a reset) the next such jump went
    straight back to flash, so every other 'bootloader' just rebooted the
    app (10/20 round trips on the bench). Now the command sets the stmbl
    bootloader's magic word and resets; the stmbl bootloader enters the ROM
    from a clean reset. btburn: dfu-util waits for the device (-w).
2026-10-17 DFU entry: the app jumps into the ROM right after a reset; bootloader remaps
    The stmbl bootloader's DFU path (its magic word, or a bad app CRC) jumped
    into the ROM without mapping the system memory at 0 (AN2606), so the ROM's
    USB never enumerated: after an interrupted flash and a power cycle a drive
    needed BOOT0. It now remaps and takes the ROM's stack pointer. The app no
    longer depends on it: 'bootloader' leaves a request in CCM and resets, and
    main() jumps into the ROM (with the remap) before setting anything up.
2026-10-17 btburn: wait up to 30 s for the DFU device, then download
    (The previous 'timeout 30 dfu-util -w' also bounded the download and
    killed one at 59%.)
2026-10-17 hardboot: no interrupts once the vector table's sector is erased
    hardboot erases sector 4, which holds the app's vector table. The next
    interrupt (SysTick, USB) jumped into blank flash and locked the core up:
    USB stayed enumerated, the console was dead until a power cycle. Now
    interrupts are off from the erase to the reset, and it resets in any
    case (the stmbl bootloader checks the app CRC).
2026-10-17 DFU entry: retry until the DFU device stays; bootloader counts requests
    ST's ROM DFU goes back to flash on its own in about 1 of 20 entries
    (the bootloader did take the request each time: a counter in CCM,
    shown by 'about'), most likely on a USB reset while the host enumerates
    it. tools/bootloader.py now sends 'bootloader', waits for 0483:df11 and
    sends again if the app comes back, up to 10 times. The counter is reset
    at power-on.
2026-10-17 uid: the F4's and the HV board's F3 unique IDs on the console
    The F3 appends its 96-bit unique ID (0x1FFFF7AC) to the state words it
    sends round with every packet, now as raw u32. The F4 keeps them
    (hv_uid) and 'uid' prints the lv (F4, 0x1FFF7A10) and hv IDs and the USB
    serial number derived from the F4's. hv0: a conf_addr equal to the
    table size was clamped onto one past the end; such words are dropped.
2026-10-17 burn-in configs: a larger following error while the drive may autophase
    phasing_ferror.hal (POSTGUI_HALFILE, as it drives the ini.0.* pins):
    [JOINT_0]PHASING_FERROR (2 mm) until the joint is homed and has been
    enabled for PHASING_TIME (1.5 s), then FERROR / MIN_FERROR. Autophasing
    moves the rotor up to half an electrical period (~1 mm here) at each
    enable until the encoder index is seen. The headless suite and soak
    runners load POSTGUI_HALFILEs as a GUI would. hwtest: the limit test;
    the enable swing fails above 1.5 mm (was 0.1). Sim: 14/14.
2026-10-17 headless runners: wait for the task's ini.* pins before the POSTGUI_HALFILEs
    On the bench the DISPLAY program started before milltask had made
    ini.0.ferror, so phasing_ferror.hal failed and LinuxCNC hung. AXIS loads
    POSTGUI only once connected; the runners now wait up to 30 s. Bench:
    the LinuxCNC phase 15/15. DEBUGNOTES: the kick is worked around on the
    LinuxCNC side; phasing against a mechanical stop stays open.
2026-10-17 docs: Baldor linear motors reference (MN1800 manual, BR1202 catalog)
    Extracted for running Baldor linear motors on stmbl: families and how
    to tell them apart, electrical periods (LMCF 60.96 mm, LMBL A/B 45.72 mm)
    and the matching stmbl settings, AY1763A00 / LD9073A00 / stage D-sub
    wiring, encoders used on the stages, installation notes, LMCF and LMBL
    motor data with psi for stmbl, catalog numbers, and bring-up checks for
    the shop's motor (LMCF-like: 3-pin power, LD9073A00 Halls).
    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
2026-10-17 sim: hard stops, a boot-relative incremental encoder
    hv0.sim_stop_min / sim_stop_max: a dead stop on the new unwrapped
    position hv0.sim_upos (kept in double: float lost precision after many
    turns and skewed rlpsij's friction). enc_fb0.sim_boot_zero = 1 counts
    from 0 at boot like a real incremental encoder, so autophasing starts
    off by the rotor's angle at boot instead of exactly right.
2026-10-17 fb_switch: probe autophasing and a check after phasing (PHASING_ERROR)
    Probe phasing (phase_mode 1, default): 16 short current pulses around
    the assumed angle, the movement each causes correlated with its angle;
    the fundamental's phase is the q axis even with a stop on one side or
    friction. Pulses grow (current to phase_cur, then length to phase_time /
    4) until the rotor moves 4 * phase_min_move. The field turns between
    pulses instead of jumping (vel2 turned jumps into speed spikes, which
    cur_ind made into a q current the wrong way). Then, for both methods, a
    +q and a -q pulse must not move the rotor the wrong way and one must
    move it: else fault0 PHASING_ERROR (17), fb_switch0.phase_fail sa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
2026-10-17 fb_switch: probing keeps the position mapping; test that the rotor is back
    The align method takes the rotor's position after phasing as the
    commanded one; probing now keeps the mapping set while disabled, so the
    little the sweep leaves (its pushes cancel) is corrected by the position
    loop instead of becoming a hidden offset, e.g. on a re-enable while
    homed. drive_phasing_probe: the rotor ends within 0.003 rad of its start.
    (Probing in opposite pairs was tried: the 180 deg field turns made each
    sweep much slower.)
2026-10-17 fb_switch: after probing, absorb the command's movement, not the rotor's
    console_link (LinuxCNC jogs 0.5 s after the enable, while the drive is
    still probing) faulted on position error once the re-zero was gone: the
    command had moved on. Now the mapping shifts by how far cmd_pos moved
    since phasing began (as the re-zero did), while the rotor's own movement
    stays in the feedback. Host tests 432/432.
2026-10-17 DEBUGNOTES: autophasing kick and silent failure at a stop fixed by probe phasing
2026-10-17 hwtest/phasing: autophasing suite on the real drive
    Per position (12 by default, 0.55 mm apart so they spread over the 2 mm
    electrical period): reset the drive (a fresh boot, a new angle error), a
    fresh HAL session, enable, record the swing, the phasing time and its
    result (fault, phase_fail, probe current and length), then check the
    angle with a move out and back. Cases: probe (free), brake (held closed
    while phasing, released for the check move; PHASING_ERROR also passes),
    align with --align. Bench, v0.9.18-301: 36/36. probe swing
    0.013..0.119 mm in 1.5 s, brake 0.006..0.013 mm in 2.3 s (the brake's
    play is enough to phase), align 0.035..0.104 mm; check moves 0.09..0.21 mm.
    Co-Authored-By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
2026-10-18 docs: 1 µm encoder speeds; note on enc_fb input filter order
    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
2026-10-18 enc_fb: enable the timer clock before configuring it; A/B filter pin
    hw_init configured the input filter (TIM_ICInit, 0xF) before enabling
    TIM4's clock, so the writes were lost and FB0 ran unfiltered. The call
    also only reached channel B (TIM_Channel_1 | TIM_Channel_2 ==
    TIM_Channel_2), and its BothEdge polarity sets CC2NP, which encoder mode
    must not have. Now: clock first, no TIM_ICInit, and IC1F/IC2F written
    in CCMR1 after the encoder setup from the new pin enc_fb0.input_filter
    (default 3: 8 samples at 84 MHz, ~0.1 us). 0xF would limit a 1 um scale
    to about 0.65 m/s. Compiles for the F4; not yet run on a drive.
    Claude-Session: https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
2026-10-18 Emergency braking: quick stop and dynamic brake instead of coasting
    Every fault and every disable used to switch the power stage off at
    once, so a moving axis coasted (burn-in axis from 300 mm/s: 26 mm).
    - fault: per-cause stop modes (cmd_stop, en_stop, fb_stop, err_stop: 0
    coast, 1 quick stop, 2 dynamic brake), stop_time, escalation from a
    quick stop to the dynamic brake on a feedback fault; HV faults coast.
    A link timing out drops enable with its error: counted as a link loss.
    - qstop (command path, before pid): holds the last good command while
    the link is in trouble; on a stop, an S-curve trajectory from the
    feedback to standstill at a share (0.3) of the motor's deceleration.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
2026-10-18 Emergency braking: power-stage limits, F3 brakes when the F4 is lost
    - shared/vbrake.h: the virtual-resistor brake law, shared by the F4's
    dbrake, the F3 and the simulated F3. The current comes first: the brake
    holds 0.9 * max_ac_cur (below the F3's own voltage-mode clamp, which
    lowers the voltage and so works backwards for a resistor), capped by
    ABS_MAX_CURRENT on the F3; the power it then puts into the bus is
    reported (dbrake0.power), and rv backs off above high_dc_volt.
    - conf0.max_hv_power (the HV board's rating, default 1000 W): limits the
    quick stop's regenerated power, j * a * v (qstop0.max_power, .power).
    - brake_on_loss: a spare packet flag bit (compatible both ways), se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
2026-10-18 ebrake suite: all motors through the stops; brake fixes it found
    - host/tests/ebrake/: the estop_* tests moved here (still in make check),
    plus reverse, standstill, reenable, holding_brake, bus_high, giveup,
    f4dead_standstill, f4_returns, hv_during, stepper (22 tests).
    - tests/gen_ebrake_tests.py, make -C host ebrake: every motor in
    motors.py (35) through link loss (quick stop), encoder failure (dynamic
    brake) and F4 loss (F3 brake): current from the failure on (power stage
    peak, 1.3 x max_ac_cur from 5 ms), standstill, outputs off, distance
    against coasting and the planned quick stop, expected give-ups.
    105 tests, 1279 checks pass (+ the 22 hand tests).
    What it found, fixed: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
2026-10-18 Simulator: DC bus from rectified 230 V mains into the drive's own caps
    - host/hw/hv.c: sim_supply = 1 (sim_board.txt): 230 V 50 Hz through a
    single-phase diode bridge and sim_mains_r straight into the drive's
    540 uF (sim_cap), no supply caps. The bridge's power comes out of the
    caps and regeneration goes back into them. The F3 sees the bus through
    io.c's ~1.3 ms filter, sets its duties from that, and trips
    HV_VOLT_ERROR above ABS_MAX_VOLT (410 V) until disabled. A brake chopper
    (sim_chop_r 47 ohm, 345 / 335 V) stands in for the planned supply card.
    New outputs: sim_vbus, sim_ibus, sim_irect, sim_chop_e, sim_hv_fault.
    sim_supply = 0 keeps the stiff sim_udc; the stepper always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
2026-10-18 Setup wizard: servoterm-cli --wizard, from the nameplate to a tuned drive
    A step-by-step setup for one drive and its PMSM: firmware check, config
    backup, supply (mains / DC, brake chopper), nameplate, feedback type,
    wiring help (the docs' connector tables), a first config, the encoder
    resolution and direction by turning the shaft by hand (index counts on a
    counter wrapping at 65536), then id_pmsm, id_mot (twice), id_pid on the
    drive, limits, the command link, a verify step (hold, +-0.5 rad steps)
    and a saved config plus report. No motor database: the nameplate
    cross-checks what is measured (torque constant).
    - servoterm-cli/setup/: a C library in modules (ui callbacks, session
    state, driv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
2026-10-18 Holding brake: brake_time in fault, brake setup and test in the wizard
    - fault0.brake_time [s]: at a disable or when a stop ends, the brake is
    told to grip while the quick stop (or the dynamic brake) still holds the
    axis, then the outputs go off; fault0.brake_hold shows it. HV faults and
    a feedback fault without the dynamic brake still switch off at once;
    enabling ends the hold; 0 (default) keeps the old behaviour. A 50 ms
    brake under a 0.5 Nm hanging load: 18.7 rad drop without, none with 80
    ms (tests/ebrake/estop_brake_time.test).
    - Simulator: hv0.sim_brake_delay (the brake grips / releases late),
    sim_brake_on; a closed brake stops hv0.sim_turn (a hand can't turn it).
    - Wizar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
2026-10-18 smart-serial loader: card name sIbl, as hostmot2's setup mode requires
    At 115200 baud (setsserial) hostmot2 runs the smart-serial port in
    setup mode and keeps a remote only if the second byte of its card name
    is 'I' (Mesa's XIXX boards); it dropped 'stbl' without a word ('found
    a' with a blank name, no remote for setsserial). Found on the bench by
    running the loader's lbp_dev in the application at 115200: with 'SIBL'
    hostmot2 found the remote. The HAL name is hm2_<card>.<n>.sibl.<i>.<c>
    (hostmot2 lower-cases the second byte). test_bootloader checks the rule.
2026-10-18 smart-serial loader: answer every write; no erase inside a commit; 20 ms idle
    From Mesa's SSLBP source (7c81 package, SSLBP.MAC sendLBPstring,
    SSLBP.SUB recvstring): SSLBP waits for exactly one reply byte to every
    local and memory write, the CRC of no data (0x00). The loader answered
    local writes by luck and memory writes not at all: on the bench every
    write of setsserial timed out (50 ms) with the error flag, the data
    still landing. Local writes now have their CRC checked too.
    SSLBP wants a commit's reply and the cookie within 50 ms each; a sector
    erase takes 250..500 ms. A commit that finds stale data now fails at once
    (setsserial aborts) and the application area is erased once the line h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
2026-10-18 setsserial recovery and in-band updates tested on the bench; docs, tests
    - servoterm-cli --update exits 0 after applying (it read the port while
    the drive reset)
    - make ssfw_install: the image where setsserial looks, with the .BIN name
    it insists on
    - hwtest/suite (hw): update over USB, and hardboot -> setsserial flash
    through the loader; both only when the drive runs the repo's build;
    skipped tests show as skip
    - docs/sserial_bootloader.md: the working procedure (sIbl, /lib/firmware,
    sserial_baudrate, wait ~15 s), what SSLBP expects, bench results
    - inc/commandslist.h depends on the Makefile
    - DEBUGNOTES: the four bench findings
    Bench: update 83 s over USB, 820 s over smart-seria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
2026-10-18 docs/hmi: operator screen, teach pendant and real-time 3D previews for the arm
    Design previews for a LinuxCNC HMI of the six-axis cell: arm3d.html (a
    WebGL view posed from joint angles, a pick-and-place cycle in 1 ms servo
    steps, TCP trail, collider boxes and a clearance guard that slows and
    stops), operator.dc.html and pendant.dc.html (Design-canvas artboards:
    mode bar, joint DROs, the seven drives, side view, pose, jog, gripper,
    power quota, safety; a pendant with a deadman). README maps every panel
    to the pins on this branch and lists the ways to render the arm live.
    Claude-Session: https://claude.ai/code/session_015Arx3mBYT6sxmWeh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
2026-10-18 linuxcnc/vis3d: native 3D view of the arm, a C library with shaders and a QtVCP widget
    For a Raspberry Pi 4 GUI: the geometry is uploaded once, a frame is one
    matrix per link and one draw call per part; Python only passes joints in.
    - libvis3d.so (model.c, render.c): model files with Craig DH joints (the
    same lines as arm_sim / armkins; arm_sim models can be included), parts
    (box, cylinder, ring, sphere, capsule, STL), materials, geom.h
    obstacles. Draws into the host's current context through its getproc,
    linking no GL library; one shader source mapped to GLSL ES 3.00 / 1.00
    and 3.30 / 1.20. The look: studio lighting, fresnel rim, glowing joint
    rings, a procedural floor grid wit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
2026-10-18 arm6hmi: QtVCP operator screen for the six-axis arm with the vis3d view
    The operator screen of docs/hmi/operator.dc.html as a QtVCP screen
    (linuxcnc/arm6hmi):
    - joints, drives, the 3D view with the guard, pose, program/MDI, jog,
    teach, gripper, power quota, safety and events;
    - the 3D view is linuxcnc/vis3d's Vis3dView.
    The screen tests itself through its own buttons in arcmate-sim
    (make test-hmi, Xvfb): 16/16 checks plus a screenshot.
    vis3d:
    - 'joints theta' for LinuxCNC's DH theta joint values (arm6_lcnc.vis);
    - guard-state + clearance in mm against the cell's prevent limit;
    - GLSL dialect chosen by a tested pure function, plus a GL 3.1 render test;
    - VIS3D_GLES / VIS3D_SAMPLES for the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
2026-10-19 arm6hmi: jog pad and live tool change views; vis3d draws the tool changer
    The ARM-6 screen gets three views around the 3D view (header tabs):
    - OVERVIEW: as before;
    - JOG PAD: big keys, joints left and X..C right. A key switches
    LinuxCNC to its frame (joint / world) before jogging; it shares the
    increments and speed, and has record / home / grip;
    - TOOLS (with armtool): the tool on the flange, the tool table with
    IN DOCK / ON FLANGE and Mount (T<n> M6, after an optional
    TOOL_READY pose), progress, the changer's lock, sensors, ID, the
    kinematics' TCP and faults.
    - the tool table (tool / tcp / dock lines, part|body ... tool T);
    - vis3d_load_cell adds armguard's cell (obstacle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
2026-10-19 hwtest/fbtest: Arduino Uno fixture for testing a feedback port
    Firmware (A0..A5 on RJ45 pins 1..6: drive levels, measure each line,
    quadrature, edge count) and an optiboot uploader. The Uno must be powered
    from USB, not from the port's 5 V (DEBUGNOTES).
2026-10-19 hwtest/fbtest: feedback-port test runner
    fbtest.py checks fb1 with the Uno against the v4.0 schematic: pin 7
    supply, the idle bias of each line, each line's resistance to its bias
    (from the drop across the 120 R termination), and each pair driven both
    ways (termination, receiver polarity, sin/cos clip levels). 36/36 on the
    bench drive.
2026-10-19 fbtx: rename fb1_out (a digit in a comp name hides its pins)
    The console parses <comp><instance>.<pin> with %[a-zA-Z_]%li, so
    fb1_out0.en_a was comp fb, instance 1: not found. create_hal_tbl.py now
    refuses such names; host/tests/test_comp_names.py.
2026-10-19 hwtest/fbtest: transmit test with fbtx
    Loads fbtx into RAM, checks each fb1 transceiver both ways into the
    termination (2.9 V differential, 2.68 V offset on the bench drive), the
    other pairs undisturbed, quadrature edges counted by the Uno; resets the
    drive afterwards. 57/57.
2026-10-19 hwtest/fbtest: document the fixture, tests, fb1 circuit and the rev 2 plan
    Bench reference values, the fb1 network from the v4.0 schematic, fbtx,
    the limits of the method, and the planned PWM sin/cos sources (both ends
    of each pair, no analog switch) with the tests they enable.
2026-10-19 Probe phasing with cur_ind: vel2 off while phasing; tests wait for phasing
    - pid.txt: vel2.en = fb_switch0.state. vel2 followed the probe's field
    turns (up to ~94 rad/s, rotor still) and cur_ind fed that speed forward
    as q current, larger than the probe pulse: the angle was ~11.5 deg off,
    and on a light rotor at a high current the check failed (fault 17).
    Now within 0.6 deg with and without cur_ind. drive_phasing_cur_ind.test;
    phasing_check_light_rotor.test no longer a TODO.
    - gen_soak_tests.py: the soak started 1.5 s after enable; probe phasing of
    heavy rotors takes longer (four motors failed on master since
    2026-10-17). Phasing current at 25 % of the motor's, 3 s, checked.
    -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
2026-10-20 ebrake on hardware: hv0.drop_link, an ebrake phase in hwtest/suite
    - hv0.drop_link: the F4 sends nothing to the F3 for that many seconds,
    as if it had stopped; the F3 brakes on its own (brake_on_loss) while
    the F4 keeps reading the encoder, so the stop can be captured. It
    counts down: the link comes back by itself.
    - hwtest/suite --phase-only ebrake: machine off, smart-serial link loss,
    a forced feedback fault and the F3 on its own, at 50/150/300 mm/s
    (EBRAKE_SPEEDS, EBRAKE_KINDS); each captured by the drive's scope:
    distance, time, peak current and bus, the stop mode, and the drive
    back in service afterwards.
2026-10-20 ebrake phase: measure from the encoder, robust triggers; hardware results
    All four causes at 50/150/300 mm/s pass on the bench drive (300 mm/s:
    machine off 1.46 mm, link loss 1.49 mm, feedback fault 0.55 mm, the F3 on
    its own 0.75 mm; coasting ~30 mm). Link loss by stopping the card's
    smart-serial port; triggers on fault0.state / hv0.drop_link; distance
    from enc_fb0.pos; the console's stray byte logged, not fatal.
2026-10-20 encmon: compensate the F3's frame lead (delay); soak records the monitor
    On the bench motor the F3's voltages and currents come in a frame ~0.32
    ms ahead of hv0.pos: the monitor's ratio reached 0.29 of a 0.3 trip at
    300 rad/s. encmon0.delay (template 0.32 ms) turns delta by w * delay: rms
    ratio 0.46 -> 0.06 in a bench capture. The simulated F3 has no lead: the
    sim's encmon tests and soak set delay = 0. soak.py records
    encmon_max_ratio/max_timer when the monitor is loaded. DEBUGNOTES: the
    runtime load needs relink (an input linked to an input reads stale).
2026-10-20 encmon: delay 0.12 ms, measured on the bench motor
    Speed above 250 rad/s: ratio 0.24 at 0, 0.10 (max 0.14) at 0.12 ms,
    err_d centred; 0.32 ms over-turned. max_ratio's 0.27-0.30 are single
    samples at the monitor's turn-on (bemf at min_bemf); max_timer stayed 0.
2026-10-20 host/portal: a simulated portal machine on three simulated linear-motor drives
    A 1 x 1 m gantry: two Baldor LMCF08F on Y (Y1, Y2), an LMCF08E on X,
    1 um absolute scales, each drive the real drive code (libstmbl_drive.so,
    as host/arm). The plant is a planar multibody model (numerical mass
    matrix):
    - the 600 kg frame on leveling feet: motor reactions move the machine
    and reach the floor;
    - the bridge racking on the guide blocks' yaw stiffness, with the load
    split between Y1 and Y2 following the carriage;
    - the tool head on springs whose Y stiffness is lowest at mid-span;
    - guide friction;
    - a shared DC bus: 230 V mains through a diode bridge, the drives' own
    capacitors, an optional brake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
2026-10-20 linuxcnc/pcomp: physics-based command conditioning as a LinuxCNC component
    pcomp (shared/pcomp/pcomp.c, moved from host/portal) as a realtime HAL
    component between motion and the drives:
    - the planner's X, Y in; conditioned commands and velocities out;
    - the drives' feedback back to motion as fb + (in now - out the period
    before), so the following error check sees the drives' own error;
    - the model and the switches as pins;
    - dio/s32 channels delayed as much as the motion (laser, spindle);
    - enable wired to the amplifiers' enable.
    Three integration traps (DEBUGNOTES), all fixed:
    - the follow-the-feedback loop wound up through the delay while the
    drives were off;
    - a backward-difference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
2026-10-20 host/portal: one Y motor with an idler rail, per-side guide friction, iron-core cogging
    - drive y2 none: Y2 becomes an idler rail with a passive scale;
    - guidey2: the idler side's own friction;
    - cogging y1|y2|x A PERIOD PHASE: a periodic force at the scale
    position.
    A test bed for one-sided gantries such as the shop's Baldor stages.
    portal_idler.test: the one-sided drive twists the bridge (1.15 mrad).
    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
2026-10-20 drive: unbiased velocity observer and exact command feedforward over smart-serial
    Two control fixes, both opt-in (existing configs behave as before).
    vel1.bc = 1 (shared/comps/vel.c):
    - The velocity observer reported 2 d a / w (1.8 ms x a) too little
    under acceleration: its torque model only acts above lp, and the
    output left out the proportional correction.
    - In the speed loop that lag is positive acceleration feedback. The real
    bandwidth was vel_bw / (1 - 2 d vel_bw / w), and the loop went
    unstable at vel_bw = w/2d = 556.
    - bc adds the correction (bc_lp optionally filters it).
    vel_int0.mode = 1 (shared/comps/vel_int.c, rev.c, sserial.txt):
    - Velocity and acceleration come from Li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
2026-10-21 Bench on LinuxCNC 2.9.10: SPI driver from the ini, hm2_spix at 35.7/31.25 MHz
    - hwtest/burnin/stmbl.ini [HOSTMOT2] DRIVER, DRIVER_PARAMS: stmbl.hal,
    tools/ssflash.sh, hwtest/suite (setsserial) and hwtest/phasing read
    them (hwtest/hm2_driver.py).
    - hm2_spix: writes to 41.7 MHz, reads fail at 41.7 (MISO shifted) and
    work at 35.7; set one step below: 35.7 MHz write, 31.25 MHz read.
    Steady state on the Pi 4: servo thread 67-72 us against 74-76 us with
    hm2_rpspi at 31.25 MHz, worst cases alike (~170-270 us).
    - hwtest/suite: Pi-side timing test (servo thread, hm2 read/write; tmax
    cleared, read after 10 s).
2026-10-21 dynwiz: console wizard that measures a gantry's dynamics through LinuxCNC; retrofit machines
    linuxcnc/dynwiz: a headless, servoterm-cli style wizard (pure Python, no
    numpy). Through a running LinuxCNC (MDI/AUTO programs, a HAL sampler read
    with halsampler) or directly on portal_sim it measures, step by step into a
    session file: moving masses and friction (impulse fit; conf0.j), the head's
    modes along the bridge (step ring-downs from the scales or the current,
    base modes set aside, beam fit; pcomp's model), the servo lag on a circle,
    cogging, loops at their stability limit; verifies pcomp; writes [PCOMP]
    and suggested drive configs. Tests: the math on synthetic signals, the
    whole wizard on fi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
2026-10-21 gantry: drive-side yaw/common-mode split over a drive-to-drive link (simulated)
    shared/comps/gantry.c: the two Y drives of a gantry exchange position
    error and velocity; each feeds its pid the common mode as it is and the
    bridge's yaw with r_vel (and r_pos) times the gain. In the yaw each motor
    moves only 2 J / L^2 of the bridge, so its loop was 4-5x as fast as tuned
    and fought the other side at 160-235 Hz; with r_vel ~ m_yaw / m_side the
    yaw is tuned for its own inertia. Without a link it passes through.
    host/portal: `glink DELAY [EVERY]` simulates the link between the Y
    drives. At the default gains the fights are gone on laser3015, cmm and
    pcbdrill (machine/retrofit/*_glink.portal; cmm 10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
2026-10-21 fb_switch: align's check starts at phase_cur/8 and grows; phasing suite captures
    Align's check after the alignment used a fixed phase_cur / 2 pulse. On
    the bench after a soak (a warm, low-friction axis) it threw the rotor
    0.3-0.7 mm; LinuxCNC, which sees the motor position without fb_switch's
    re-zero, kept that as following error, and some checks read the wrong
    way (fault 17). Not LinuxCNC 2.9.10, hm2_spix, the Mesa firmware or the
    drive firmware (A/B each). The check now starts at phase_cur / 8 and
    doubles before it lengthens, as the probe's. drive_phasing_align_gentle.
    hwtest/phasing: --index-jump (the angle step at the encoder index: the
    phasing error, -8..+11 deg for align on the bench)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
2026-10-21 Align phasing on the bench: the rotor drifts when align lets go (root cause)
    The LinuxCNC 2.9.10 align failures are not LinuxCNC, hm2_spix, the Mesa
    or the drive firmware: a capture shows the rotor running 0.425 mm with no
    current right after align drops its 1 A for the field turn to the check.
    DEBUGNOTES. phasing.py --capture-phasing now captures that hand-over.
2026-10-21 F3: current offsets follow drift while the bridge is off
    The F3 calibrated its phase current offsets once at HV power-up. On the
    bench it read ~0.09 A with the bridge off, so commanding 0 A drove a real
    0.09 A DC: the bare rotor rolled 15 deg whenever align phasing let go
    (the align failures after LinuxCNC 2.9.10, not LinuxCNC's doing). With
    the bridge off for 0.1 s, the offsets are trimmed towards the readings
    (tau 1 s; readings above 0.5 A ignored). shared/cur_offset.h,
    host/tests/test_cur_offset.c.
2026-10-21 docs/hmi/mill.html: concept operator console for a gantry milling machine
    A single-page interactive template: simulated OP1 with G-code, DRO,
    overrides, a 3D toolpath coloured by predicted path error, command
    conditioning, gantry link, power, drives, the dynwiz model, spindle
    spectrum and events; the panels mapped to their pins in the README.
    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
2026-10-21 docs/hmi/mill.html: full mill console with the machine modelled in 3D
    The concept grows into a multi-page console in the spirit of QtDragon:
    the gantry machine in three.js (frame, rails, bridge, carriage, ram,
    spindle, tool, fixture, limits) with its toolpath, deflection drawn
    exaggerated; DRO with zero / touch-off / home, MDI, jog, overrides,
    spindle and coolant, cycle with M1 and single block; FILE preflight,
    WIZARDS (facing, bolt circle, circular pocket), OFFSETS, TOOLS, PROBE,
    DYNAMICS, STATUS (events, HAL watch), SETTINGS. All simulated.
    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
2026-10-21 webui/mill: browser console for a headless gantry mill (concept)
    The operator console as a static web app: index.html (simulated machine,
    3D model of the gantry with three.js, DRO, MDI, jog, files, wizards,
    offsets, tools, probing, dynamics, status, settings) and three.js r128
    vendored with its MIT licence so it runs offline. README: the pages and
    the plan for the backend (millweb: LinuxCNC display program, WebSocket
    protocol, preview from the interpreter, safety, testing).
    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
2026-10-21 webui/mill: millweb, the backend for the browser console on a headless LinuxCNC
    server/: millweb, standard-library Python plus LinuxCNC's modules, as
    LinuxCNC's display program: HTTP(S) + WebSocket (own RFC 6455), status at
    30 Hz as diffs, HAL pins at 2 Hz, the error channel as events, commands in
    a worker thread (power, E-STOP, homing, jog with a 300 ms deadman, MDI,
    cycle, overrides, spindle, coolant, G10 offsets, tool table, M6, tool
    setter, Z probe and touch plate, program folder, pcomp), a control lease
    (one browser drives, any may E-STOP; token, remote-enable pin), and the
    toolpath from LinuxCNC's interpreter.
    The console: js/app.js (the UI and its simulated machine), js/live.js
    (the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
2026-10-21 webui/mill: backend and GUI test suites; fixes they found
    Suites:
    - test/harness.py: LinuxCNC on a copy of test/sim with millweb, INI
    overrides, `harness.py -- CMD`; run_live.py now uses it.
    - test/backend_suite.py: 48 named cases against real LinuxCNC, each from
    the same baseline, with profiles for TOKEN, ON_CONTROL_LOSS=hold,
    REMOTE_ENABLE_PIN and AIR_PIN.
    - test/gui/: a Playwright runner; sim_suite.js (32 cases: every page and
    control of the simulated console, layouts, the HTTP fallback);
    live_suite.js (15 cases through the page's controls on real LinuxCNC).
    - Unit tests: 7 more (token, remote key, hold on loss, urgent commands,
    error replies, power off, T0).
    - make test-gui-s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
2026-10-21 webui/mill: large programs through every layer; stress suite and fixes
    Stress suite (make test-stress, test/stress_suite.py): test/bigcode.py
    writes CAM-style programs (a 1 001 661-line 3D raster finish, 300 000
    lines of G2/G3 adaptive clearing, 20 000 G83 cycles, 25 lines of O-word
    loops making 2 million moves) beside LinuxCNC's 3D_Chips.ngc; each goes
    through the preview, transfer, listing, cache, a run, run from line
    900 000, and the page in Chromium (test/gui/stress_page.js).
    Fixes:
    - A preview past 400 000 segments stopped millweb and LinuxCNC with it:
    gcode.parse aborts with KeyboardInterrupt. The preview now runs in a
    child process (time limit, not a size limit), interprets the w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
2026-10-22 webui/mill: commit test/sim's G-code program (ignored by *.ngc)
    The root .gitignore ignores *.ngc, so test/sim/nc_files/bracket-op1.ngc
    never reached the branch and the suites that load it failed in a fresh
    clone. A local exception keeps test/sim's programs tracked.
    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
2026-10-22 webui/mill: a workpiece switch in the 3D view
    Show: machine, workpiece, path, limits, deflection. The workpiece switch
    hides the stock and its vise; the G54 origin stays, so the path can be
    seen where the stock would cover it. The simulated GUI suite checks it.
    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
2026-10-22 webui/mill: the 3D view on the probe page
    The probe page had empty space below the cycles. The one 3D view now
    moves there (the same scene: machine, stock, path, probe tool) in the
    PART camera, and back to MAIN when that page opens. The simulated GUI
    suite checks the move, the size and the camera.
    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
2026-10-22 webui/mill: file management on the File page: upload, folders, rename, delete
    The File page had no upload, and programs could only live at the top of
    the program folder. Now (connected to a machine):
    - Upload by button or by dropping files on the list, into the folder
    shown; asks before replacing; 6 MB limit said plainly.
    - Folders: a path above the list, open, New folder, Rename / move (a name
    or a path; programs keep their extension), Delete (asks; folders only
    when empty). The loaded program and its folder are protected.
    - Backend: program names are paths in the program folder, each part a
    plain name (no "..", nothing hidden, no links out, 8 deep); new ops
    program_rename, folder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
2026-10-22 webui/mill: a see-through workpiece
    The workpiece button cycles solid, see-through, hidden. See-through
    draws the stock and vise at 28 % opacity with their edges, so the
    toolpath inside the stock shows. The simulated GUI suite checks all three.
    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
2026-10-22 webui/mill: a 3D setup of fixtures and workpieces; 3D model upload
    The 3D view's vise and stock become objects of a setup, which millweb
    keeps for every browser (setup.json; setup_save, a setup message):
    - Click an object in the view to select it (a drag still orbits): it
    lights up, and a panel sets its role (fixture or workpiece), its frame
    (the work offset or the machine), position, rotation, scale and look
    (solid, see-through, hidden); Top at work zero, On the table, Turn 90,
    Tip 90, Remove. A frame change keeps the object where it is.
    - The fixtures and workpiece buttons cycle all of a role at once.
    - The work origin's arrows now sit at the work zero itself.
    - The File page uploa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
2026-10-22 webui/mill: suites on the target board and from another computer; loading screen
    From the target board's report:
    - The harness works with an installed LinuxCNC (linuxcnc on PATH) as well
    as a run-in-place tree; the stress suite finds 3D_Chips.ngc in the
    package's folders (or skips that case) and reads its million-line
    program a line at a time.
    - The preview unit test passes with or without LinuxCNC's gcode module
    (with it, the parsed program is checked; it needed its M2).
    - [MILLWEB] CPUS pins millweb and its preview processes to cores off the
    real-time one; PREVIEW_NICE lowers the preview's priority.
    - The heavy suites run from another computer: `make serve-test` on the
    board (h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
2026-10-22 webui/mill: Debug page with HAL browser, scope and saved views
    One Debug page replaces the HAL page, with two tabs and saved views above:
    - HAL: pins, signals and parameters with their links, a watch list at
    HAL_HZ with lights and trends, opt-in setp/sets (HAL_WRITE).
    - Scope: a halscope in the browser. millweb runs server/sampler.py, a
    process per scoping browser that reads up to 8 HAL values at
    10-2000 Hz with the hal module and streams float32 frames
    (scope_start / scope_stop, "scope" messages). The browser triggers
    (auto, normal, single, roll; edge, level, position), draws, auto-scales
    and shows a cursor readout. It keeps running on other pages.
    - Views: the watch list plus t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
2026-10-22 webui/mill: Drives tab on the Debug page, stmbl drive cards and consoles
    millweb owns each stmbl drive's console ([MILLWEB] DRIVE_LINK = name tty
    [hal-prefix]): the pty sserialterm makes of its smart-serial console, or
    its USB port (server/drives.py).
    - Cards: state, fault decoded (or the last one, with its time, from the
    drive's own "ERROR: Fault n" line), DC bus, temperatures, AC current,
    position error and saturation, asked one value at a time while the
    console is quiet (DRIVE_POLL_MS), plus the smart-serial process data
    from HAL. "drv" messages at 2 Hz.
    - Console: the drive's terminal in the browser, shared by every browser
    on the tab (drive_watch, drive_cmd, "dout" messages),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
2026-10-22 webui/mill: tablets: touch behaviour, layouts at iPad and Android sizes
    - No double-tap zoom (touch-action: manipulation; pinch zoom stays), no
    text selection or callout on controls (user-select none on the body,
    text kept in G-code, inputs, logs and the drive console), no long-press
    menu on the jog pad.
    - Larger touch targets under (pointer: coarse): every control >= 30 px.
    - Held sideways (961-1440 px): the header on one row with the E-STOP at
    its right end, a lower nav rail on short screens; the main page's
    Program and MDI panels at full height (they were squeezed under each
    other, Preflight under Send) and the page scrolls.
    - One column: the Debug tabs as tall as their conten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
2026-10-23 webui/mill: Configure page and millweb-supervisor (machine.json, restarts, bitstream)
    A machine in one file, machine.json, in a machine folder; millweb-supervisor
    runs LinuxCNC for it, again and again:
    - each start: machine.json checked and made into run/mill.ini and
    run/machine.hal (server/machineconf.py: boards none/hm2_eth/hm2_spix/
    hm2_rpspi/hm2_soc_ol; joints simulated or stmbl over smart-serial, CAN or
    the simulated drive, with their consoles; homing absolute/immediate/
    switch/index, gantries; E-STOP, probe, spindle, tool setter, millweb's
    settings), plus custom.hal; the FPGA bitstream loaded (Linux FPGA manager
    via sudo -n server/fpga_load.py, or a command; when changed or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
2026-10-23 webui/mill: the program's name as the program view's title; the machine's own 3D model
    - Program panel: the loaded program's name is its title (its folder, line
    count and tools beside it).
    - The machine in the 3D view from its own files (Configure page, 3D model
    tab): STL/OBJ parts uploaded into the machine folder's models/, each
    riding on the axes it moves with (fixed, Y, XY, XYZ, against X for a
    moving table …), placed with the machine at X0 Y0 Z0 and the tool tip at
    the origin, turned, scaled, coloured, see-through; the built-in gantry
    on or off. The 3D view sits beside the form and follows each change;
    Save keeps it in machine.json ("model") for every browser.
    mmodel_sa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
2026-10-23 webui/mill/bench: the console's mill with X on the real bench drive
    X is the stmbl drive on the 7C81 (as hwtest/burnin, hm2_spix), Y, Y2, Z
    simulated (as test/sim); millweb as the display. X travel -300..300 mm
    homed in place, 500 mm/s, 1000 mm/s^2; G54 X -60 so a program's X 0..120
    stays in range; the drive's current/power/fault on the Dynamics page.
    Started on the bench: link up, no fault, http on 8080.
2026-10-23 millweb: a jog workspace ([MILLWEB] WORKSPACE_X/Y/Z)
    Jogs stay inside the box (machine coordinates): an increment is
    shortened to its edge, a continuous jog is an increment to the edge
    (jog stop and the deadman still stop it), from outside only back
    towards it; programs and MDI keep the whole travel. The bench: X
    -100..100, Y 400..600, Z -195..0. test_jog_workspace. bench.var.bak
    out of git.
2026-10-23 webui/mill/bench: homing moves: X to the encoder index, simulated switches
    X (the real drive) creeps at 3 mm/s to the encoder's index through
    joint.0.index-enable <=> stbl.0.0.index_enable (the drive's idx_home):
    repeatable to ~2 counts on the bench. Z, then Y1/Y2 together, home onto
    sim_home_switch switches and move to their HOME. Before, every axis was
    just zeroed where it stood.
2026-10-23 webui/mill/bench: millweb off the real-time cores (CPUS = 0-1)
    The bench Pi isolates cores 2 and 3 for LinuxCNC's real-time thread.
2026-10-23 webui/mill/bench: the drive on the Drives tab (sserialterm, DRIVE_LINK)
2026-10-23 Bench SPI at 25 MHz both ways (a cold start read bit-shifted at 31.25)
2026-10-23 webui/mill/bench: SPI at 25 MHz both ways (as hwtest/burnin)
2026-10-23 millweb: run POSTGUI_HALFILE as AXIS does (the bench's phasing ferror)
    The bench's larger following error while the drive autophases is a
    POSTGUI_HALFILE; millweb never loaded it, so X tripped on its 1 mm limit
    when it phased at enable. millweb now runs [HAL] POSTGUI_HALFILE and
    POSTGUI_HALCMD after it starts. The bench loads its and2 instances in one
    loadrt (uspace loads a module once).
2026-10-23 idx_home: a new index request doesn't take the last one's quadrant
    Homing by index a second time reported the index at once: the first
    sample of the new request was compared with the quadrant the previous
    request ended in (just past the index), so standing in the other of
    quadrants 1/4 read as a crossing. waitabs was never cleared either.
2026-10-23 Configure page for the bench: machine.json with phasing ferror, sim home switches
    The bench ran from a hand-written INI, so the Configure page (which needs
    millweb-supervisor and a machine folder) couldn't load its config.
    machine.json gains what the bench needs: a joint's phasing_ferror /
    phasing_time (generated as run/postgui.hal, mux4 and timedelay only: uspace
    loads a module once), switch homing with a simulated switch on a
    simulated joint (switch: sim, sim_at), and WORKSPACE_X/Y/Z as console
    extras. bench/machine.json makes bench/mill.ini key for key
    (test_the_bench_is_bench).
2026-10-23 Firmware versions: one number in LV and HV, checked everywhere; config patches, undoable
    Drives faulted on firmware older than the rest expected, and nothing said
    which firmware a drive (or its HV board) ran.
    Firmware:
    - STMBL_FW_VERSION (shared/version_number.h, now 1) in both images'
    version_info_t (fw_magic, fw_version).
    - The HV board reports its own in its state rotation (f3_state_data_t
    .fw_version); the F4 compares it with the HV image it carries
    (hv0.fw_version, hv0.fw_image) and faults HV_VERSION_ERROR (19) on a
    mismatch, or on an HV board from before versioning (a rotation without
    the word): the drive won't enable until hv_update. hv0.fw_check = 0
    turns the check off.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
2026-10-23 hardware/brdstepper: KiCad 7 project generated from the hardware document
    Schematic (five sheets), project symbols (DRV8876RGT, TPS560430,
    AS5047P), a placed but unrouted 28 x 28 mm four-layer board, BOM, PDF
    and placement render, all made by hardware/brdstepper/gen from
    gen/parts.py (`make` in hardware/brdstepper).
    check.py checks KiCad's netlist of the schematic against parts.py and
    ERC's pin-type rules (kicad-cli 7 has no ERC); drc.py runs KiCad's DRC
    through pcbnew: no violations but the unrouted connections. Parts
    marked * are still to be checked against their datasheets.
    Claude-Session: https://claude.ai/code/session_015Arx3mBYT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
2026-10-25 Vibration sensor: processing, simulated sensor, measurement bus frames
    A CAN FD node (STM32G4 + IIS3DWB + TMP117) for the machine's base, X, Y
    and spindle, mainly for tuning, with crash alarms (docs/vibsensor.md).
    - shared/vibdsp.c: biquads, moments, FFT, band / tone / peak reading
    - shared/comps/vib.c: per-axis RMS, peak, crest, kurtosis, ISO velocity;
    FFT peak, spindle orders, tooth passing, chatter, bearing envelope;
    crash latch per sample; vibration and temperature levels. Every
    parameter a pin.
    - host/hw/vibsim.c: the IIS3DWB on a machine (unbalance, misalignment,
    tooth passing, chatter, ball screw, bearing defect, crash), autonrt
    and vibspec in the host
    - shared/vibproto.h: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
2026-10-25 docs/vibsensor.md: M8 4-pin connector, crash stop in software (vibmon -> HAL), sensor watchdog
    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
2026-10-25 Vibration sensor: node numbers found and given over the bus; M8, stop in software
    The sensors are potted: no jumpers. Each is known by its MCU's unique
    ID; the PC finds them by a bit-wise search (as CANopen LSS Fastscan),
    gives new ones free node numbers and names, and they keep them in
    flash. Known sensors get their numbers back, a missing one's number
    stays reserved, a stranger on a taken number is moved, and Replace
    hands a number to a new sensor. Tapping a sensor names it (vib0.taps).
    - shared/vibaddr.c: the sensor's side; tools/vibmon/vibaddr.py the PC's
    (SocketCAN), tested against each other on a simulated bus
    (tools/vibmon/test_vibaddr.py, in make -C host check)
    - docs/vibsensor.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
2026-10-25 vibsensor: G473 firmware target and the sensor's bus component
    - shared/comps/vnode.c: the sensor on its measurement bus: features,
    summaries and events out as vib reports, the machine state in (rpm to
    vib, stale after 0.5 s), the console over the bus, node numbering
    (vibaddr), the spectrum on request; platform API in shared/vnode_hw.h
    - host/vnode_host.c: a simulated bus (vnin / vnout), tests/vib/node.test
    runs the board's template through numbering, frames, state, console,
    spectrum and tap-to-identify
    - vibsensor/: STM32G473 target: FDCAN1 1/5 Mbit/s with interrupt rings,
    IIS3DWB on SPI1 (FIFO into vibbuf in rt), TMP117 on I2C2 (thermo),
    identity page in flash, console ring,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
2026-10-26 vibmon: the vibration sensors' PC side, tested against simulated sensors
    - tools/vibmon/vibmon.py: numbering at start, the machine state every
    20 ms, features / summaries / events / spectra / console decoded,
    trends, a latched crash with reset (also on the sensor), a 0.5 s
    watchdog, the vibmon HAL component (--hal), line-delimited JSON on a
    Unix socket for millweb
    - vibproto.py: the frames in Python; simbus.py: sensors as host
    simulator processes running vib, vnode and the board's template
    - test_vibmon.py (in make -C host check): numbering, tap-to-name, rpm
    into the sensors' order tracking, HAL pins, spectrum, a parameter over
    the console, crash and reset, a lost sensor, the s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
2026-10-26 millweb: the Measure page for the vibration sensors (through vibmon)
    - server/vibmon_link.py: millweb on vibmon's socket ([MILLWEB] VIBMON),
    reconnecting; status, events, spectra, console text to the browsers;
    crashes, lost sensors and level changes in the event log; vib_* ops
    (reading open, changes with control, console lines logged); the
    machine state (spindle speed, feed, tool, teeth from "3-flute" in its
    comment) sent to vibmon 5 times a second ([MILLWEB] VIBMON_STATE)
    - js/measure.js: a card per sensor (velocity by level, trend, RMS,
    peak, kurtosis, temperature, orders, tooth passing, chatter, bearing
    band), the spectrum with order / tooth-pass / chatter markers, alarms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
2026-10-26 brdstepper KiCad: the schematic on one large sheet
    The five sheets (power, mcu, bridges, encoder, interfaces) become framed,
    titled sections of one sheet, packed into columns on the smallest paper
    that holds them (A2, two columns); pins join by net labels instead of
    global labels. The netlist is unchanged (gen/check.py: 94 parts, 67
    nets), the board regenerated with its footprints linked to the new
    symbols, DRC clean but for the unrouted connections.
    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
2026-10-26 millweb: system updates from the console (Settings, System)
    The controller's update helper (ebaz-update on the EBAZ4205 A/B image) through
    server/sysupdate.py, in millweb and in millweb-supervisor (so it also works while
    LinuxCNC is down): this system's version and slot, the update server's releases with
    their notes, upgrade to the latest or to any older version (into the other slot),
    progress, restart, and how the last update ended (updated or rolled back). The
    header's UPDATE chip says a newer version is there (checked every hour).
    Tests: server/tests/test_sysupdate.py (a stand-in helper).
    Claude-Session: https://claude.ai/code/sess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
2026-10-26 millweb: the System card works (its API, replies), a live GUI test for it
    The card called Live.sys (the API is Live.L, and the global LIVE is still null at the
    hello), and the update ops' replies carried "t" from the broadcast snapshot, which
    replaced the reply's own: the buttons did nothing on the board's first releases.
    Tests: server/tests/test_sysupdate.py (replies), test/gui/live_suite.js "system
    updates" against test/fake-update-helper (MILLWEB_UPDATE_CMD), which is now shared
    with the unit test. DEBUGNOTES: this, and the live suite's full-run failures on the
    EBAZ4205 (open).
    Claude-Session: https://claude.ai/code/session_017HHBH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
2026-10-26 millweb: the System card says "went back" after a downgrade
    Claude-Session: https://claude.ai/code/session_017HHBHoTorfcqMN3r4R2X8q
2026-10-26 SEW CMP40M in the simulator: motor table, autotune test, soak, config
    - host/tests/motors.py: sew_cmp40m from its plate and SEW's catalog
    (phase r 9.96 ohm, l 22.75 mH, psi 0.1455, 3 pole pairs, j 1.8e-5 with
    the brake, 8.5 A peak)
    - soak (gen_soak_tests.py --only, new): 3 cycles pass, max pos error
    0.086 rad, 0.54 A, 195 rad/s
    - motor_sew_cmp40m.test: r, l, psi, pole count identified; j and
    friction off for this light rotor with slow l/r (@todo, DEBUGNOTES)
    - conf/sew_cmp40m.txt: a starting config (resolver, brake)
    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
2026-10-26 KiCad: shared generator hardware/kigen; vibration sensor board
    - hardware/kigen: the brdstepper generator made generic (schematic,
    netlist check, placement with square or round outlines, DRC, BOM,
    renders), driven by a board's gen/parts.py and gen/board.py.
    brdstepper regenerates the same (only its title comment changed).
    - hardware/vibsensor: STM32G473 + IIS3DWB + TMP117 + TCAN1044V, buck
    24 -> 5 V and LDO 3.3 V, filtered sensor rail, bus voltage sense, M8
    lead pads, TC2030 SWD; one-sheet schematic (50 parts, 33 nets, check
    OK), round 26 mm four-layer board placed (IIS3DWB at the centre on the
    base side), DRC clean but for unrouted connections, BOM, PDF, render
    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
2026-10-26 rlpsij: vary state 4 segments; state 5 integrator anti-windup
    The SEW CMP40M identified j 24 % high and friction at half. The l/r was
    not the cause: its drive segments all lasted between SEG_MIN and
    4 * SEG_MIN, so drive_cur never adapted and state 4 ran identical
    segments. The momentum fit then had two distinct equations for four
    unknowns (|v| always in max_vel / 2..max_vel: friction and damping
    0.994 correlated) and moved friction into damping. State 5 took that
    friction as feedforward and stuck at test_vel / 10.
    - state 4: every other pair of drive segments stops at max_vel / 2;
    only full-speed segments adapt the drive current
    - state 5: integrate the speed error only near the command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
2026-10-26 vibsensor: enclosure concept "Shard"; the board shaped to it
    - hardware/vibsensor/enclosure: parametric OpenSCAD model: milled
    aluminium base with a solid floor, two swept-back M4 lugs (or an M6
    stud under the accelerometer), the board on two bosses, potted cavity,
    faceted cover with a light-pipe slit and +X arrow on the ridge, M8
    socket in the tail tilted 15 deg; STLs, renders, README with open points
    - the board: 32 x 18 mm, chamfered to the same shape (nose = +X), M2
    holes at +-9 mm, MCU on top at the centre over the IIS3DWB; placed,
    DRC clean but for unrouted connections
    - kigen: polygon board outlines; silkscreen overlaps (warnings) allowed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
2026-10-26 vibsensor: two M8 sockets (IN / OUT) and a terminator plug
    The sensors daisy-chain on standard M8 4-pin cables: IN (male) and OUT
    (female), wired 1:1 on the board (J1, J3), so supply and CAN pass
    through. The on-board termination (JP1, R10) is gone; the last sensor's
    OUT takes an M8 male plug with the 120 ohm inside.
    Enclosure: both sockets on the tail's 45-degree faces, the M4 lugs on
    the X axis at the nose and tail, a terminated render. Docs updated.
    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
2026-10-27 sew_cmp40m: resolver cable colours to the feedback RJ45, measured
    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
2026-10-27 Drive name and motor type in the flash config, shown by servoterm-cli
    Two comment lines in the config ("#stmbl_name x-axis", "#stmbl_motor
    ..."), set with the `name` and `motor` commands, printed by `ident`,
    `about` and at boot. servoterm-cli says which drive it is on connecting
    and puts name and motor in its interactive prompt; --expect-name refuses
    the wrong drive, and --load refuses a config naming another drive unless
    --force-name.
    Also: interactive servoterm-cli now exits on SIGTERM / SIGINT.
    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
2026-10-27 host/mill: the Scripta CN 720 on simulated ball-screw drives; blended scales
    mill_sim: three simulated drives (SEW CMP40M) on a fixed-bridge mill model
    (mplant.c): ball screws with position-dependent stiffness between rotor and
    load, the table moving on a base on its feet, the bridge swaying on its
    columns, a gravity-loaded Z with a brake, the spindle tip's modes softening
    as Z extends, lead error / thermal growth, optional 10 um linear scales on
    the drives' enc_fb1. Packets reach the drives with a latency and are taken
    at the next rt cycle, so a 2 kHz servo thread arrives 2 and 3 cycles apart
    as on the real link.
    fb_switch0.joint_tc: with a joint feedback, the position loop on the
    motor's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
2026-10-27 Motor temperature sensor: mtemp converts the HV board's reading
    The HV board measured the motor's sensor (hv0.mot_temp, ohms) but nothing
    used it: fault0.mot_temp was the thermal model alone. mtemp0 turns the
    resistance into degC for conf0.mot_temp_type (0 none, 1 KTY84-130,
    2 PT1000, 3 PTC, 4 NTC with r25 / B, 5 NC thermal switch);
    fault0.mot_temp is the higher of sensor and model. A tripped PTC or
    switch and an open or shorted wire read as trip + 10 degC, so the drive
    stops (MOT_TEMP_ERROR); mtemp0.err says which. Type 0 (default) keeps
    the old behaviour. In pid, mpid and uf templates; brdstepper too.
    Simulator: hv0.sim_temp, sim_temp_sensor, sim_temp_wire, sim_temp_tnat
    give the sensor's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
2026-10-27 Wizard: the motor temperature sensor (type, wiring, cold check)
    - motor step: the sensor type (none, KTY84-130 as on SEW CMP "KTY",
    PT1000, PTC, NTC with R25 / B, thermal switch); warning and trip
    temperatures for the reading types (110 / 130 degC).
    - wiring step: the sensor to the HV board's motor temperature connector;
    that input is on the HV side.
    - base step: with the motor cold the reading must be 5..45 degC (a PTC or
    switch not tripped), not open or shorted; checked before the fault
    check, since a bad sensor also faults the drive (MOT_TEMP_ERROR).
    - config: conf0.mot_temp_type, the NTC's data, high_mot_temp /
    max_mot_temp. setup api 2.
    - Tests: unit tests 74 -> 88; run_wiza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
2026-10-27 LinuxCNC on the simulated CN 720: stmbl_mill and hwtest/mill-sim
    host/mill: millcore.c holds the drives, the plant and the machine file,
    shared by mill_sim (scripts, unchanged results) and lcnc/stmbl_mill.c, a
    LinuxCNC realtime module with each joint's smart-serial pins and the
    simulation's truth (tool-x/y/z, head, bridge, frame). The servo thread's
    period is the drives' packet rate; their vel_int0.cmd_freq follows it.
    hwtest/mill-sim: a LinuxCNC config for the CN 720 (trivkins XYZ, the table
    on Y; 30 m/min XY, 15 m/min Z, 0.5 g), a headless runner and mill_test.py:
    circles, a square and a line at 1 and 2 kHz on the resolvers, blended
    scales or scales, checked against bounds. 2 kHz cuts the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
2026-10-27 millweb: a fixed-bridge machine type (CN 720): machine.json type, its 3D model
    - machine.json "type": "gantry" (default) or "bridge": a fixed bridge over a
    table moving in Y, one joint an axis (checked); [MILLWEB] MACHINE_TYPE,
    millweb's hello carries it; the Configure page's Machine tab picks it.
    - The 3D view: buildBuiltin(type) draws the PORTAL-M gantry or the CN 720
    (fixed bridge and columns, X carriage, Z slide with its motor, an ISO20
    ATC spindle with its drawbar cylinder, the table with T-slots, an 8-place
    tool rack and the tool setter, moving in Y). The work (fixtures, toolpath,
    trail, travel box) is one group that moves with the table; the travel box
    from the axes; cam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
2026-10-27 mill_move: @todo until sserial0.pos_advance is corrected on master
    The CN 720 simulation merged with master reads 16.9 um following error
    against its 15 um bound; with pos_advance 0.0006 it passes, as the portal
    did (DEBUGNOTES, sserial pos_advance).
2026-10-27 hwtest/mill-sim: the browser console on the simulated CN 720 (console.ini)
    console.ini runs the CN 720 simulation with millweb as LinuxCNC's display
    (MACHINE_TYPE bridge, the CN 720's tool setter); console.hal answers the
    tool changer and spindle; programs from ~/cn720/nc_files, G54 at the
    table's centre. mill_test.py and make run also work with an installed
    LinuxCNC (LINUXCNC empty), as on the bench Pi.
    Checked on the bench Pi: through the console's WebSocket, E-STOP, power,
    homing and FACING_120x80.ngc run to the end without errors. make test:
    8/10; the two line_F3000 runs read 128 / 150 um following error against
    100, all 10 pass with sserial0.pos_advance 0.0006 (DEBUGNOTES).
    Co-Authore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
2026-10-27 call_cmd: bound the command line's fields (a stack overflow); sim_turn on master's position
    A console argument longer than 63 characters overran call_cmd's buffer:
    the vibration sensor's 67-character SET frame broke tests/vib/node.test on
    the 32-bit ARM bench Pi. The fields are bounded now.
    The setup wizard's hand turn (hv0.sim_turn) moved sim_pos directly, which
    master's mech_step rebuilds from the unwrapped position every motor step:
    the turn now moves that position (tests/sim_encoder_res.test).
2026-10-28 millweb: file sizes in MB from 1 MB up (fmtSize)
    The File page, 3D models, bitstreams and the Drives tab's byte counts
    showed everything in kB (a 3.3 MB program as 3226.2 kB). One formatter
    now: bytes, kB below 1 MB, MB with one decimal from 1 MB up.
2026-10-28 machine.json: simulated joints can start somewhere new at every start (sim_at random)
    A simulated switch's sim_at "random": at each start millweb-supervisor
    places the axis anywhere in its travel short of its switch (at
    HOME_OFFSET, in the search direction), one start an axis so a gantry's
    two sides start together; homing then searches from there, as on a real
    machine. The bench uses it for Y, Y2 and Z. Test:
    test_sim_switch_random_start.
2026-10-28 millweb: positions follow the joints until every joint is homed
    LinuxCNC updates the axes' positions only once all joints are homed, so
    the console showed the axes standing still while they homed and then a
    jump. Until then each axis shows its joint's position (a gantry's first).
    Test: test_positions_follow_the_joints_until_homed.
2026-10-28 Tool setter: the simulated probe in machine coordinates; the 3D view draws it where Measure goes
    The simulated probe compared the Z motor's count (from where it started)
    with its trip height instead of the machine position, so Measure on the
    bench went down to the end of travel without contact. It takes
    joint.N.pos-fb now. The console now learns where the setter is
    ([MILLWEB] TOOLSETTER) and both 3D models and the demo place it there,
    not at a fixed X 980.
2026-10-28 millweb: Configure tabs for spindle, tools & probe (rack ATC), HAL pin browser, screw lead/ratio; message cards, load progress, run stats, tool 3D models; see-through flicker and culled chips fixed
    - Configure: Spindle tab (type hal: on/forward/reverse/speed/at-speed pins),
    Tools & probe tab (probe, tool setter, rack tool changer). machine.json
    atc makes an M6 remap (run/toolchange.ngc, num_dio=4), checked in
    LinuxCNC 2.9. Joints get mech {lead, ratio, reverse}: scale comps between
    mm and a stmbl drive's motor radians; the form shows mm a motor turn and
    rpm at top speed.
    - HAL pin browser on every pin field: LinuxCNC's pins while it runs, the
    board's guessed names otherwise, filt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
2026-10-28 Simulated probe: touches the setup's stock and the tool setter, with each tool's true length
    The simulated probe tripped below one Z everywhere, so it couldn't tell
    the tool setter from the stock, and every tool measured alike. Now
    (machineconf.sim_probe_hal, in machine coordinates, during probe moves):
    the stock's top over the 3D setup's workpieces (millweb sets the box at
    2 Hz, as the view places them), the tool setter within 10 mm of its X Y at
    z_ref, and the tool tip from the tool's true length ([MILLWEB] SIM_TOOLS /
    machine.json probe.sim_tools, else its table length when first used) rather
    than the active offset, which Measure cancels. The bench and test/sim HAL
    use the same block. mac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
2026-10-28 millweb: system update restarts by itself when installed; releases hidden and buttons off meanwhile
    The System card's Restart now button is gone: when the install has finished,
    sysupdate.py restarts the controller into it (after a program that already ran
    has ended; no program can start while an update installs). Until then the
    release list is hidden and Check / Upgrade are off. Tests: test_sysupdate.py
    (restarts once, waits for the program), live_suite system updates.
    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
2026-10-28 hardware/teststand: a printed 3-axis test stand for the controller kit (only the servos and switches bought)
    A fixed bridge over a table moving in Y (millweb type bridge), X carriage,
    Z slide with a pen: it homes on three micro switches and draws demo.ngc.
    Printed dovetail slides with gibs, printed racks and pinions (m 1.5, 20 T:
    94.25 mm a motor turn), printed P8x2 bolts, P6x1.5 gib screws and snap pins
    for the NEMA 23 flanges. Parametric OpenSCAD; make builds every part as
    printed (all within 215 mm) and the pictures; check.py intersects the
    moving parts with the rest at the travel's corners (71 checks, none
    touching); the rack and pinion profiles were checked over a tooth pitch.
    webui/mil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
2026-10-28 hardware/teststand: sized for the Bambu Lab H2C (X ±55, Y ±65)
    The layout follows the travels (xt, yt): the table longer than the Y travel,
    the carriage longer than the X travel (its rack rides on it), the columns
    outside. For the H2C (300 x 320 with both nozzles) X ±55 and Y ±65 are the
    most: base 280 x 300, beam 280, every part within 295 x 315 x 310
    (bedfit.py). The collision check runs at the new corners (71 checks, none
    touching); machine.json, the demo drawing (1.4 m, LinuxCNC's interpreter
    reads it) and the README follow.
    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
2026-10-29 Erased config flash reads as an empty config (a new drive's first --load aborted)
    A new drive's config sector has never been written: all 0xFF, no
    terminating 0. showconf printed past the sector and flashloadconf copied
    it unterminated; servoterm-cli took the 0xFF bytes for scope frame markers
    and swallowed the first ack, so loading a config into a new drive aborted.
    conf_text() makes erased flash an empty config in the firmware and the
    simulator; showconf prints at most the config's size, flashloadconf
    terminates. Test: test_load_into_erased_flash. Also DEBUGNOTES: the btburn
    DFU loop seen on the same drive (open), the faulty board.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
2026-10-29 millweb: lathe support (machine type lathe, the Emco Compact 5), STEP assemblies as model parts
    - machine.json type "lathe": lathe {post front/back, diameter}; X and Z; the
    INI's [DISPLAY] LATHE / BACK_TOOL_LATHE, RS274NGC_STARTUP_CODE G18 G7;
    spindle encoder pins (revs, index, speed_in), a simulated encoder
    (sim_spindle) for a simulated spindle. Checked in LinuxCNC 2.9: G96, G95,
    a G2 profile and G76 threading on the Emco's generated config.
    - tool.tbl keeps a lathe's X, Q, I, J; the preview gets the startup code
    (X words as diameters) and times G95 at the rpm, G96 from the cutting
    speed at the diameter, G33/G76 at their pitch.
    - js/lathe.js: the console as a lathe's: Ø DRO fol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
2026-10-29 millweb: drop the interpreter's parameter files left by a test run; ignore them
    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
2026-10-29 DEBUGNOTES: hv_update and an old F3 bootloader (v0.9.18-184); the HV board's DFU recovery
2026-10-29 F4 watchdog, flash error log, alive LEDs
    A hang on the SEW bench left the drive on USB with a dead console, and the
    24 V cycle that recovered it wiped the crash record.
    - Independent watchdog (2 s), fed by the main loop only while rt runs; a
    hang resets the drive and the crash record says "Watchdog" with the
    rt/frt/nrt function and the console command (from a crumb in CCM).
    - `errlog`: boots (reset cause), crashes, hangs and drive faults in flash
    sector 3, kept through a power cycle; compacted at boot when nearly full;
    at most 32 fault entries a boot.
    - The state LED breathes while rt and the main loop run; the HV board's red
    LED blinks briefly every 2 s while it runs without faul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
2026-10-29 millweb-supervisor: the machine's own comps (comp/*.comp) compiled and installed before each LinuxCNC start
    comps.py: halcompile --compile in a temporary directory (nothing written into
    the machine folder), the result cached in run/comp-cache by source and
    LinuxCNC build, RT modules copied into LinuxCNC's modules directory, userspace
    ones into run/comp-bin (on LinuxCNC's PATH). A removed comp is uninstalled
    (and a LinuxCNC module it replaced put back). A compile error stops the start
    with the first error line, the full output in the log.
    Tests: server/tests/test_comps.py (test/fake-halcompile).
    Claude-Session: https://claude.ai/code/se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
2026-10-29 Lathe: index-homed reverse-locking turret on a stepper, stmbl spindle drive
    linuxcnc/lathe: a realtime module with lathe.turret (M6 turns a stepgen-driven
    turret forward to its station, then back onto its pawl; homed on a once-a-turn
    index, slip/timeout faults open the E-STOP chain) and lathe.spindle (an stmbl
    drive in velocity mode, its feedback summed into spindle.0.revs with the index
    for G33/G76). The logic is tested on the host (test_lathe) and in halrun.
    millweb: machine.json lathe.turret and spindle types stmbl_sserial/stmbl_can,
    the generator's nets (stock comps loaded once each), Configure fields, the
    turret's station and fault on the lathe's Tools page, an EBAZ4205 / all-stmbl
    Emc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
2026-10-29 Emco Compact 5: the spindle motor is 1:1, no index sensor needed
    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
2026-10-29 millweb: the machine folder as a .zip (Configure, Backup), and restore from one
    backup.py: the folder without run/, logs/, backups/ (programs optional) with a
    manifest; a restore uploads in 3 MB pieces, shows what it changes and the
    backup's machine.json problems first, and is applied by the supervisor while
    LinuxCNC is down, after a copy of the folder as it was into backups/ (last 5).
    Tests: server/tests/test_backup.py, live_suite "backup: ..."; checked in
    Chromium against the supervisor (7 MB in three pieces, folder restored).
    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
2026-10-29 USB console: fix the CDC IN state after a ZLP (output stalled for good)
    ST's CDC went idle right after arming a zero-length packet; the next SOF
    could start a transfer over it, a DataIn was lost and the console never
    sent again while it still took input. Seen twice on the SEW bench;
    reproduced by closing the port mid-output (stuck after 350 rounds), clean
    for 2000 with the fix.
    - Busy until the ZLP's DataIn.
    - Heal: busy with the IN endpoint no longer enabled for 20 frames resumes
    the transfer, counted in `about` ("usb tx stalls healed").
    - Reset cause: no flags means power-on (the stmbl bootloader clears them).
    Test: hwtest/suite "usb: 1000 port closes ..." (host: test_wdog).
    Co-Author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
2026-10-29 DEBUGNOTES: EBAZ4205 modules directory links looped (mount propagation)
    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
2026-10-29 DEBUGNOTES: SEW KTY wiring couples PWM into the resolver
2026-10-29 Wizard config write survives messages; USB console diagnostics and heals
    - su_conf_write: check deleteconf cleared the RAM config (a lost one
    doubled the flash config), find acks among the drive's messages, check
    the RAM size before flashsaveconf, drop messages from the read-back.
    Test: servoterm-cli make check, "conf write" on a fake drive.
    - CDC IN: never end a transfer on a full packet (no ZLP); heal a lost
    DataIn, and abort + resend a transfer stuck while the port is open (DTR).
    The stall under motion is still open (DEBUGNOTES).
    - `usbdiag` writes the USB state into `errlog` (new note entries).
    - TODO.md: LV motor temperature sensor, USB stall, resolver on FB1, SEW.
    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
2026-10-29 Setup wizard over the smart-serial console, without LinuxCNC
    - tools/sscon: the Mesa driver and sserialterm in a HAL session, a pty for
    servoterm-cli; fault limit raised to ride through a flash erase, and the
    port restarted when it stops.
    - Session key console.sserial = 1: every step's config keeps `load
    sserial` (console only); the final `link sserial` loads it itself.
    - wait_state says when the drive didn't answer (it failed silently).
    On the SEW bench the mechanical id (step 12), which lost USB's console
    under motion every time, ran through over smart-serial.
    Tests: servoterm-cli make check (build: console over smart-serial).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
2026-10-29 Wizard: automatic brake test; getf over the slow console; SEW CMP40M config
    - Brake step, horizontal axes: the drive pushes against the brake through
    the position loop, the torque limit rising, and finds the torque the
    shaft turns at released and slips at closed (both ways, up to 2.5x
    rated); it must hold the rated torque. Vertical axes keep the hand
    checks (brake.manual = 1 asks for them anywhere).
    - su_link_get reads until the pin's line is complete: on smart-serial the
    last answer's tail came first and every try failed.
    - Host simulator: confcrc (the config write checks it), and the brake
    follows the output's state (io0.out0_state), not a collapsed link.
    - conf/sew_cmp40m.txt: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
2026-10-29 soak: SOAK_MAX_VEL caps the machine speed, SOAK_CONSOLE=sserial checks over smart-serial
    For the SEW CMP40M on the 202 V bench (2000 rpm, 300 mm/s at 10 mm/turn)
    and its USB console, which stalls under motion.
2026-10-29 USB console: the drive re-enumerates when stuck, the wizard reconnects
    - CDC IN: after 3 aborts without the host taking anything, the main loop
    soft-disconnects for 100 ms and the host enumerates the drive again;
    progress counts DataIns from the core (a resend moves the pointer).
    `about` shows heals and re-enumerations.
    - su_link: a device that goes away is reopened (15 s); sends and reads go
    on. Test: servoterm-cli "reconnect: ..." (fails without).
    - tools/ssflash.sh: the drive by its by-id link (it came back as ttyACM1).
    SEW bench: wizard steps 12-18 over USB ran through (one run: 44 heals,
    14 re-enumerations under id_mot currents).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
2026-10-29 USB console: no re-enumeration on "no progress"; reset the CDC state per configuration
    The drive can't tell a host that stopped polling from flow control: the
    re-enumeration fired on a reader that paused (the host's tty full),
    looped (a bus reset kept the CDC state busy) and left the console one
    packet behind. Removed with its DTR rule; the abort/resend stays for a
    transfer the host polls (NAKs) but never gets. usbd_cdc_Init clears the IN
    state. Bench: an 8 s unread scope flood leaves the console at 4 ms per
    answer, no re-enumeration; the USB soak's config and long-line checks pass.
2026-10-29 Motor temperature sensor on a feedback port's pin 7 (LV side)
    The board has the input: pin 7's 10 k pull-up and 10k/1k ADC divider
    (io0.fb0 / fb1), used once the port's supply jumper (JP2 / JP5) is open.
    On the HV board the sensor's wires carried the inverter's switching into
    the SEW's resolver.
    - rpull: the sensor's ohms from the pin voltage (shared/rpull.h);
    templates mtemp_fb0 / mtemp_fb1 feed mtemp0.
    - Simulator: io0.sim_fb0_r / sim_fb1_r drive the input.
    - Wizard: temp.input (hv, fb1, fb0 with a resolver) in the wiring step,
    the jumper and pins shown, the template linked, the cold check reads
    rpull0.r and hints at a closed jumper.
    - docs/motor_temp_lv.md: the solder-pad mod, chec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
2026-10-30 Lathe material removal: the stock cut by each move, checked before the run; flutes and inserts in the tool table
    js/stock.js: the stock in 0.05 mm rings along Z; each move sweeps the tool's
    insert outline (LinuxCNC's orientation, nose radius, I/J as AXIS draws them,
    else the insert's shape) through it. Findings: G0 into the stock, tool or
    holder into the chuck, holder in the part, cuts deeper than the insert's edge,
    an outside tool past the axis, part off. Threads keep their major diameter
    with their depth noted. Node tests (make test).
    The lathe console: the stock (Ø, bore, out of the chuck, face Z, chuck Ø) on
    the Preflight card, saved with the setup; the 3D stock cut as the program run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
2026-10-30 rpull: the supply measured on the other port's pin 7 (ratiometric)
    FB1's jumpered pin 7 reads the +5 V through a divider like FB0's on the
    same ADC: supply and reference errors cancel (bench: 5.12 V, 649 vs 667
    ohm). Used while plausible (4.5..5.5 V), else 5.0. Test: mot_temp_fb.test
    (the +5 V at 5.12 V, ratiometric and not).
2026-10-30 motor_temp_lv: calibrating the pull-up at a known temperature (bench: 9064 ohm)
2026-10-30 Mill material removal: a height map cut by each move, checked before the run
    js/mstock.js: the setup's workpiece (the block, or a model's triangles) as a
    height map; each move lowers the cells under the tool to its lowest point
    (exact for flat end mills, ramps included; ball, bull nose, drill and vee
    profiles sampled). Fixtures as a height map of their own. Findings: G0 into
    the stock, cuts deeper than the flutes, the holder in the stock, cutter or
    holder into a fixture, a probe into the stock off a probing move, cutting
    after M5, through the stock's bottom. Node tests (make test).
    js/millrem.js: the cut stock in the 3D view as the program runs (simulation
    and LinuxCNC), coloured by tool, d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
2026-10-30 brdstepper: split into serial and CAN boards, 0603 passives (WIP, not routed)
    - hardware/brdstepper_common: shared parts/board definitions built per
    variant; brdstepper_mesa (A, smart-serial) and brdstepper_can (B, CAN)
    each fit only their own interface parts, MCU pins of the other
    interface left open, HWID divider per variant.
    - 0402 resistors and capacitors become 0603; power capacitors stay larger.
    - kigen place: GAP_MAX bisects the largest courtyard gap that still
    places every part (0603 on 28 x 28 mm only just fits: gap ~0).
    - kigen route: DSN export, BrdRoute, SES import, zone fill (untested end
    to end: first router run still going).
    Not done yet: routing on 4 layers, README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
2026-10-30 brdstepper: spread pass, BrdRoute step with own SES import (WIP)
    - kigen place: SPREAD pushes parts apart into the room left after the
    gap search (serial board: 67.3% -> 79.2% routed in a 150 s run).
    - kigen route: DSN export, boundary inset by the edge clearance,
    BrdRoute, own SES importer (pcbnew's ImportSpecctraSES needs the
    editor), zone fill.
    - Power net class 0.3 mm / 0.15 mm clearance / 0.6 mm vias for this board
    (the 0.5 / 0.2 / 0.8 mm default did not match what the router was given).
    Boards are a snapshot taken while a routing run was in progress: still
    not fully routed, DRC not clean.
    Claude-Session: https://claude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
2026-10-30 Mill material removal: the result against the finished part
    A setup object with the role 'finished part' (its model, placed like the
    stock): after a run its top is compared with the stock's cell by cell. Gouges
    (below the part by more than 0.05 mm) are crash risks with the line and tool
    that cut them; stock left is given as volume and thickness; the share within
    tolerance. Walls within a cell count as neither (the part's lowest/highest of a
    cell and its neighbours). The view colours the result against the part: red
    gouges, blue stock left, green within tolerance. Each cell keeps the line that
    cut it last.
    The cards count a finding kind once a tool. The GUI suite's messages case
    stops the si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
2026-10-30 brdstepper: USB and SWD as test pads, motor pads on the edge, plane fanout (WIP)
    - USB-C connector, its CC/shield parts and ESD chip replaced by four test
    pads (5V, D+, D-, GND) on both boards; SWD header by five test pads.
    - Motor pads J3 fixed on the north edge of both boards.
    - All fixed parts (the encoder on the shaft axis, holes, edge connectors)
    are locked in the generated board.
    - Placement is much looser without the two connectors: serial board
    courtyard gap 0.30 mm.
    - kigen route: loads a bare board (pcbnew 7 crashes when tracks are
    removed), GND plane fanout (a via + stub per SMD pad, vias in the MCU's
    exposed pad), In1 hidden from the router, router exit code ignored whe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
2026-10-30 brdstepper: drop J2, supply and enable on the signal connectors (WIP)
    - Serial board: J4 becomes 8-pin GH (adds VM, EN to TX+/-, RX+/-, 5 V, GND).
    - CAN board: J5/J6 become 5-pin GH (adds EN to CANH, CANL, VM, GND).
    - No separate supply connector: nothing with supply current beside the
    encoder any more. GH is 1 A per contact (flagged in the BOM notes).
    Schematics regenerated; the .kicad_pcb files in this commit are from
    before the change and are being re-placed.
    Claude-Session: https://claude.ai/code/session_017CSpK2B8oMBAmr39Kq1RSC
2026-10-30 brdstepper: re-placed boards without J2 (routing run in progress)
    Both boards re-placed with J2 gone, courtyard gap 0.40 mm. Snapshot taken
    while the first plane-aware routing run is still going: copper may be
    missing or partial.
    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
2026-10-30 brdstepper: routed snapshot with GND plane fanout, partial (WIP)
    First plane-aware BrdRoute runs (150 s cap): serial 70/129 connections,
    CAN 69/135, not complete, DRC not clean. Longer runs are in progress.
    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
2026-10-30 millweb server: arms (joints that aren't axes)
    An arm (genserkins, armkins, ... or [MILLWEB] MACHINE_TYPE = arm): hello's
    machine.arm (joints, axes, joint and axis limits, the teach file, gripper
    MDI); status every axis (work and machine) and every joint (position,
    homed, following error) and the jog mode; jog and home by joint (J<n>, joint
    mode, before homing too) or by axis X..C (world mode), switching LinuxCNC's
    mode and waiting for motion to take it; teach_record (Record point: a G1 line
    in the teach file); arm_model (the vis3d model, its includes and STL parts,
    armguard's cell, the tool table) for the browser; the arm's components' pins
    (armguard, armcollide, armgrip, armtool, the chang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
2026-10-30 brdstepper: routed with 0.127 mm rules, plane fanout; ~75% complete (WIP)
    Both boards routed with BrdRoute (900 s cap): serial 100/129 connections
    (77.5%), CAN 100/135 (74.1%). Not complete, DRC not clean (KiCad: serial
    11 clearance, 2 edge, 29 unconnected; CAN 14, 2, 35).
    kigen route fixes found on the way:
    - load_bare did not strip old copper (indentation): routes piled up
    - the temp-dir board lost the project's design rules and net classes
    (router saw 0.2 mm clearance): project copied in, rules written back
    - default board via (0.6 mm) offered next to the net class via: first only
    - net classes 0.127 mm clearance, 0.15 / 0.3 mm tracks, 0.5 / 0.25 mm vias
    BOM and renders regenerated.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
2026-10-31 The console on an arm: the 3D arm, joints, joint/world jog, guard, gripper, teach, the tool changer
    js/armmodel.js reads linuxcnc/vis3d's model files (the .vis, arm_sim's .arm,
    armguard's cell, the tool table) and computes the arm's frames (Craig DH as
    genserkins: LinuxCNC's own X Y Z A B C for its 8 reference poses), and an IK
    for the simulation. js/arm.js: the arm drawn and posed from LinuxCNC's joints,
    the tools on the flange or in their docks, the obstacles coloured by the guard;
    the DRO's A B C; a joints panel (limits, following error, homing) with the
    guard, the gripper, the power quota and Record point; a JOINT / WORLD jog pad;
    the Tools page's tool changer (Mount, Put back). The simu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
2026-10-31 TODO.md: open work for the arm page, lathe, mill removal and host
    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
2026-10-31 Arm console: A B C in the simulation (program, MDI), the TOOL jog frame (simulated; live as a G53 MDI move)
    The simulation's program and MDI moves carry A B C, interpolated as LinuxCNC's
    rotary axes, and the IK follows them; MDI in the simulation runs G0/G1 with
    X..C, T<n> M6 and the gripper's M64/M65. The jog pad's TOOL frame moves along
    and about the tool's own axes; live, the server works the target out from
    LinuxCNC's pose and sends one G53 G1 (held: to the axes' limits, aborted on
    release). The joints panel shows 'coordinated' for MDI/program motion. The
    Tools page draws its buttons again when the machine goes idle (a flaky test).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
2026-10-31 Arm: the Configure page's machine type arm, the enabling switch, Go home and the teach points
    machine.json type arm (machineconf.generate_arm): armkins on the arm's model
    (and the changer's tools), each joint's drive through armguard with
    armcollide's residuals, armgrip on the gripper's drive, armtool with M6, the
    power quota, the E-STOP chain through each; real drives in motor radians by
    each joint's gear; stmbl_arm joints for the simulated arm. The enabling switch
    drives LinuxCNC's jog-inhibit/jog-stop (optionally feed-inhibit); millweb shows
    it, refuses jogs and aborts its tool-frame move while it is released.
    machines/arcmate_sim is hwtest/arcmate-sim's HMI config as a machine.json; the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
2026-10-31 A rough simulation of the Mikron HSM 400U retrofit: five axes in host/mill, LinuxCNC with xyzac-trt-kins
    host/mill grows two rotary axes (a trunnion's tilt A and the rotary table C
    on it): motors through gears into a torsional stiffness, the load's inertia
    and friction, A's unbalance; the tool judged in the work's frame through
    LinuxCNC 2.9's xyzac-trt-kins (trt line). mill_sim: five-axis moves, wmove /
    rtcp (tool centre point, the joints by the inverse kinematics), ework,
    econtw. stmbl_mill: five joints, the table's angles and the tip in the work.
    machine/hsm400u*.mill: the machine's Siemens servos (EnDat) on stmbl's
    ~325 V bus, 16 mm screws, glass scales (scales, blend variants), a 380 V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
2026-11-01 HSM 400U: the spindle capped at 8000 rpm (owner's limit)
    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
2026-11-01 HSM 400U: the owner's 8000 mm/min limit is feed and rapids, not the spindle
    The spindle is the 42k HVC 140 at full speed (warm-up as the manual says).
    hsm.ini caps the tool tip at 133.333 mm/s; joints keep the machine's limits.
    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
2026-11-01 HSM 400U sim: block rate and contour accuracy at 8000 mm/min against the iTNC 530
    hsm_blocks.py cuts a circle of short lines and measures the feed reached,
    lines/s and the tip's error; blocks.md compares them with the iTNC 530's
    published block processing time (3.6 ms, 0.5 ms with option 2).
    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
2026-11-01 HSM 400U sim: B/C trunnion (xyzbc-trt-kins) with the manual's travels
    The manual says B (+/-110, about Y) and C, X 400 / Y 240 / Z 350 about the
    table centre. millcore gets a trtbc line mirroring LinuxCNC 2.9's
    xyzbc-trt-kins (the tilt axis keeps its slot, named b); mill_sim and
    stmbl_mill name it b. Machine files, hsm.ini/hal, tests, runs and docs
    move to the new layout: C axis at X 200 / Y 160, pallet face at world
    Z -350; the B pivot 80 mm below it is still a guess (MP950 and the B
    pivot from the iTNC replace it).
    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
2026-11-01 Servo rate study: time budget, simulated gain per rate, optimisations
    docs/servo-timing.md: where the servo period goes on the Pi 4 + 7C81
    (SPI ~80 %), the budget at 1/2/4/5 kHz, the simulated HSM's contour error
    per rate (hsm_runs.py --rates), and what cores and the FPGA can and can't
    do. Recommends 2 kHz now.
    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
2026-11-01 Servo rate: measure the three front ends (SPI, PCIe, Zynq) the same way
    hwtest/timing/servo_rate.py: a LinuxCNC-like HAL session (motmod, hm2 read
    and write) at several servo periods on any hostmot2 driver, drives
    connected but not enabled; servo thread and hm2 times (average, largest),
    smart-serial errors, a verdict against the period. docs/servo-timing.md
    compares the Pi 4 + 7C81, a Pi 5 / CM4 with a PCIe Mesa card and the
    EBAZ4205 Zynq and what each needs first.
    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
2026-11-01 Drive rt speed-up behind switches: sserial idle-interrupt replies, adc0 fast sums
    sserial0.reply_mode = 1: the USART1 idle-line interrupt (priority 1,
    between frt and rt) parses and answers each packet at its end instead of
    the frt busy-waiting up to ~22 us; the frt keeps the timeout and the clock
    lock (shared/sserial_sync.h). sserial0.irq_count counts its replies.
    adc0.fast = 1: sin/cos sums with uadd16 (bit-exact, <= 16 samples a
    group) and the voltage without divisions (within 2e-6 V); shared/adc_sum.h.
    Both default 0 (unchanged behaviour) until benched: docs/drive-rt-speedup.md.
    host/tests/test_adc_sum.c covers the sums, the conversion and the sync rule.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
2026-11-01 DEBUGNOTES: the full firmware on QEMU's STM32F405, tried
    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
2026-11-01 Zynq servo-rate measurement plan; servo_load.py (five-axis load with the real card)
    servo_load.py: LinuxCNC with xyzbc-trt-kins, five joints looped back, the
    hostmot2 card's read/write in the thread and the HSM programs (plus a dense
    0.05 mm circle at F8000, Q0) in a loop; servo thread and card times per
    period. docs/zynq-measurement-plan.md: OS latency, card alone, idle motion,
    five-axis load, console, drive side, wire, motion; pass rules and the
    results to send back.
    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
2026-11-01 CTX twin: the scanned manuals as text (docs/ctxtwin)
    Mechanical documentation (chapters 1-5), operating manual in German
    (translated, chapters 1-10) and the English edition (chapters 1-10), the
    Sauter disc turret manual (parts a, c); README with the machine facts for
    the retrofit: ELTROPILOT control, AG1/AG2, axes and motors, chucks and
    their valves/switches, turret indexing by servo, part transfer by angle-
    synchronous spindles (M803/M804/M800, %XTWI1U2).
    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
2026-11-01 millweb: import a CAM setup's scene (zip) into the 3D setup
    A scene dump (scene.json + the stock's and placed parts' STL files, all in
    the work's coordinates) becomes the setup: the stock as the workpiece, each
    part copy a see-through finished part, so the material removal cuts the
    real stock and compares with the parts. File page: CAM scene panel and
    Import scene… (or a .zip on Upload / dropped on the list); a dialog shows
    stock, material, work zero, parts and notes (outside the stock, overlaps,
    unplaced). On a machine millweb checks and stores it under scenes/<name>/
    (server/scene.py: names, sizes, zip bomb, real STL/OBJ; op scene_import);
    in the simulation it stays in the page.
    Tests: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
2026-11-01 Router machine type and the Excitech router (1200 x 1200, ISO30 24k, 6-fork rack)
    machines/excitech: a moving-gantry router (Y1/Y2), 1200 x 1200 work area
    (Y to 1320 for the rack), Z 215, a simulated ISO30 spindle to 24 000 min-1,
    a rack of six forks along the back (M6 through toolchange.ngc), simulated
    drives: it runs as it is.
    The console: type router, a 3D model sized from the travels (bed, vacuum
    table and spoilboard, gantry on racks, square electrospindle, the rack
    from atc with the spindle's fork empty). millweb sends the rack
    ([MILLWEB] ATC_RACK -> hello's rack). The simulation can be the router
    (index.html?machine=router, js/demo_machines.js = machines/excitech) and
    runs M6 through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
2026-11-01 millweb: Checked and Simulated ticks per program; the full simulation
    Each program in the File list shows two ticks:
    - Checked: its Preflight ran (travel, tools in the table, the program
    reads, the material removal's quick check).
    - Simulated: the new full simulation ran.
    Each tick is green when clean, amber with warnings and red with a crash
    risk or gouge. It turns grey and dashed when the setup (stock, parts,
    fixtures, offsets, tools) has changed since, and it is cleared when the
    file changes.
    "Run the full simulation" on the Material removal card takes every move
    from the machine (program_get full: nothing merged, PREVIEW_FULL_SEGS)
    and checks it on 0.25 mm cells against the setup's s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
2026-11-02 millweb: on a merged path the quick check's crash risks are only possible
    A long program's path, as drawn, merges moves into straight lines, and a
    merged arc's chord cuts across the part. On such a path the quick check
    now reports its crash risks as "possibly: ..." (warn, "N TO VERIFY"),
    and the card points to the full simulation for the verdict. The relieved
    CAM export gave 4 false gouges this way (stride 4); with every move it
    is clean.
    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
2026-11-02 CTX twin: the electrical documentation as text (docs/ctxtwin/electrical)
    Chapters 3-9 of the scanned electrical folder, transcribed page by page:
    the cooling unit and safety modules (HM4, DINA speed monitor, SRBF); the
    Indramat KDV 4 supply; the KDA/RAC main spindle drives, with this
    machine's spindle parameter sheet (KDA 3.2-150-3, 1MB241H); the DDS 2.1
    servo drives with the ANALOG interface (DAE 1.1 encoder emulation); the
    ELTROPILOT EP90 hardware (VAP4 axis cards: +-10 V and encoders); and the
    equipment list.
    The README sums up the drive interface for a LinuxCNC retrofit that keeps
    the original drives: pinouts, enable/ready order, the E-stop chain, the
    line counts and the tuning.
    Co-Aut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
2026-11-02 stman: design doc and schematic (stmbl LV with an analog output)
    docs/stman.md describes stman: a stmbl without the power stage that
    drives an analog servo or spindle drive (first target: the CTX twin's
    Indramat DDS 2.1 and KDA 3.2) from beside the drive.
    - Isolated smart-serial is its only link to the control.
    - AD5761R ±10 V outputs, stmbl's FB0/FB1, AD7606 monitor inputs, 24 V
    I/O and a watchdog.
    - It runs on the drive's 0VI, so no ground loop can form.
    hardware/stman is the KiCad 7 schematic.
    - stmbl v4.0's LV sheets are converted with their drawing kept
    (hardware/kigen/legacy.py, since kicad-cli can't read KiCad 5 sheets)
    and edited in place (hardware/kigen/schedit.py):
    - the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
2026-11-02 stman: reverse-polarity diode on the 24 V input, polyfuses on FB0/FB1
    D200 (SS34A) goes in series from P3 (+UI) to the +24V rail, in place of
    stmbl's wire up from P3. F200 (FB0) and F201 (FB1), 0.5 A hold, go
    between each port's supply and the connector's pin 7, in place of the
    wire there.
    schedit gains remove_wire() and per-instance references for a sheet used
    twice. check.py checks the new series nets; it reports 229 nets and 335
    parts, OK.
    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
2026-11-02 Bench the drive rt speed-ups on the SEW drive: rt max 172.8 -> 140.8 us
    adc0.fast: adc0 50.0 -> 32.8 us at rest, readings unchanged. reply_mode:
    frt max 33.8 -> 4.8 us, irq_count at the servo rate, no CRC errors. Three
    15 min smart-serial soaks (off / fast / both), each PASS.
2026-11-02 sserial reply_mode 1: new bytes keep the link alive (discovery failed 2 of 3)
    In mode 1 the frt doesn't parse, so the 5 ms link timeout, reset only by a
    parsed packet, expired between discovery's sparse packets and the frt
    dropped a packet before the idle interrupt answered it: hostmot2 timed out
    reading the config (8 of 24 found). New bytes reset it now: 24 of 24.
    Tests: host test_adc_sum (sserial_link_alive), hwtest/timing/
    sserial_discovery.sh on the bench.
    Also: servo_rate.py waits for the board's functions (they come seconds
    after motmod's thread); run_soak.sh SOAK_SERVO_US sets the servo period.
2026-11-02 stman: board placement (stmbl v4.0 LV kept), safety and enable wiring
    gen/pcb.py makes stman.kicad_pcb, placed but not routed.
    - stmbl v4.0's outline (the v4 case fits), without the HV/LV slots.
    - Every kept stmbl part is its own footprint, where stmbl placed it.
    - New parts go in the freed lower half:
    - AO/AI terminals on the lower-left edge, with the DACs, filter and
    AD7606;
    - OUT/IN terminals on the bottom edge, with the ITS724G, watchdog and
    NMA1215.
    - U200 sits in U10's place across a copper-free isolation barrier for
    the smart-serial cable side.
    - 4 layers, GND plane on In1. No courtyard overlaps involve new parts.
    docs/stman.md gains "The board" and "Safety and enables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
2026-11-02 stman: replace the EOL ACT4088 bucks with LMR51420YDDCR
    Same SOT-23-6 and stmbl's drawing; pins renumbered in the copied symbol,
    feedback dividers for VFB 0.6 V, 100k EN pull-ups R212/R213. check.py
    verifies the new regulator nets; board and docs regenerated.
    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
2026-11-02 stman: bucks checked against the LMR51420 datasheet
    LMR51420YF (forced PWM, fixed 1.1 MHz: no light-load PFM bursts near the
    analog band); stmbl's catch diodes not fitted (synchronous part); input
    caps 4.7 uF 50 V; +12V output caps 25 V; R214 pull-down so U28's EN
    doesn't float while the MCU resets. Power tree table in docs/stman.md
    records each datasheet point against the circuit. kigen: ground symbols
    get their name below them.
    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
2026-11-02 DEBUGNOTES: pos_advance sweep at 2 kHz; 2 kHz no gain and DoIt overruns on the Pi 4 + SPI
2026-11-02 sscon: feed the watchdog while _write waits for the smart-serial console
    A scopedump over the smart-serial console (~1 kB/s) kept the main loop in
    _write's wait for more than 2 s and the watchdog reset the drive mid-dump
    (hwtest suite, capture scope over smart-serial). The wait loop moves to
    sscon_out (shared, host-tested) and calls wdog_poll while it waits; once a
    chunk times out the rest is dropped at once.
    run_hwtest.sh: HWTEST_MAX_VEL caps the machine's top speed and the speed
    the motion tests expect (the SEW CMP40M at 202 V: 300 mm/s).
2026-11-03 docs/fanuc: the FANUC motors, encoders and amplifiers on hand
    βiS 12/2000 x2, βiS 4/4000 x2, α2/3000: nameplates (photos, metadata
    stripped), derived pole pairs / torque constants, starting values for
    stmbl. Encoders: the αA64 frame encf decodes, FB0 wiring, a bench test,
    and the plan for the βiA128 (record the FANUC CNC + βiSV 20 exchange).
    DEBUGNOTES: the βiA128 as an open point.
    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
2026-11-03 docs/fanuc: what is known of the encoder cable on hand
    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
2026-11-03 DEBUGNOTES: what is known of FANUC's 2-wire encoder mode
    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
2026-11-04 DEBUGNOTES: the βiS encoders are wired 1-pair only
    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
2026-11-04 fanuci: probe for FANUC 1-pair (αi/βi) serial pulsecoders on FB0
    Experimental comp for finding the undocumented half-duplex protocol of
    FANUC's i-series pulsecoders (βiA128): configurable bit rate, request
    pattern, polarity and timing; RS-485 turnaround on FB0's Z pair like
    yaskawa (TIM8+DMA bit output, TIM4 CH3 edge capture); raw bit dumps on
    the console; field offsets for position/turns/commutation as pins.
    Runs from rt (5 kHz) or frt (20 kHz / frt_div).
    shared/fanuc1p.c holds the hardware-free part (request levels, edge
    decoding, fields, dump text) with a host unit test (make -C host check).
    docs/fanuci.md: wiring, build/flash, pins, bench procedure, and how to
    turn the probe into a f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
2026-11-04 fanuci: exact poll rate from TIM7 (8 kHz), long first lead, old-style pre pulses
    The first bench sweep (5/6.7/10 kHz from rt/frt) got no reply although
    the requests are on the line. universal-IRC-1 polls at exactly 8 kHz,
    holds the driver 30 us before the first request after a mode change,
    and once sent 75 4-wire REQ pulses before switching to single-pair.
    poll_hz, first_lead_us, pre_pulses/pre_us/pre_idle and restart cover
    those. The request and turnaround run with interrupts off.
    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
2026-11-04 fanuci: first reply from the βiA128 (DEBUGNOTES, docs status)
    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
2026-11-04 fanuci: the βiA128 frame layout (24-bit position, turns, commutation, CRC-5 0x0B)
    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
2026-11-04 FANUC βiA128: frame decoded on the bench (DEBUGNOTES, TODO, docs/fanuci.md)
2026-11-04 docs: psu.md, the pack power supply design state (decided vs open)
    Collects the supply-card discussion: power path, K1/K2 force-guided in
    L/N, PTC inrush with a force-guided bypass, immediate cut, hardware
    chopper, bleed relay, the two-channel relay chain and pwmdc, and the
    G4 controller with smart-serial on the 24 V side. Lists the open points.
    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
2026-11-05 fanuc_tw: driver for FANUC 2-wire serial pulsecoders (βiA128)
    A new comp for the frame found with the fanuci probe: 24-bit position,
    16-bit turns, CRC-5 0x0B, state 3 once referenced (frame bit 68 clear), 1
    before, error after max_err bad polls in a row. Polls from TIM6 at 8 kHz.
    Debug pins for the unknown bits: the raw words, the bits that changed, a
    status trace, a field by frame bit (for the motor temperature), alternate
    request codes. Frame decoding in shared/fanuc1p.c (f1p_frame), the state
    in shared/fanuc_tw.c, tested on recorded frames (host/tests/test_fanuc_tw.c).
    Template fanuc_tw_fb0, docs/fanuc_tw.md.
2026-11-05 setup wizard: FANUC 2-wire pulsecoder (fanuc_tw) as a motor feedback type
    feedback.type = fanuc_tw: template fanuc_tw_fb0, hand check on
    fanuc_tw0.pos, resolution fixed by the protocol; the wiring step's table
    gets a FANUC-2wire column (RD/*RD on the Z pair, +5 V / 0 V with the
    motor connector's pins).
2026-11-05 fanuc_tw: decode in rt, not in the poll interrupt (RT_TOO_LONG with a motor config)
    The TIM6 poll interrupt (8 kHz, above rt) decoded every frame, ~45 us each:
    with pid/pmsm loaded rt went over 200 us and stopped. Now the interrupt
    sends and copies the edge times only (10 us); rt decodes the newest
    capture with a packed decoder (32-bit words, integer bit timing, table
    CRC-5), tested equal to the byte decoder on recorded and random frames.
    Bench: rt 157 us average, 170 max. Pins isr_us / isr_max_us.
    DEBUGNOTES: an HV board on v207 talks to master; only the version check
    (fault 19) stops it.
2026-11-05 DEBUGNOTES: hv_update from a v207 HV board failed again (desk drive), F3 left in its bootloader
2026-11-05 conf: FANUC betaiS 4/4000 with the betaiA128 on fanuc_tw, from the setup wizard
    Commissioned on the desk drive 205735A45631 (201 V bench bus): 4 pole
    pairs, r 1.78 ohm, l 2.1 mH, torque constant 0.70 Nm/A, j 5.5e-4 kg m^2,
    pos_bw 24, vel_bw 500; the wizard's final check held and stepped clean.
    DEBUGNOTES: the wizard's idm0.inertia set wasn't confirmed (open).
2026-11-05 fanuc_tw: 10 min motion soak on the desk drive, PASS; DEBUGNOTES: the HV board's scope stream on the LV console
2026-11-05 fanuc_tw: poll from rt once the encoder answers; cheaper decoding (RT_TOO_LONG with id_mot)
    The wizard's mechanical step (idm, +25 us) stopped rt at 198 us on the
    second betaiS. Edges become bits as toggle marks and a prefix XOR (2250 ->
    1400 cycles), the outputs drop mod(), the decoder files build at -O3, and
    the 8 kHz poll interrupt (10 us, 1.6 times per rt period) is only used to
    wake a cold encoder: after 2000 good frames the driver polls once per rt
    cycle from rt, back to 8 kHz after 40 bad polls. rt 140 us average.
    The DMA-complete turnaround (no busy wait) was tried: 20 % sync errors.
2026-11-05 conf: the second FANUC betaiS 4/4000 (setup wizard); its own commutation offset
    Electrically the same as the first (r 1.76 ohm, l 2.13 mH, psi 0.0837,
    j 5.5e-4), but conf0.mot_fb_offset -1.58 rad against +1.56: it belongs to
    each encoder's mounting.
2026-11-06 Absolute encoders: mturn loads the encoder's turn count into linrev
    linrev counted motor turns from 0 at every boot, so LinuxCNC only got a
    position right within one turn. mturn (shared/comps/mturn.c) takes an
    absolute encoder's single-turn angle, turn count and status: on the first
    good frame (once pos agrees with the encoder: pos can be a cycle old after
    boot, which made the load a turn off) it loads linrev's turn count
    (rev_in / rev_load), then checks every cycle, modulo the encoder's counter
    width, that the two agree. States: waiting, absolute, turn count lost
    (latched; cleared by a rising clear after re-referencing), mismatch. The
    drive's loop works on the single-turn angle, so the load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
2026-11-06 Wizard: FANUC serial absolute encoder (multi-turn); docs/absolute_encoders.md
    - feedback type "fanuc" (encf, alpha aA64 type): fixed resolution, the
    direction from a quarter turn, its wiring column (15-pin motor connector)
    - su_fb_type_t.mt_link: the encoder's multi-turn template; with the
    smart-serial link the final config links mturn and it
    - step "absolute" (after verify): the drive took the encoder's turn count
    (mturn0.state 1), or why not; battery warning; LinuxCNC's settings
    - run_wizard_sim.py: a FANUC-encoder motor through the whole wizard
    (counting reversed): 12/12, incl. commutation from the absolute angle
    - docs/absolute_encoders.md: how mturn works, states, config, LinuxC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
2026-11-06 fanuc_tw: the battery alarm (frame bit 6) as bat_fail
    Found on the bench: pulling the battery from a running betaiA128 sets frame
    bit 6 (w0 bit 5) and nothing else; it clears when the battery is back.
    A warning pin, no fault. Host test on frames built from the traced words.
2026-11-06 fault: no enable while the absolute feedback lost its position or has a battery alarm
    fault0.mot_fb_nref (MOT_FB_NREF_ERROR, 20) and fault0.mot_fb_bat
    (MOT_FB_BAT_ERROR, 21), checked disabled too, so the drive stays in fault
    and won't enable; the battery alarm while enabled stops it (err_stop).
    Template fanuc_tw_fb0 links fanuc_tw0.nref / bat_fail. LinuxCNC gets the
    fault bit in the process data and the code over the smart-serial console;
    webui/mill names the two codes. Test: host/tests/mot_fb_nref_bat.test.
2026-11-06 conf: fit every line into the drive's 52 characters; a host check for it
    The FANUC and SEW configs had comment lines up to 75 characters, which
    servoterm-cli --load (and the drive) refuse. Rewrapped; test_stmblconf
    checks every conf/*.txt.
2026-11-06 encmon after commissioning; the machine folder's drive configs must match the drives
    Setup wizard: every final config links encmon; the verify step reports
    encmon0.max_ratio and explains a fault 18. Bench on the FANUC betaiS
    (fanuc_tw): the commissioned offset stays quiet (0.15 of 0.30), 30..180 deg
    electrical trips at the first enable. The two betaiS offsets are pi
    mechanical apart, the same electrical angle; both configs link encmon.
    webui/mill: drives/<name>.conf in the machine folder is what each drive
    must run. The console reads each drive's flash config when its link comes
    up (and after a write or a restart) and compares it, comments and spacing
    aside; a difference, no file or no chec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
2026-11-06 Repo split: GUI, hardware and application parts moved to brdmaker/brdmot
    The web GUI (webui/), the hardware designs (hardware/), the application
    LinuxCNC parts (arm*, vis3d, lathe, dynwiz, powerquota, pcomp), their
    simulated machine configs (hwtest/arcmate-sim, portal-sim), their docs and
    the lathe/quota unit tests moved with their history to the private
    repository brdmaker/brdmot, which uses stmbl as a submodule. What stays is
    the GPL drive project: firmware, components, host simulator, servoterm-cli
    and the setup wizard, and the LinuxCNC drive link.
    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
2026-11-06 hsm400u frame.inc: the manual's new place in brdmot
    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
2026-11-06 linuxcnc/: the drive's LinuxCNC side only, with an index
    The example configuration moves from docs/linuxcnc to linuxcnc/config,
    next to sserialterm and stmblcan; linuxcnc/README.md lists them and the
    simulated-drive modules in host/. Removes build outputs of the moved
    modules (linuxcnc/arm*, lathe, powerquota) and generated hardware files
    (teststand STLs, KiCad .kicad_prl) that the split commit picked up once
    their folders' .gitignore files were gone; module outputs are ignored
    repo-wide now.
    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
2026-11-09 fanuc_tw: ref_move (run unreferenced to move through the reference); encmon delay +0.2 ms for fanuc_tw
    ref_move = 1 holds fault 20 off while the encoder isn't referenced: the
    drive enables incrementally (phased) to move through the reference; the
    template links nref_fault (nref and no ref_move). Host test in
    test_fanuc_tw. encmon0.delay 0.00032 for fanuc_tw (its position is a
    cycle older than a resolver's): the fast moves' worst residual 0.22 ->
    0.17 (bench sweep), in the betaiS configs and the wizard. encmon's
    remaining peaks come at low speed near min_bemf (DEBUGNOTES, open).
    DEBUGNOTES: hv_update on v207 (no code difference; an erase race?), the
    scope stream is the LV term's by design, th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
2026-11-09 encmon: min_bemf scaled to the motor (wizard: 15 % of the top speed's back-EMF, 5 V at least; betaiS 10 V)
    Near the 5 V default a fixed couple of volts of voltage error (dead time,
    offsets) made the betaiS's small moves reach 0.37 of the 0.30 trip; at
    10 V 0.22, and a 30 deg el. offset error still trips (bench). Wizard
    simulator: every motor but the known syn_torque_14p passes.
2026-11-10 yaskawa: seq pin records 32 consecutive good frames for the bench (working out a frame layout)
2026-11-10 yaskawa_abs: driver for Yaskawa Sigma-II serial absolute encoders (SGMAH-xxA1)
    Position 20 bits a turn and signed 16-bit turns from the reply, worked out
    on the bench (SGMAH-08A1A61D). The request goes out by DMA while rt decodes
    the previous reply in one pass (Manchester, HDLC, table CRC-16); the DMA
    interrupt turns the line around into the other of two capture buffers.
    Bench with pid and pmsm: 46 us of rt (52 max), 0 CRC errors, 8 frame errors
    in 100 000 polls (the old yaskawa comp: 54 us, 1.7 % CRC errors).
    - sync on the first long interval: the capture starts near the flag
    (the first decoder waited for 8 long intervals and found no frame)
    - bounded worst case: flag within 48 bits, no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
2026-11-10 yaskawa_abs: read a late edge (a short half-bit after a long one) instead of failing the frame
    With the SGMAH wired, 3-5 % of frames failed at some shaft positions: a
    short half-bit right after a long level arrived ~120 ns late, on top of the
    next edge. Every bad frame held the last position, and the jump made the
    bad sound in id_mot. A long then a near-zero interval now reads as two
    shorts; the CRC still checks. Bench: 1 error in 52 000 at that position.
    Test: the two failing bench captures in test_yaskawa_abs.
2026-11-10 yaskawa_abs: decoder rewritten for registers (7400 -> 4400 cycles a frame)
    With id_mot loaded rt stopped (RT_TOO_LONG, 198 us): the decode cost ~45 us.
    Measured on target: not flash waits (from RAM it was slower) but the bit
    loop's counters and limits on the stack. Now the 21-tick timing is a
    constant (inlined), two sentinel edges end the steps instead of bounds
    checks, intervals are plain differences (the timer starts at 0 for every
    capture), bytes go through a pointer, and the fields come out by rbit.
    yaskawa_abs 37.6 us of rt (was 56); rt 149 / 151 us at most on the setup
    wizard's config (was 167 / 170).
    yab_decode now writes two sentinels after the edges: t needs n + 2 values.
    Co-Autho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
2026-11-10 id_mot: fb_switch aligns the feedback to idm's command at enable (was LinuxCNC's)
    The position loop follows idm0.pos_cmd in id_mot, but fb_switch aligned the
    feedback at enable to cmd_pos = reslimit0.pos_out (0 on the bench). With
    absolute feedback the shaft rests anywhere: a step of up to pi rad at
    enable, the peak current at it. On the bench (Yaskawa SGMAH, 18.9 A peak,
    a 200 V lab supply at 1 A) the bus collapsed, fault 11, twice. Test:
    drive_id_mot_start (max pos_error 1.57 rad before, 0.036 after).
